OxiKit/oxygen-concentrator-how-to-diy-open-source/README.md

# oxygen-concentrator-how-to-diy-open-source
