OxiKit/oxygen-concentrator-how-to-diy-open-source/Air Compressor WorkFlow.pdf

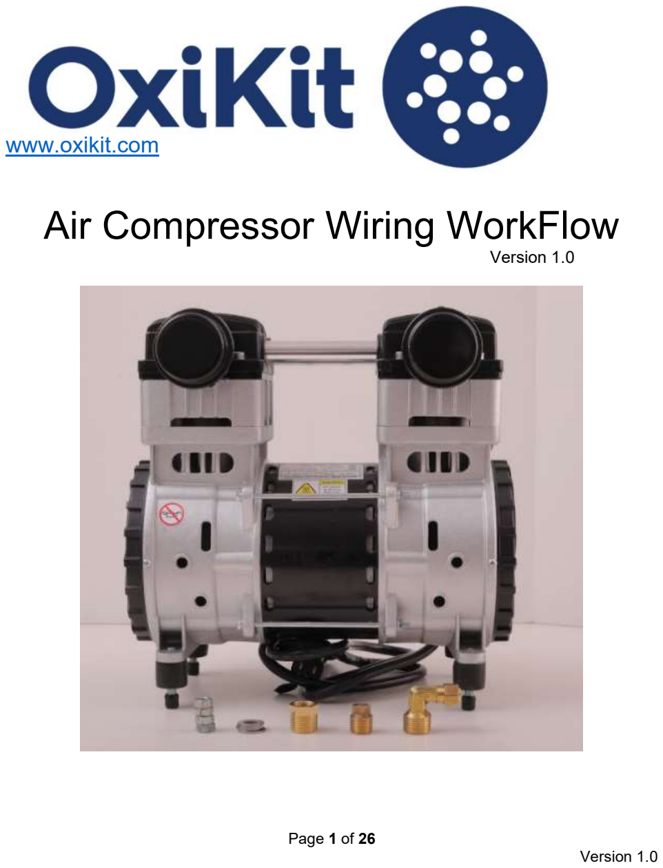
[picture p4: page 1]

### Page 1 of 26 Version 1.0

# www.oxikit.com

# Air Compressor Wiring WorkFlow

### Version 1.0

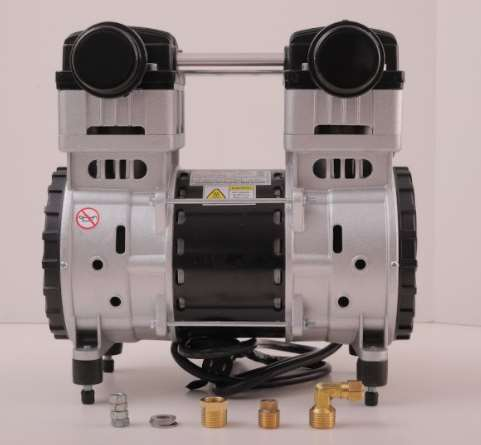
[picture p5: figure]

### Page 2 of 26

Document # | Date Effective

## OXIKIT-AC001

Supersedes Document Version #:

### OXIKIT WORKFLOW

Document Title

## Air Compressor Wiring

### Change History Log:

VERSION # | REVISION DATE | DESCRIPTION OF CHANGE
FROM | TO
1.0 | 11/27/2020 | Original Release

### I. Purpose:

This Workflow is intended to serve as a guide in the wirings of the Air Compressor. This is the main source of air of the Oxikit Assembly.

II. | Scope: This guideline applies to all individuals who wish to build the DIY Oxikit. It includes the Materials, tools and the Video Link needed in wiring the Air Compressor.
III. | Picture:

### Fig. 1.0 Air Compressor

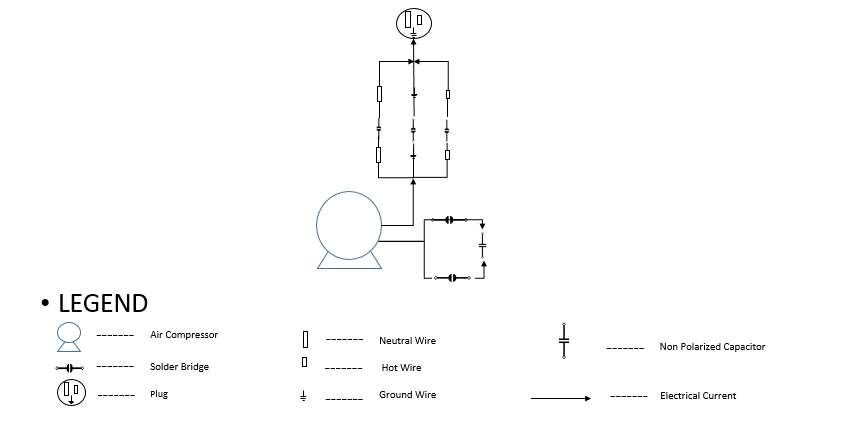
[picture p6: figure]

### Page 3 of 26

Document # | Date Effective

## OXIKIT-AC001

Supersedes Document Version #:

### OXIKIT WORKFLOW

Document Title

## Air Compressor Wiring

### Fig 2.0 Wiring Diagram of the Air Compressor

### IV. Safety Operating Conditions: - Always wear protective gloves and googles

### V. Workflows - Please see next page for the step by step guidelines in wiring the Air

| Compressor

Step | Process | Materiel | Tools Youtube Link

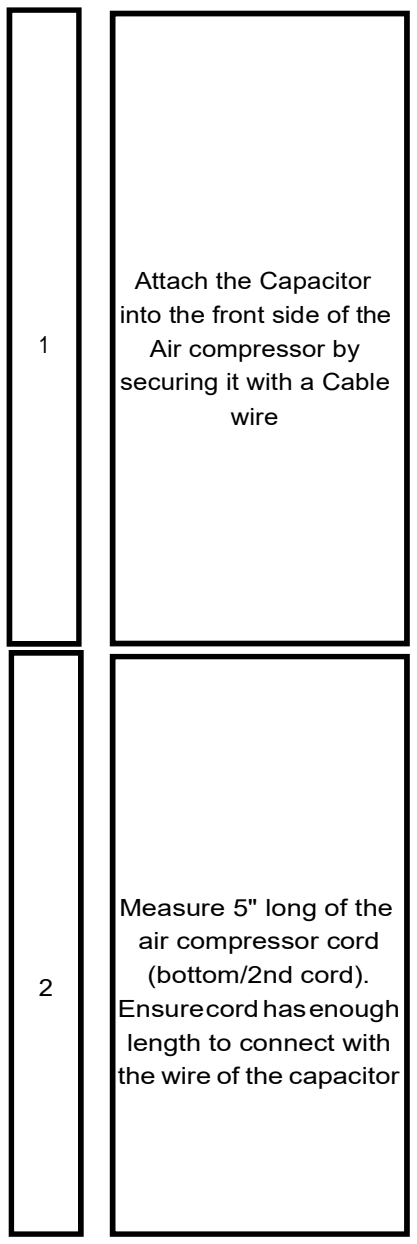
[picture p7: figure]
Attach the Capacitor into the front side of the Air compressor by securing it with a Cable wire; Measure 5" long of the air compressor cord (bottom/2nd cord). Ensure cord has enough length to connect with the wire of the capacitor
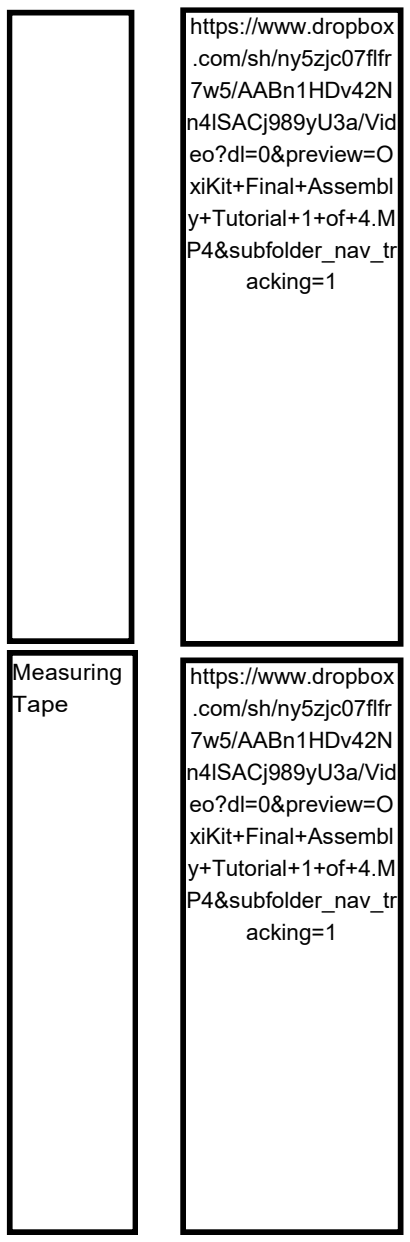
[picture p8: figure]
https://www.dropbox .com/sh/ny5zjc07flfr 7w5/AABn1HDv42N n4lSACj989yU3a/Vid eo?dl=0&preview=O xiKit+Final+Assembl y+Tutorial+1+of+4.M P4&subfolder_nav_tr acking=1; Measuring Tape

Name | Description | Metric
Conversion

Unit of
Measure
Capacitor | California Air Tool SP-9421 model Capacitor (set with California Air Tools Air Compressor) | California Air Tool SP-9421 model Capacitor (set with California Air Tools Air Compressor) | Unit
Air Compressor | California Air Tools SP-9421 2.0HP Ultra Quiet and Oil-Free Air Compressor Motor | California Air Tools SP-9421 2.0HP Ultra Quiet and Oil-Free Air Compressor Motor | Unit
18" Cable Wire | 18" Cable Ties (Sold in 50 Pack) | 450mm x 4mm Cable Ties (Sold in 50 Pack) | Piece
Name | Description | Metric Conversion
Unit of
Measure
Air Compressor | California Air Tools SP-9421 2.0HP Ultra Quiet and Oil-Free Air Compressor Motor | California Air Tools SP-9421 2.0HP Ultra Quiet and Oil-Free Air Compressor Motor

Unit

Steps | Process | Material | Tools | Youtube Link

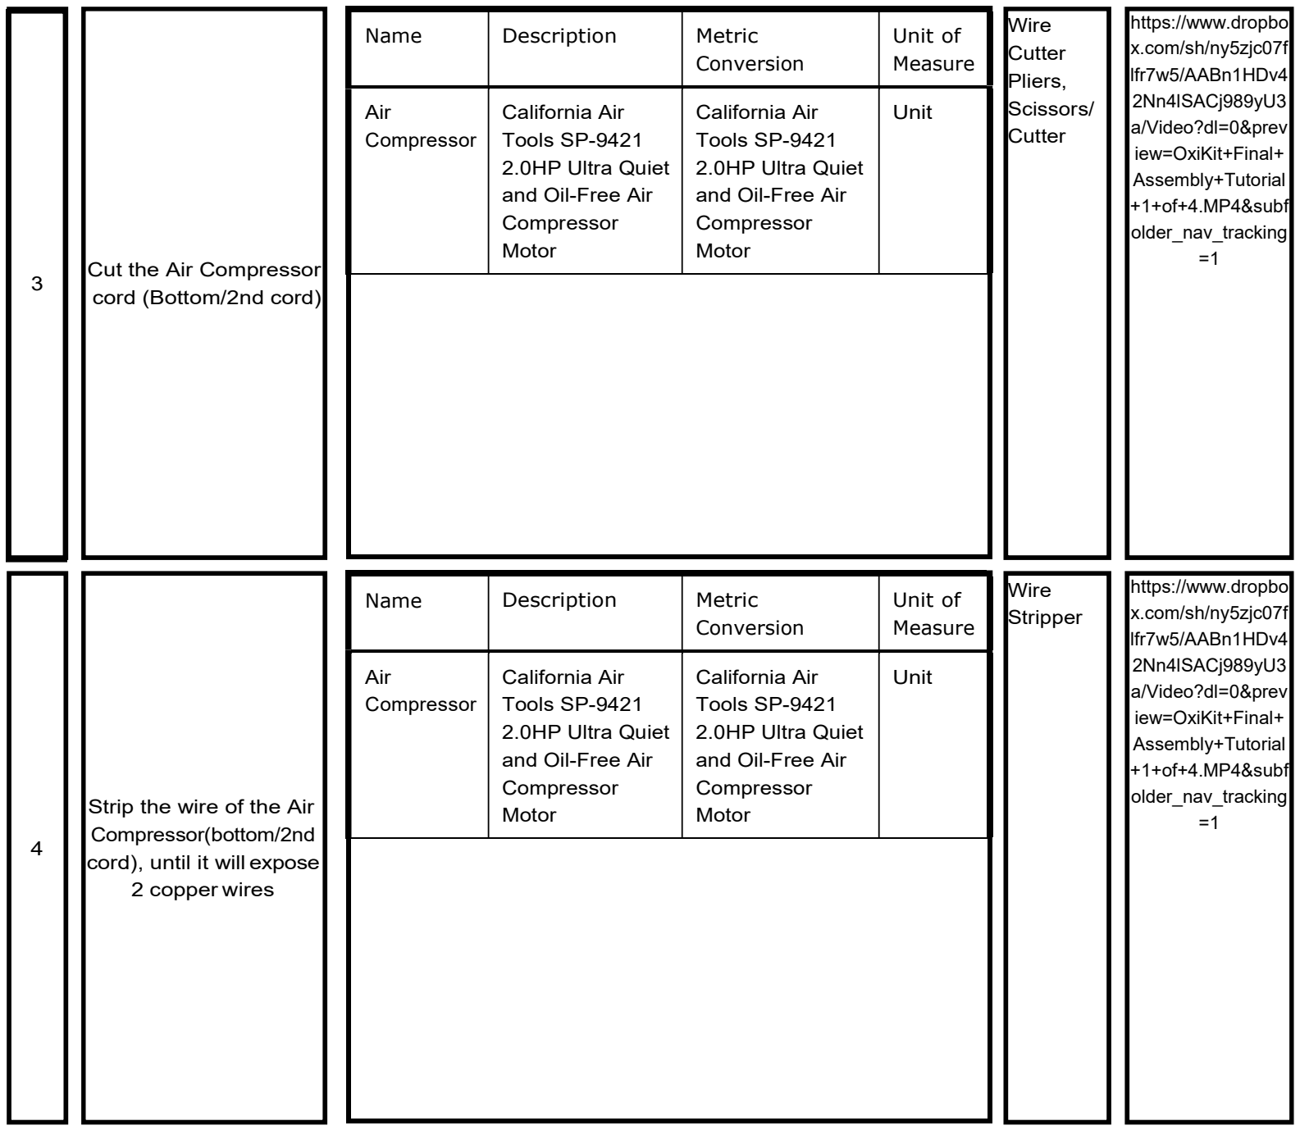
[picture p9: figure]
3 Cut the Air Compressor cord (Bottom/2nd cord); Name; Description; Metric; Conversion; Unit of Measure; Air Compressor; California Air Tools SP-9421 2.0HP Ultra Quiet and Oil-Free Air Compressor Motor; Unit; Wire Cutter Pliers, Scissors/ Cutter; https://www.dropbo x.com/sh/ny5zjc07f lfr7w5/AABn1HDv4 2Nn4lSACj989yU3 a/Video?dl=0&prev iew=OxiKit+Final+ Assembly+Tutorial +1+of+4.MP4&subf older_nav_tracking =1; Strip the wire of the Air Compressor(bottom/2nd cord), until it will expose 2 copper wires; Wire Stripper

### Page 5 of 26

### Page 6 of 26

### 5 Strip the wire from the

Capacitor.

Name | Description | Metric Conversion | Unit of Measure
Capacitor | California Air Tool SP-9421 model Capacitor (set with California Air Tools Air Compressor) | California Air Tool SP-9421 model Capacitor (set with California Air Tools Air Compressor) | Unit

Wire
Stripper

https://www.dropbo
x.com/sh/ny5zjc07f
lfr7w5/AABn1HDv4
2Nn4lSACj989yU3
a/Video?dl=0&prev
iew=OxiKit+Final+
Assembly+Tutorial
+1+of+4.MP4&subf
older_nav_tracking
=1

6

Insert 2 Heat Shrinks
into the Capacitor Wires
and 1 into the air
compressor
cord(bottom/2nd cord)
Name | Description | Metric Conversion
Unit of
Measure
Heat Shrinks Tube | Heat Shrink Tube Assortment Wrap Electrical Insulation Cable | Heat Shrink Tube Assortment Wrap Electrical Insulation Cable
Capacitor | California Air Tool SP-9421 model Capacitor (set with California Air Tools Air Compressor) | California Air Tool SP-9421 model Capacitor (set with California Air Tools Air Compressor)
Air Compressor | California Air Tools SP-9421 2.0HP Ultra Quiet and Oil-Free Air Compressor | California Air Tools SP-9421 2.0HP Ultra Quiet and Oil-Free Air Compressor

Set

Unit

Unit

https://www.dropbo
x.com/sh/ny5zjc07f
lfr7w5/AABn1HDv4
2Nn4lSACj989yU3
a/Video?dl=0&prev
iew=OxiKit+Final+
Assembly+Tutorial
+1+of+4.MP4&subf
older_nav_tracking
=1

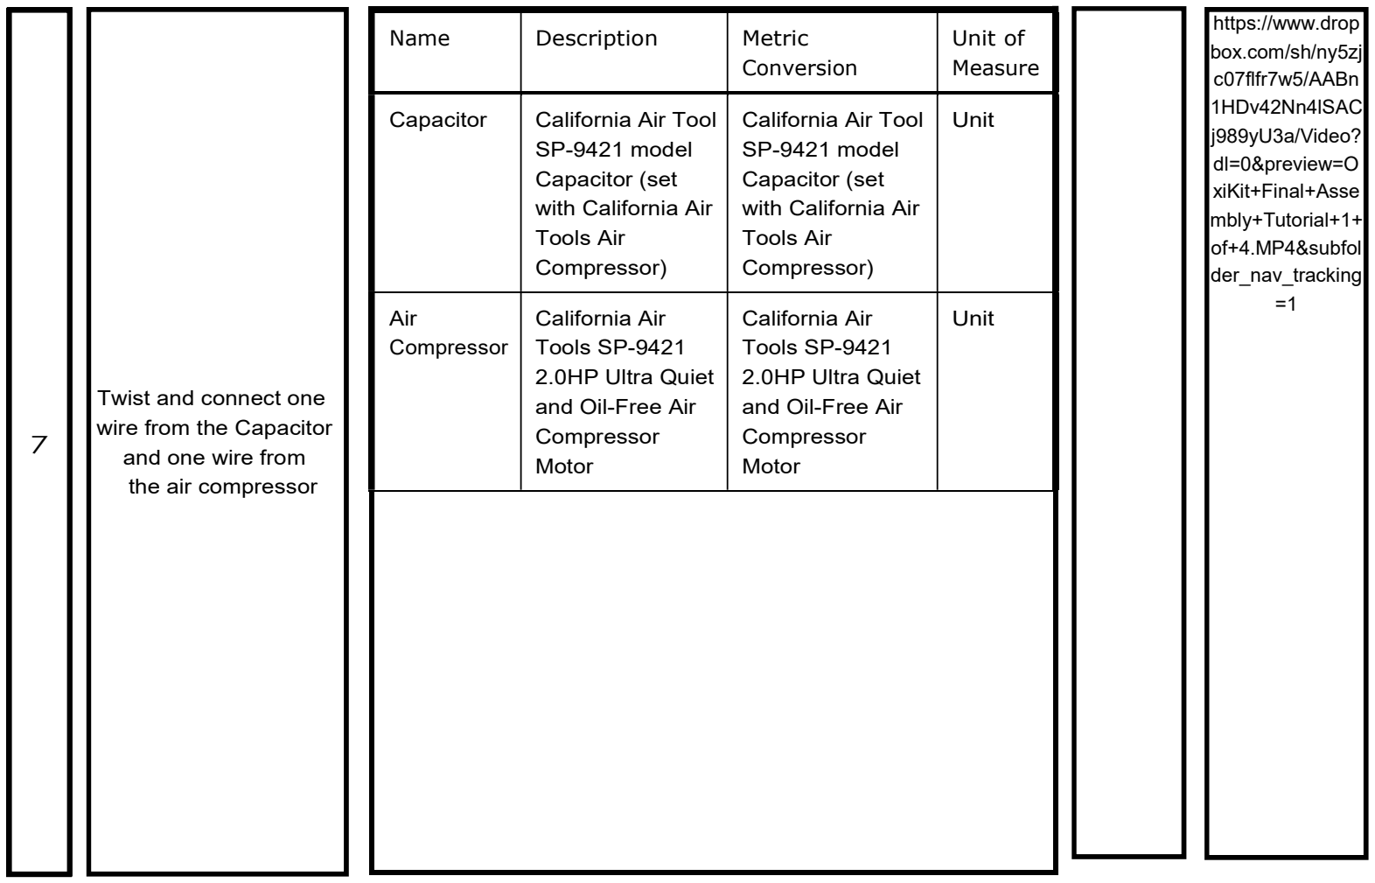
[picture p10: figure]
Twist and connect one wire from the Capacitor and one wire from the air compressor; Name; Description; Metric; Conversion; Unit of Measure; Unit; https://www.drop box.com/sh/ny5zj c07flfr7w5/AABn 1HDv42Nn4lSAC j989yU3a/Video? dl=0&preview=O xiKit+Final+Asse mbly+Tutorial+1+ of+4.MP4&subfol der_nav_tracking =1

### Page 7 of 26

Capacitor | California Air Tool SP-9421 model Capacitor (set with California Air Tools Air Compressor) | California Air Tool SP-9421 model Capacitor (set with California Air Tools Air Compressor)
Air Compressor | California Air Tools SP-9421 2.0HP Ultra Quiet and Oil-Free Air Compressor Motor | California Air Tools SP-9421 2.0HP Ultra Quiet and Oil-Free Air Compressor Motor

### Page 8 of 26

8

Solder the connected
wires or place Twist
Wire Connector
Name | Description | Metric Conversion
Unit of
Measure

Soldering Wire

Twist Wire Connector | Twist Wire Connector | Twist Wire Connector
Capacitor | California Air Tool SP-9421 model Capacitor (set with California Air Tools Air Compressor) | California Air Tool SP-9421 model Capacitor (set with California Air Tools Air Compressor)
Air Compressor | California Air Tools SP-9421 2.0HP Ultra Quiet and Oil-Free Air Compressor Motor | California Air Tools SP-9421 2.0HP Ultra Quiet and Oil-Free Air Compressor Motor
Electrical Tape | Heat Shrink or Electrical Tape | Heat Shrink or Electrical Tape
Soldering wire | Soldering wire | meter
| | Piece
| | Unit

Unit

roll

Soldering
Iron

https://www.drop
box.com/sh/ny5zj
c07flfr7w5/AABn
1HDv42Nn4lSAC
j989yU3a/Video?
dl=0&preview=O
xiKit+Final+Asse
mbly+Tutorial+1+
of+4.MP4&subfol
der_nav_tracking
=1

### Page 9 of 26

9

Twist and connect 2nd
wire from the
Capacitor and 2nd
wire from the air
compressor
Name | Description | Metric Conversion
Unit of
Measure

Soldering Wire

Twist Wire Connector | Twist Wire Connector | Twist Wire Connector
Capacitor | California Air Tool SP-9421 model Capacitor (set with California Air Tools Air Compressor) | California Air Tool SP-9421 model Capacitor (set with California Air Tools Air Compressor)
Air Compressor | California Air Tools SP-9421 2.0HP Ultra Quiet and Oil-Free Air Compressor Motor | California Air Tools SP-9421 2.0HP Ultra Quiet and Oil-Free Air Compressor Motor
Electrical Tape | Heat Shrink or Electrical Tape | Heat Shrink or Electrical Tape
Soldering wire | Soldering wire | meter
| | Piece
| | Unit

Unit

roll

Soldering
Iron

https://www.drop
box.com/sh/ny5zj
c07flfr7w5/AABn
1HDv42Nn4lSAC
j989yU3a/Video?
dl=0&preview=O
xiKit+Final+Asse
mbly+Tutorial+1+
of+4.MP4&subfol
der_nav_tracking
=1

### Page 10 of 26

10

Solder the connected
wires or place Twist
Wire Connector
Name | Description | Metric Conversion
Unit of
Measure
Twist Wire Connector | Twist Wire Connector | Twist Wire Connector
Capacitor | California Air Tool SP-9421 model Capacitor (set with California Air Tools Air Compressor) | California Air Tool SP-9421 model Capacitor (set with California Air Tools Air Compressor)
Air Compressor | California Air Tools SP-9421 2.0HP Ultra Quiet and Oil-Free Air Compressor Motor | California Air Tools SP-9421 2.0HP Ultra Quiet and Oil-Free Air Compressor Motor
Electrical Tape | Heat Shrink or Electrical Tape | Heat Shrink or Electrical Tape
Heat Shrinks Tube | Heat Shrink Tube Assortment Wrap Electrical Insulation Cable | Heat Shrink Tube Assortment Wrap Electrical Insulation Cable

Piece

Unit

Unit

roll

Set

Soldering
Iron

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

### Page 11 of 26

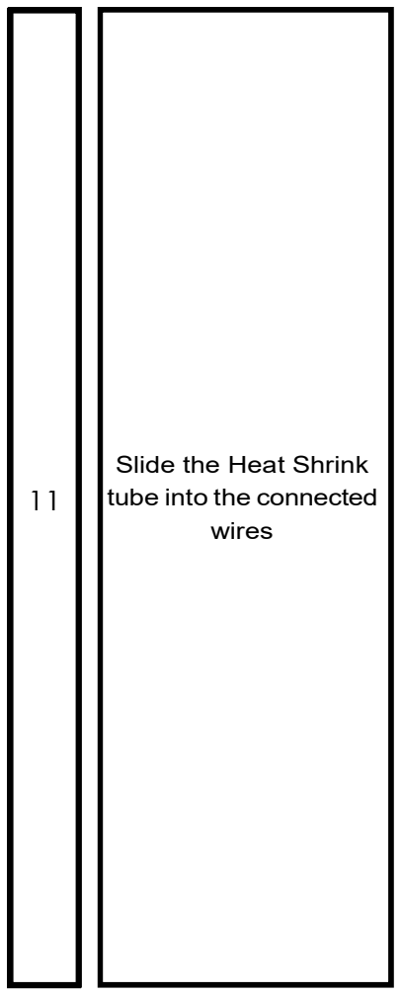
[picture p11: figure]
Slide the Heat Shrink tube into the connected wires

Name | Description | Metric
Conversion

Unit of
Measure

Soldering
Wire
Soldering wire | Soldering wire | meter

Twist Wire
Connector

Twist Wire
Connector

Twist Wire
Connector

Piece

Capacitor California Air Tool SP-9421 model
Capacitor (set
with California Air
Tools Air
Compressor)

California Air Tool
SP-9421 model
Capacitor (set
with California Air
Tools Air
Compressor)

Unit

Air
Compressor

California Air
Tools SP-9421
2.0HP Ultra Quiet
and Oil-Free Air
Compressor
Motor

California Air
Tools SP-9421
2.0HP Ultra Quiet
and Oil-Free Air
Compressor
Motor

Unit

Electrical
Tape

Heat Shrink or
Electrical Tape

Heat Shrink or
Electrical Tape

roll

Heat
Shrinks
Tube

Heat Shrink Tube
Assortment Wrap
Electrical
Insulation Cable

Heat Shrink Tube
Assortment Wrap
Electrical
Insulation Cable

Set

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

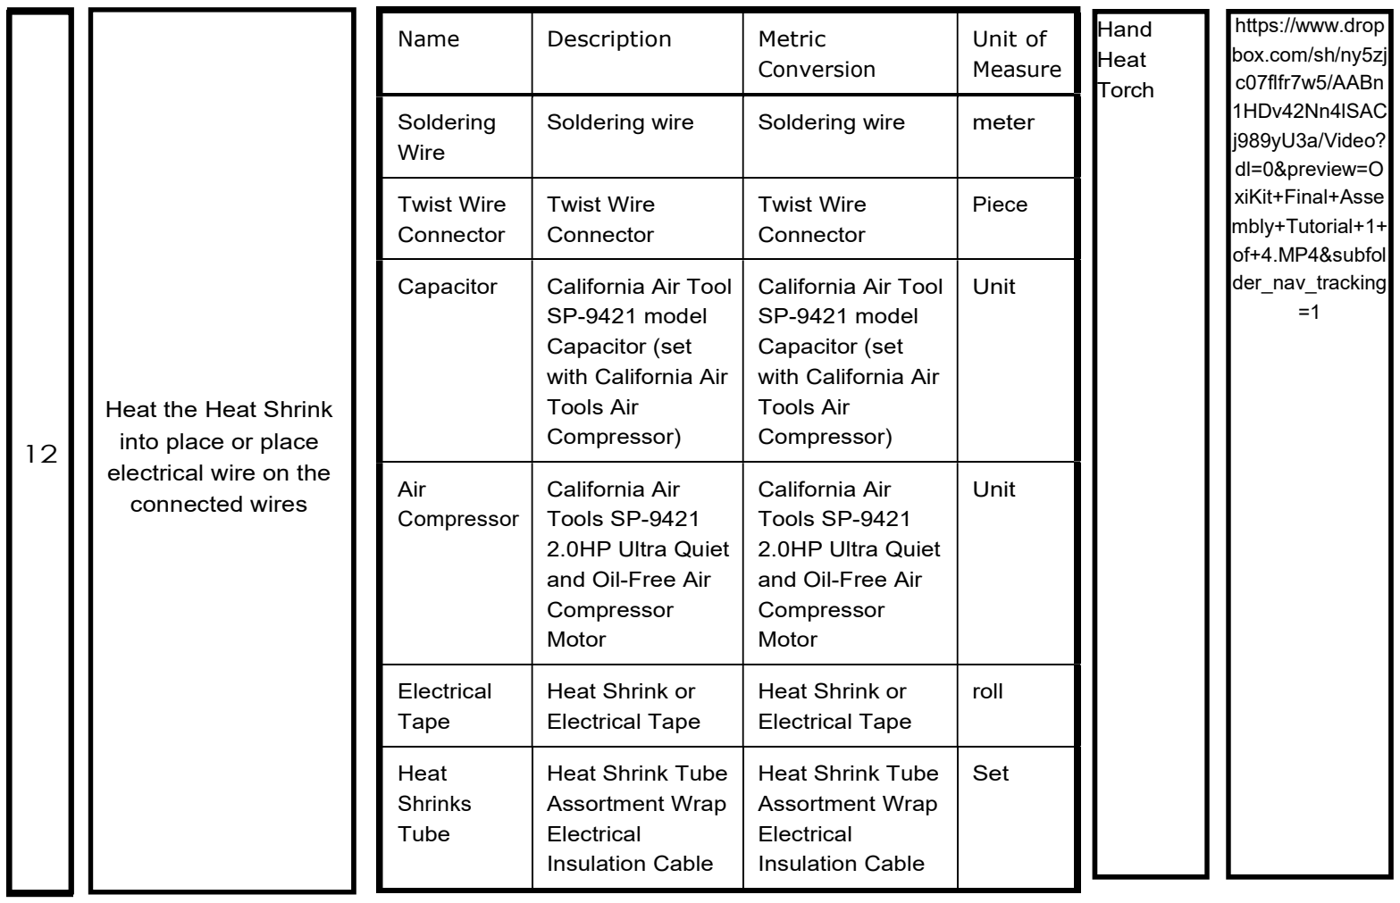
[picture p12: figure]
Heat the Heat Shrink into place or place electrical wire on the connected wires; Name; Description; Metric; Conversion; Unit of Measure; Soldering Wire; Soldering wire; meter; Twist Wire Connector; Piece; Capacitor; California Air Tool; SP-9421 model Capacitor (set with California Air Tools Air Compressor); California Air Tool SP-9421 model Capacitor (set with California Air Tools Air Compressor); Unit; Air Compressor; California Air Tools SP-9421 2.0HP Ultra Quiet and Oil-Free Air Compressor Motor; Electrical Tape; Heat Shrink or Electrical Tape; roll; Heat Shrinks Tube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

### Page 12 of 26

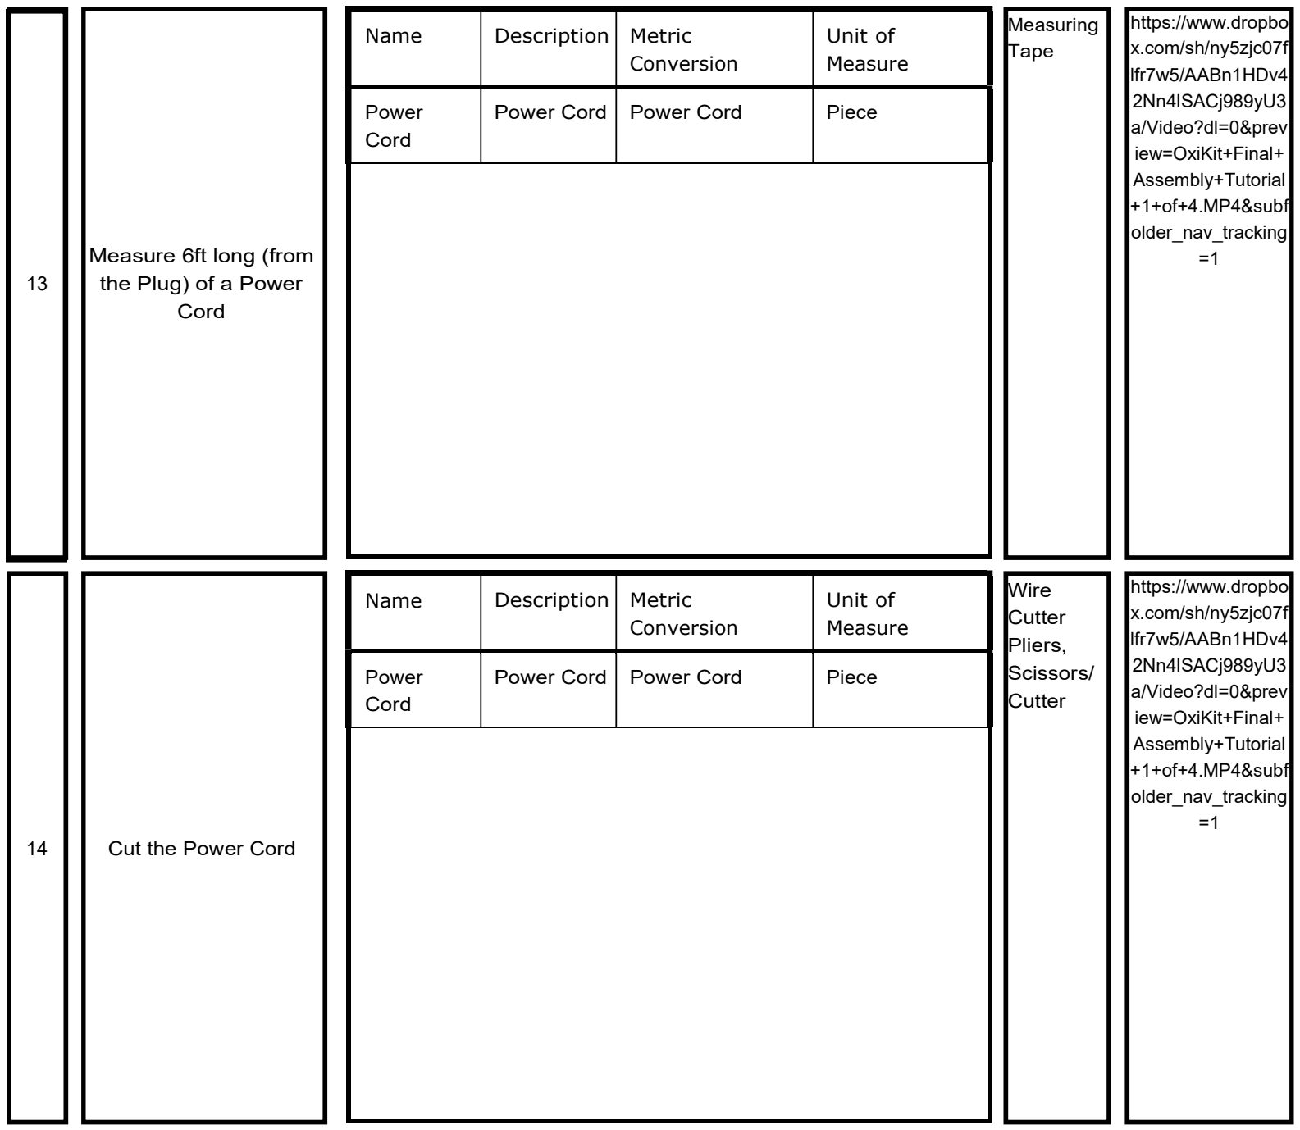
[picture p13: figure]
Measure 6ft long (from the Plug) of a Power Cord; Name; Description; Metric; Conversion; Unit of Measure; Power Cord; Piece; Measuring Tape; https://www.dropbo x.com/sh/ny5zjc07f lfr7w5/AABn1HDv4 2Nn4lSACj989yU3 a/Video?dl=0&prev iew=OxiKit+Final+ Assembly+Tutorial +1+of+4.MP4&subf older_nav_tracking =1; 14 Cut the Power Cord; Wire Cutter Pliers, Scissors/ Cutter

### Page 13 of 26

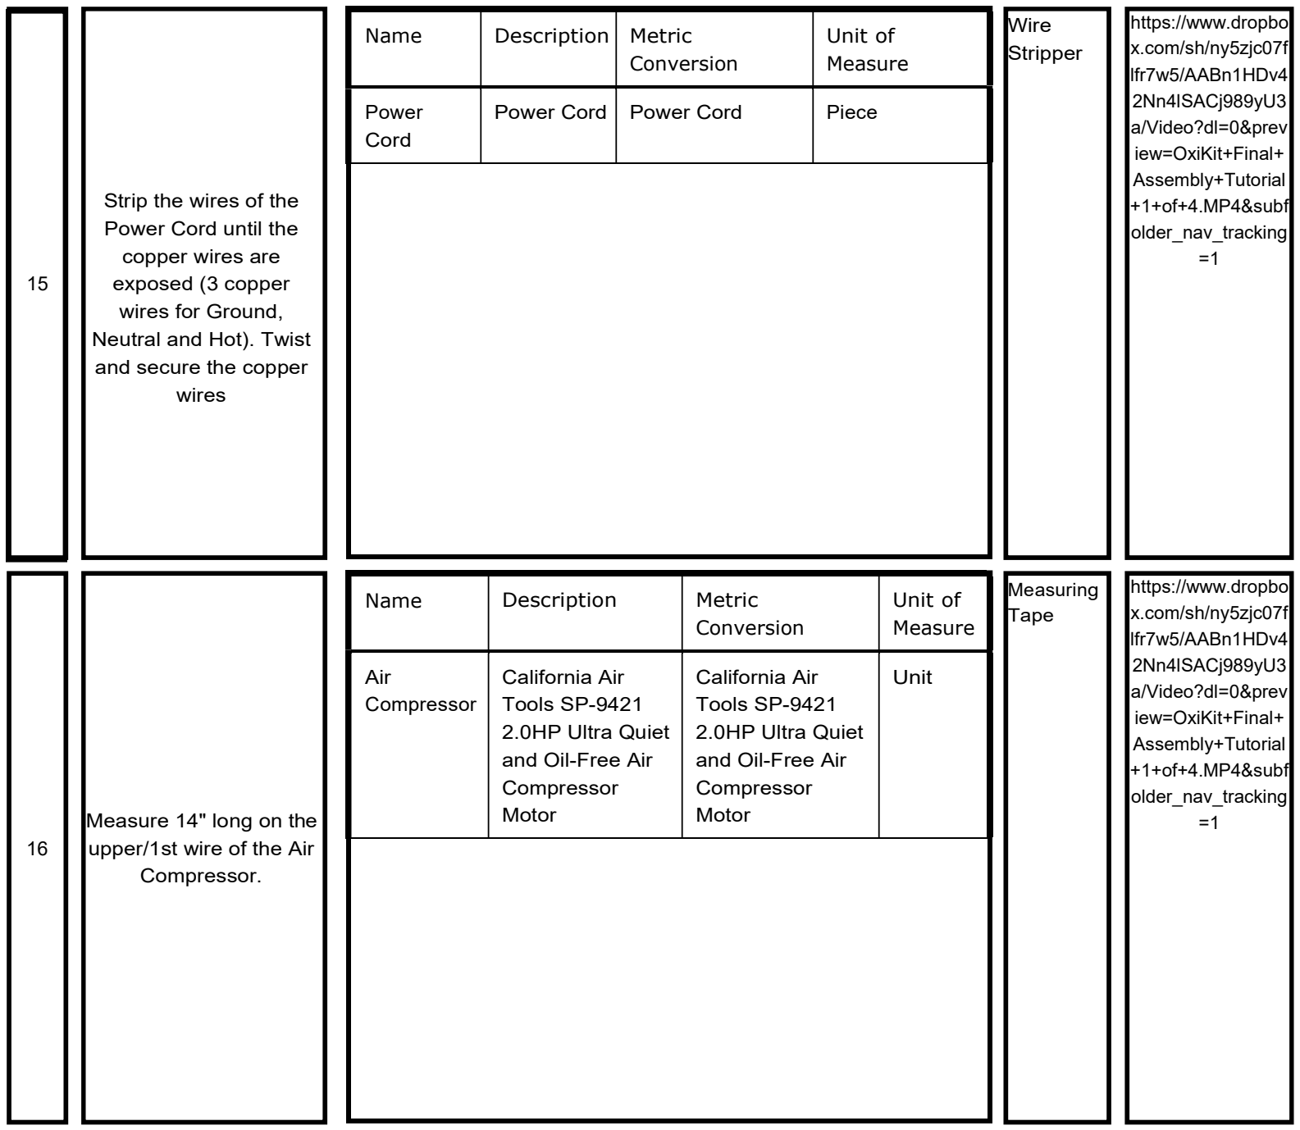
[picture p14: figure]
Strip the wires of the Power Cord until the copper wires are exposed (3 copper wires for Ground, Neutral and Hot). Twist and secure the copper wires; Name; Description; Metric; Conversion; Unit of Measure; Power Cord; Piece; Wire Stripper; https://www.dropbo x.com/sh/ny5zjc07f lfr7w5/AABn1HDv4 2Nn4lSACj989yU3 a/Video?dl=0&prev iew=OxiKit+Final+ Assembly+Tutorial +1+of+4.MP4&subf older_nav_tracking =1; Measure 14" long on the upper/1st wire of the Air Compressor.; Air Compressor; California Air Tools SP-9421 2.0HP Ultra Quiet and Oil-Free Air Compressor Motor; Unit; Measuring Tape

### Page 14 of 26

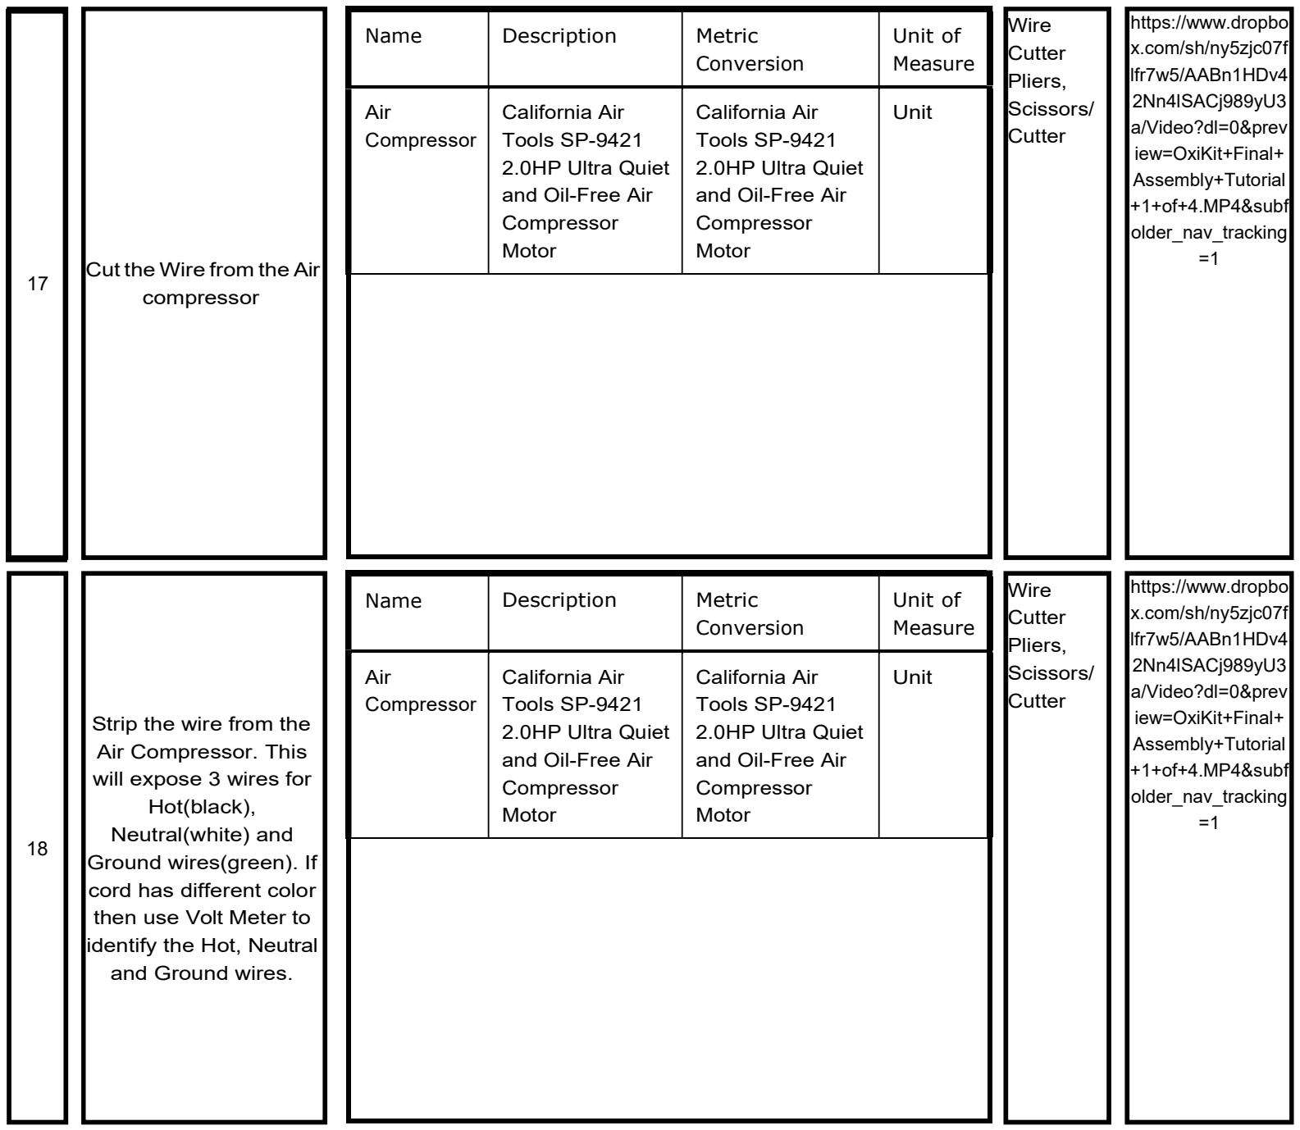
[picture p15: figure]
17 Cut the Wire from the Air compressor; Name; Description; Metric; Conversion; Unit of Measure; Air Compressor; California Air Tools SP-9421 2.0HP Ultra Quiet and Oil-Free Air Compressor Motor; Unit; Wire Cutter Pliers, Scissors/ Cutter; https://www.dropbo x.com/sh/ny5zjc07f lfr7w5/AABn1HDv4 2Nn4lSACj989yU3 a/Video?dl=0&prev iew=OxiKit+Final+ Assembly+Tutorial +1+of+4.MP4&subf older_nav_tracking =1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

### Page 15 of 26

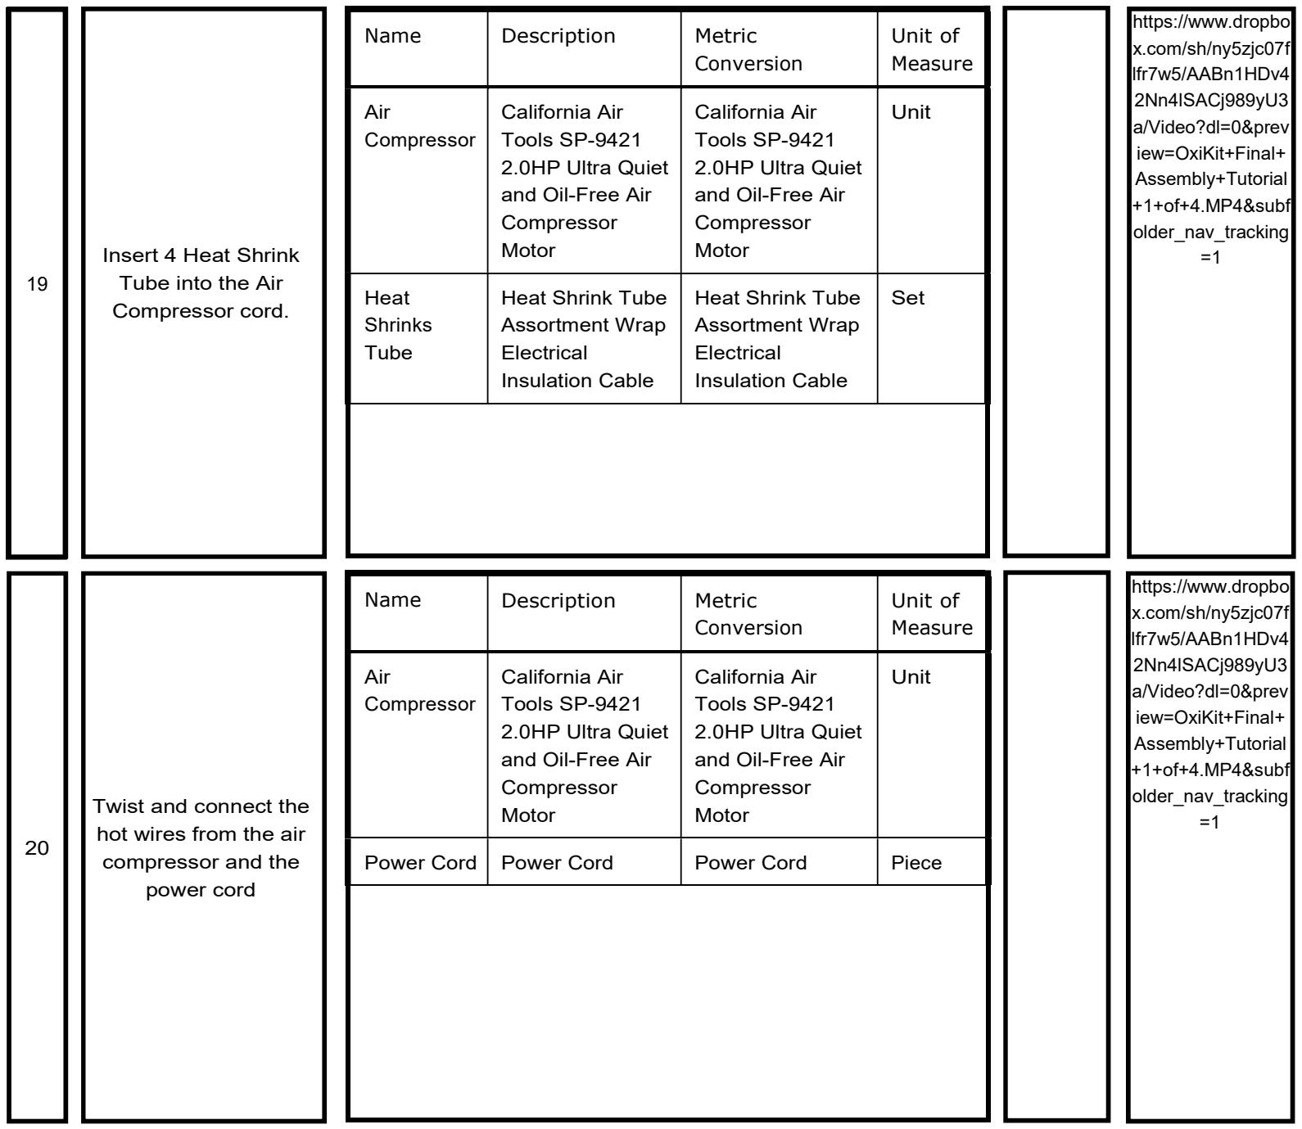
[picture p16: figure]
Insert 4 Heat Shrink Tube into the Air Compressor cord.; Name; Description; Metric; Conversion; Unit of Measure; Unit; Set; https://www.dropbo x.com/sh/ny5zjc07f lfr7w5/AABn1HDv4 2Nn4lSACj989yU3 a/Video?dl=0&prev iew=OxiKit+Final+ Assembly+Tutorial +1+of+4.MP4&subf older_nav_tracking =1; Twist and connect the hot wires from the air compressor and the power cord; Air Compressor; California Air Tools SP-9421 2.0HP Ultra Quiet and Oil-Free Air Compressor Motor; Power Cord; Piece

### Page 16 of 26

Air Compressor | California Air Tools SP-9421 2.0HP Ultra Quiet and Oil-Free Air Compressor Motor | California Air Tools SP-9421 2.0HP Ultra Quiet and Oil-Free Air Compressor Motor
Heat Shrinks Tube | Heat Shrink Tube Assortment Wrap Electrical Insulation Cable | Heat Shrink Tube Assortment Wrap Electrical Insulation Cable

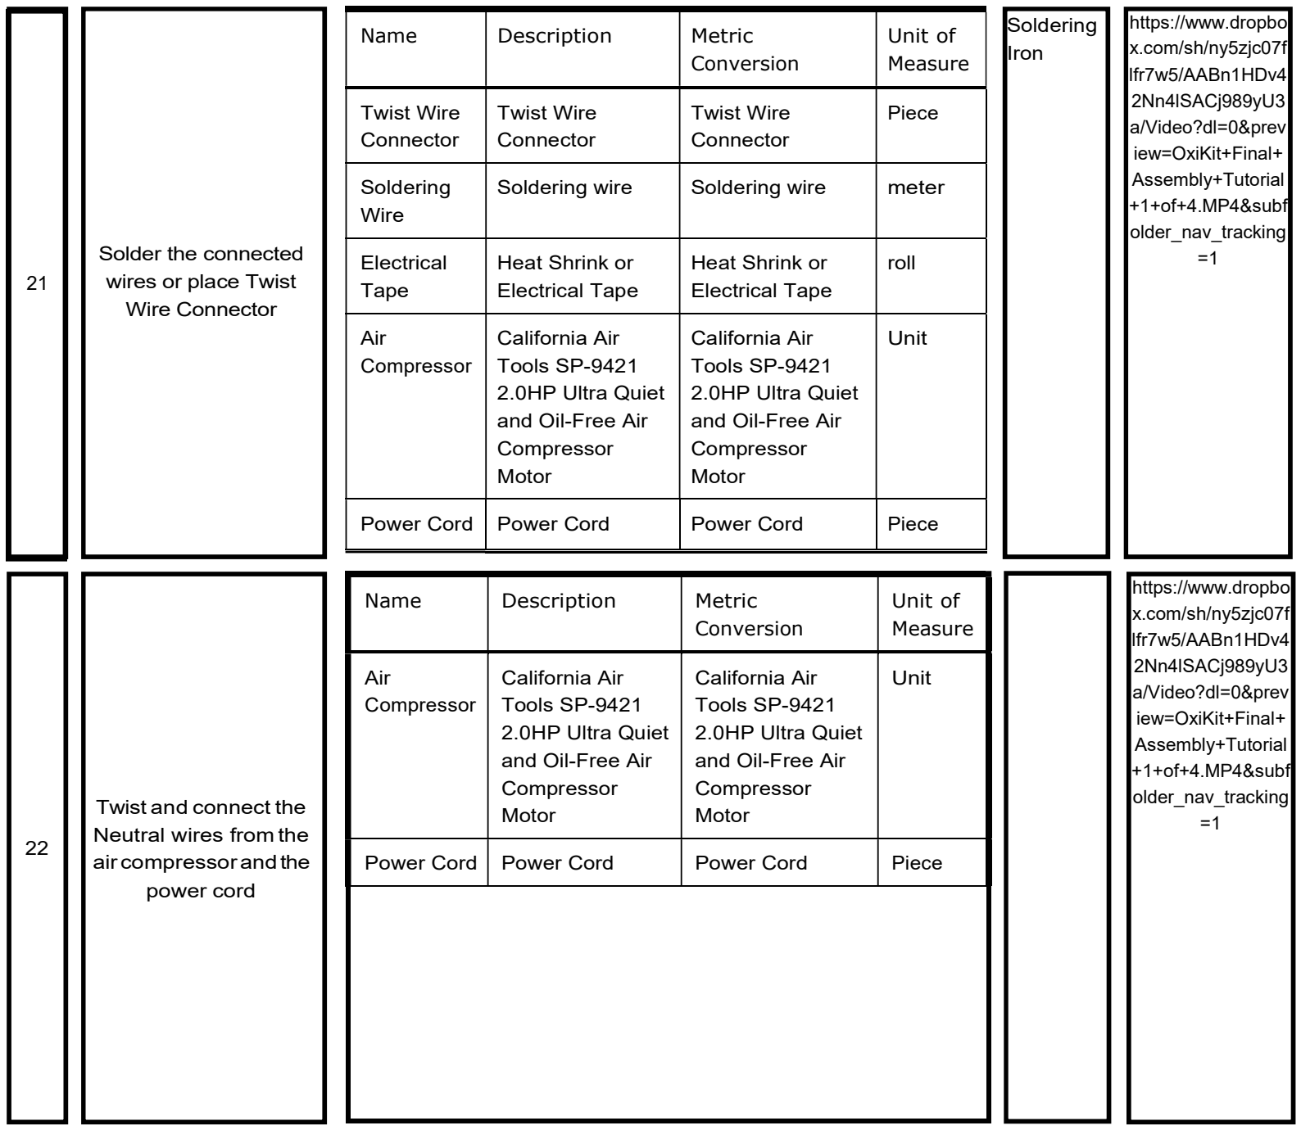
[picture p17: figure]
Solder the connected wires or place Twist Wire Connector; Name; Description; Metric; Conversion; Unit of Measure; Twist Wire Connector; Piece; Soldering Wire; Soldering wire; meter; Electrical Tape; Heat Shrink or Electrical Tape; roll; Power Cord; Soldering Iron; https://www.dropbo x.com/sh/ny5zjc07f lfr7w5/AABn1HDv4 2Nn4lSACj989yU3 a/Video?dl=0&prev iew=OxiKit+Final+ Assembly+Tutorial +1+of+4.MP4&subf older_nav_tracking =1; Twist and connect the Neutral wires from the air compressor and the power cord; Air Compressor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

### Page 17 of 26

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

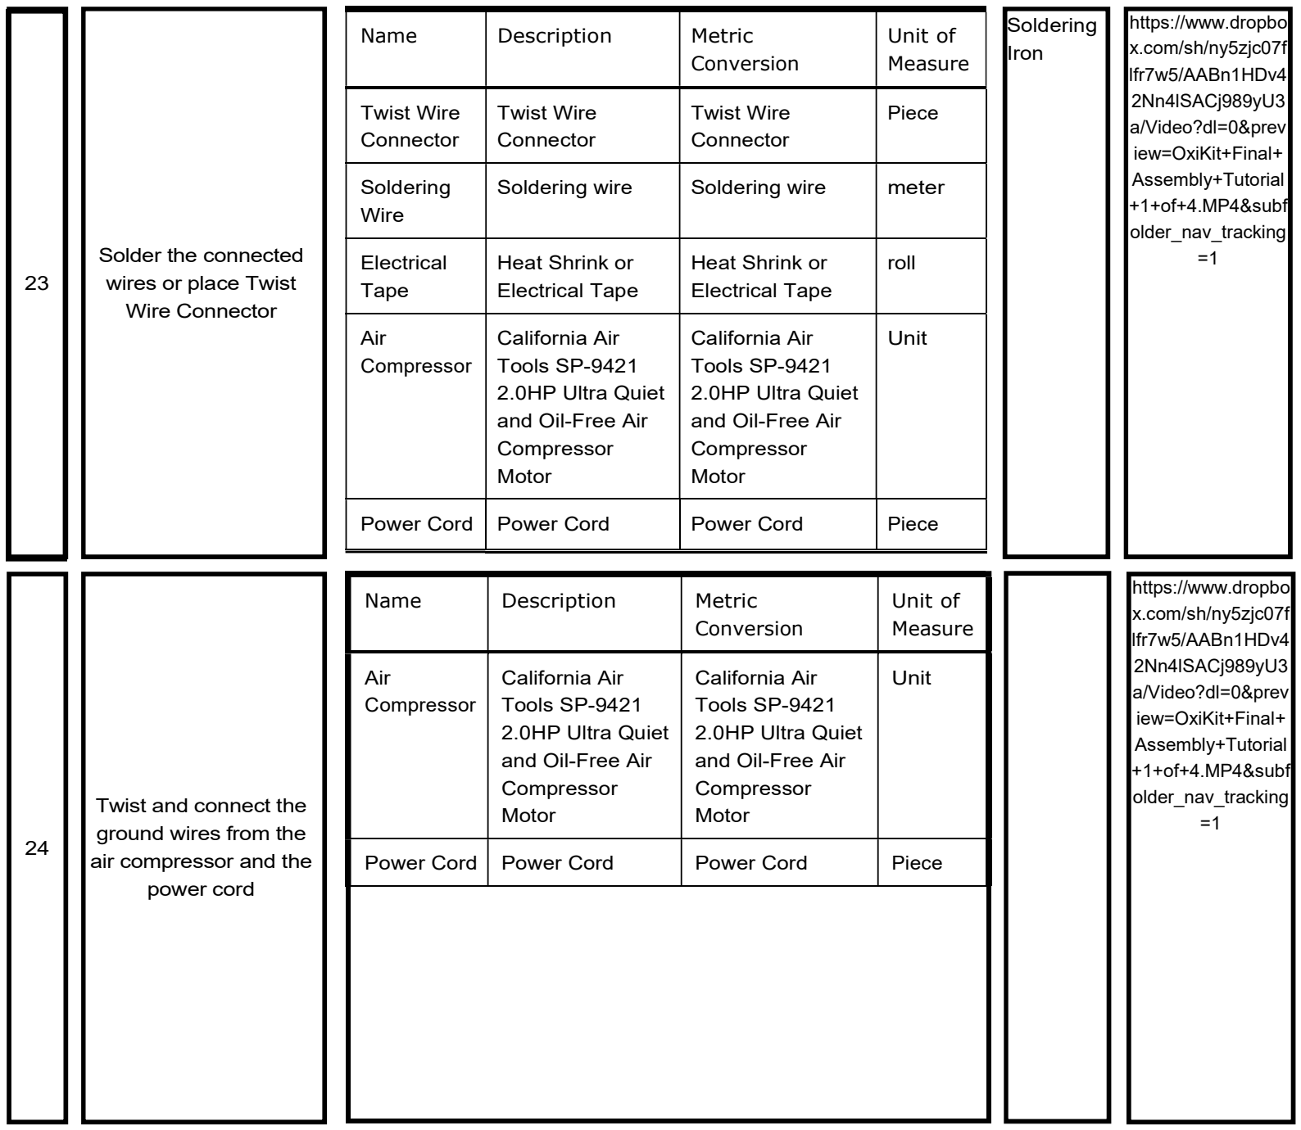
[picture p18: figure]
Solder the connected wires or place Twist Wire Connector; Name; Description; Metric; Conversion; Unit of Measure; Twist Wire Connector; Piece; Soldering Wire; Soldering wire; meter; Electrical Tape; Heat Shrink or Electrical Tape; roll; Power Cord; Soldering Iron; https://www.dropbo x.com/sh/ny5zjc07f lfr7w5/AABn1HDv4 2Nn4lSACj989yU3 a/Video?dl=0&prev iew=OxiKit+Final+ Assembly+Tutorial +1+of+4.MP4&subf older_nav_tracking =1; Twist and connect the ground wires from the air compressor and the power cord; Air Compressor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

### Page 18 of 26

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

### Page 19 of 26

25

Solder the connected
wires or place Twist
Wire Connector
Name | Description | Metric Conversion
Unit of
Measure
Twist Wire Connector | Twist Wire Connector | Twist Wire Connector | Piece
Soldering Wire | Soldering wire | Soldering wire | meter
Electrical Tape | Heat Shrink or Electrical Tape | Heat Shrink or Electrical Tape | roll
Air Compressor | California Air Tools SP-9421 2.0HP Ultra Quiet and Oil-Free Air Compressor Motor | California Air Tools SP-9421 2.0HP Ultra Quiet and Oil-Free Air Compressor Motor | Unit
Power Cord | Power Cord | Power Cord | Piece

Soldering
Iron

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

26

Slide the Heat Shrink
tube into the connected
wires
Name | Description | Metric Conversion
Unit of
Measure
Heat Shrinks Tube | Heat Shrink Tube Assortment Wrap Electrical Insulation Cable | Heat Shrink Tube Assortment Wrap Electrical Insulation Cable
Air Compressor | California Air Tools SP-9421 2.0HP Ultra Quiet and Oil-Free Air Compressor Motor | California Air Tools SP-9421 2.0HP Ultra Quiet and Oil-Free Air Compressor Motor

Set

Unit

Power Cord | Power Cord | Power Cord | Piece

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

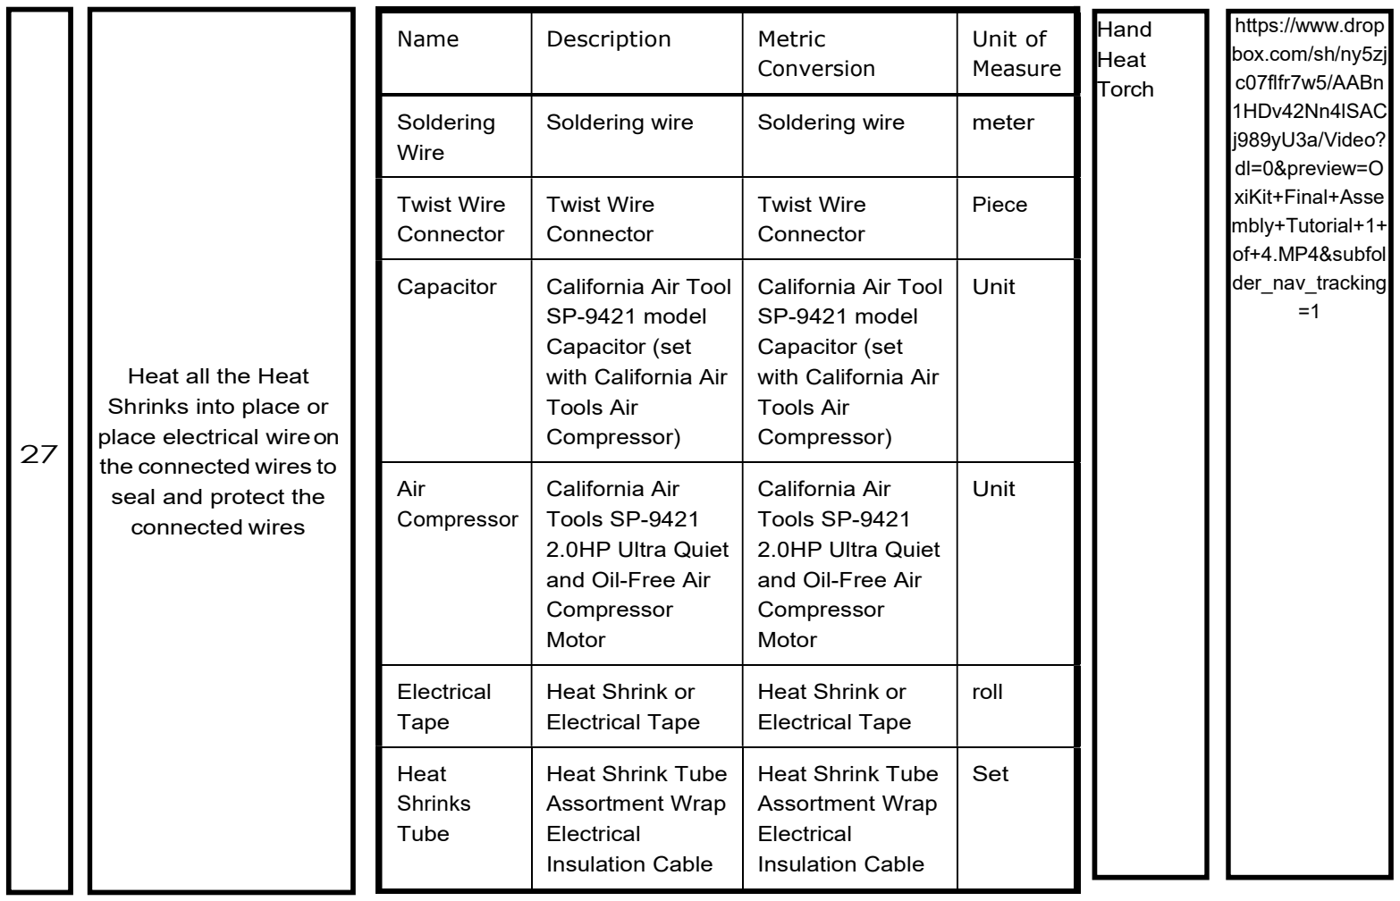
[picture p19: figure]
Heat all the Heat Shrinks into place or place electrical wire on the connected wires to seal and protect the connected wires; Name; Description; Metric; Conversion; Unit of Measure; Soldering Wire; Soldering wire; meter; Twist Wire Connector; Piece; Capacitor; California Air Tool; SP-9421 model Capacitor (set with California Air Tools Air Compressor); California Air Tool SP-9421 model Capacitor (set with California Air Tools Air Compressor); Unit; Air Compressor; California Air Tools SP-9421 2.0HP Ultra Quiet and Oil-Free Air Compressor Motor; Electrical Tape; Heat Shrink or Electrical Tape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

### Page 20 of 26

### Page 21 of 26

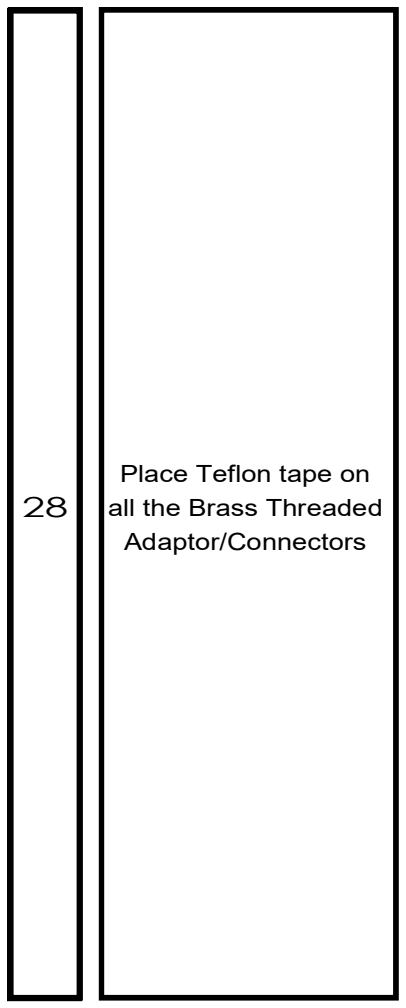
[picture p20: figure]
Place Teflon tape on all the Brass Threaded Adaptor/Connectors

Name | Description | Metric Conversion | Unit of Measure
Teflon Tape | Teflon Tape | Teflon Tape | Roll
Brass Male NPT Compression Connector | Brass 3/8-Inch OD x 1/4-Inch Male NPT Compression -Coupler (Sold in 5 Pack) | Brass 10mm OD x 6mm Male NPT Compression -Coupler (Sold in 5 Pack)
Brass Threaded Male to Female-Adapter Bushing | Brass 1/2-in NPT Male to 1/4" NPT Female - Adapter Bushing | Brass13mm NPT Male to 6mm NPT Female -Adapter Bushing
Brass Threaded Female -Elbow | Brass 1/4 Male NPT to 1/4" Female NPT - 90 Elbow | Brass 6mm Male NPT to 6mm Female NPT - 90 Elbow

Piece

Piece

Piece

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

### Page 22 of 26

29

Connect the Brass
Threaded Adaptor into
the Brass Threaded
Elbow Connector
Name | Description | Metric Conversion
Unit of
Measure
Brass Threaded Male to Female-Adapter Bushing | Brass 1/2-in NPT Male to 1/4" NPT Female - Adapter Bushing | Brass13mm NPT Male to 6mm NPT Female -Adapter Bushing
Brass Threaded Female -Elbow | Brass 1/4 Male NPT to 1/4" Female NPT - 90 Elbow | Brass 6mm Male NPT to 6mm Female NPT - 90 Elbow

Piece

Piece

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

30

Connect the Brass
Threaded Elbow
Fittings into the left
output side of the Air
compressor
Name | Description | Metric Conversion
Unit of
Measure
Brass Threaded Male to Female-Adapter Bushing | Brass 1/2-in NPT Male to 1/4" NPT Female - Adapter Bushing | Brass13mm NPT Male to 6mm NPT Female - Adapter Bushing
Brass Threaded Female -Elbow | Brass 1/4 Male NPT to 1/4" Female NPT - 90 Elbow | Brass 6mm Male NPT to 6mm Female NPT - 90 Elbow
Air Compressor | California Air Tools SP-9421 2.0HP Ultra Quiet and Oil-Free Air Compressor | California Air Tools SP-9421 2.0HP Ultra Quiet and Oil-Free Air Compressor

Piece

Piece

Unit

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

### Page 23 of 26

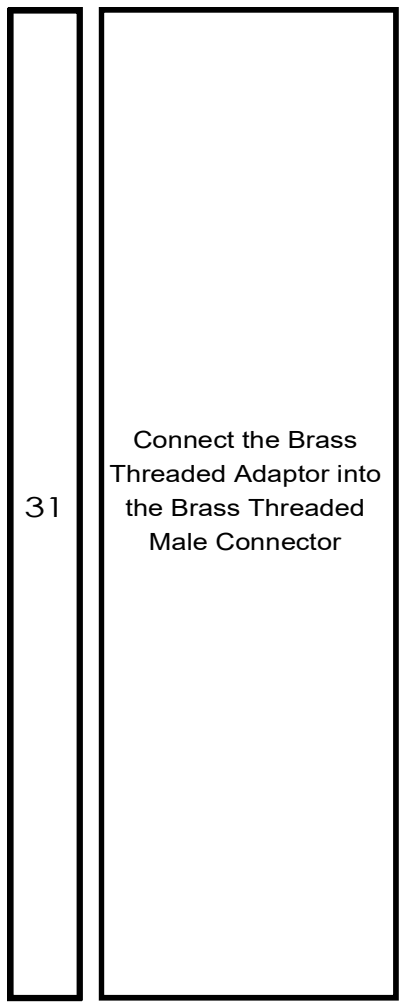
[picture p21: figure]
Connect the Brass Threaded Adaptor into the Brass Threaded Male Connector

Name | Description | Metric Conversion | Unit of Measure
Teflon Tape | Teflon Tape | Teflon Tape | Roll
Brass Threaded Male to Female-Adapter Bushing | Brass 1/2-in NPT Male to 1/4" NPT Female - Adapter Bushing | Brass13mm NPT Male to 6mm NPT Female -Adapter Bushing
Brass Male NPT Compression Connector | Brass 3/8-Inch OD x 1/4-Inch Male NPT Compression -Coupler (Sold in 5 Pack) | Brass 10mm OD x 6mm Male NPT Compression -Coupler (Sold in 5 Pack)

Piece

Piece

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

### Page 24 of 26

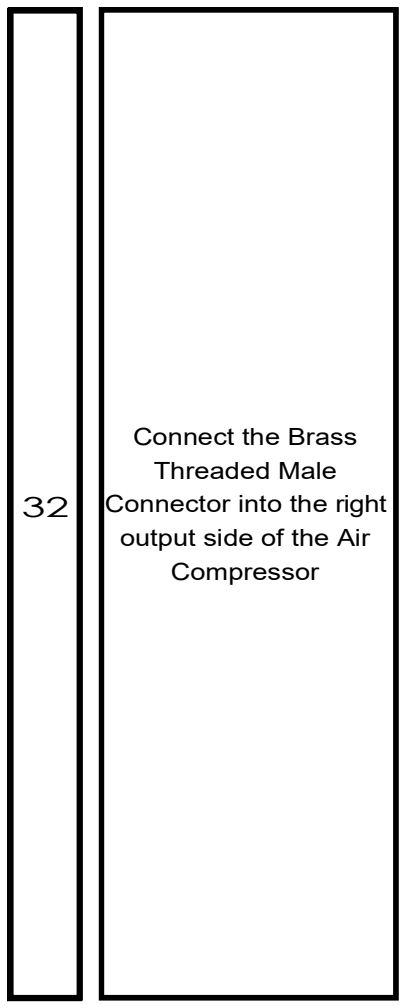
[picture p22: figure]
Connect the Brass Threaded Male Connector into the right output side of the Air Compressor

Name | Description | Metric Conversion | Unit of Measure
Teflon Tape | Teflon Tape | Teflon Tape | Roll
Brass Threaded Male to Female-Adapter Bushing | Brass 1/2-in NPT Male to 1/4" NPT Female - Adapter Bushing | Brass13mm NPT Male to 6mm NPT Female - Adapter Bushing
Brass Male NPT Compression Connector | Brass 3/8-Inch OD x 1/4-Inch Male NPT Compression -Coupler (Sold in 5 Pack) | Brass 10mm OD x 6mm Male NPT Compression -Coupler (Sold in 5 Pack)
Air Compressor | California Air Tools SP-9421 2.0HP Ultra Quiet and Oil-Free Air Compressor Motor | California Air Tools SP-9421 2.0HP Ultra Quiet and Oil-Free Air Compressor Motor

Piece

Piece

Unit

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

### Page 25 of 26

33

Tighten the Brass
Threaded
Adaptor/Connectors
into place.
Name | Description | Metric Conversion | Unit of Measure
Teflon Tape | Teflon Tape | Teflon Tape | Roll
Brass Male NPT Compression Connector | Brass 3/8-Inch OD x 1/4-Inch Male NPT Compression -Coupler (Sold in 5 Pack) | Brass 10mm OD x 6mm Male NPT Compression -Coupler (Sold in 5 Pack)
Brass Threaded Male to Female-Adapter Bushing | Brass 1/2-in NPT Male to 1/4" NPT Female - Adapter Bushing | Brass13mm NPT Male to 6mm NPT Female -Adapter Bushing
Brass Threaded Female -Elbow | Brass 1/4 Male NPT to 1/4" Female NPT - 90 Elbow | Brass 6mm Male NPT to 6mm Female NPT - 90 Elbow

Piece

Piece

Piece

Wrench https://www.drop box.com/sh/ny5zj c07flfr7w5/AABn 1HDv42Nn4lSAC j989yU3a/Video? dl=0&preview=O xiKit+Final+Asse mbly+Tutorial+1+ of+4.MP4&subfol der_nav_tracking =1

Step | Process | Material | Tools | Youtube Link

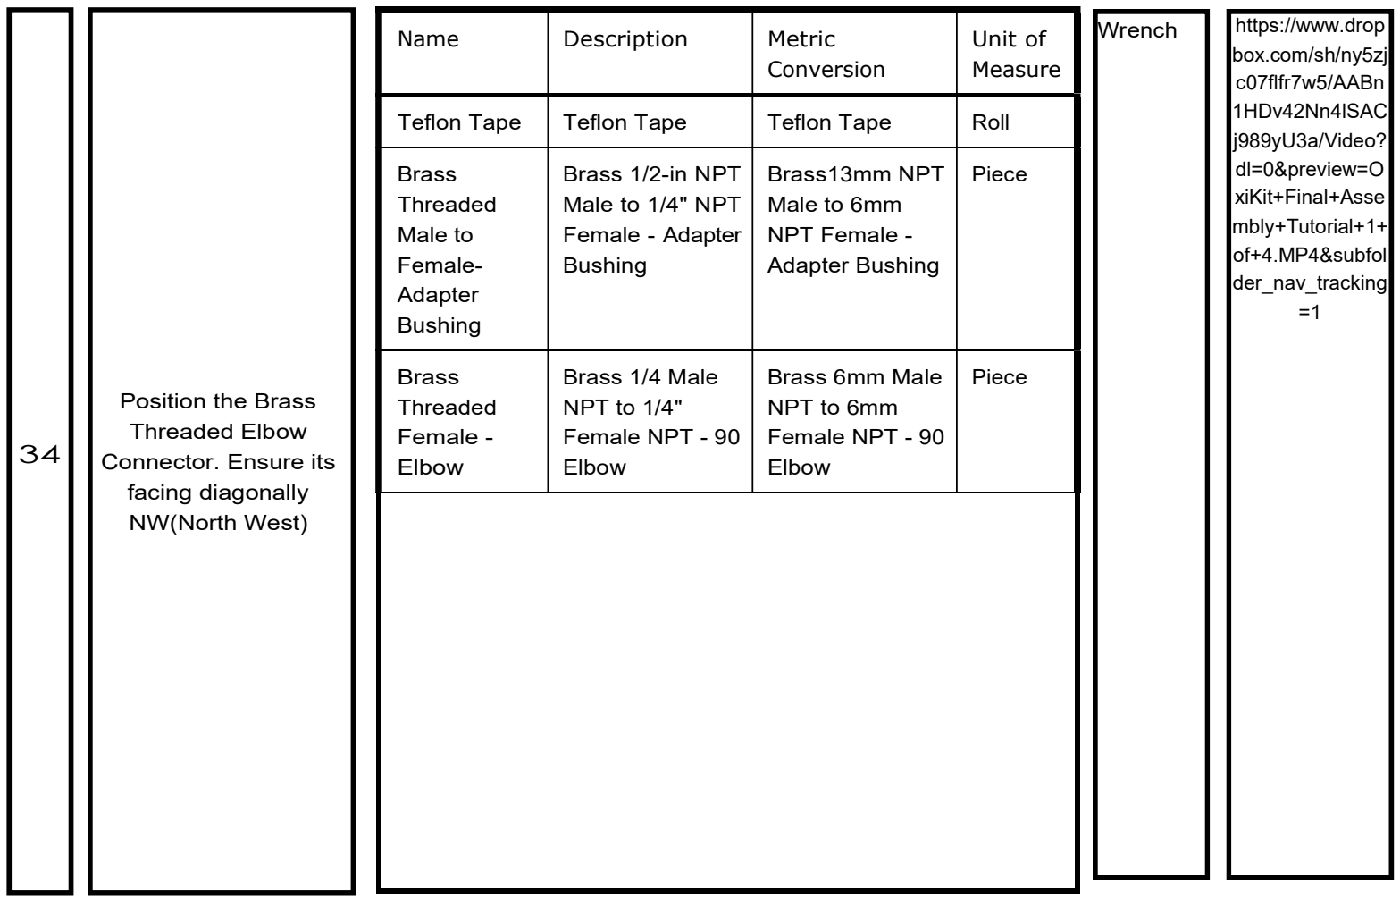
[picture p23: figure]
Position the Brass Threaded Elbow Connector. Ensure its facing diagonally NW(North West); Name; Description; Metric; Conversion; Unit of Measure; Teflon Tape; Roll; Piece; Wrench; https://www.drop; box.com/sh/ny5zj c07flfr7w5/AABn 1HDv42Nn4lSAC j989yU3a/Video? dl=0&preview=O xiKit+Final+Asse mbly+Tutorial+1+ of+4.MP4&subfol der_nav_tracking =1

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
