OxiKit/oxygen-concentrator-how-to-diy-open-source/Drain Cover Trim and Tube  WorkFlow.pdf

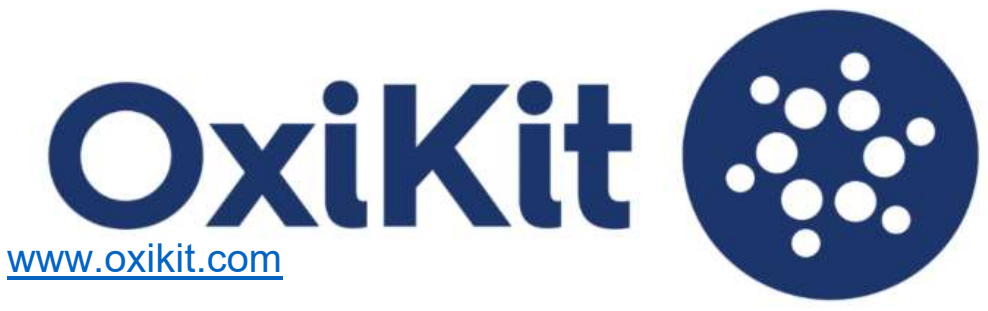
[picture p24: figure]
www.oxikit.com

### Page 1 of 16 Version 1.0

# Drain Cover Trim and Tube WorkFlow

### Version 1.0

### Page 2 of 16

Document # | Date Effective

## OXIKIT-DC001

Supersedes Document Version #:

### OXIKIT WORKFLOW

Document Title

## Workflow - Drain Cover Trim and Tube

### Change History Log:

VERSION # | REVISION DATE | DESCRIPTION OF CHANGE
FROM | TO
1.0 | 11/27/2020 | Original Release

### I. Purpose: This Workflow is intended to serve as a guide in making the Drain Cover Trim and

Drain Cover Tube that are used in the Sieve Canister Assembly..

II. | Scope: This guideline applies to all individuals who wish to build the DIY Oxikit. It includes the Materials, tools and the Video Link needed in assembling the making the Drain Cover Trim and Tube
III. | Picture:

### Fig 1.0 (Drain Cover Trim)

### Page 3 of 16

Document # | Date Effective

## OXIKIT-DC001

Supersedes Document Version #:

### OXIKIT WORKFLOW

Document Title

## Workflow - Drain Cover Trim and Tube

### IV. Safety Operating Conditions: - Always wear protective gloves

### V. Workflows - Please see next page for the step by step guidelines in making the Drain Cover Trim and Tube

Steps | Process | Material | Tools | YouTube Link

### Page 4 of 16

# Drain Cover Tube WorkFlow

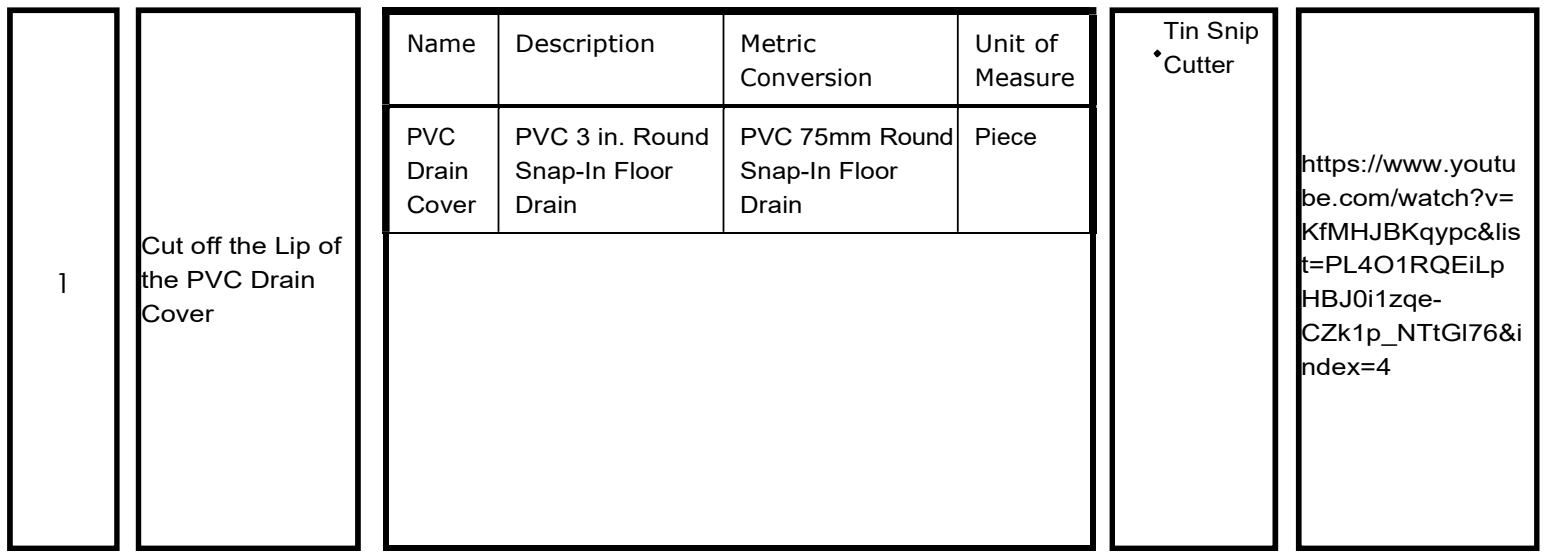
[picture p25: figure]
Cut off the Lip of the PVC Drain Cover; Name; Description; Metric; Conversion; Unit of Measure; PVC Drain Cover; PVC 3 in. Round Snap-In Floor Drain; PVC 75mm Round Snap-In Floor Drain; Piece; Tin Snip Cutter; https://www.youtu be.com/watch?v= KfMHJBKqypc&lis t=PL4O1RQEiLp HBJ0i1zqe- CZk1p_NTtGl76&i ndex=4
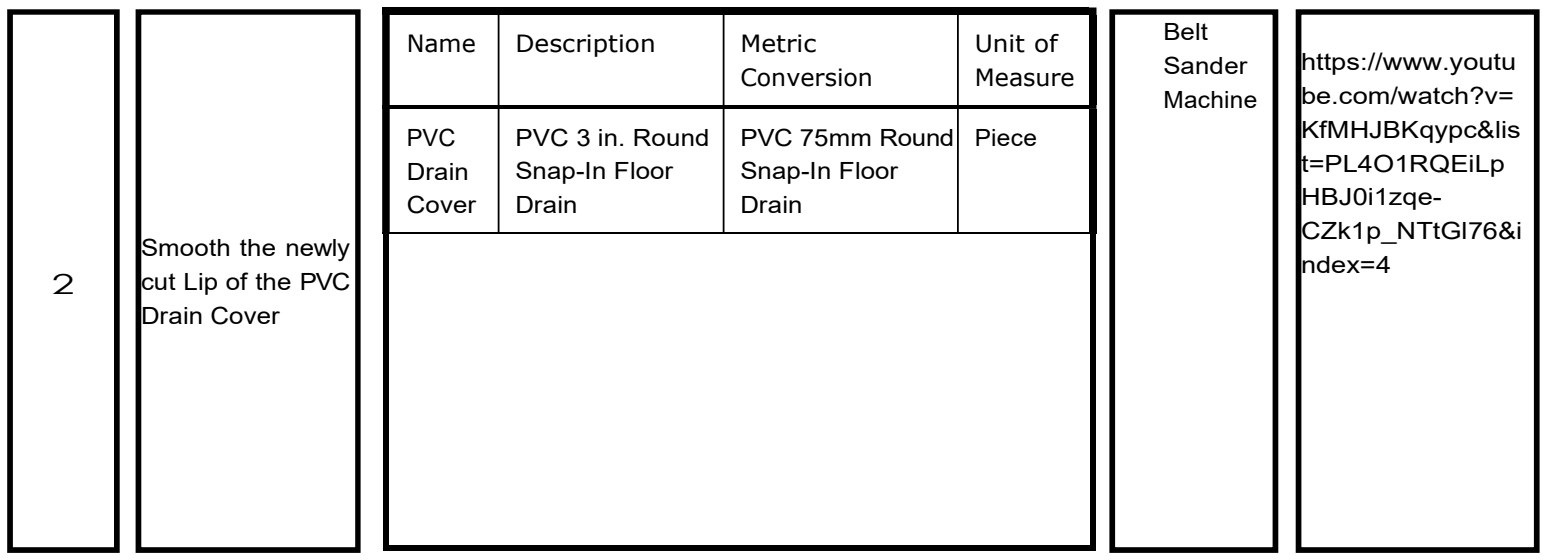
[picture p26: figure]
Smooth the newly cut Lip of the PVC Drain Cover; Name; Description; Metric; Conversion; Unit of Measure; PVC Drain Cover; PVC 3 in. Round Snap-In Floor Drain; PVC 75mm Round Snap-In Floor Drain; Piece; Belt Sander Machine; https://www.youtu be.com/watch?v= KfMHJBKqypc&lis t=PL4O1RQEiLp HBJ0i1zqe- CZk1p_NTtGl76&i ndex=4

### Page 5 of 16

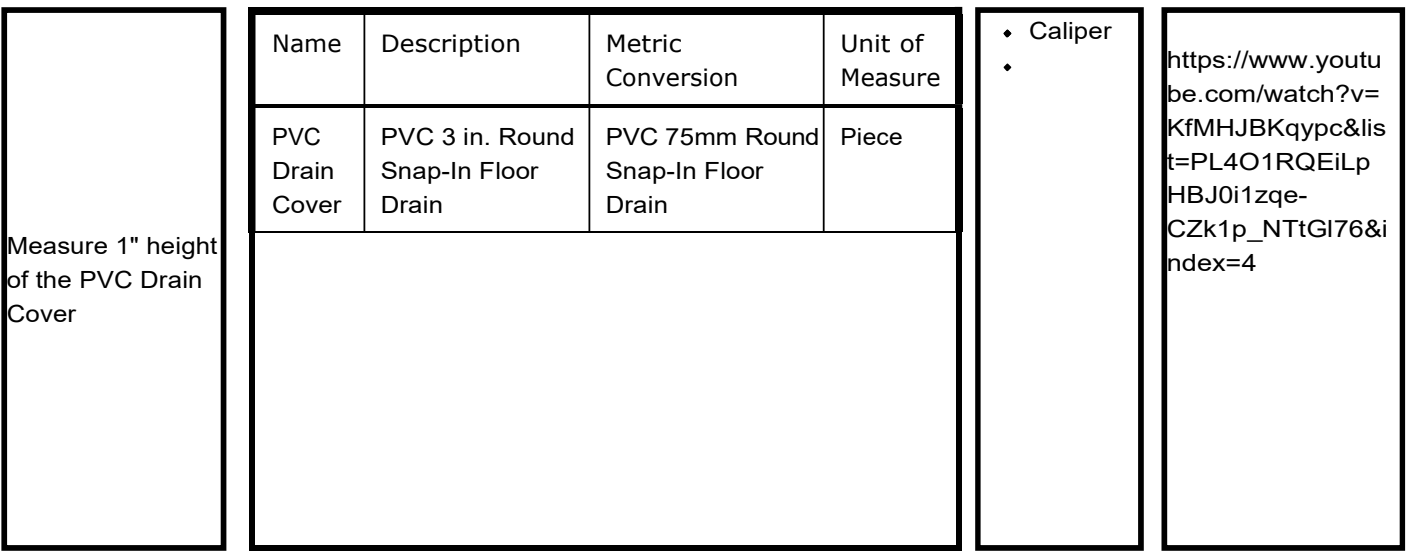
[picture p27: figure]
Measure 1" height of the PVC Drain Cover; Name; Description; Metric; Conversion; Unit of Measure; PVC Drain Cover; PVC 3 in. Round Snap-In Floor Drain; PVC 75mm Round Snap-In Floor Drain; Piece; Caliper; https://www.youtu be.com/watch?v= KfMHJBKqypc&lis t=PL4O1RQEiLp HBJ0i1zqe- CZk1p_NTtGl76&i ndex=4

### Page 6 of 16

3

4

Label 1" height of
the PVC Drain
Cover
Name | Description | Metric Conversion
Unit of
Measure
PVC Drain Cover | PVC 3 in. Round Snap-In Floor Drain | PVC 75mm Round Snap-In Floor Drain
Piece

Caliper
Sharpie/
Marker

https://www.youtu
be.com/watch?v=
KfMHJBKqypc&lis
t=PL4O1RQEiLp
HBJ0i1zqe-CZk1p_NTtGl76&i
ndex=4

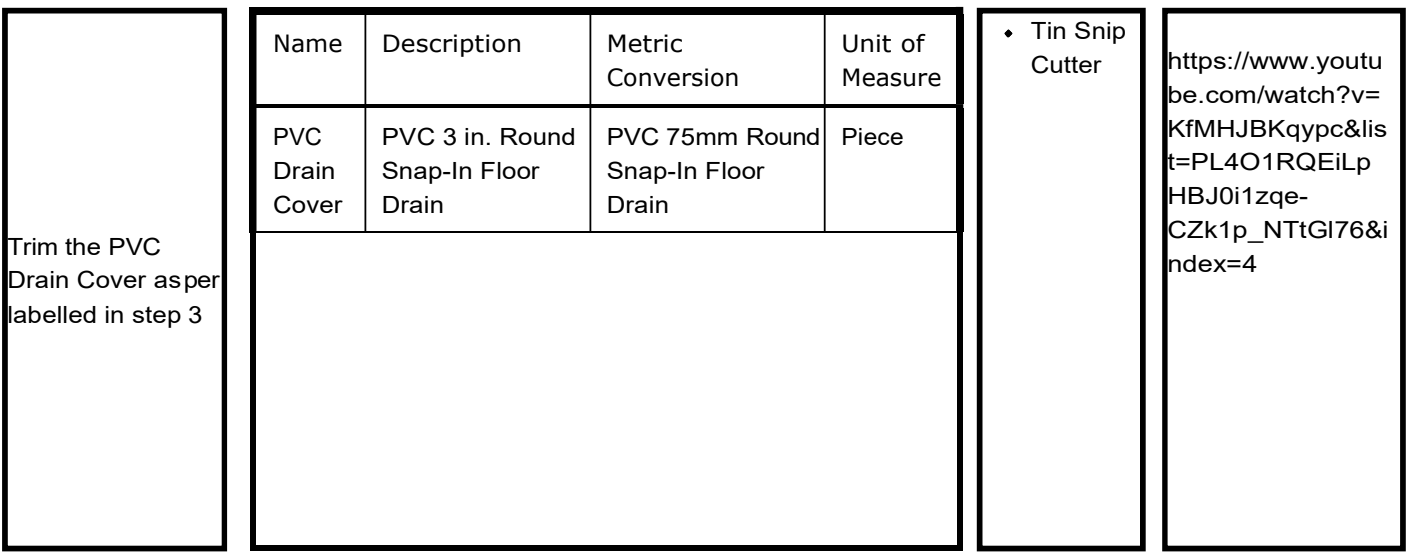
[picture p28: figure]
Trim the PVC Drain Cover as per labelled in step 3; Name; Description; Metric; Conversion; Unit of Measure; PVC Drain Cover; PVC 3 in. Round Snap-In Floor Drain; PVC 75mm Round Snap-In Floor Drain; Piece; Tin Snip; Cutter; https://www.youtu; be.com/watch?v= KfMHJBKqypc&lis t=PL4O1RQEiLp HBJ0i1zqe- CZk1p_NTtGl76&i ndex=4

### Page 7 of 16

5

6

Smooth the
bottom part of the
newly trimmed
PVC Drain Cover
Name | Description | Metric Conversion
Unit of
Measure
PVC Drain Cover | PVC 3 in. Round Snap-In Floor Drain | PVC 75mm Round Snap-In Floor Drain
Piece

Belt
Sander
Machine

https://www.youtu
be.com/watch?v=
KfMHJBKqypc&lis
t=PL4O1RQEiLp
HBJ0i1zqe-CZk1p_NTtGl76&i
ndex=4

### Page 8 of 16

7

Smooth the sides
and edges of the
PVC Drain Cover
Name | Description | Metric Conversion
Unit of
Measure
PVC Drain Cover | PVC 3 in. Round Snap-In Floor Drain | PVC 75mm Round Snap-In Floor Drain
Piece

Belt
Sander
Machine

https://www.youtu
be.com/watch?v=
KfMHJBKqypc&lis
t=PL4O1RQEiLp
HBJ0i1zqe-CZk1p_NTtGl76&i
ndex=4

8

Inspect if the PVC
Drain Cover -
Trimmed will fit
inside the PVC
Male Adaptor
Socket. If it won’t
fit, Sand and Trim
the PVC Drain
Cover again
Name | Description | Metric Conversion
Unit of
Measure
PVC Drain Cover | PVC 3 in. Round Snap-In Floor Drain | PVC 75mm Round Snap-In Floor Drain
PVC Male Adapter Socket | 3" Schedule 40 PVC Male Adapter - MIPT x Socket | 75mm Schedule 40 PVC Male Adapter - MIPT x Socket

Piece

Piece

https://www.youtu
be.com/watch?v=
KfMHJBKqypc&lis
t=PL4O1RQEiLp
HBJ0i1zqe-CZk1p_NTtGl76&i
ndex=4

### Page 9 of 16

9

Inspect if the
Non- Woven
Fiber Filter will fit
with the PVC
Drain Cover -
Trimmed into the
PVC Male
Adaptor Socket.
Ensure it has
enough space for
Drain Cover to
shift and move.
Name | Description | Metric Conversion
Unit of
Measure
PVC Drain Cover | PVC 3 in. Round Snap-In Floor Drain | PVC 75mm Round Snap-In Floor Drain
PVC Male Adapter Socket | 3" Schedule 40 PVC Male Adapter - MIPT x Socket | 75mm Schedule 40 PVC Male Adapter - MIPT x Socket
Non Woven Fiber Filter | 4" Diameter Non Woven Fiber Filter | 101 mm Diameter Non Woven Fiber Filter

Piece

Piece

Piece

https://www.youtu
be.com/watch?v=
KfMHJBKqypc&lis
t=PL4O1RQEiLp
HBJ0i1zqe-CZk1p_NTtGl76&i
ndex=4

10

If it won’t fit, Cut
and | trim | the
non-woven
Filter again
Name | Description | Metric Conversion
Unit of
Measure
Non Woven Fiber Filter | 4" Diameter Non Woven Fiber Filter | 101 mm Diameter Non Woven Fiber Filter

Piece

Scissors/
Cutter https://www.youtu
be.com/watch?v=
KfMHJBKqypc&lis
t=PL4O1RQEiLp
HBJ0i1zqe-CZk1p_NTtGl76&i
ndex=4

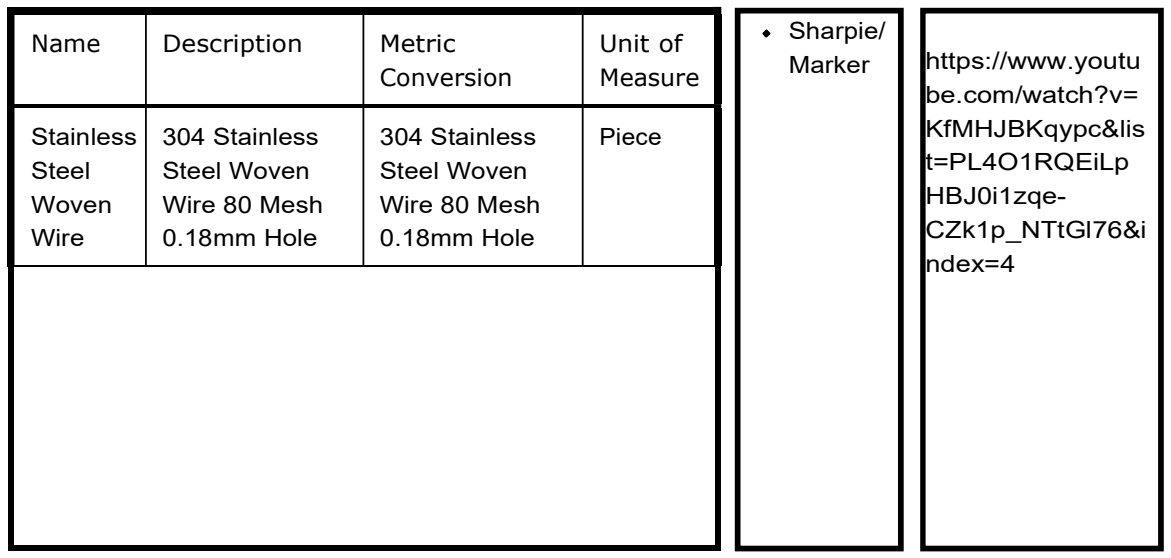
[picture p29: figure]
Name; Description; Metric; Conversion; Unit of Measure; Stainless Steel Woven Wire; 304 Stainless Steel Woven Wire 80 Mesh 0.18mm Hole; Piece; Sharpie/; Marker; https://www.youtu; be.com/watch?v= KfMHJBKqypc&lis t=PL4O1RQEiLp HBJ0i1zqe- CZk1p_NTtGl76&i ndex=4

### Page 10 of 16

11

Trace and Label
the PVC Drain
Cover into the
Stainless Steel
Woven Wire

12

Cut the Labelled
Circle in step 11
Name | Description | Metric Conversion
Unit of
Measure
Stainless Steel Woven Wire | 304 Stainless Steel Woven Wire 80 Mesh 0.18mm Hole | 304 Stainless Steel Woven Wire 80 Mesh 0.18mm Hole

Piece

Scissors/
Cutter https://www.youtu
be.com/watch?v=
KfMHJBKqypc&lis
t=PL4O1RQEiLp
HBJ0i1zqe-CZk1p_NTtGl76&i
ndex=4

### Page 11 of 16

13

Place the
Stainless Steel
Woven Wire on
top of the PVC
Drain Cover
Name | Description | Metric Conversion
Unit of
Measure
Stainless Steel Woven Wire | 304 Stainless Steel Woven Wire 80 Mesh 0.18mm Hole | 304 Stainless Steel Woven Wire 80 Mesh 0.18mm Hole
PVC Drain Cover | PVC 3 in. Round Snap-In Floor Drain | PVC 75mm Round Snap-In Floor Drain

Piece

Piece

https://www.youtu
be.com/watch?v=
KfMHJBKqypc&lis
t=PL4O1RQEiLp
HBJ0i1zqe-CZk1p_NTtGl76&i
ndex=4

14

Glue the Stainless
Steel Woven Wire
and the PVC Drain
Cover together.
Place a little dab
of super glue
(every half inch)
on the sides of the
Stainless Steel
Woven Wire
Name | Description | Metric Conversion
Unit of
Measure

Super Glue

Stainless Steel Woven Wire | 304 Stainless Steel Woven Wire 80 Mesh 0.18mm Hole | 304 Stainless Steel Woven Wire 80 Mesh 0.18mm Hole
Super Glue | Super Glue | piece
| | Piece

https://www.youtu
be.com/watch?v=
KfMHJBKqypc&lis
t=PL4O1RQEiLp
HBJ0i1zqe-CZk1p_NTtGl76&i
ndex=4

### Page 12 of 16

15

Push the Stainless
Steel Woven Wire
into the PVC
Round Snap-in
Floor
Name | Description | Metric Conversion
Unit of
Measure

Super Glue

Stainless Steel Woven Wire | 304 Stainless Steel Woven Wire 80 Mesh 0.18mm Hole | 304 Stainless Steel Woven Wire 80 Mesh 0.18mm Hole
Super Glue | Super Glue | piece
| | Piece

Screwdriver
https://www.youtu
be.com/watch?v=
KfMHJBKqypc&lis
t=PL4O1RQEiLp
HBJ0i1zqe-CZk1p_NTtGl76&i
ndex=4

### 16 Let it Dry

Name | Description | Metric Conversion
Unit of
Measure

Super Glue

Stainless Steel Woven Wire | 304 Stainless Steel Woven Wire 80 Mesh 0.18mm Hole | 304 Stainless Steel Woven Wire 80 Mesh 0.18mm Hole
Super Glue | Super Glue | piece
| | Piece

https://www.youtu
be.com/watch?v=
KfMHJBKqypc&lis
t=PL4O1RQEiLp
HBJ0i1zqe-CZk1p_NTtGl76&i
ndex=4

# Drain Cover Tube WorkFlow

### Page 14 of 16

17

Get another PVC
Drain Cover
Name | Description | Metric Conversion
Unit of
Measure
PVC Drain Cover | PVC 3 in. Round Snap-In Floor Drain | PVC 75mm Round Snap-In Floor Drain
Piece

18

Measure 14.5 mm
from the opposite
end of the PVC
Drain Cover
Name | Description | Metric Conversion
Unit of
Measure
PVC Drain Cover | PVC 3 in. Round Snap-In Floor Drain | PVC 75mm Round Snap-In Floor Drain
Piece

Caliper

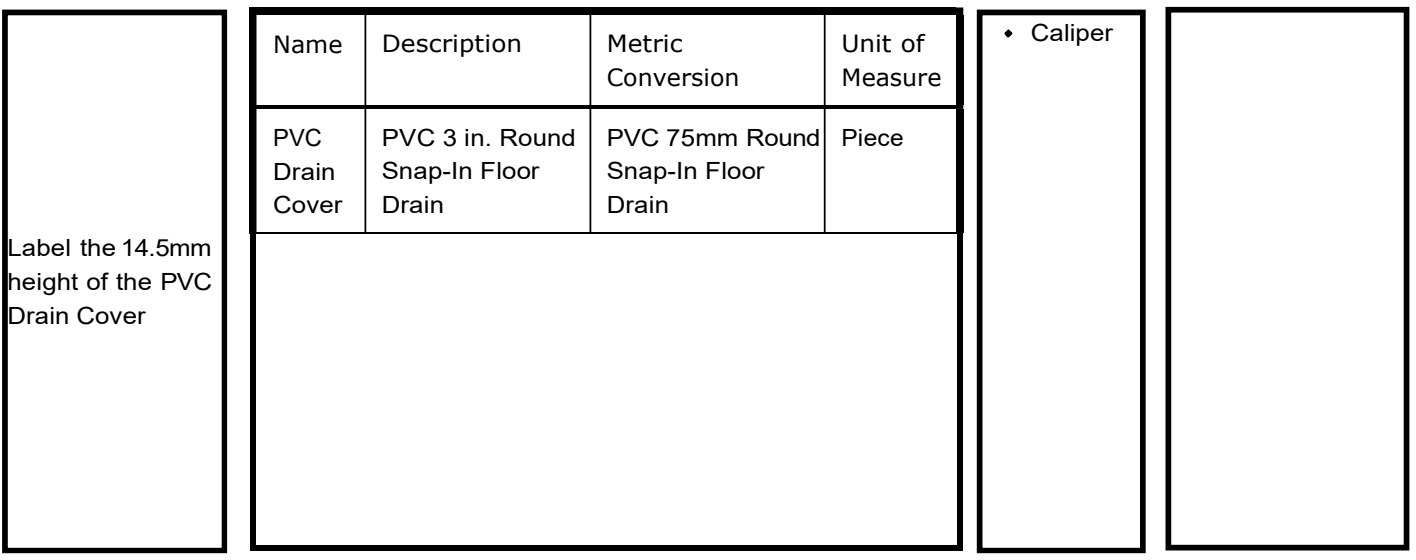
[picture p30: figure]
Label the 14.5mm height of the PVC Drain Cover; Name; Description; Metric; Conversion; Unit of Measure; PVC Drain Cover; PVC 3 in. Round Snap-In Floor Drain; PVC 75mm Round Snap-In Floor Drain; Piece; Caliper

### Page 15 of 16

19

20

Cut and trim the
labelled PVC to
form a tube
Name | Description | Metric Conversion
Unit of
Measure
PVC Drain Cover | PVC 3 in. Round Snap-In Floor Drain | PVC 75mm Round Snap-In Floor Drain
Piece

Tin Snip
Cutter

### Page 16 of 16

21

Sand and smooth
the newly cut
tube
Name | Description | Metric Conversion
Unit of
Measure
Drain Cover Tube | 0.6" long PVC Round Snap in Floor Drain | 14 1/2 mm long PVC Round Snap in Floor Drain

Piece

Belt
Sander
Machine
