OxiKit/oxygen-concentrator-how-to-diy-open-source/Frame WorkFlow.pdf

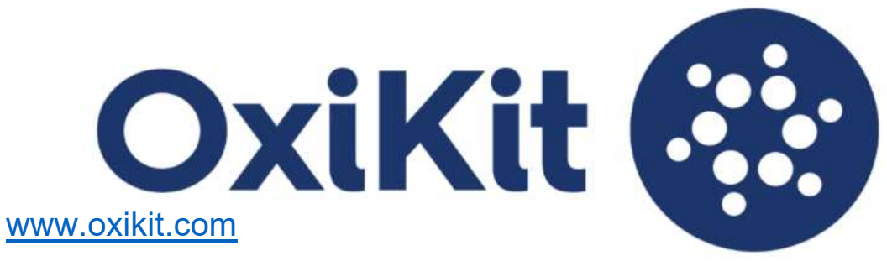
[picture p31: figure]
www.oxikit.com
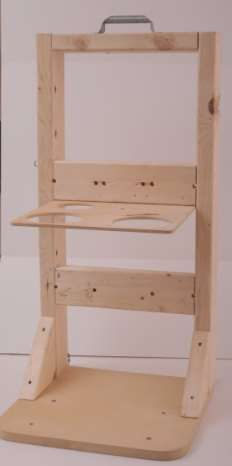
[picture p32: figure]

### Page 1 of 38 Version 1.0

# Frame Assembly WorkFlow

### Version 1.0

## OXIKIT-FR001

### OXIKIT WORKFLOW

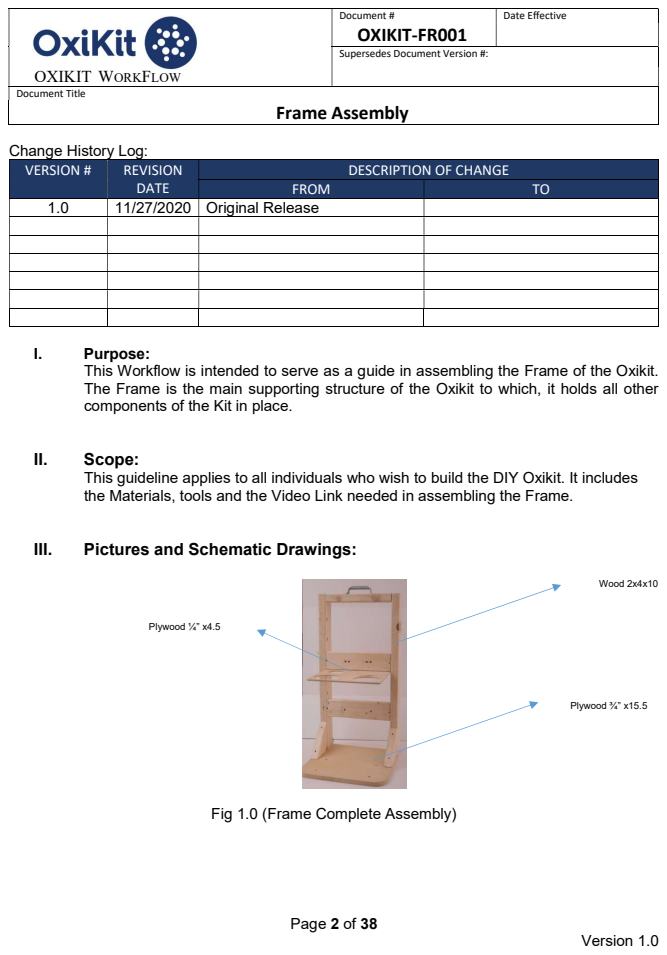
[picture p33: page 2]
Page 2 of 38; Document #; Date Effective; Document Title; Frame Assembly; Scope:; III.; Pictures and Schematic Drawings:; Wood 2x4x10; Plywood ¾” x15.5; Plywood ¼” x4.5

Supersedes Document Version #:

Change History Log:

VERSION # | REVISION DATE | DESCRIPTION OF CHANGE

FROM | TO

1.0 | 11/27/2020 | Original Release

I. Purpose:
This Workflow is intended to serve as a guide in assembling the Frame of the Oxikit.
The Frame is the main supporting structure of the Oxikit to which, it holds all other
components of the Kit in place.

This guideline applies to all individuals who wish to build the DIY Oxikit. It includes
the Materials, tools and the Video Link needed in assembling the Frame.

Fig 1.0 (Frame Complete Assembly)

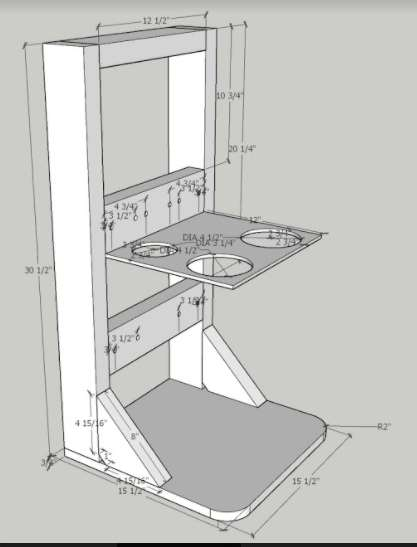
[picture p34: figure]

### Page 3 of 38

Document # | Date Effective

## OXIKIT-FR001

Supersedes Document Version #:

### OXIKIT WORKFLOW

Document Title

## Frame Assembly

Fig. 2.0(Measurements for the whole frame)

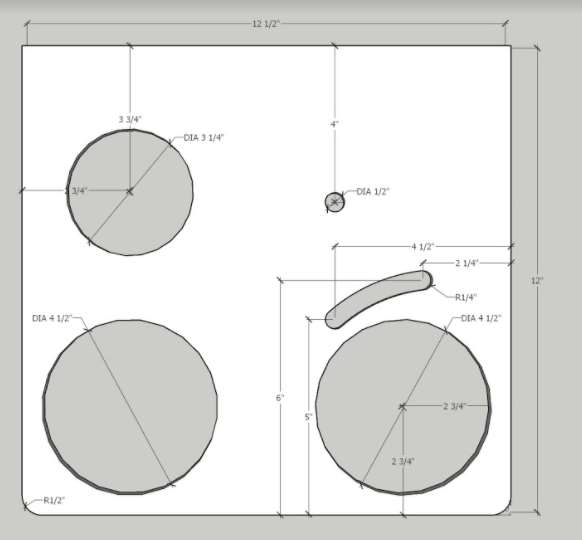
[picture p35: figure]

### Page 4 of 38

Document # | Date Effective

## OXIKIT-FR001

Supersedes Document Version #:

### OXIKIT WORKFLOW

Document Title

## Frame Assembly

Fig. 3.0(Measurement for the Fan Deck Board)

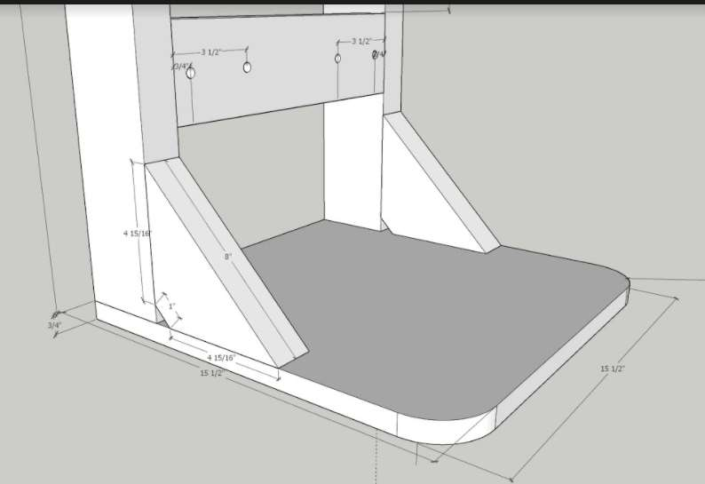
[picture p36: figure]

### Page 5 of 38

Document # | Date Effective

## OXIKIT-FR001

Supersedes Document Version #:

### OXIKIT WORKFLOW

Document Title

## Frame Assembly

Fig. 4.0 (Measurements for the Base Board and Angle Piece)

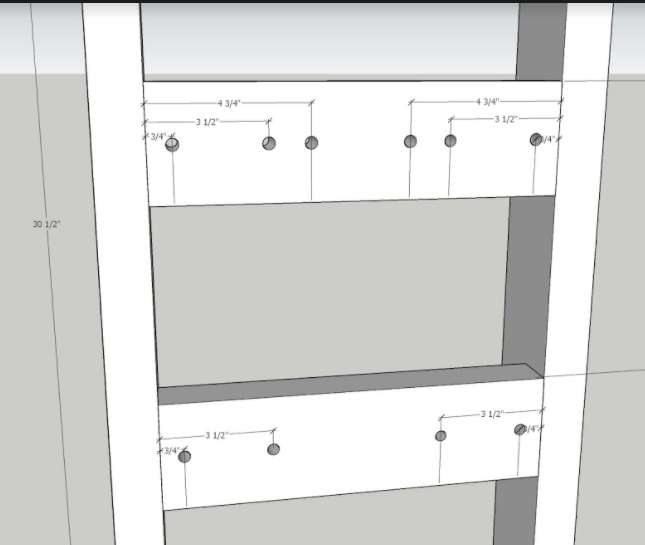
[picture p37: figure]

### Page 6 of 38

Fig. 5.0 (Measurements for Cross Pieces)

Document # | Date Effective

## OXIKIT-FR001

Supersedes Document Version #:

### OXIKIT WORKFLOW

Document Title

## Frame Assembly

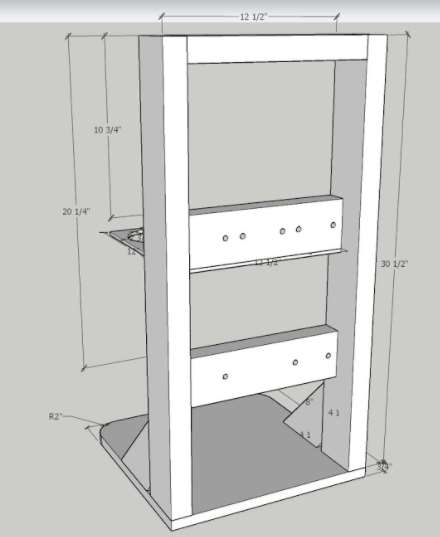
[picture p38: figure]

### Page 7 of 38

Fig. 6.0 (Measurements for Side frame)

Document # | Date Effective

## OXIKIT-FR001

Supersedes Document Version #:

### OXIKIT WORKFLOW

Document Title

## Frame Assembly

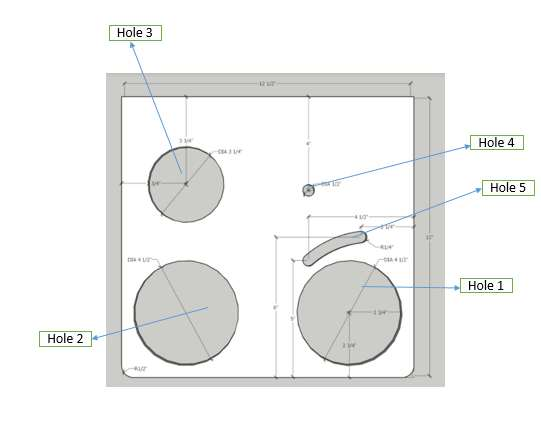
[picture p39: figure]
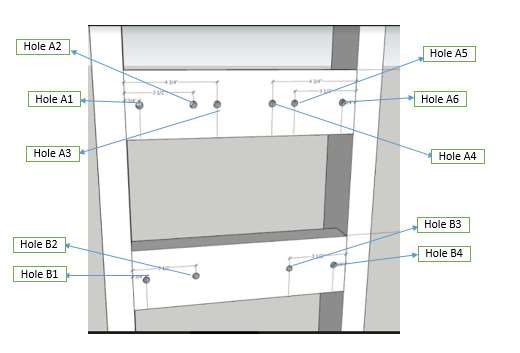
[picture p40: figure]

### Page 8 of 38

Fig.7.0 (Hole Assignment for Fan Deck Board) | Fig.8.0 (Hole Assignment for Cross Pieces)

### FIGURE SUMMARY

FIGURE # | DESCRIPTION | REMARKS
1 | Frame Complete Assembly | Describes the parts needed to assemble the Frame

### 2 Measurements for the whole frame 3 Measurement for Fan Deck Board

4 Measurements for Base Board and | Angle Pieces

### 5 Measurements for Cross Pieces 6 Measurements for Side Frame

7 | Hole Assignment for Fan Deck Board | Holes that are described in the workflows
8 | Hole Assignment for Cross Pieces | Holes that are described in the workflows
Document # | Date Effective

## OXIKIT-FR001

Supersedes Document Version #:

### OXIKIT WORKFLOW

Document Title

## Frame Assembly

### Page 9 of 38

### IV. Safety Operating Conditions: - Always wear protective gloves

### V. Workflows - Please see next page for the step by step guidelines in making the Frame

| Assembly
Document # | Date Effective

## OXIKIT-FR001

Supersedes Document Version #:

### OXIKIT WORKFLOW

Document Title

## Frame Assembly

Step | Process | Material | Tools | Youtube Link

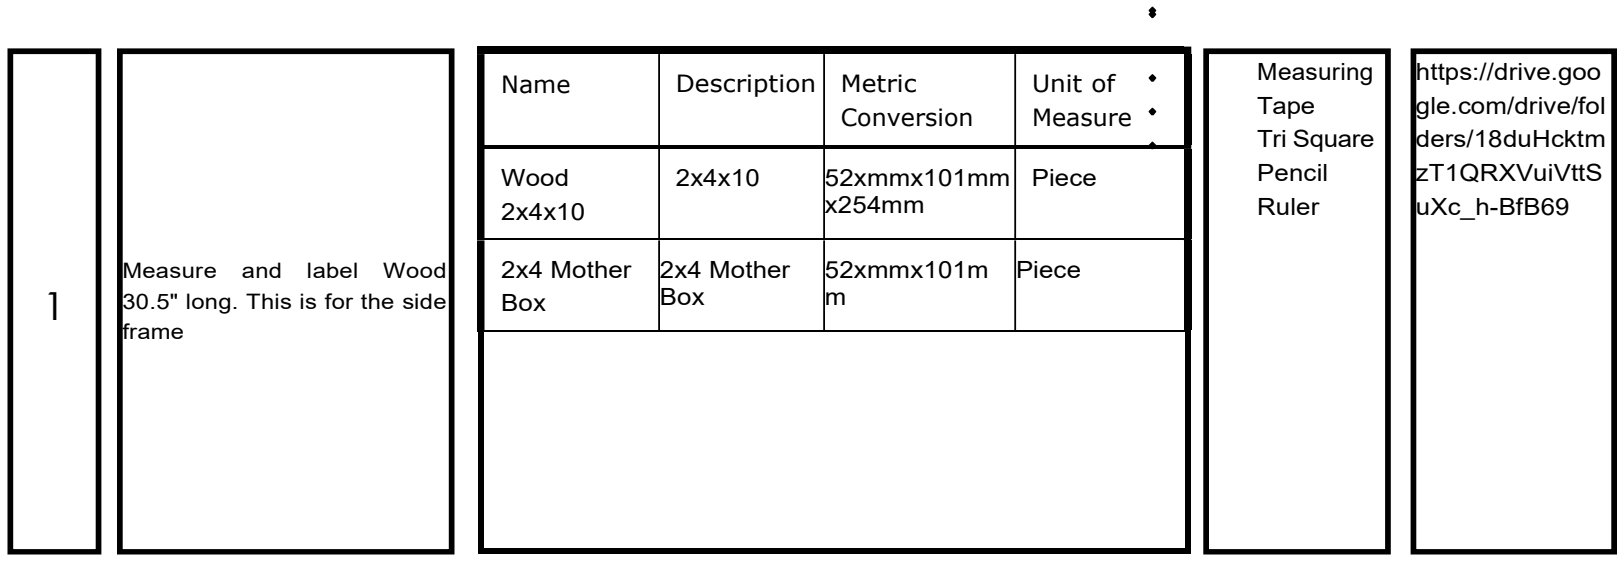
[picture p41: figure]
Measure and label Wood 30.5" long. This is for the side frame; Name; Description; Metric; Conversion; Unit of Measure; Wood 2x4x10; 52xmmx101mm x254mm; Piece; 2x4 Mother Box; 52xmmx101m m; Measuring Tape Tri Square Pencil Ruler; https://drive.goo gle.com/drive/fol ders/18duHcktm zT1QRXVuiVttS uXc_h-BfB69
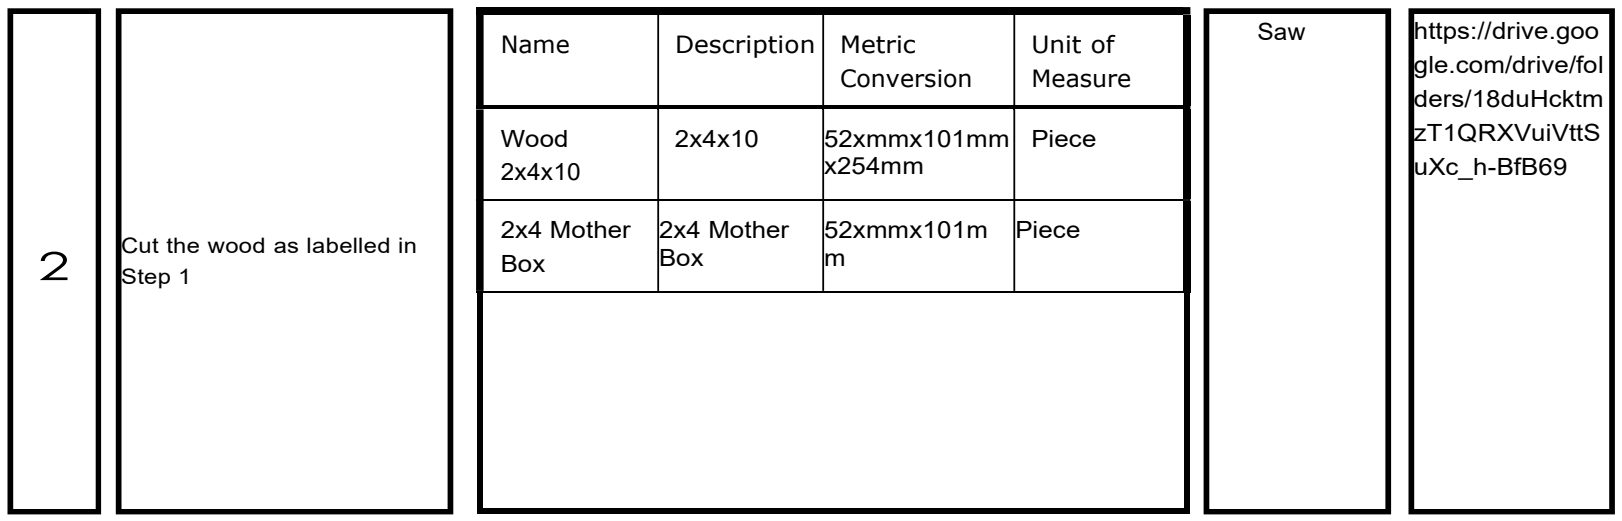
[picture p42: figure]
2 Cut the wood as labelled in Step 1; Name; Description; Metric; Conversion; Unit of Measure; Wood 2x4x10; 52xmmx101mm x254mm; Piece; 2x4 Mother Box; 52xmmx101m m; Saw; https://drive.goo; gle.com/drive/fol ders/18duHcktm zT1QRXVuiVttS uXc_h-BfB69

Page 4 of 13 | Version 1.0

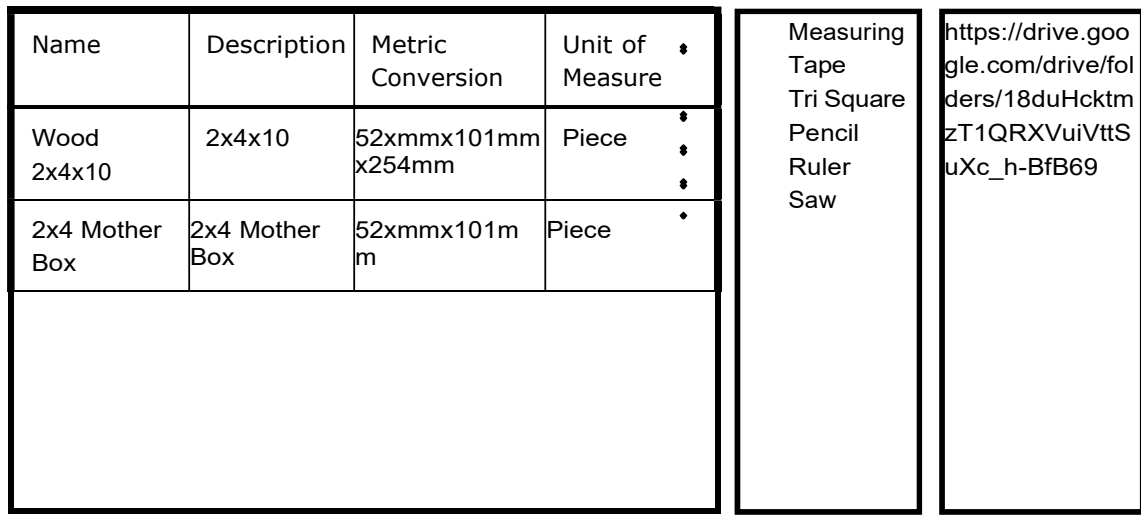
[picture p43: figure]
Name; Description; Metric; Conversion; Unit of Measure; Wood 2x4x10; 52xmmx101mm x254mm; Piece; 2x4 Mother Box; 52xmmx101m m; Measuring Tape Tri Square Pencil Ruler Saw; https://drive.goo gle.com/drive/fol ders/18duHcktm zT1QRXVuiVttS uXc_h-BfB69
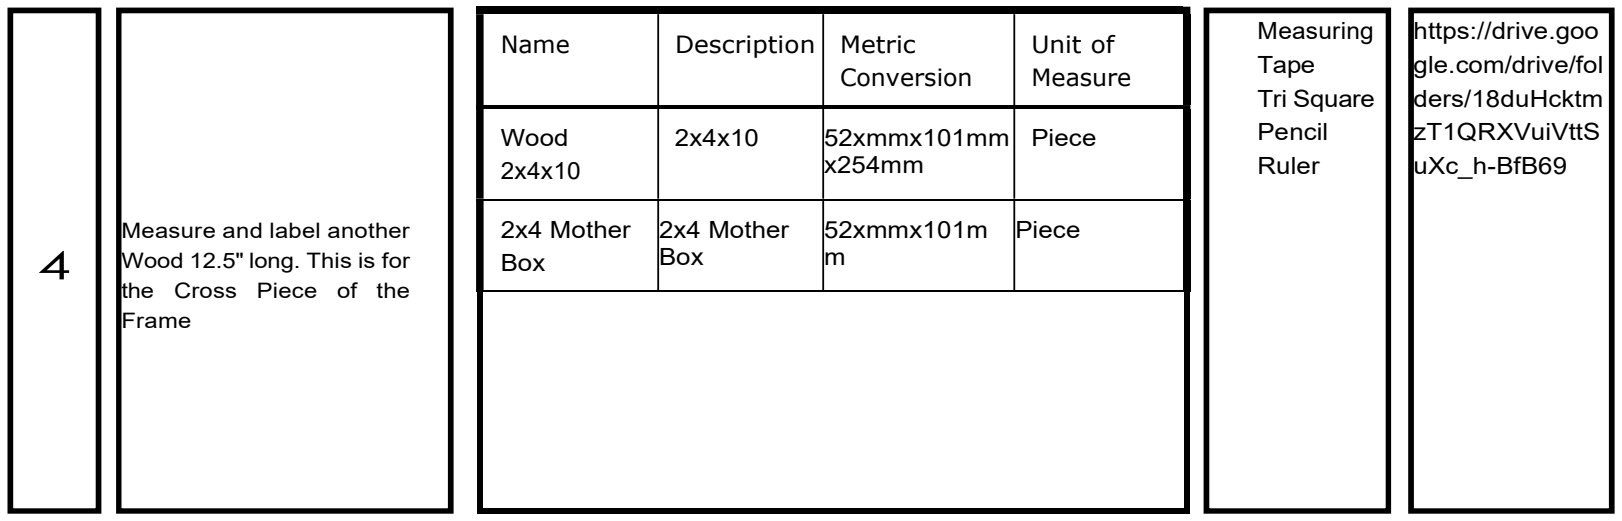
[picture p44: figure]
Measure and label another Wood 12.5" long. This is for the Cross Piece of the Frame; Name; Description; Metric; Conversion; Unit of Measure; Wood 2x4x10; 52xmmx101mm x254mm; Piece; 2x4 Mother Box; 52xmmx101m m; Measuring Tape Tri Square Pencil Ruler; https://drive.goo gle.com/drive/fol ders/18duHcktm zT1QRXVuiVttS uXc_h-BfB69

### Page 11 of 38

### 3 Make another Side Frame as

per step 1 and 2

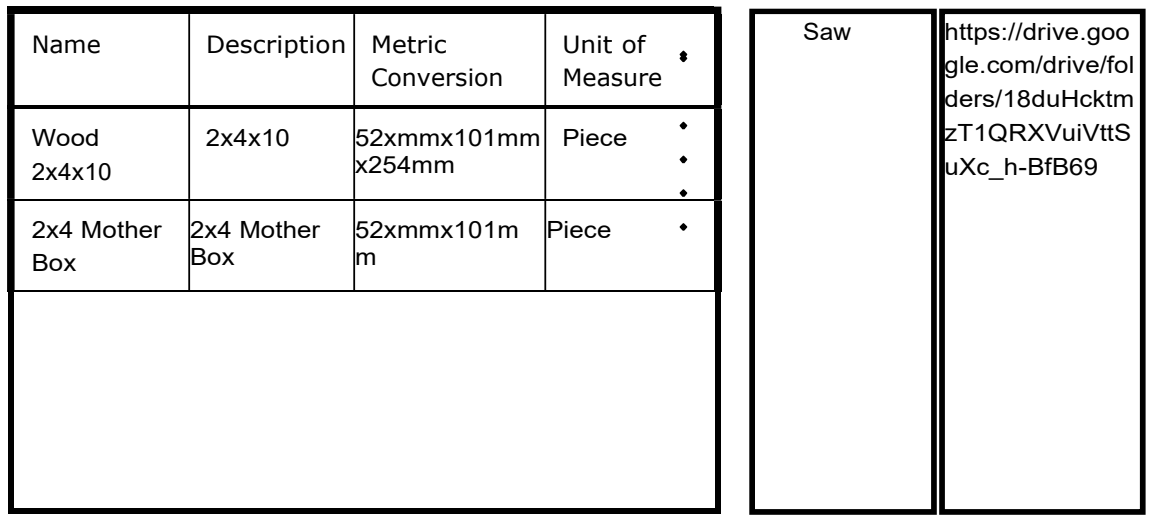
[picture p45: figure]
Name; Description; Metric; Conversion; Unit of Measure; Wood 2x4x10; 52xmmx101mm x254mm; Piece; 2x4 Mother Box; 52xmmx101m m; Saw; https://drive.goo; gle.com/drive/fol ders/18duHcktm zT1QRXVuiVttS uXc_h-BfB69
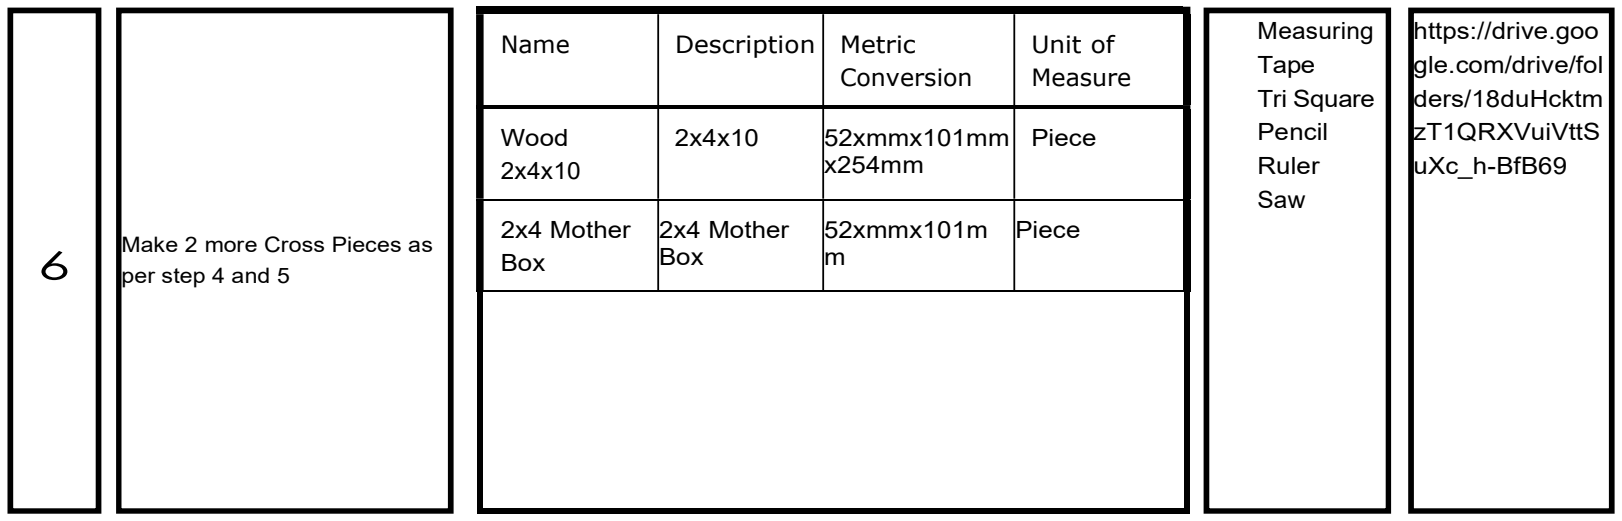
[picture p46: figure]
6 Make 2 more Cross Pieces as per step 4 and 5; Name; Description; Metric; Conversion; Unit of Measure; Wood 2x4x10; 52xmmx101mm x254mm; Piece; 2x4 Mother Box; 52xmmx101m m; Measuring Tape Tri Square Pencil Ruler Saw; https://drive.goo gle.com/drive/fol ders/18duHcktm zT1QRXVuiVttS uXc_h-BfB69

### Page 12 of 38

### 5 Cut the wood as labelled in

Step 4

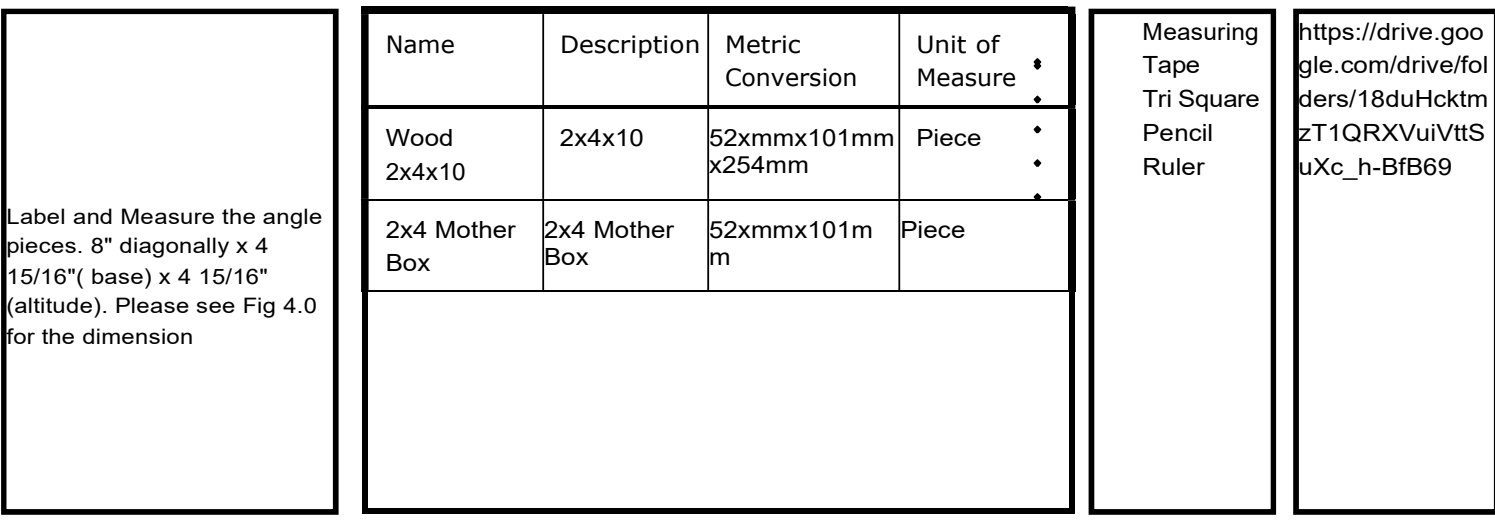
[picture p47: figure]
Label and Measure the angle pieces. 8" diagonally x 4 15/16"( base) x 4 15/16" (altitude). Please see Fig 4.0 for the dimension; Name; Description; Metric; Conversion; Unit of Measure; Wood 2x4x10; 52xmmx101mm x254mm; Piece; 2x4 Mother Box; 52xmmx101m m; Measuring Tape Tri Square Pencil Ruler; https://drive.goo gle.com/drive/fol ders/18duHcktm zT1QRXVuiVttS uXc_h-BfB69
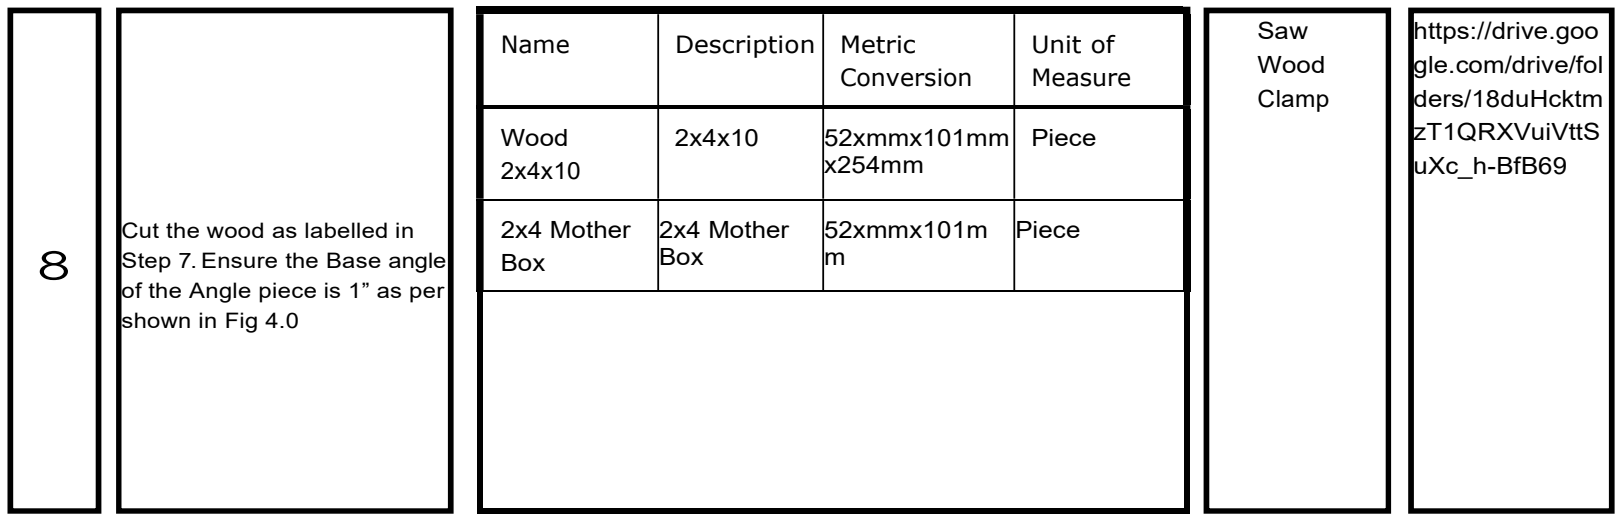
[picture p48: figure]
Cut the wood as labelled in Step 7. Ensure the Base angle of the Angle piece is 1” as per shown in Fig 4.0; Name; Description; Metric; Conversion; Unit of Measure; Wood 2x4x10; 52xmmx101mm x254mm; Piece; 2x4 Mother Box; 52xmmx101m m; Saw Wood Clamp; https://drive.goo gle.com/drive/fol ders/18duHcktm zT1QRXVuiVttS uXc_h-BfB69

### Page 13 of 38

7

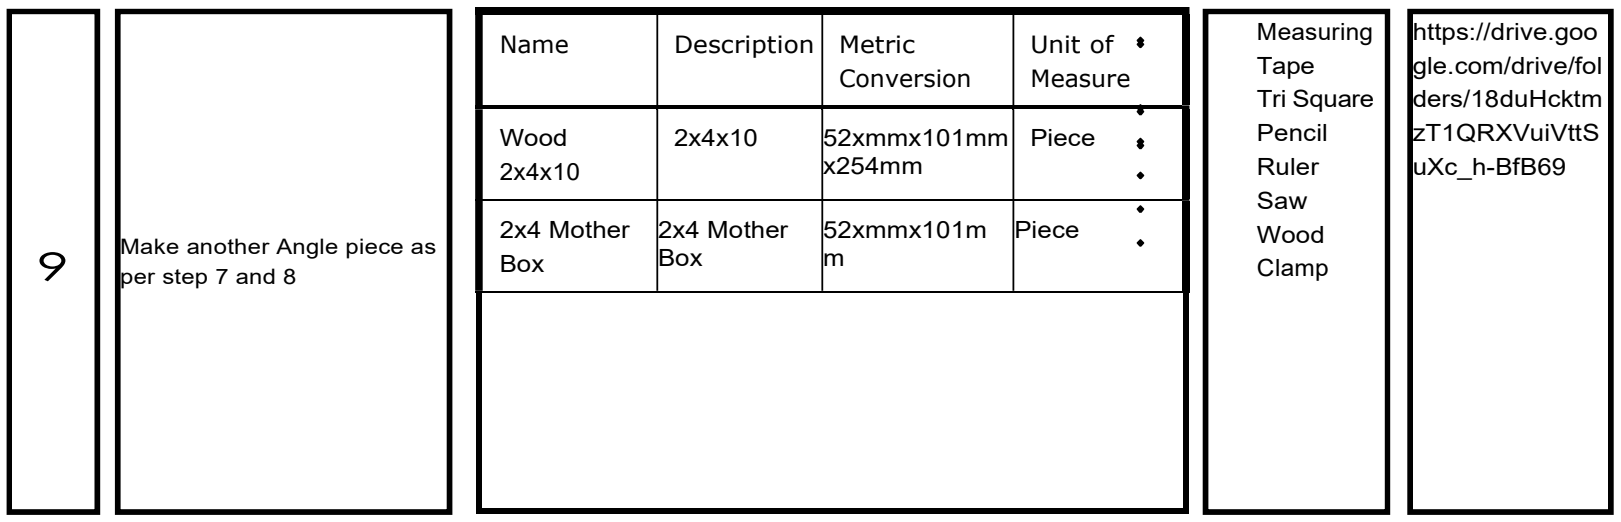
[picture p49: figure]
9 Make another Angle piece as per step 7 and 8; Name; Description; Metric; Conversion; Unit of Measure; Wood 2x4x10; 52xmmx101mm x254mm; Piece; 2x4 Mother Box; 52xmmx101m m; Measuring Tape Tri Square Pencil Ruler Saw Wood Clamp; https://drive.goo gle.com/drive/fol ders/18duHcktm zT1QRXVuiVttS uXc_h-BfB69
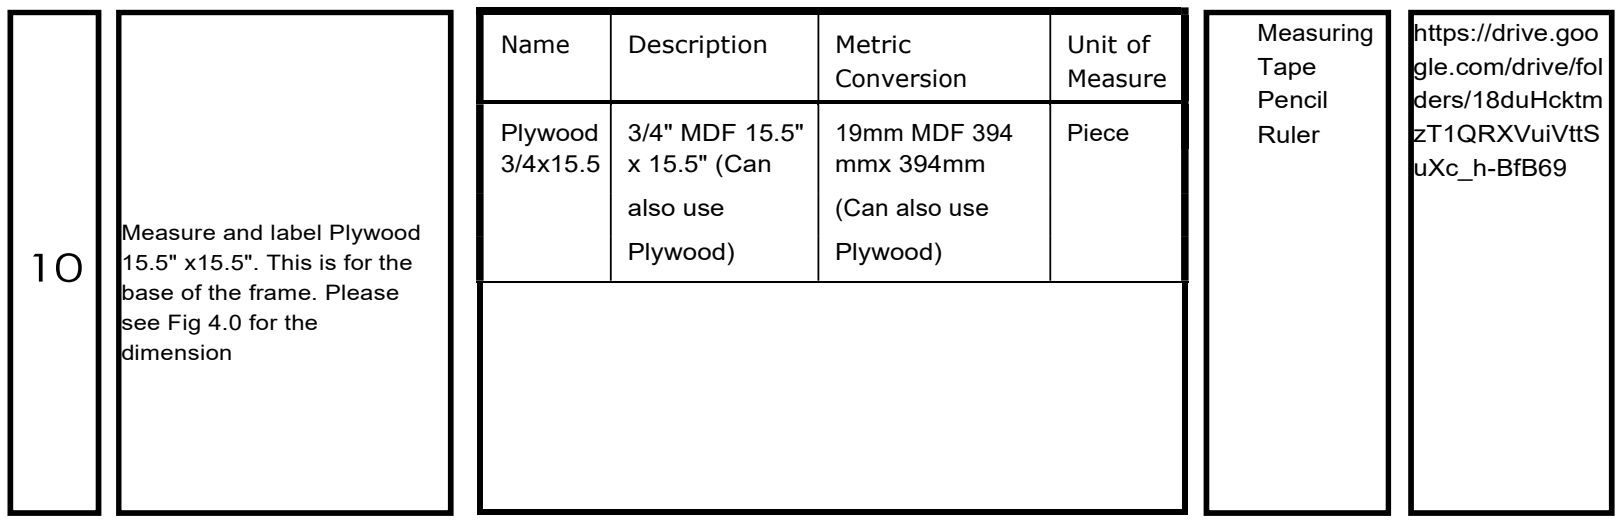
[picture p50: figure]
Measure and label Plywood 15.5" x15.5". This is for the base of the frame. Please see Fig 4.0 for the dimension; Name; Description; Metric; Conversion; Unit of Measure; Plywood; 3/4" MDF 15.5"; 19mm MDF 394; Piece; x 15.5" (Can; mmx 394mm; also use; (Can also use; Plywood); Measuring Tape Pencil Ruler; https://drive.goo gle.com/drive/fol ders/18duHcktm zT1QRXVuiVttS uXc_h-BfB69

### Page 14 of 38

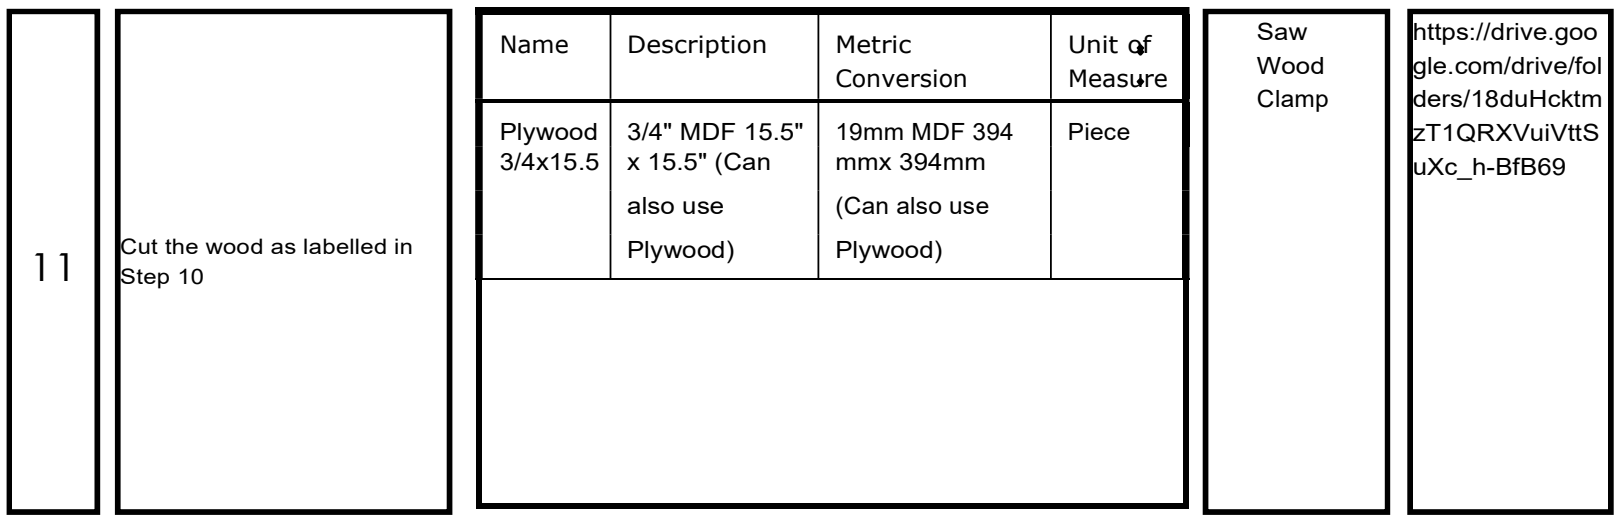
[picture p51: figure]
11 Cut the wood as labelled in Step 10; Name; Description; Metric; Conversion; Unit of Measure; Plywood; 3/4" MDF 15.5"; 19mm MDF 394; Piece; x 15.5" (Can; mmx 394mm; also use; (Can also use; Plywood); Saw Wood Clamp; https://drive.goo gle.com/drive/fol ders/18duHcktm zT1QRXVuiVttS uXc_h-BfB69
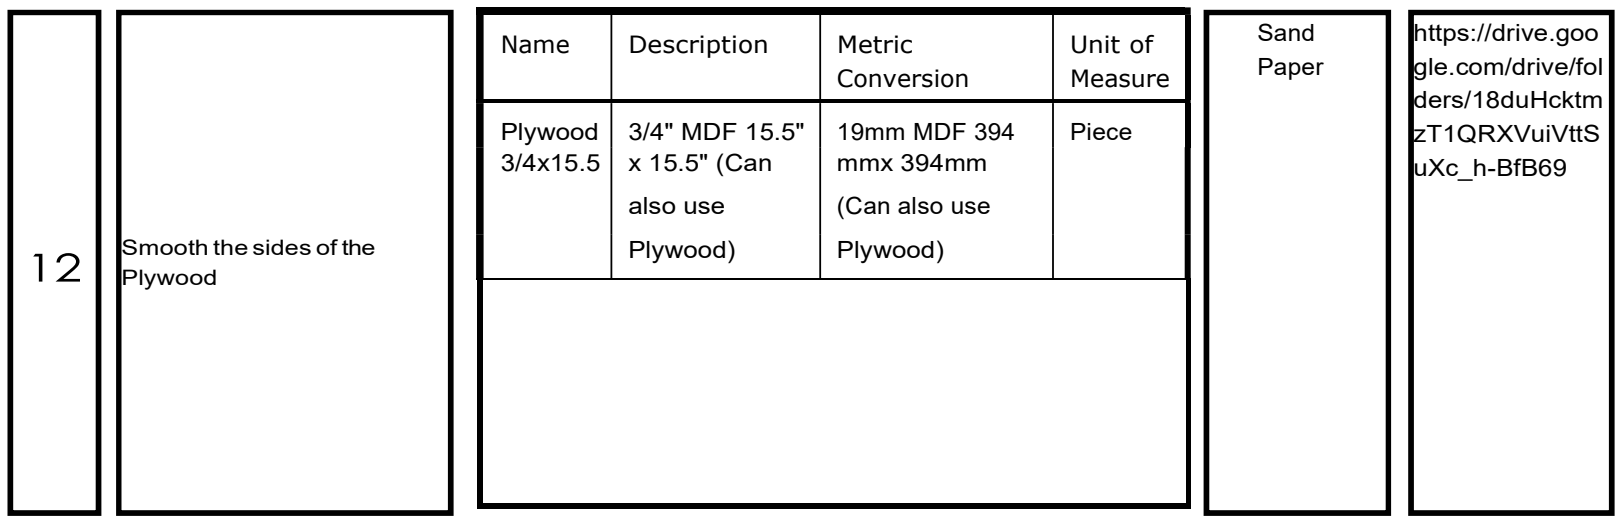
[picture p52: figure]
12 Smooth the sides of the Plywood; Name; Description; Metric; Conversion; Unit of Measure; Plywood; 3/4" MDF 15.5"; 19mm MDF 394; Piece; x 15.5" (Can; mmx 394mm; also use; (Can also use; Plywood); Sand Paper; https://drive.goo gle.com/drive/fol ders/18duHcktm zT1QRXVuiVttS uXc_h-BfB69

### Page 15 of 38

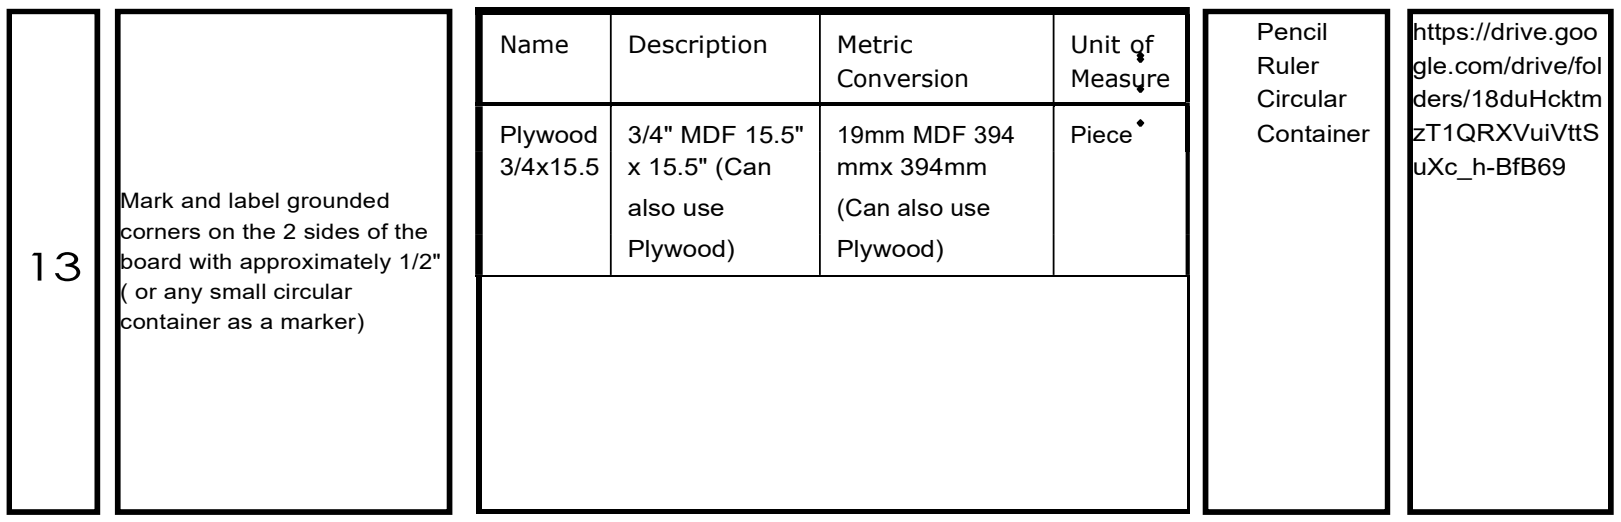
[picture p53: figure]
Mark and label grounded corners on the 2 sides of the board with approximately 1/2" ( or any small circular container as a marker); Name; Description; Metric; Conversion; Unit of Measure; Plywood; 3/4" MDF 15.5"; 19mm MDF 394; Piece; x 15.5" (Can; mmx 394mm; also use; (Can also use; Plywood); Pencil Ruler Circular Container; https://drive.goo gle.com/drive/fol ders/18duHcktm zT1QRXVuiVttS uXc_h-BfB69
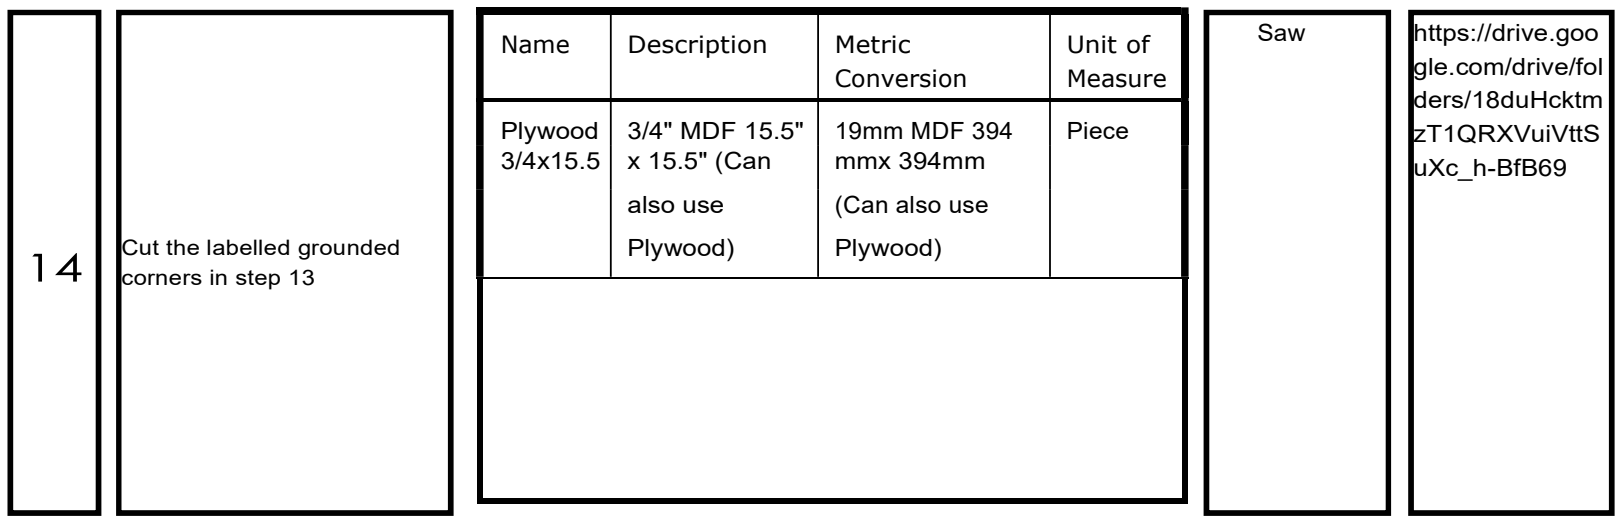
[picture p54: figure]
14 Cut the labelled grounded corners in step 13; Name; Description; Metric; Conversion; Unit of Measure; Plywood; 3/4" MDF 15.5"; 19mm MDF 394; Piece; x 15.5" (Can; mmx 394mm; also use; (Can also use; Plywood); Saw; https://drive.goo; gle.com/drive/fol ders/18duHcktm zT1QRXVuiVttS uXc_h-BfB69

### Page 16 of 38

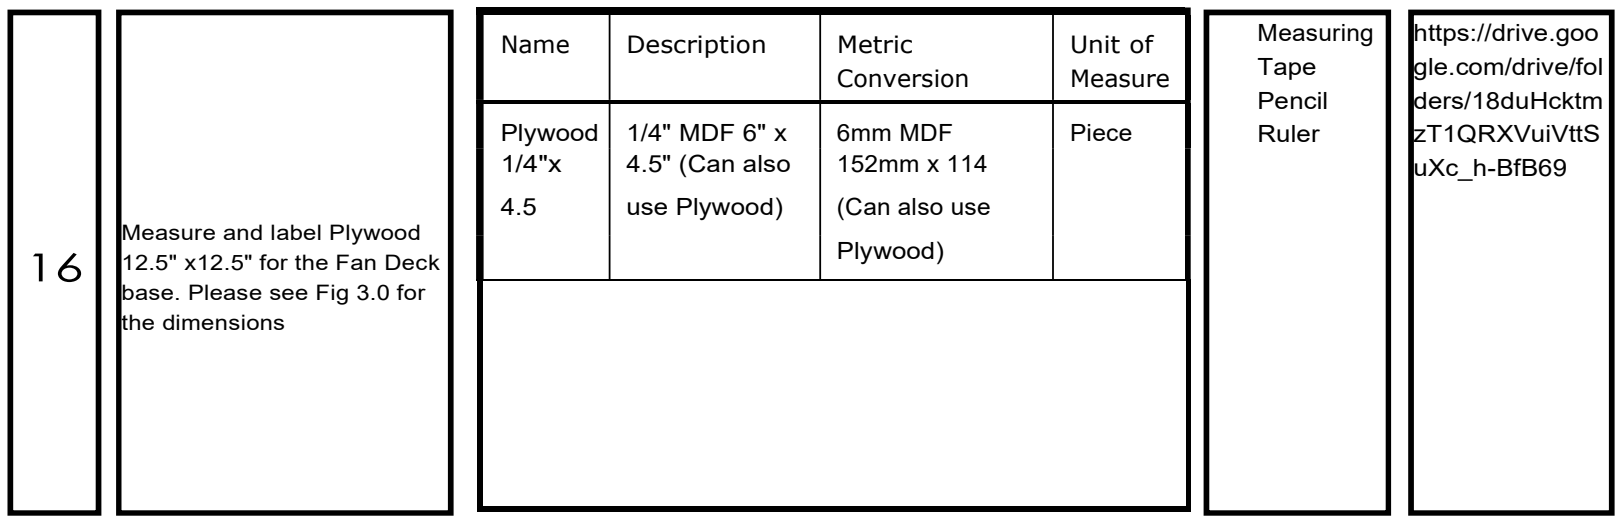
[picture p55: figure]
Measure and label Plywood 12.5" x12.5" for the Fan Deck base. Please see Fig 3.0 for the dimensions; Name; Description; Metric; Conversion; Unit of Measure; Plywood; 1/4" MDF 6" x; 6mm MDF; Piece; 4.5" (Can also; use Plywood); (Can also use; Plywood); Measuring Tape Pencil Ruler; https://drive.goo gle.com/drive/fol ders/18duHcktm zT1QRXVuiVttS uXc_h-BfB69

### Page 17 of 38

### 15 Smooth the newly Cut sides

Name | Description | Metric
| | Conversion | Unit of
| | | Measure
Plywood | 3/4" MDF 15.5" | 19mm MDF 394 | Piece
3/4x15.5 | x 15.5" (Can | mmx 394mm
| also use | (Can also use
| Plywood) | Plywood)

Sand
Paper

https://drive.goo
gle.com/drive/fol
ders/18duHcktm
zT1QRXVuiVttS
uXc_h-BfB69

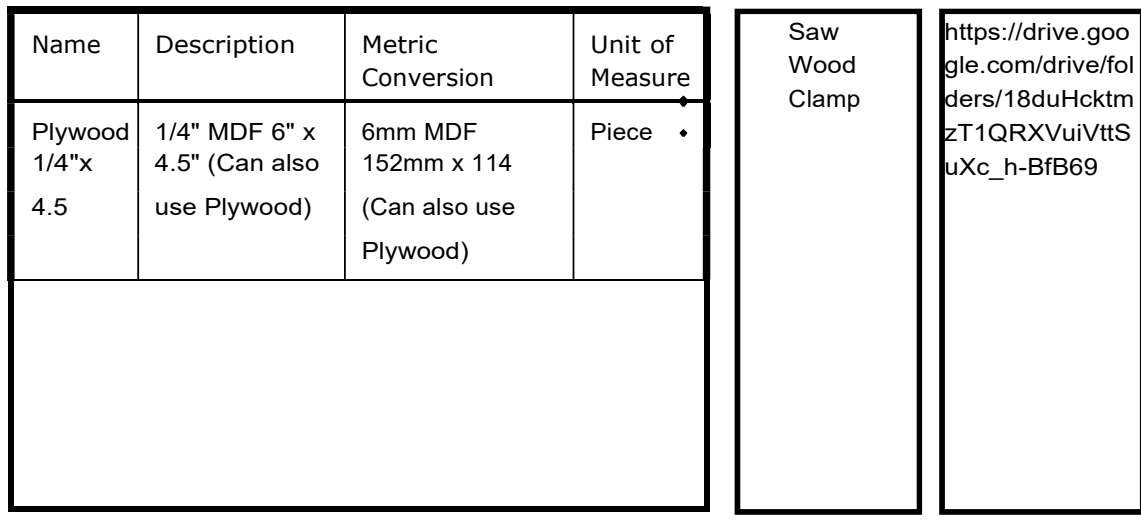
[picture p56: figure]
Name; Description; Metric; Conversion; Unit of Measure; Plywood; 1/4" MDF 6" x; 6mm MDF; Piece; 4.5" (Can also; use Plywood); (Can also use; Plywood); Saw Wood Clamp; https://drive.goo gle.com/drive/fol ders/18duHcktm zT1QRXVuiVttS uXc_h-BfB69

### Page 18 of 38

### 17 Cut as labelled in Step 16

### 18 Smooth the sides of the

Plywood

Name | Description | Metric
| | Conversion | Unit of
| | | Measure
Plywood | 1/4" MDF 6" x | 6mm MDF | Piece
1/4"x | 4.5" (Can also | 152mm x 114
4.5 | use Plywood) | (Can also use
| | Plywood)

Sand
Paper

https://drive.goo
gle.com/drive/fol
ders/18duHcktm
zT1QRXVuiVttS
uXc_h-BfB69

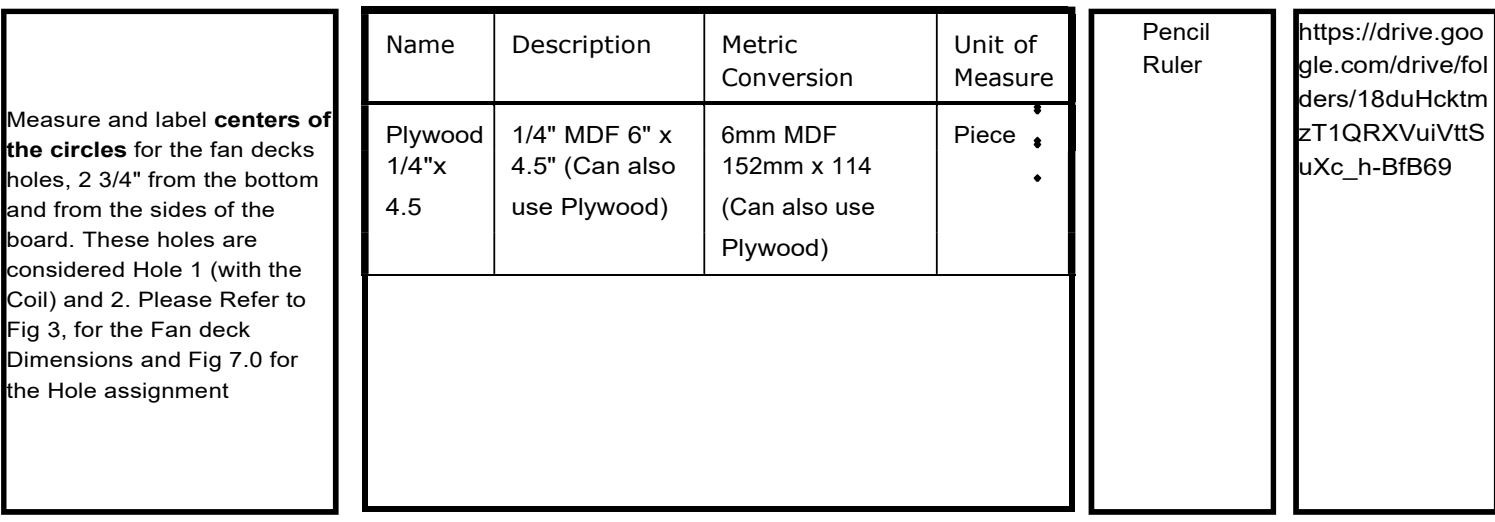
[picture p57: figure]
Measure and label centers of the circles for the fan decks holes, 2 3/4" from the bottom and from the sides of the board. These holes are considered Hole 1 (with the Coil) and 2. Please Refer to Fig 3, for the Fan deck Dimensions and Fig 7.0 for the Hole assignment; Name; Description; Metric; Conversion; Unit of Measure; Plywood; 1/4" MDF 6" x; 6mm MDF; Piece; 4.5" (Can also; use Plywood); (Can also use; Plywood); Pencil Ruler; https://drive.goo gle.com/drive/fol ders/18duHcktm zT1QRXVuiVttS uXc_h-BfB69
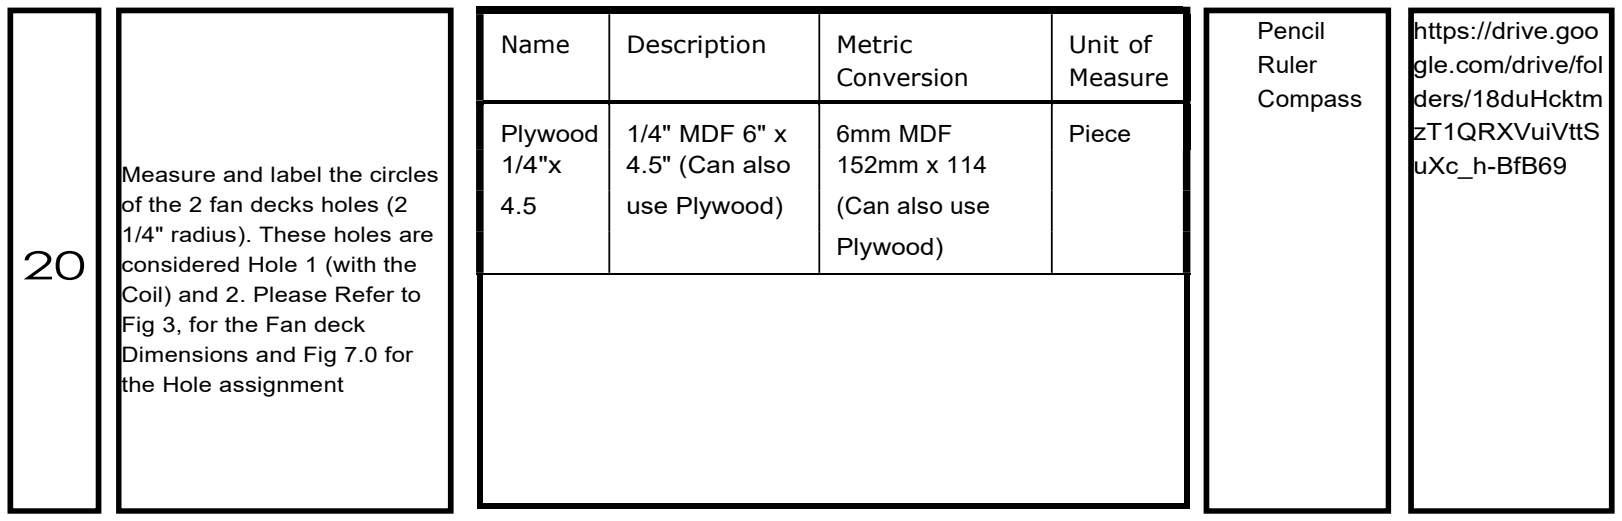
[picture p58: figure]
Measure and label the circles of the 2 fan decks holes (2 1/4" radius). These holes are considered Hole 1 (with the Coil) and 2. Please Refer to Fig 3, for the Fan deck Dimensions and Fig 7.0 for the Hole assignment; Name; Description; Metric; Conversion; Unit of Measure; Plywood; 1/4" MDF 6" x; 6mm MDF; Piece; 4.5" (Can also; use Plywood); (Can also use; Plywood); Pencil Ruler Compass; https://drive.goo gle.com/drive/fol ders/18duHcktm zT1QRXVuiVttS uXc_h-BfB69

### Page 19 of 38

19

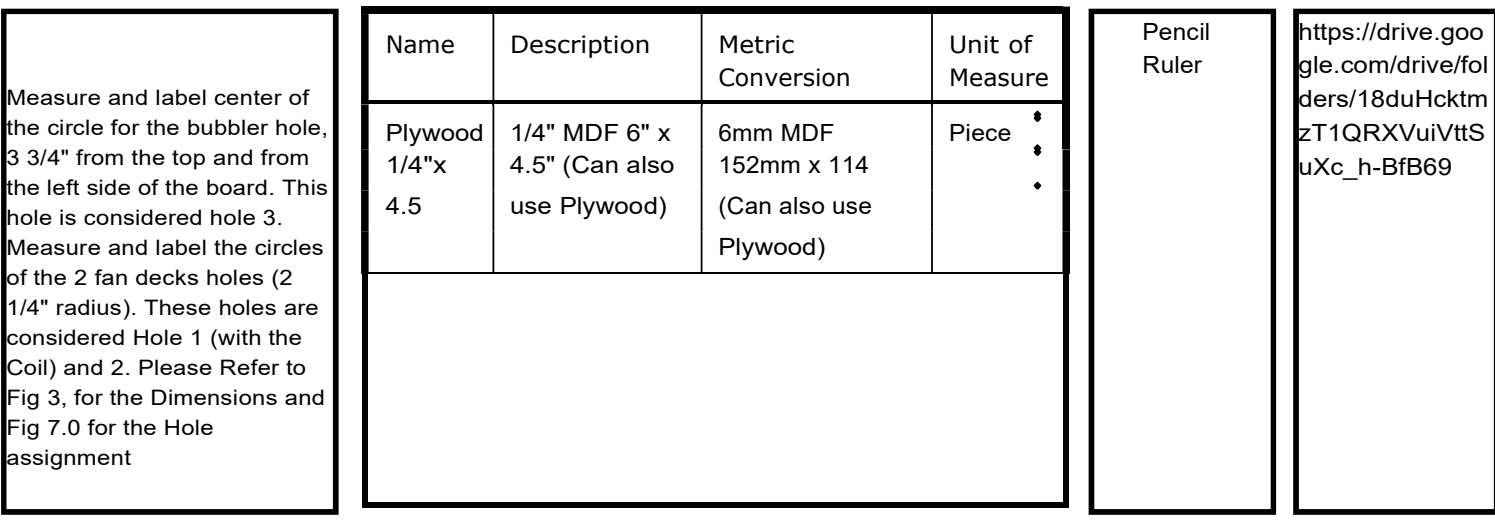
[picture p59: figure]
Measure and label center of the circle for the bubbler hole, 3 3/4" from the top and from the left side of the board. This hole is considered hole 3. Measure and label the circles of the 2 fan decks holes (2 1/4" radius). These holes are considered Hole 1 (with the Coil) and 2. Please Refer to Fig 3, for the Dimensions and Fig 7.0 for the Hole assignment; Name; Description; Metric; Conversion; Unit of Measure; Plywood; 1/4" MDF 6" x; 6mm MDF; Piece; 4.5" (Can also; use Plywood); (Can also use; Plywood); Pencil Ruler; https://drive.goo gle.com/drive/fol ders/18duHcktm zT1QRXVuiVttS uXc_h-BfB69
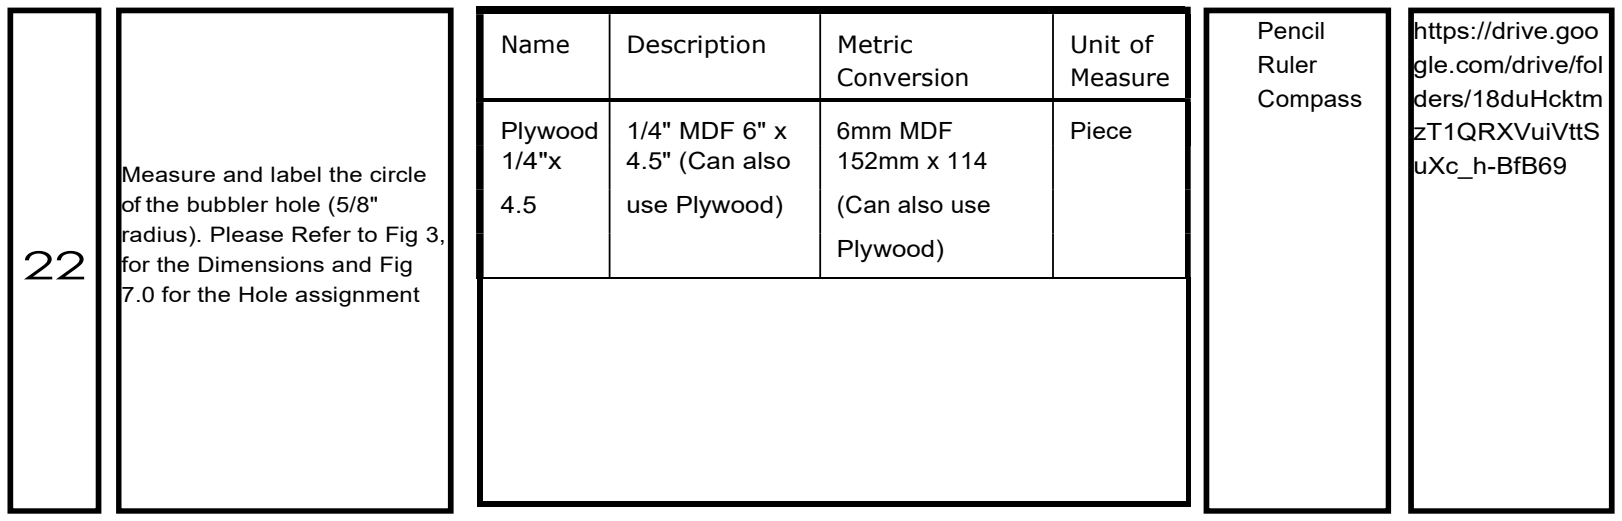
[picture p60: figure]
Measure and label the circle of the bubbler hole (5/8" radius). Please Refer to Fig 3, for the Dimensions and Fig 7.0 for the Hole assignment; Name; Description; Metric; Conversion; Unit of Measure; Plywood; 1/4" MDF 6" x; 6mm MDF; Piece; 4.5" (Can also; use Plywood); (Can also use; Plywood); Pencil Ruler Compass; https://drive.goo gle.com/drive/fol ders/18duHcktm zT1QRXVuiVttS uXc_h-BfB69

### Page 20 of 38

21

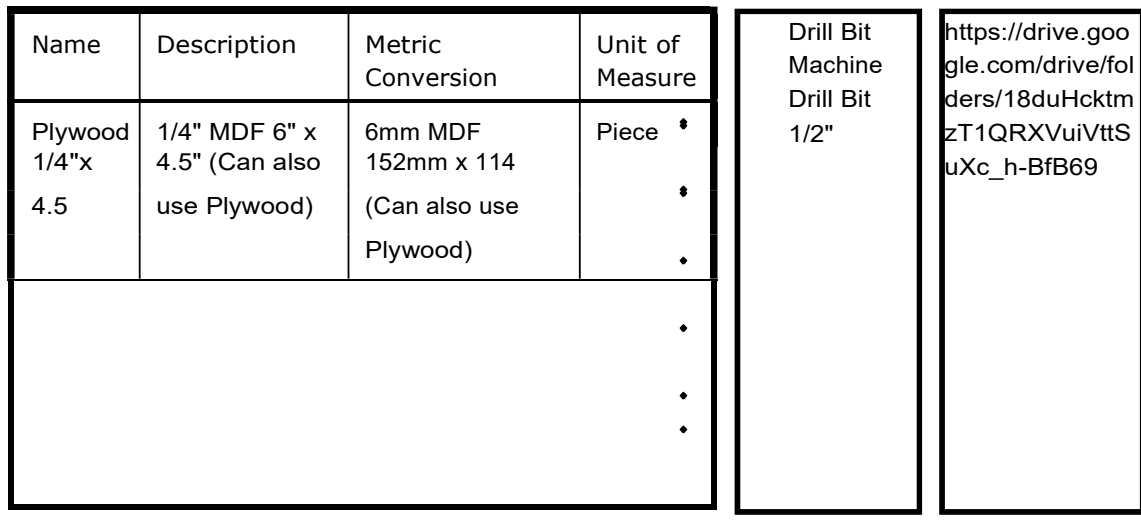
[picture p61: figure]
Name; Description; Metric; Conversion; Unit of Measure; Plywood; 1/4" MDF 6" x; 6mm MDF; Piece; 4.5" (Can also; use Plywood); (Can also use; Plywood); Drill Bit Machine Drill Bit 1/2"; https://drive.goo gle.com/drive/fol ders/18duHcktm zT1QRXVuiVttS uXc_h-BfB69
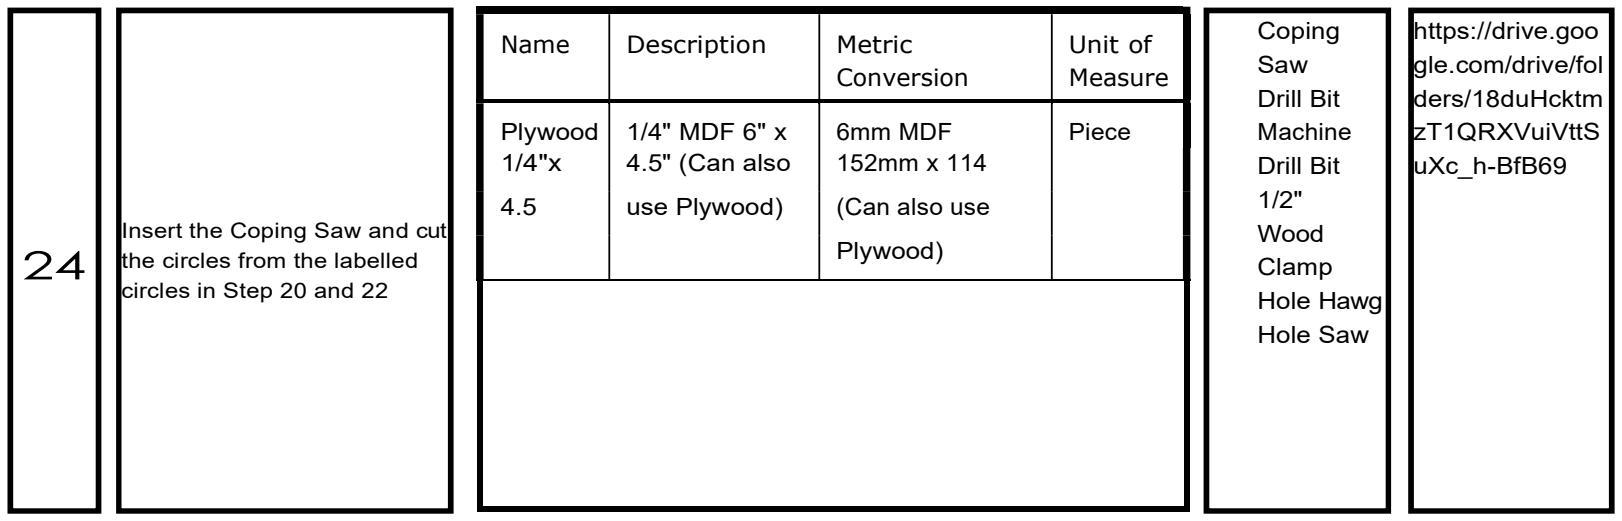
[picture p62: figure]
Insert the Coping Saw and cut the circles from the labelled circles in Step 20 and 22; Name; Description; Metric; Conversion; Unit of Measure; Plywood; 1/4" MDF 6" x; 6mm MDF; Piece; 4.5" (Can also; use Plywood); (Can also use; Plywood); Coping Saw Drill Bit Machine Drill Bit 1/2" Wood Clamp Hole Hawg Hole Saw; https://drive.goo gle.com/drive/fol ders/18duHcktm zT1QRXVuiVttS uXc_h-BfB69

### Page 21 of 38

### 23 Drill one hole inside the circles

of the fan deck and Bubbler

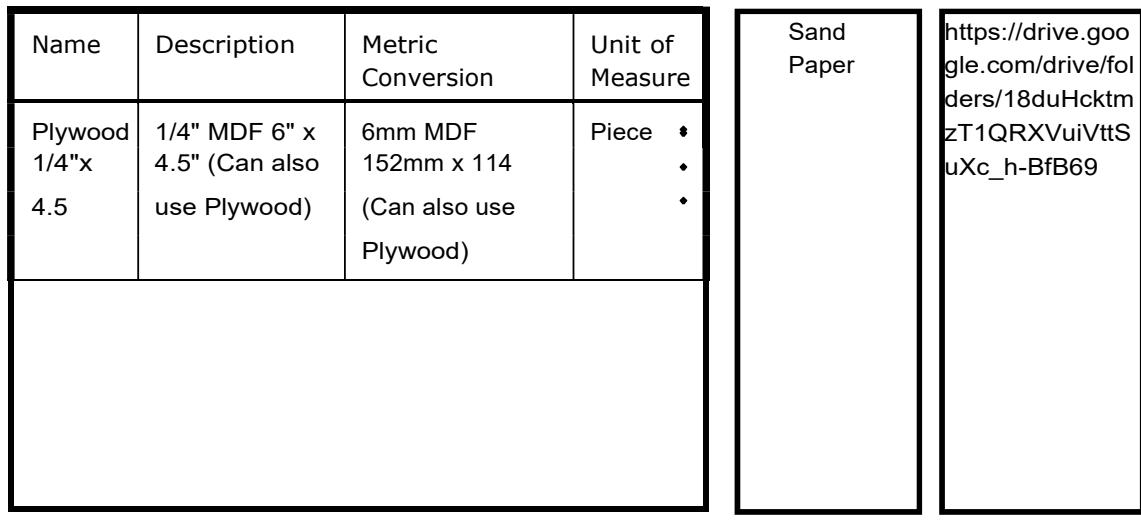
[picture p63: figure]
Name; Description; Metric; Conversion; Unit of Measure; Plywood; 1/4" MDF 6" x; 6mm MDF; Piece; 4.5" (Can also; use Plywood); (Can also use; Plywood); Sand Paper; https://drive.goo gle.com/drive/fol ders/18duHcktm zT1QRXVuiVttS uXc_h-BfB69
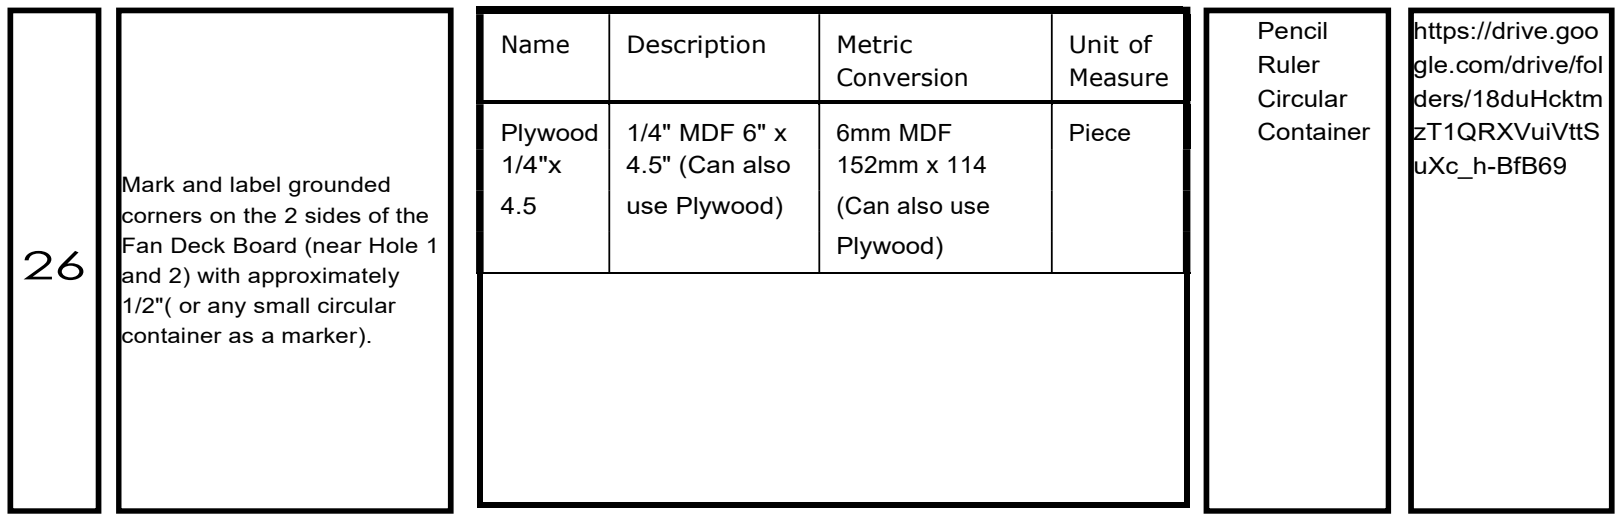
[picture p64: figure]
Mark and label grounded corners on the 2 sides of the Fan Deck Board (near Hole 1 and 2) with approximately 1/2"( or any small circular container as a marker).; Name; Description; Metric; Conversion; Unit of Measure; Plywood; 1/4" MDF 6" x; 6mm MDF; Piece; 4.5" (Can also; use Plywood); (Can also use; Plywood); Pencil Ruler Circular Container; https://drive.goo gle.com/drive/fol ders/18duHcktm zT1QRXVuiVttS uXc_h-BfB69

### Page 22 of 38

### 25 Smooth the newly Cut circles

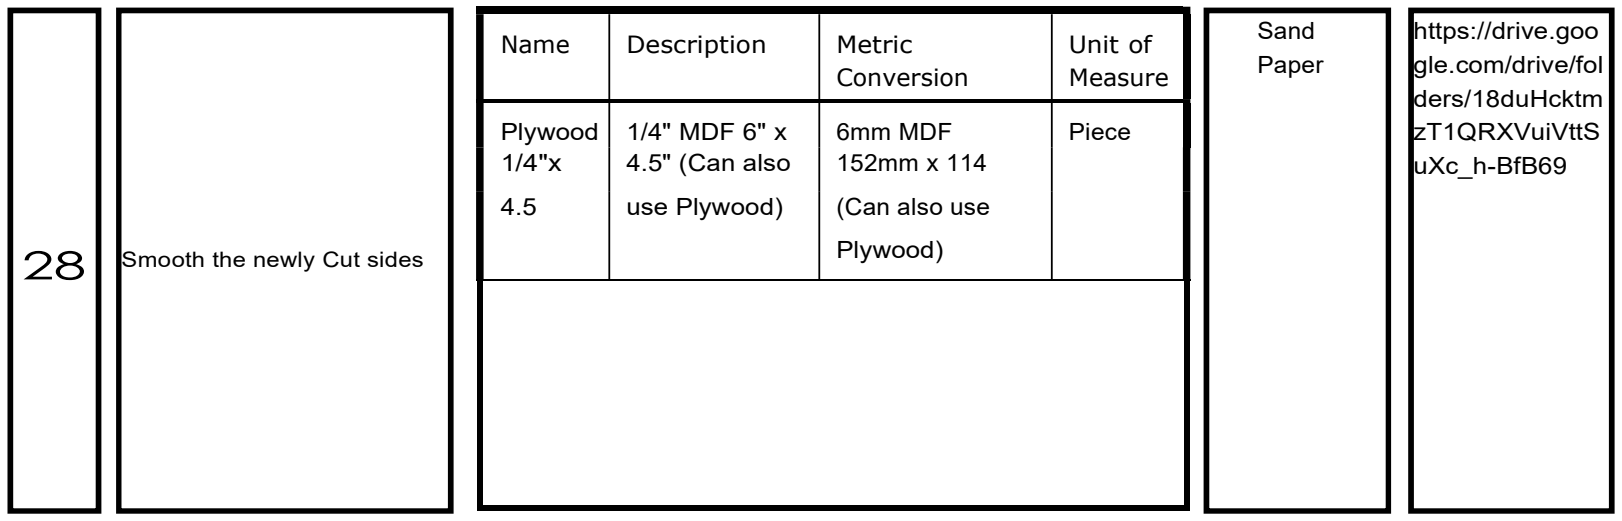
[picture p65: figure]
28 Smooth the newly Cut sides; Name; Description; Metric; Conversion; Unit of Measure; Plywood; 1/4" MDF 6" x; 6mm MDF; Piece; 4.5" (Can also; use Plywood); (Can also use; Plywood); Sand Paper; https://drive.goo gle.com/drive/fol ders/18duHcktm zT1QRXVuiVttS uXc_h-BfB69

### Page 23 of 38

### 27 Cut the labelled grounded

corners in step 26

Name | Description | Metric
| | Conversion | Unit of
| | | Measure
Plywood | 1/4" MDF 6" x | 6mm MDF | Piece
1/4"x | 4.5" (Can also | 152mm x 114
4.5 | use Plywood) | (Can also use
| | Plywood)
Saw | https://drive.goo gle.com/drive/fol ders/18duHcktm zT1QRXVuiVttS uXc_h-BfB69

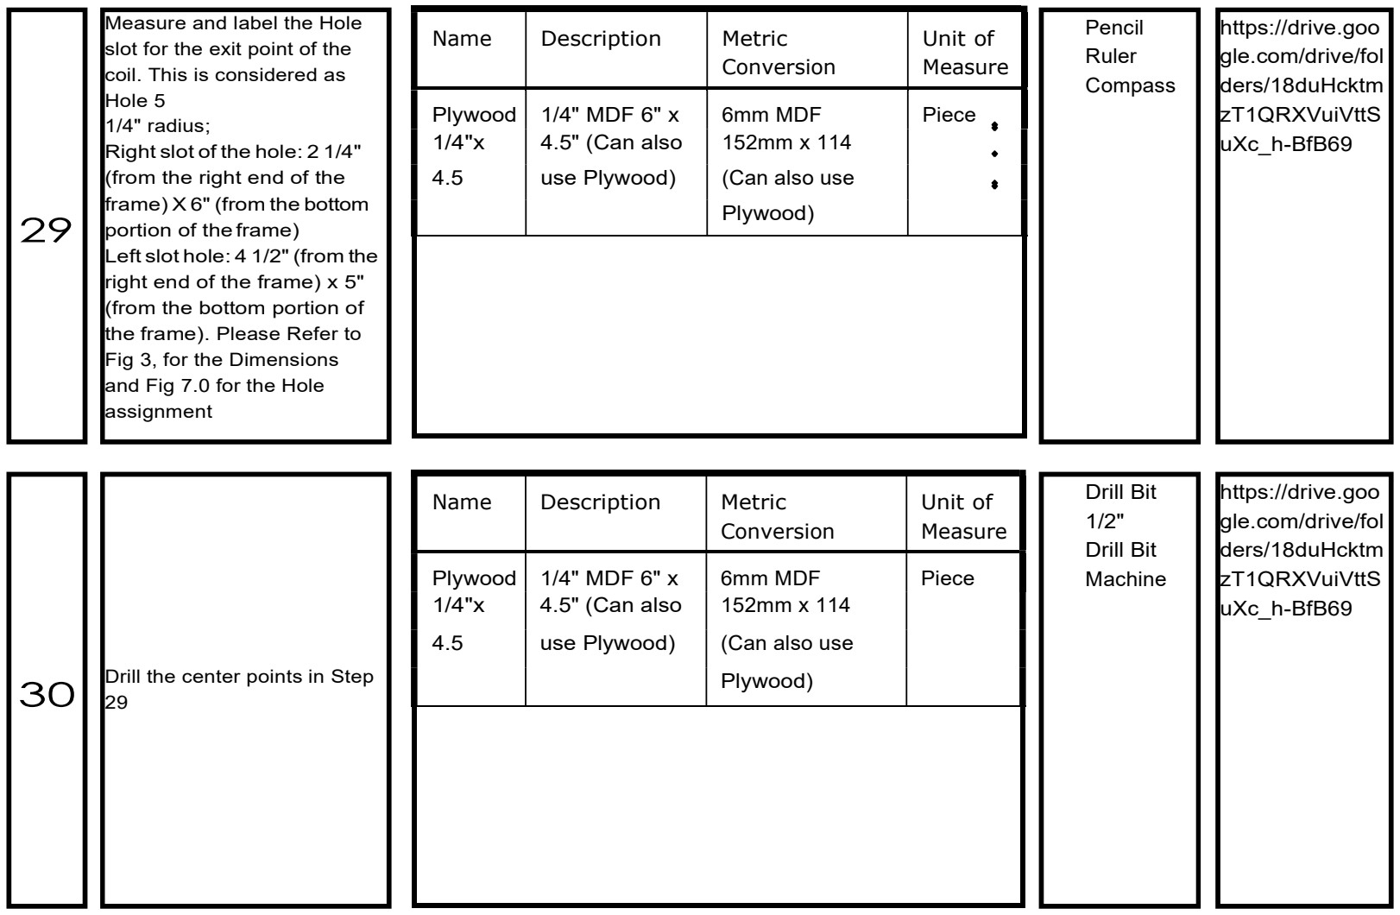
[picture p66: figure]
Measure and label the Hole slot for the exit point of the coil. This is considered as Hole 5 1/4" radius; Right slot of the hole: 2 1/4" (from the right end of the frame) X 6" (from the bottom portion of the frame) Left slot hole: 4 1/2" (from the right end of the frame) x 5" (from the bottom portion of the frame). Please Refer to Fig 3, for the Dimensions and Fig 7.0 for the Hole assignment; Name; Description; Metric; Conversion; Unit of Measure; Plywood; 1/4" MDF 6" x; 6mm MDF; Piece; 4.5" (Can also; use Plywood); (Can also use; Plywood); Pencil Ruler Compass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

### Page 24 of 38

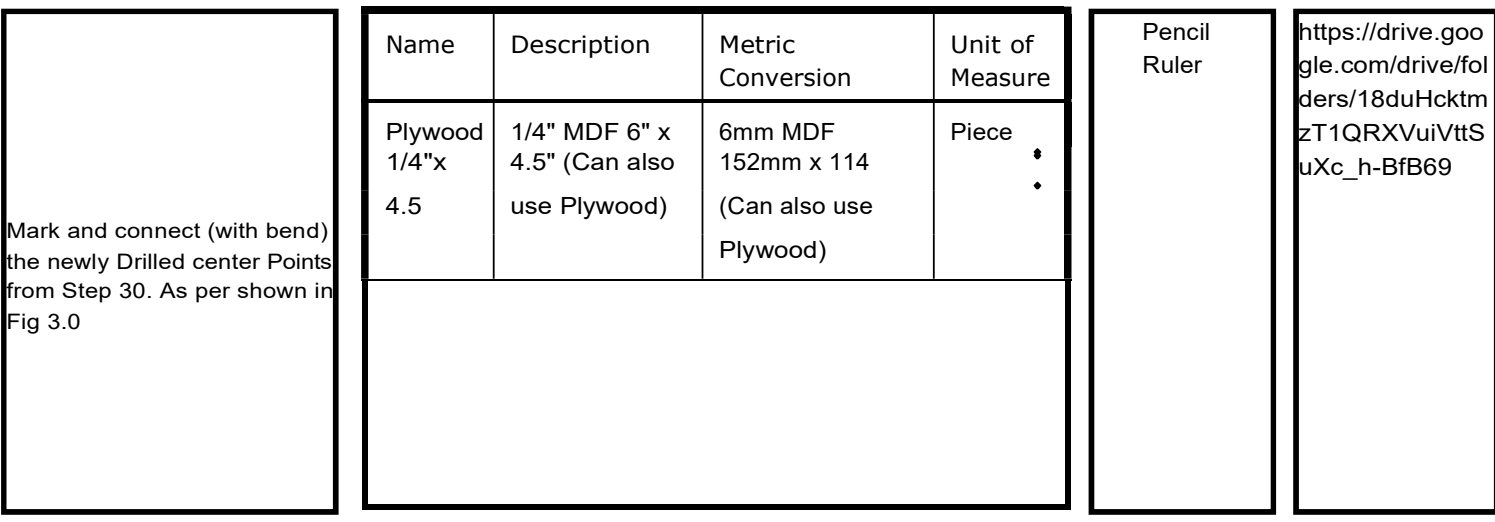
[picture p67: figure]
Mark and connect (with bend) the newly Drilled center Points from Step 30. As per shown in Fig 3.0; Name; Description; Metric; Conversion; Unit of Measure; Plywood; 1/4" MDF 6" x; 6mm MDF; Piece; 4.5" (Can also; use Plywood); (Can also use; Plywood); Pencil Ruler; https://drive.goo gle.com/drive/fol ders/18duHcktm zT1QRXVuiVttS uXc_h-BfB69

### Page 25 of 38

31

### 32 Cut as labelled in Step 31

Name | Description | Metric
| | Conversion | Unit of
| | | Measure
Plywood | 1/4" MDF 6" x | 6mm MDF | Piece
1/4"x | 4.5" (Can also | 152mm x 114
4.5 | use Plywood) | (Can also use
| | Plywood)

Coping
Saw

https://drive.goo
gle.com/drive/fol
ders/18duHcktm
zT1QRXVuiVttS
uXc_h-BfB69

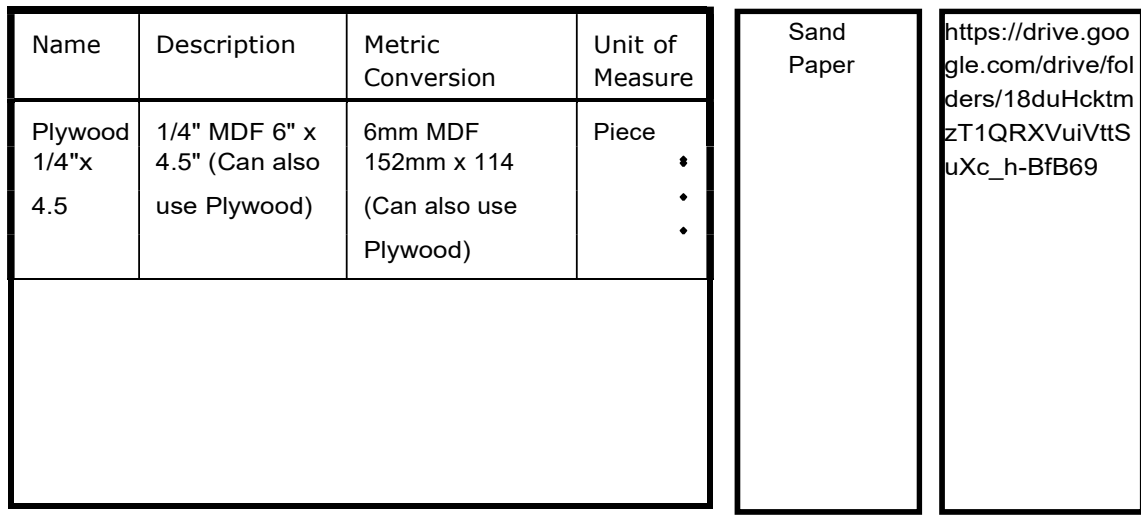
[picture p68: figure]
Name; Description; Metric; Conversion; Unit of Measure; Plywood; 1/4" MDF 6" x; 6mm MDF; Piece; 4.5" (Can also; use Plywood); (Can also use; Plywood); Sand Paper; https://drive.goo gle.com/drive/fol ders/18duHcktm zT1QRXVuiVttS uXc_h-BfB69
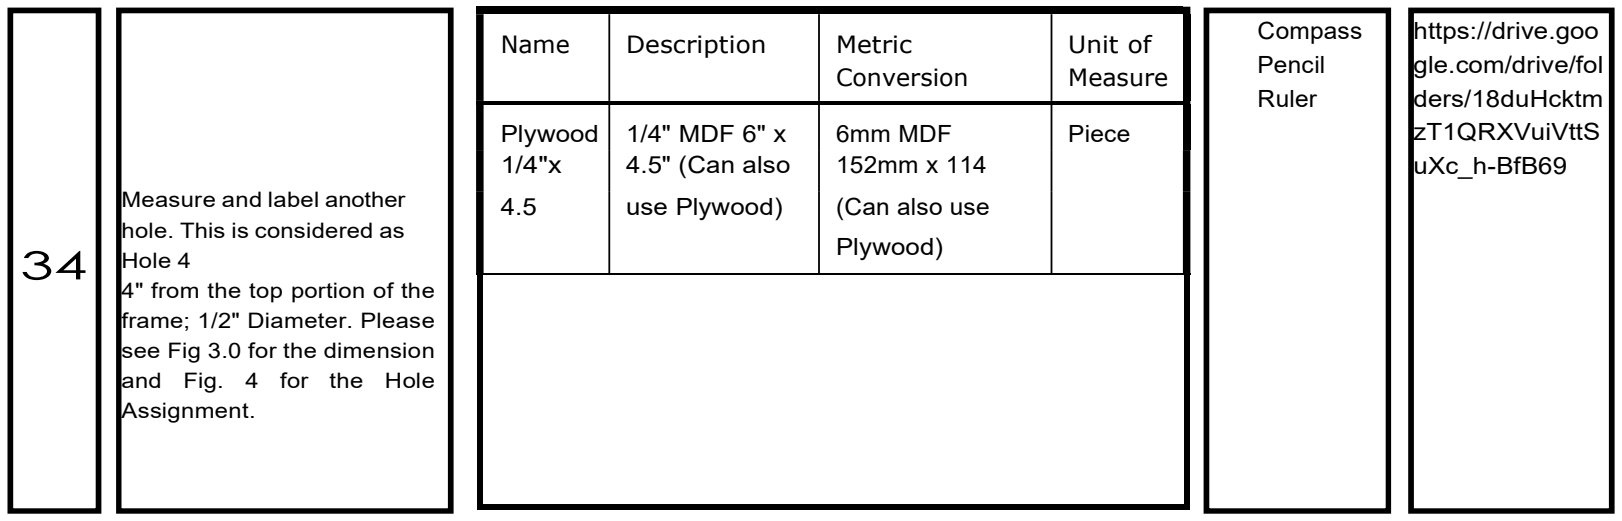
[picture p69: figure]
Measure and label another hole. This is considered as Hole 4 4" from the top portion of the frame; 1/2" Diameter. Please see Fig 3.0 for the dimension and Fig. 4 for the Hole Assignment.; Name; Description; Metric; Conversion; Unit of Measure; Plywood; 1/4" MDF 6" x; 6mm MDF; Piece; 4.5" (Can also; use Plywood); (Can also use; Plywood); Compass Pencil Ruler; https://drive.goo gle.com/drive/fol ders/18duHcktm zT1QRXVuiVttS uXc_h-BfB69

### Page 26 of 38

### 33 Smooth the newly Cut sides

### Page 27 of 38

### 35 Cut as labelled in Step 34

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

Coping
Saw

https://drive.goo
gle.com/drive/fol
ders/18duHcktm
zT1QRXVuiVttS
uXc_h-BfB69

### 36 Smooth the newly slots

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

Sand
Paper

https://drive.goo
gle.com/drive/fol
ders/18duHcktm
zT1QRXVuiVttS
uXc_h-BfB69

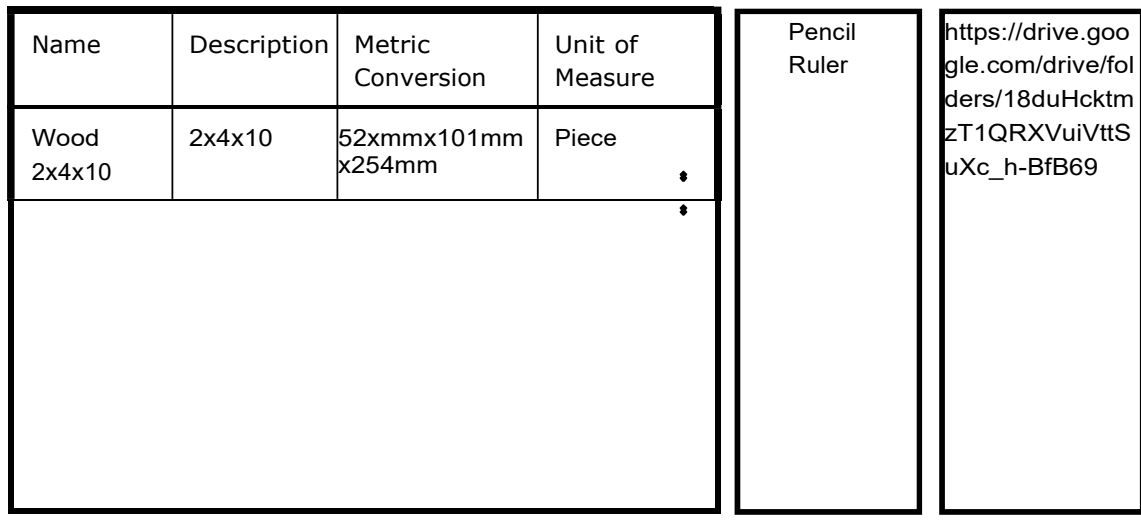
[picture p70: figure]
Name; Description; Metric; Conversion; Unit of Measure; Wood 2x4x10; 52xmmx101mm; Piece; Pencil Ruler; https://drive.goo gle.com/drive/fol ders/18duHcktm zT1QRXVuiVttS uXc_h-BfB69
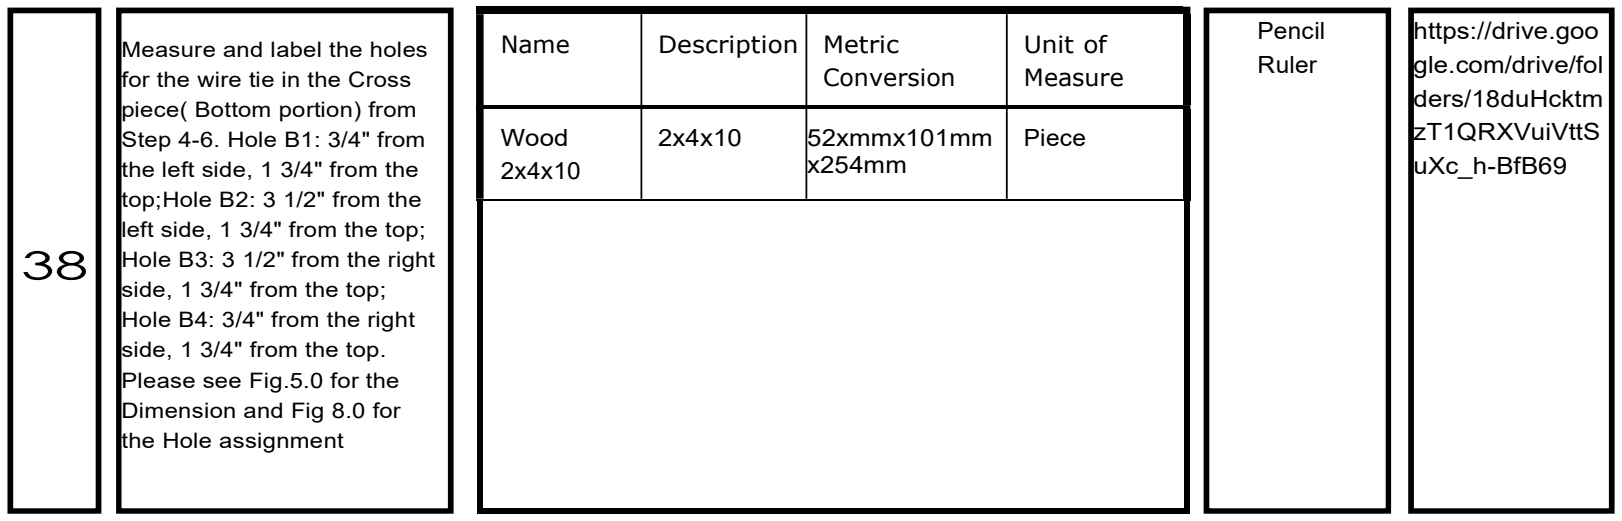
[picture p71: figure]
Measure and label the holes for the wire tie in the Cross piece( Bottom portion) from Step 4-6. Hole B1: 3/4" from the left side, 1 3/4" from the top;Hole B2: 3 1/2" from the left side, 1 3/4" from the top; Hole B3: 3 1/2" from the right side, 1 3/4" from the top; Hole B4: 3/4" from the right side, 1 3/4" from the top. Please see Fig.5.0 for the Dimension and Fig 8.0 for the Hole assignment; Name; Description; Metric; Conversion; Unit of Measure; Wood 2x4x10; 52xmmx101mm; Piece; Pencil Ruler; https://drive.goo gle.com/drive/fol ders/18duHcktm zT1QRXVuiVttS uXc_h-BfB69

### Page 28 of 38

37

Measure and Label the holes for the wire tie in the Cross piece (middle portion) from Step 4-6. Hole A1: 3/4" from the left side, 1 3/4" from the top; HoleA2: 3 1/2" from the left side, 1 3/4" from the top; Hole A3: 4 3/4" from the left side, 1 3/4" from the top; Hole A4: 4 3/4" from the right side, 1 3/4" from the top; Hole A5: 3 1/2" from the right side, 1 3/4" from the top; Hole A6: 3/4" from the right side, 1 3/4" from the top Please see Fig.5.0 for the Dimension and Fig 8.0 for the Hole assignment

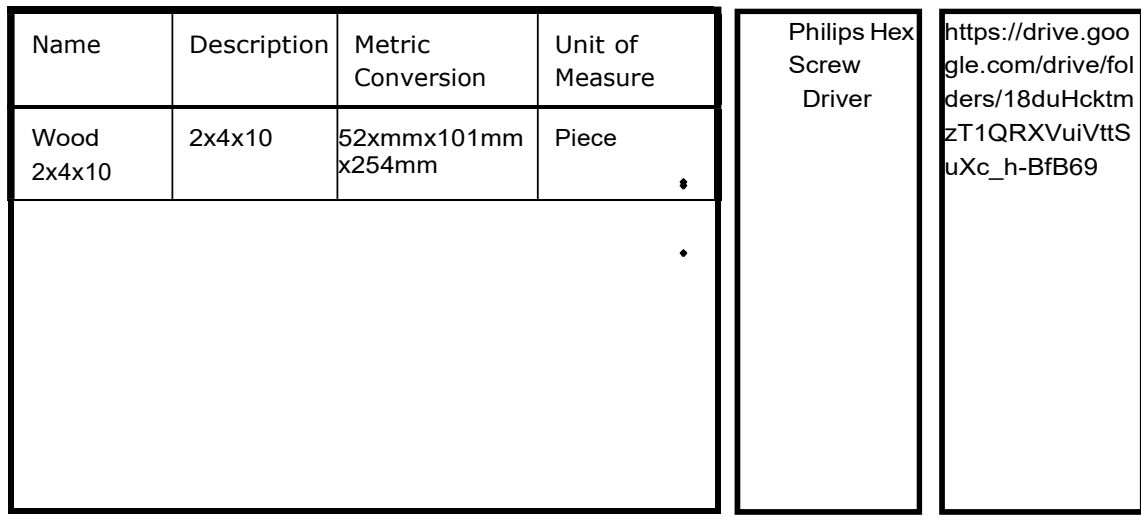
[picture p72: figure]
Name; Description; Metric; Conversion; Unit of Measure; Wood 2x4x10; 52xmmx101mm; Piece; Philips Hex Screw Driver; https://drive.goo gle.com/drive/fol ders/18duHcktm zT1QRXVuiVttS uXc_h-BfB69
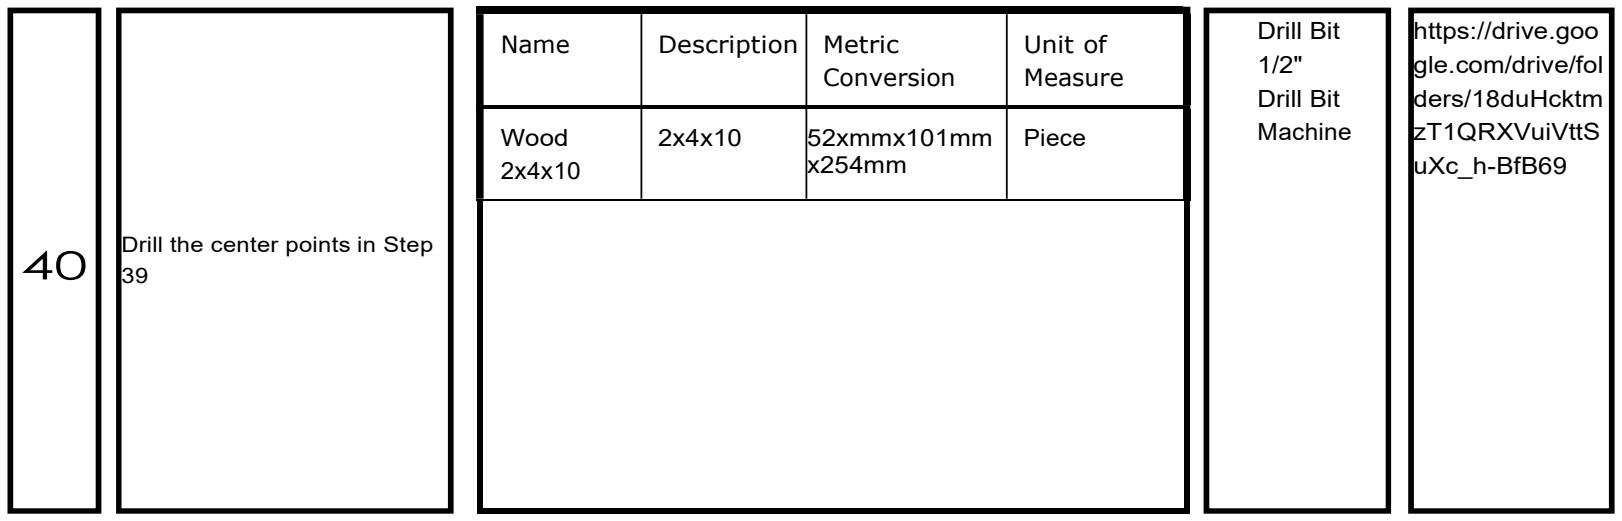
[picture p73: figure]
40 Drill the center points in Step 39; Name; Description; Metric; Conversion; Unit of Measure; Wood 2x4x10; 52xmmx101mm; Piece; Drill Bit 1/2" Drill Bit Machine; https://drive.goo gle.com/drive/fol ders/18duHcktm zT1QRXVuiVttS uXc_h-BfB69

### Page 29 of 38

### 39 Punch all Marked holes in step 36 and 37

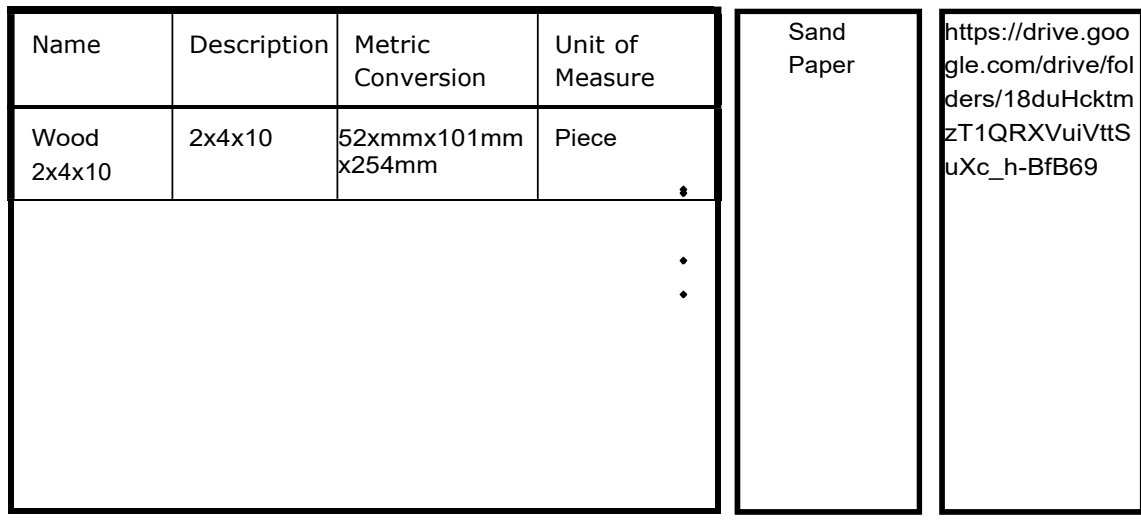
[picture p74: figure]
Name; Description; Metric; Conversion; Unit of Measure; Wood 2x4x10; 52xmmx101mm; Piece; Sand Paper; https://drive.goo gle.com/drive/fol ders/18duHcktm zT1QRXVuiVttS uXc_h-BfB69
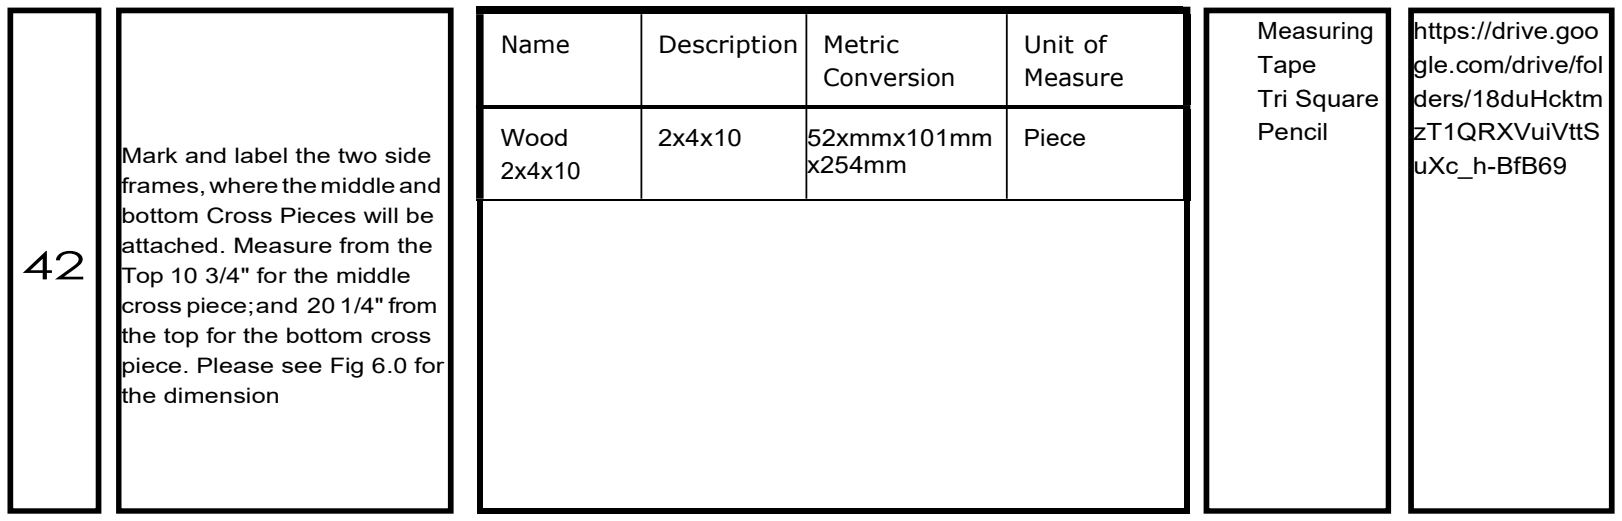
[picture p75: figure]
Mark and label the two side frames, where the middle and bottom Cross Pieces will be attached. Measure from the Top 10 3/4" for the middle cross piece; and 20 1/4" from the top for the bottom cross piece. Please see Fig 6.0 for the dimension; Name; Description; Metric; Conversion; Unit of Measure; Wood 2x4x10; 52xmmx101mm; Piece; Measuring Tape Tri Square Pencil; https://drive.goo gle.com/drive/fol ders/18duHcktm zT1QRXVuiVttS uXc_h-BfB69

### Page 30 of 38

### 41 Smooth the holes

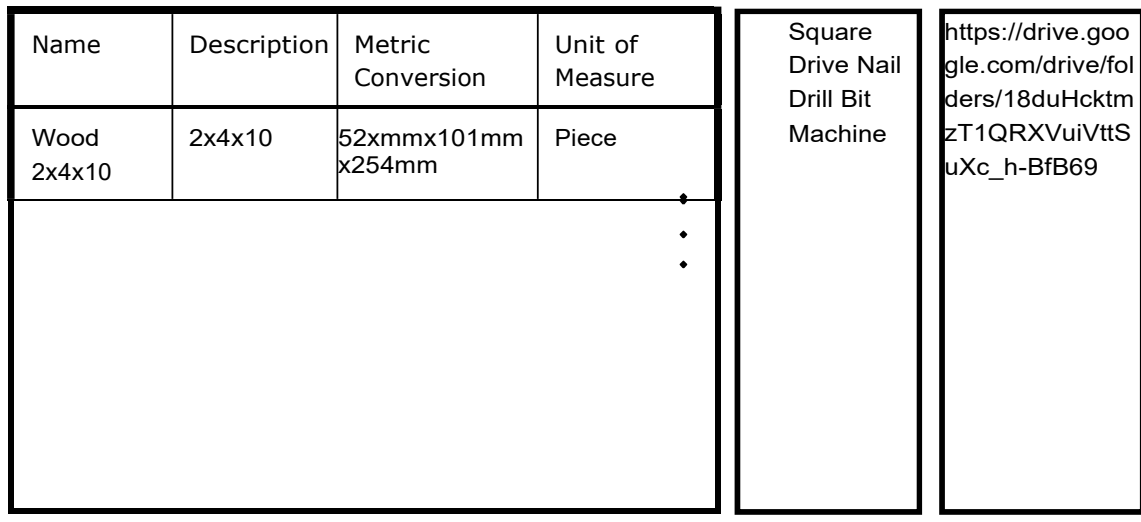
[picture p76: figure]
Name; Description; Metric; Conversion; Unit of Measure; Wood 2x4x10; 52xmmx101mm; Piece; Square Drive Nail Drill Bit Machine; https://drive.goo gle.com/drive/fol ders/18duHcktm zT1QRXVuiVttS uXc_h-BfB69
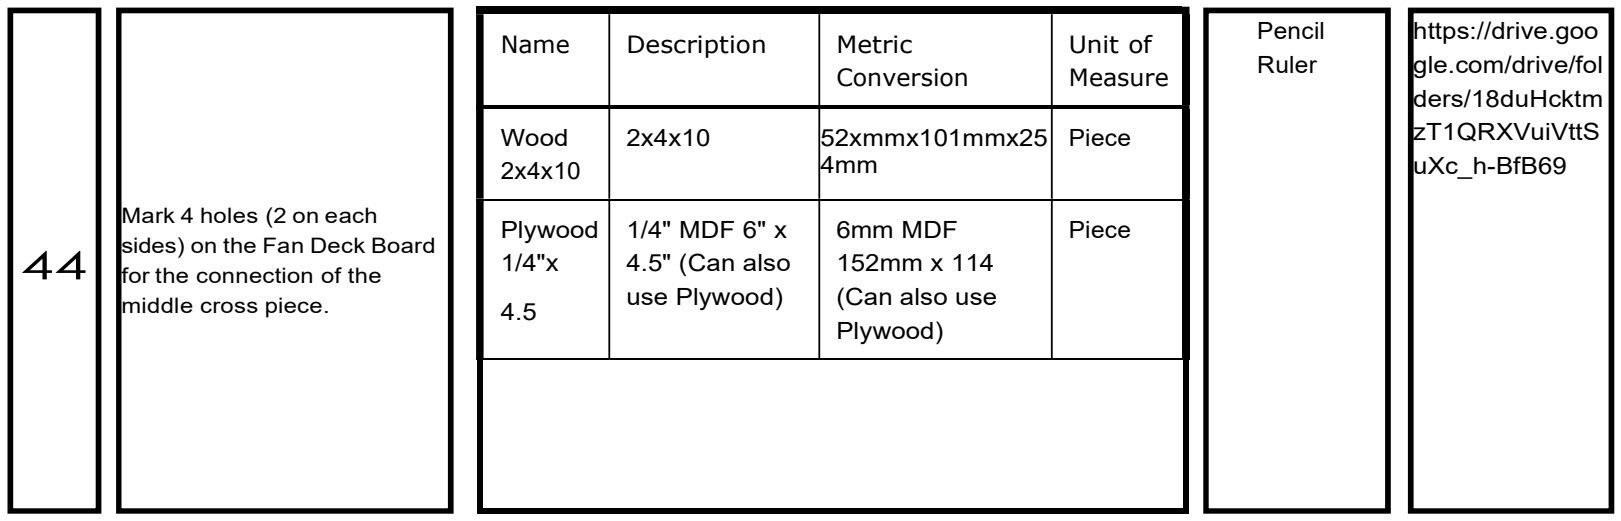
[picture p77: figure]
Mark 4 holes (2 on each sides) on the Fan Deck Board for the connection of the middle cross piece.; Name; Description; Metric; Conversion; Unit of Measure; Wood 2x4x10; 52xmmx101mmx25 4mm; Piece; Pencil Ruler; https://drive.goo gle.com/drive/fol ders/18duHcktm zT1QRXVuiVttS uXc_h-BfB69

### Page 31 of 38

43

Connect the top Cross Piece with the Side frame (one side only). Ensure the Cross piece is horizontally positioned. Place 2 nails to hold the cross piece in place

Plywood 1/4"x 4.5 | 1/4" MDF 6" x 4.5" (Can also use Plywood) | 6mm MDF 152mm x 114 (Can also use Plywood)

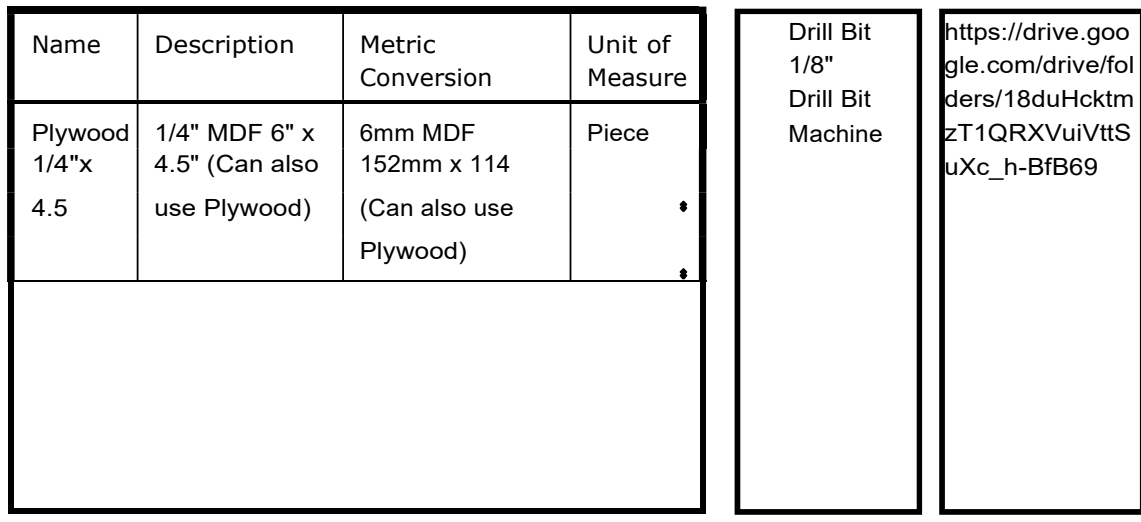
[picture p78: figure]
Name; Description; Metric; Conversion; Unit of Measure; Plywood; 1/4" MDF 6" x; 6mm MDF; Piece; 4.5" (Can also; use Plywood); (Can also use; Plywood); Drill Bit 1/8" Drill Bit Machine; https://drive.goo gle.com/drive/fol ders/18duHcktm zT1QRXVuiVttS uXc_h-BfB69
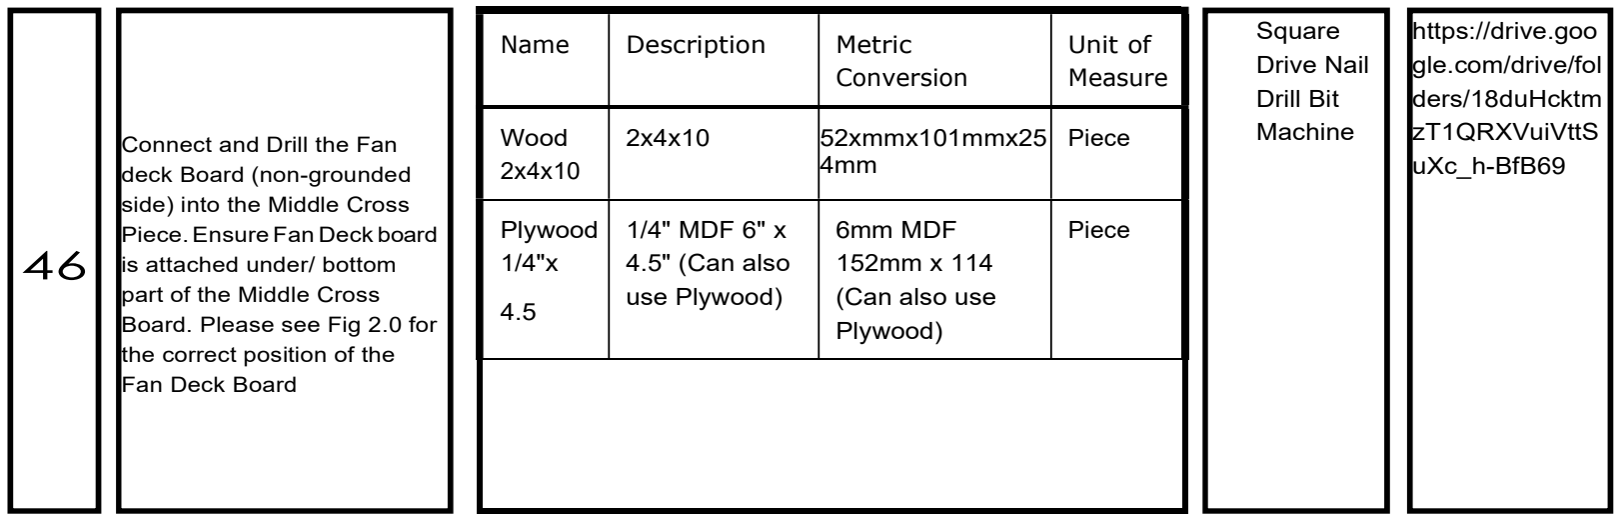
[picture p79: figure]
Connect and Drill the Fan deck Board (non-grounded side) into the Middle Cross Piece. Ensure Fan Deck board is attached under/ bottom part of the Middle Cross Board. Please see Fig 2.0 for the correct position of the Fan Deck Board; Name; Description; Metric; Conversion; Unit of Measure; Wood 2x4x10; 52xmmx101mmx25 4mm; Piece; Square Drive Nail Drill Bit Machine; https://drive.goo gle.com/drive/fol ders/18duHcktm zT1QRXVuiVttS uXc_h-BfB69

### Page 32 of 38

### 45 Pre Drill the Marked holes

from Step 44

Plywood 1/4"x 4.5 | 1/4" MDF 6" x 4.5" (Can also use Plywood) | 6mm MDF 152mm x 114 (Can also use Plywood)

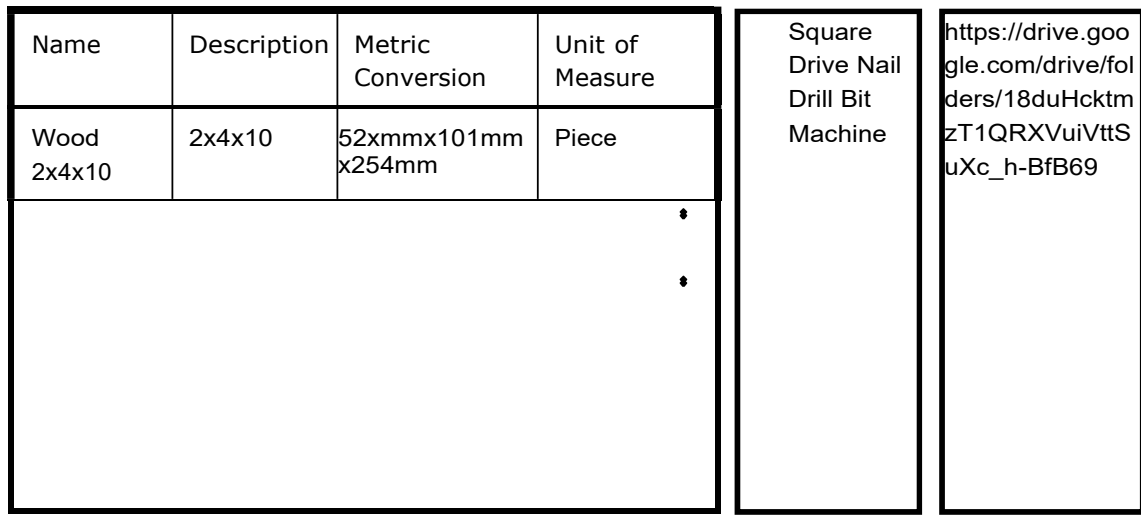
[picture p80: figure]
Name; Description; Metric; Conversion; Unit of Measure; Wood 2x4x10; 52xmmx101mm; Piece; Square Drive Nail Drill Bit Machine; https://drive.goo gle.com/drive/fol ders/18duHcktm zT1QRXVuiVttS uXc_h-BfB69
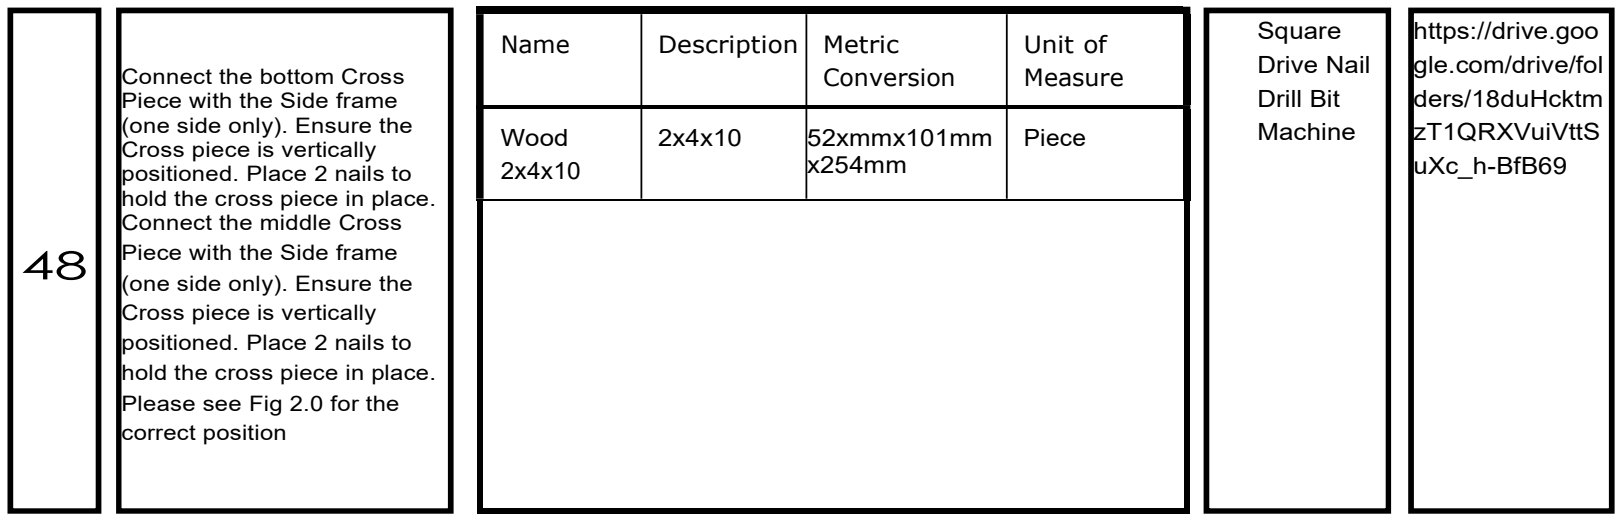
[picture p81: figure]
Connect the bottom Cross Piece with the Side frame (one side only). Ensure the Cross piece is vertically positioned. Place 2 nails to hold the cross piece in place. Connect the middle Cross Piece with the Side frame (one side only). Ensure the Cross piece is vertically positioned. Place 2 nails to hold the cross piece in place. Please see Fig 2.0 for the correct position; Name; Description; Metric; Conversion; Unit of Measure; Wood 2x4x10; 52xmmx101mm; Piece; Square Drive Nail Drill Bit Machine; https://drive.goo gle.com/drive/fol ders/18duHcktm zT1QRXVuiVttS uXc_h-BfB69

### Page 33 of 38

47

Connect the middle Cross
Piece with the Side frame
(one side only). Ensure the Cross piece is vertically
positioned. Place 2 nails to hold the cross piece in place. Please see Fig 2.0 for the correct position

### Page 34 of 38

49

Connect the Side Frame( 2nd side frame) with the Cross Pieces attached to the 1st Side Frame

Name | Description | Metric Conversion
Unit of
Measure
Wood 2x4x10 | 2x4x10 | 52xmmx101mm x254mm

Piece

Square
Drive Nail
Drill Bit
Machine

https://drive.goo
gle.com/drive/fol
ders/18duHcktm
zT1QRXVuiVttS
uXc_h-BfB69

50

Place the Side frame on top of
the | Base | Board | (non-
grounded side)
Name | Description | Metric Conversion
Unit of
Measure
Wood 2x4x10 | 2x4x10 | 52xmmx101mmx25 4mm
Plywood 3/4x15.5 | 3/4" MDF 15.5" x 15.5" (Can also use Plywood) | 19mm MDF 394 mmx 394mm (Can also use Plywood)

Piece

Piece

https://drive.goo
gle.com/drive/fol
ders/18duHcktm
zT1QRXVuiVttS
uXc_h-BfB69

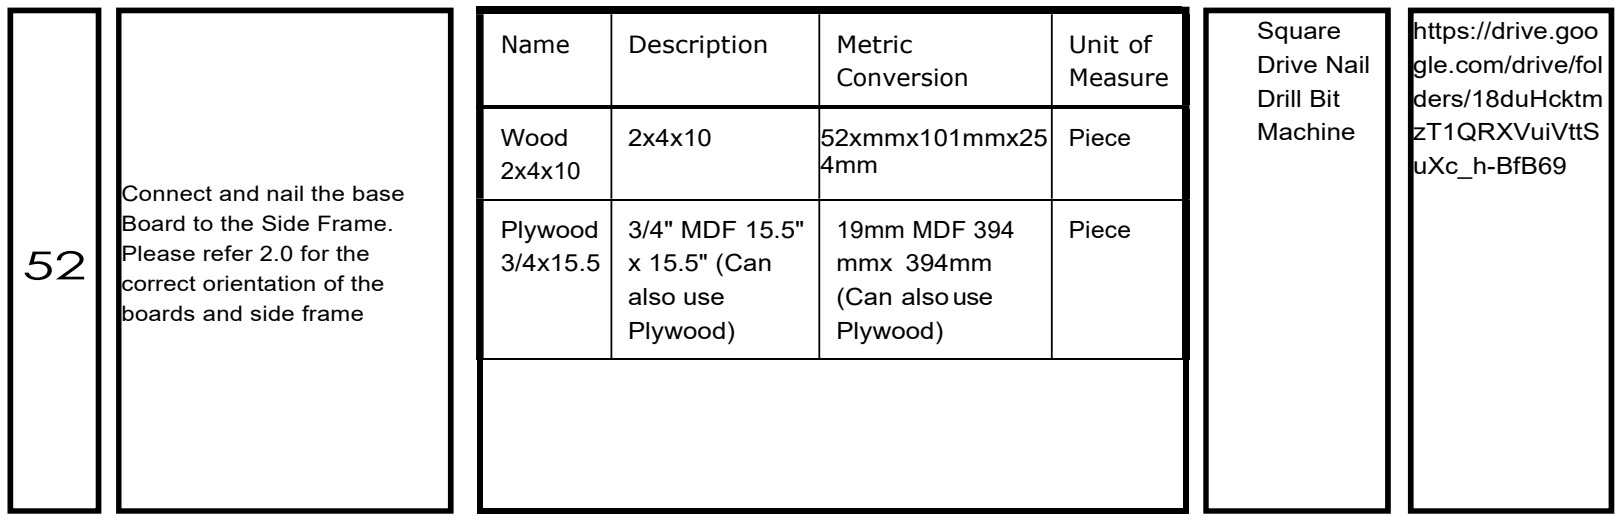
[picture p82: figure]
Connect and nail the base Board to the Side Frame. Please refer 2.0 for the correct orientation of the boards and side frame; Name; Description; Metric; Conversion; Unit of Measure; Wood 2x4x10; 52xmmx101mmx25 4mm; Piece; Square Drive Nail Drill Bit Machine; https://drive.goo gle.com/drive/fol ders/18duHcktm zT1QRXVuiVttS uXc_h-BfB69

### Page 35 of 38

51

Pre drill 2 holes on the area where the side frame and the Base board are connected

Name | Description | Metric
| | Conversion | Unit of
| | | Measure
Plywood | 3/4" MDF 15.5" | 19mm MDF 394 | Piece
3/4x15.5 | x 15.5" (Can | mmx 394mm
| also use | (Can also use
| Plywood) | Plywood)

Drill Bit
Machine

https://drive.goo
gle.com/drive/fol
ders/18duHcktm
zT1QRXVuiVttS
uXc_h-BfB69
Plywood 3/4x15.5 | 3/4" MDF 15.5" x 15.5" (Can also use Plywood) | 19mm MDF 394 mmx 394mm (Can also use Plywood)

### Page 36 of 38

53

Place the angle piece from the
step 9-12 into the Side frame and on top of the Base Board. Please refer fig2.0 and Fig 4.0
Name | Description | Metric Conversion
Unit of
Measure
Wood 2x4x10 | 2x4x10 | 52xmmx101mmx25 4mm
Plywood 3/4x15.5 | 3/4" MDF 15.5" x 15.5" (Can also use Plywood) | 19mm MDF 394 mmx 394mm (Can also use Plywood)

Piece

Piece

Square
Drive Nail
Drill Bit
Machine

https://drive.goo
gle.com/drive/fol
ders/18duHcktm
zT1QRXVuiVttS
uXc_h-BfB69

### 54 Pre drill the base frame in

Step 53
Name | Description | Metric
| | Conversion | Unit of
| | | Measure
Plywood | 3/4" MDF 15.5" | 19mm MDF 394 | Piece
3/4x15.5 | x 15.5" (Can | mmx 394mm
| also use | (Can also use
| Plywood) | Plywood)

Drill Bit
Machine

https://drive.goo
gle.com/drive/fol
ders/18duHcktm
zT1QRXVuiVttS
uXc_h-BfB69

### Page 37 of 38

55

Connect the Angle Piece with the Side Frame and the Base Board. One nail connecting to the Side Frame and one nail into the base frame. Please refer Fig 2.0 and Fig 4.0.

Name | Description | Metric Conversion
Unit of
Measure
Wood 2x4x10 | 2x4x10 | 52xmmx101mmx25 4mm
Plywood 3/4x15.5 | 3/4" MDF 15.5" x 15.5" (Can also use Plywood) | 19mm MDF 394 mmx 394mm (Can also use Plywood)

Piece

Piece

Square
Drive Nail
Drill Bit
Machine

https://drive.goo
gle.com/drive/fol
ders/18duHcktm
zT1QRXVuiVttS
uXc_h-BfB69

Page 4 of 13 | Version 1.0
