OxiKit/oxygen-concentrator-how-to-diy-open-source/Orifices WorkFlow.pdf

www.oxikit.com
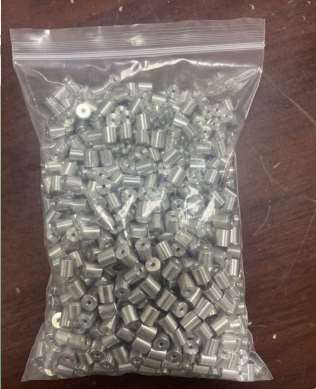
[picture p83: figure]

### Page 1 of 15 Version 1.0

# Orifices WorkFlow

### Version 1.0

### Page 2 of 15

Document # | Date Effective

## OXIKIT-OR001

Supersedes Document Version #:

### OXIKIT WORKFLOW

Document Title

## Workflow - Orifices

### Change History Log:

VERSION # | REVISION DATE | DESCRIPTION OF CHANGE
FROM | TO
1.0 | 11/27/2020 | Original Release

### I. Purpose:

This Workflow is intended to serve as a guide in making the Orifices of the Oxikit.

II. | Scope: This guideline applies to all individuals who wish to build the DIY Oxikit. It includes the Materials, tools and the Video Link needed in making the Orifices.
III. | Picture:

### Fig 1.0 (Orifices)

### Page 3 of 15

Document # | Date Effective

## OXIKIT-OR001

Supersedes Document Version #:

### OXIKIT WORKFLOW

Document Title

## Workflow - Orifices

### IV. Safety Operating Conditions: - Always wear protective gloves

### V. Workflows - Please see next page for the step by step guidelines in making the Orifices

Steps | Process | Material | Tools | YouTube Link

### Page 4 of 15

Caliper

Sharpie/Marker

1

2

https://www.youtu
be.com/watch?v=
qwXvRReWQ54&
list=PL4O1RQEiL
pHBJ0i1zqe-CZk1p_NTtGl76&i
ndex=7

Measure 7mm into
the aluminum rod.
Name | Description | Metric Conversion
Unit of
Measure
Aluminum Rod | 1/4" Aluminum Rod | 6.4mm Aluminum Rod

Piece

https://www.youtu
be.com/watch?v=
qwXvRReWQ54&
list=PL4O1RQEiL
pHBJ0i1zqe-CZk1p_NTtGl76&i
ndex=7

Label 7mm into the
aluminum rod.
Name | Description | Metric Conversion
Unit of
Measure
Aluminum Rod | 1/4" Aluminum Rod | 6.4mm Aluminum Rod

Piece

### Page 5 of 15

Tube Cutter

Heavy Nut
Locking
Pliers

3

4

https://www.youtu
be.com/watch?v=
qwXvRReWQ54&
list=PL4O1RQEiL
pHBJ0i1zqe-CZk1p_NTtGl76&i
ndex=7

Cut the aluminum
rod. Make 6 pieces
Name | Description | Metric Conversion
Unit of
Measure
Aluminum Rod | 1/4" Aluminum Rod | 6.4mm Aluminum Rod

Piece

https://www.youtu
be.com/watch?v=
qwXvRReWQ54&
list=PL4O1RQEiL
pHBJ0i1zqe-CZk1p_NTtGl76&i
ndex=7

Hold the Orifice in
place
Name | Description | Metric Conversion
Unit of
Measure
Orifices | 1/16” hole Orifices | 1.6 mm hole Orifices

Piece

### Page 6 of 15

Heavy Nut
Locking
Pliers
Hammer
Punch Steel

Drill Bit
Machine

5

6

https://www.youtu
be.com/watch?v=
qwXvRReWQ54&
list=PL4O1RQEiL
pHBJ0i1zqe-CZk1p_NTtGl76&i
ndex=7

Mark and Punch a
small hole on the
center of the Orifice
Name | Description | Metric Conversion
Unit of
Measure
Orifices | 1/16” hole Orifices | 1.6 mm hole Orifices
Piece

https://www.youtu
be.com/watch?v=
qwXvRReWQ54&
list=PL4O1RQEiL
pHBJ0i1zqe-CZk1p_NTtGl76&i
ndex=7

Place the Orifice
inside the Drill Bit
Machine Chuck
Name | Description | Metric Conversion
Unit of
Measure
Orifices | 1/16” hole Orifices | 1.6 mm hole Orifices

Piece

### Page 7 of 15

Drill Bit
Machine
Drill Bit 1mm

Drill Bit
Machine
Drill Bit 1.5
mm

7

8

https://www.youtu
be.com/watch?v=
qwXvRReWQ54&
list=PL4O1RQEiL
pHBJ0i1zqe-CZk1p_NTtGl76&i
ndex=7 Drill the marked

Orifice using a 1mm
Drill bit with a
portable drill chuck
until it reaches the
other end of the
orifice
Name | Description | Metric Conversion
Unit of
Measure
Orifices | 1/16” hole Orifices | 1.6 mm hole Orifices

Piece

https://www.youtu
be.com/watch?v=
qwXvRReWQ54&
list=PL4O1RQEiL
pHBJ0i1zqe-CZk1p_NTtGl76&i
ndex=7 Drill the marked

Orifice using a
1.5mm Drill bit with
a portable drill
chuck until it
reaches the other
end of the orifice
Name | Description | Metric Conversion
Unit of
Measure
Orifices | 1/16” hole Orifices | 1.6 mm hole Orifices

Piece

### Page 8 of 15

Drill Bit
Machine
Drill Bit 1.6
mm

Drill Bit
Machine
Drill Bit 1/8"

9

10

https://www.youtu
be.com/watch?v=
qwXvRReWQ54&
list=PL4O1RQEiL
pHBJ0i1zqe-CZk1p_NTtGl76&i
ndex=7 Drill the marked

Orifice using a
1.6mm Drill bit with
a portable drill
chuck until it
reaches the other
end of the orifice
Name | Description | Metric Conversion
Unit of
Measure
Orifices | 1/16” hole Orifices | 1.6 mm hole Orifices

Piece

https://www.youtu
be.com/watch?v=
qwXvRReWQ54&
list=PL4O1RQEiL
pHBJ0i1zqe-CZk1p_NTtGl76&i
ndex=7 Drill the other end

of the Orifice using
a 1/8" Drill bit
(holding it by
hand) until it
reaches the
middle portion of
the orifice
Name | Description | Metric Conversion
Unit of
Measure
Orifices | 1/16” hole Orifices | 1.6 mm hole Orifices

Piece

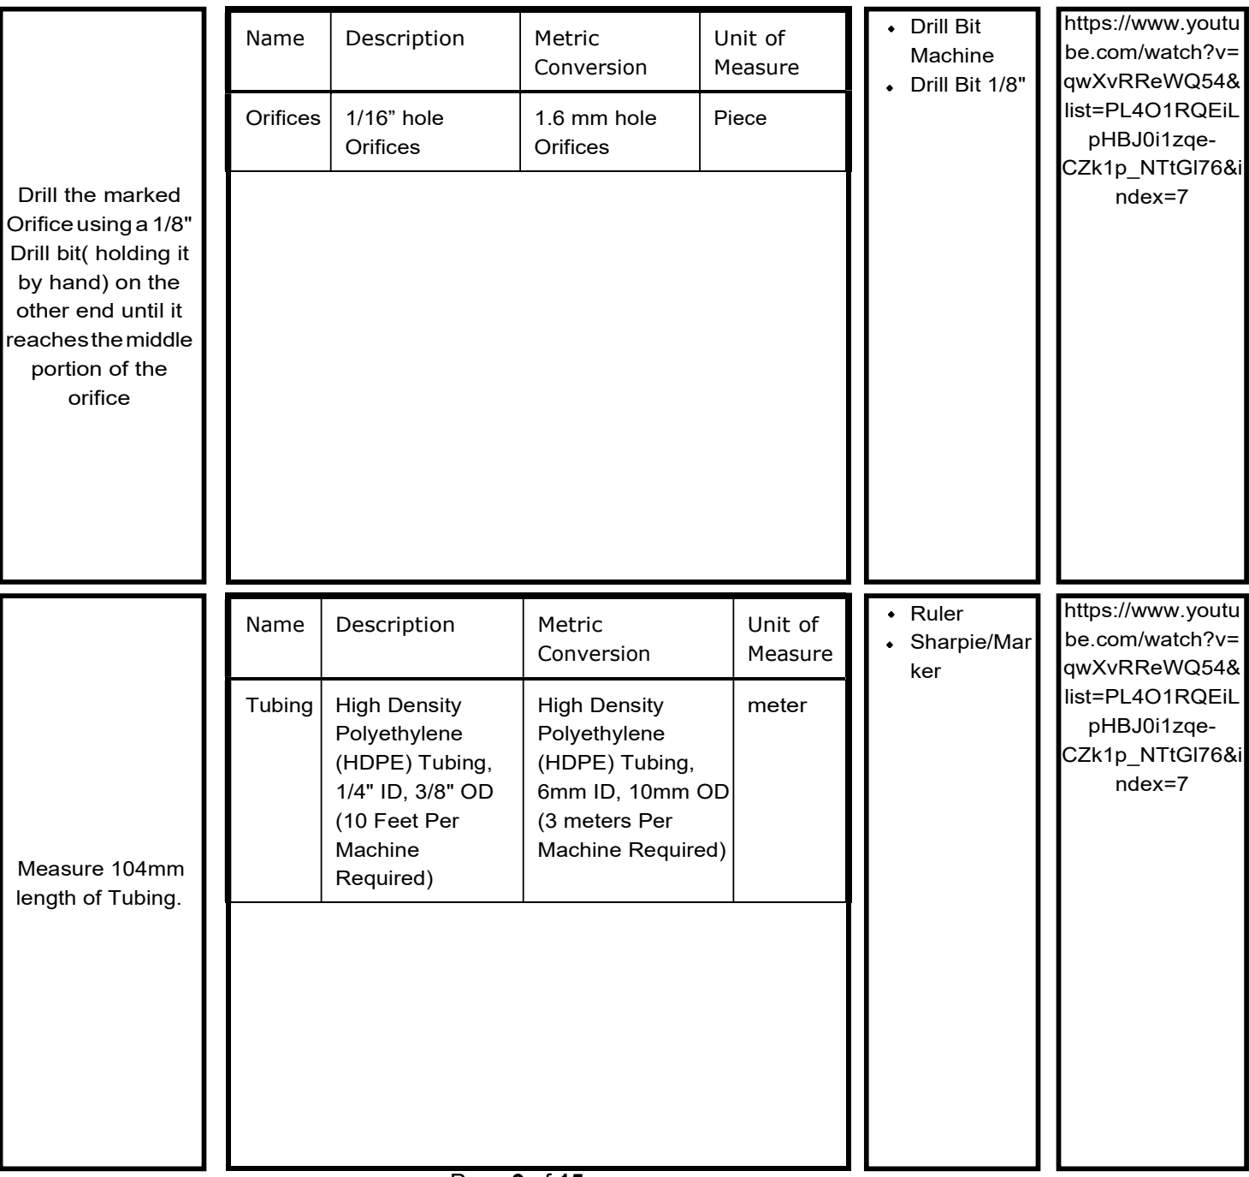
[picture p84: figure]
Drill the marked; ndex=7; Orifice using a 1/8" Drill bit( holding it by hand) on the other end until it reaches the middle portion of the orifice; Name; Description; Metric; Conversion; Unit of Measure; Orifices; 1/16” hole; 1.6 mm hole Orifices; Piece; https://www.youtu be.com/watch?v= qwXvRReWQ54& list=PL4O1RQEiL pHBJ0i1zqe- CZk1p_NTtGl76&i ndex=7; Measure 104mm length of Tubing.; Tubing; High Density; Polyethylene (HDPE) Tubing, 1/4" ID, 3/8" OD (10 Feet Per Machine Required); High Density Polyethylene (HDPE) Tubing, 6mm ID, 10mm OD (3 meters Per Machine Required); meter

### Page 9 of 15

Drill Bit
Machine
Drill Bit 1/8"

Ruler
Sharpie/Mar
ker

11

12

https://www.youtu
be.com/watch?v=
qwXvRReWQ54&
list=PL4O1RQEiL
pHBJ0i1zqe-CZk1p_NTtGl76&i

### Page 10 of 15

Scissors/Cut
ter

Punch Steel

13

14

https://www.youtu
be.com/watch?v=
qwXvRReWQ54&
list=PL4O1RQEiL
pHBJ0i1zqe-CZk1p_NTtGl76&i
ndex=7
Cut the marked
tubing as per step

### 12. Ensure tube is

cut evenly, no
skews on the end.
Make 6 pieces
Name | Description | Metric Conversion
Unit of
Measure
Tubing | High Density Polyethylene (HDPE) Tubing, 1/4" ID, 3/8" OD (10 Feet Per Machine Required) | High Density Polyethylene (HDPE) Tubing, 6mm ID, 10mm OD (3 meters Per Machine Required)
meter

https://www.youtu
be.com/watch?v=
qwXvRReWQ54&
list=PL4O1RQEiL
pHBJ0i1zqe-CZk1p_NTtGl76&i
ndex=7
Place and Push
the orifices inside
the clear vinyl
tubing until it
reaches the middle
Portion of the tube
Name | Description | Metric Conversion
Unit of
Measure
Tubing | High Density Polyethylene (HDPE) Tubing, 1/4" ID, 3/8" OD (10 Feet Per Machine Required) | High Density Polyethylene (HDPE) Tubing, 6mm ID, 10mm OD (3 meters Per Machine Required)
Orifices | 1/16” hole Orifices | 1.6 mm hole Orifices

meter

Piece

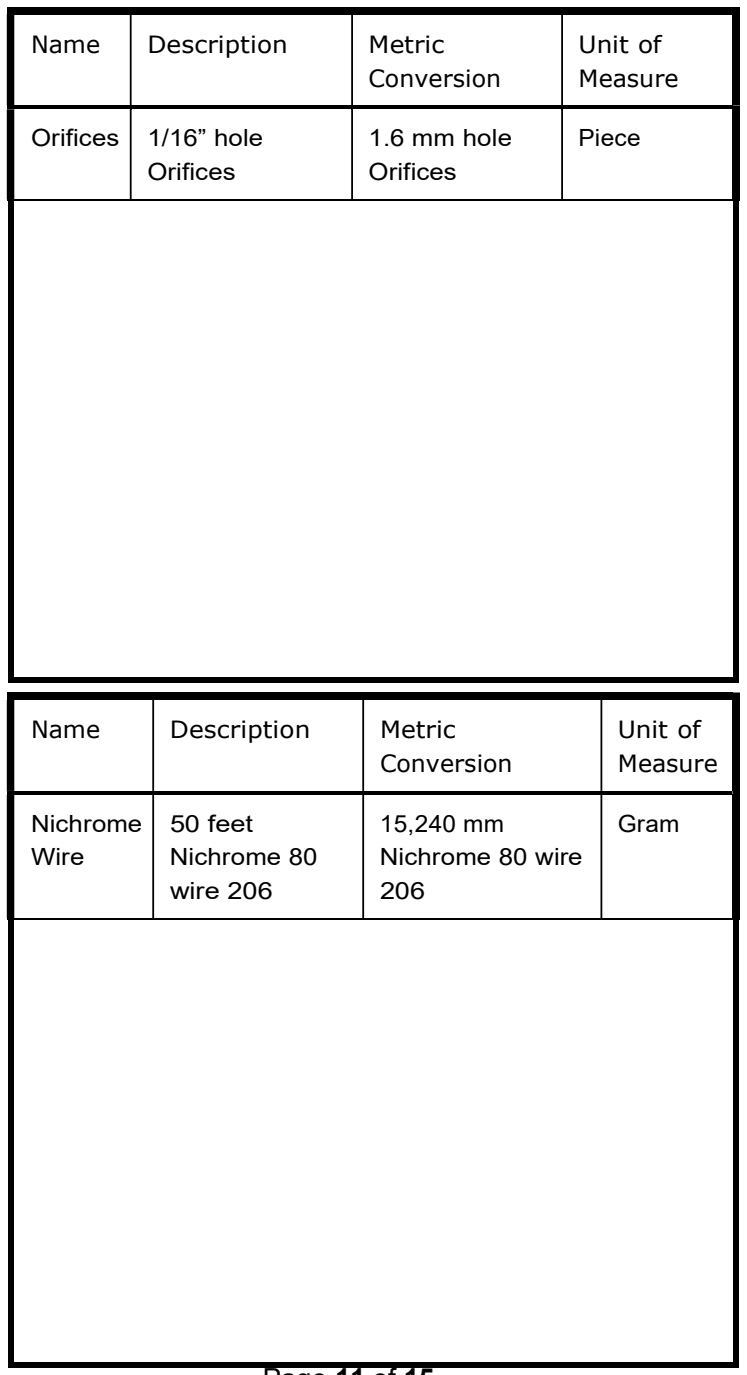
[picture p85: figure]
Name; Description; Metric; Conversion; Unit of Measure; Orifices; 1/16” hole; 1.6 mm hole Orifices; Piece; Nichrome Wire; 50 feet Nichrome 80 wire 206; 15,240 mm Nichrome 80 wire 206; Gram

### Page 11 of 15

Ruler
Sharpie/Mar
ker

15

16

https://www.youtu
be.com/watch?v=
qwXvRReWQ54&
list=PL4O1RQEiL
pHBJ0i1zqe-CZk1p_NTtGl76&i
ndex=7
Inspect the Orifices
if they fit well inside
the tubes. If loose,
proceed to the next
step. If fits well,
product is okay

https://www.youtu
be.com/watch?v=
qwXvRReWQ54&
list=PL4O1RQEiL
pHBJ0i1zqe-CZk1p_NTtGl76&i
ndex=7

Measure 5-7" of
Nichrome Wire.

### Page 12 of 15

Wire Cutter
Pliers

17

18

https://www.youtu
be.com/watch?v=
qwXvRReWQ54&
list=PL4O1RQEiL
pHBJ0i1zqe-CZk1p_NTtGl76&i
ndex=7

Cut the Nichrome
wire.
Name | Description | Metric Conversion
Unit of
Measure
Nichrome Wire | 50 feet Nichrome 80 wire 206 | 15,240 mm Nichrome 80 wire
| | 206

Gram

https://www.youtu
be.com/watch?v=
qwXvRReWQ54&
list=PL4O1RQEiL
pHBJ0i1zqe-CZk1p_NTtGl76&i
ndex=7

Secure the Orifice
by wrapping and
twisting the
wire around the
tube near the
Orifice. Ensure not
to wrap the wire
tightly, just enough
to put the orifice in
place in the tube
Name | Description | Metric Conversion
Unit of
Measure
Tubing | High Density Polyethylene (HDPE) Tubing, 1/4" ID, 3/8" OD (10 Feet Per Machine Required) | High Density Polyethylene (HDPE) Tubing, 6mm ID, 10mm OD (3 meters Per Machine Required)
Nichrome Wire | 50 feet Nichrome 80 wire 206 | 15,240 mm Nichrome 80 wire 206
Orifices | 1/16” hole Orifices | 1.6 mm hole Orifices

meter

Gram

Piece

### Page 13 of 15

Wire Cutter
Pliers

Ruler
Sharpie/Mar
ker

19

20

https://www.youtu
be.com/watch?v=
qwXvRReWQ54&
list=PL4O1RQEiL
pHBJ0i1zqe-CZk1p_NTtGl76&i
ndex=7

Cut the excess
Nichrome wire
Name | Description | Metric Conversion
Unit of
Measure
Tubing | High Density Polyethylene (HDPE) Tubing, 1/4" ID, 3/8" OD (10 Feet Per Machine Required) | High Density Polyethylene (HDPE) Tubing, 6mm ID, 10mm OD (3 meters Per Machine Required)
Tee Push to connect fittings | 3/8"Push to Connect to 3/8"Push to Connect to 3/8"Push to Connect - Tee | 10mm Push to Connect to 10mm Push to Connect - Tee
Nichrome Wire | 50 feet Nichrome 80 | 15,240 mm Nichrome 80

meter

Piece

Gram

https://www.youtu
be.com/watch?v=
qwXvRReWQ54&
list=PL4O1RQEiL
pHBJ0i1zqe-CZk1p_NTtGl76&i
ndex=7

Measure 5-7" of
Nichrome Wire.
Name | Description | Metric Conversion
Unit of
Measure
Nichrome Wire | 50 feet Nichrome 80 wire 206 | 15,240 mm Nichrome 80 wire
| | 206

Gram

### Page 14 of 15

Wire Cutter
Pliers

21

22

https://www.youtu
be.com/watch?v=
qwXvRReWQ54&
list=PL4O1RQEiL
pHBJ0i1zqe-CZk1p_NTtGl76&i
ndex=7

Cut the Nichrome
wire.
Name | Description | Metric Conversion
Unit of
Measure
Nichrome Wire | 50 feet Nichrome 80 wire 206 | 15,240 mm Nichrome 80 wire
| | 206

Gram

https://www.youtu
be.com/watch?v=
qwXvRReWQ54&
list=PL4O1RQEiL
pHBJ0i1zqe-CZk1p_NTtGl76&i
ndex=7

Secure the Orifice
by wrapping and
twisting the
wire around the
other end of the
tube near the
Orifice. Ensure not
to wrap the wire
tightly, just enough
to put the orifice in
place inside the
tube
Name | Description | Metric Conversion
Unit of
Measure
Tubing | High Density Polyethylene (HDPE) Tubing, 1/4" ID, 3/8" OD (10 Feet Per Machine Required) | High Density Polyethylene (HDPE) Tubing, 6mm ID, 10mm OD (3 meters Per Machine Required)
Nichrome Wire | 50 feet Nichrome 80 wire 206 | 15,240 mm Nichrome 80 wire 206
Orifices | 1/16” hole Orifices | 1.6 mm hole Orifices

meter

Gram

Piece

### Page 15 of 15

Wire Cutter
Pliers

23

https://www.youtu
be.com/watch?v=
qwXvRReWQ54&
list=PL4O1RQEiL
pHBJ0i1zqe-CZk1p_NTtGl76&i
ndex=7

Cut the excess
Nichrome wire
Name | Description | Metric Conversion
Unit of
Measure
Tubing | High Density Polyethylene (HDPE) Tubing, 1/4" ID, 3/8" OD (10 Feet Per Machine Required) | High Density Polyethylene (HDPE) Tubing, 6mm ID, 10mm OD (3 meters Per Machine Required)
meter

Tee Push
to
connect
fittings

3/8"Push to
Connect to
3/8"Push to
Connect to
3/8"Push to
Connect - Tee

10mm Push to
Connect to
10mm Push to
Connect - Tee

Piece

Nichrome
Wire

### 50 feet

Nichrome 80

15,240 mm
Nichrome 80

Gram
