OxiKit/oxygen-concentrator-how-to-diy-open-source/Oxikit WorkFlow.pdf

www.oxikit.com
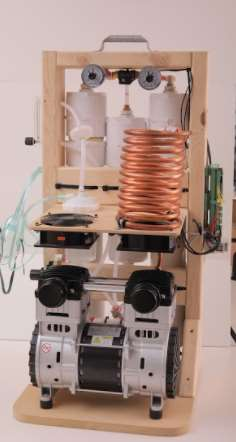
[picture p86: figure]

### Page 1 of 245 Version 1.0

# Oxikit Complete Assembly WorkFlow

### Version 1.0

## OXIKIT-OK001

### OXIKIT WORKFLOW

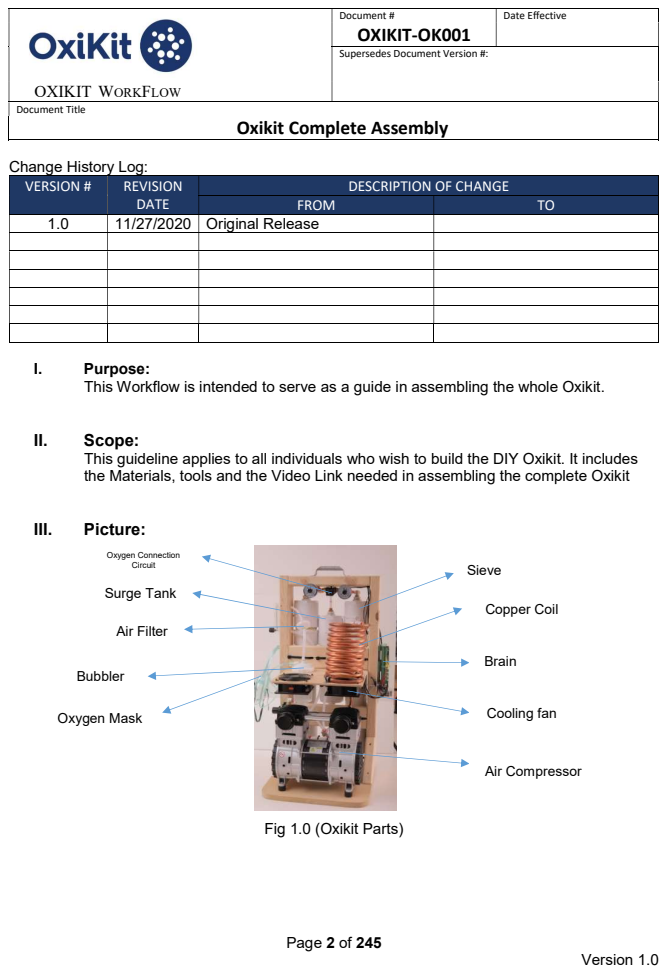
[picture p87: page 2]
Page 2 of 245; Version 1.0; Document #; Date Effective; Document Title; Scope:; III.; Picture:; Oxygen Connection; Circuit; Sieve; Copper Coil; Brain; Cooling fan; Air Compressor; Surge Tank; Air Filter; Bubbler; Oxygen Mask

Supersedes Document Version #:

Oxikit Complete Assembly

Change History Log:

VERSION # | REVISION DATE | DESCRIPTION OF CHANGE

FROM | TO

1.0 | 11/27/2020 | Original Release

I. Purpose:
This Workflow is intended to serve as a guide in assembling the whole Oxikit.

This guideline applies to all individuals who wish to build the DIY Oxikit. It includes
the Materials, tools and the Video Link needed in assembling the complete Oxikit

Fig 1.0 (Oxikit Parts)

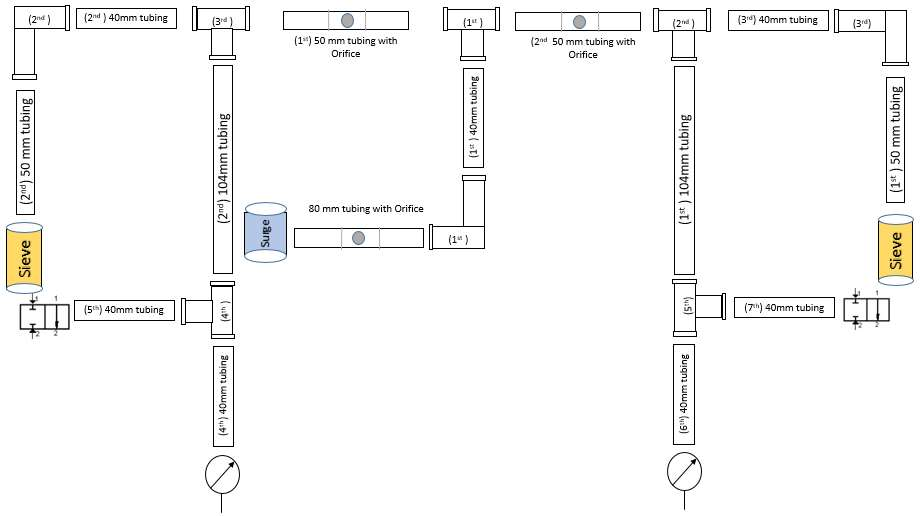
[picture p88: figure]

### Page 3 of 245 Version 1.0

Document # | Date Effective

## OXIKIT-OK001

Supersedes Document Version #:

### OXIKIT WORKFLOW

Document Title

## Oxikit Complete Assembly

### Fig. 2.0 Oxygen Connection Circuit

## OXIKIT-OK001

### OXIKIT WORKFLOW

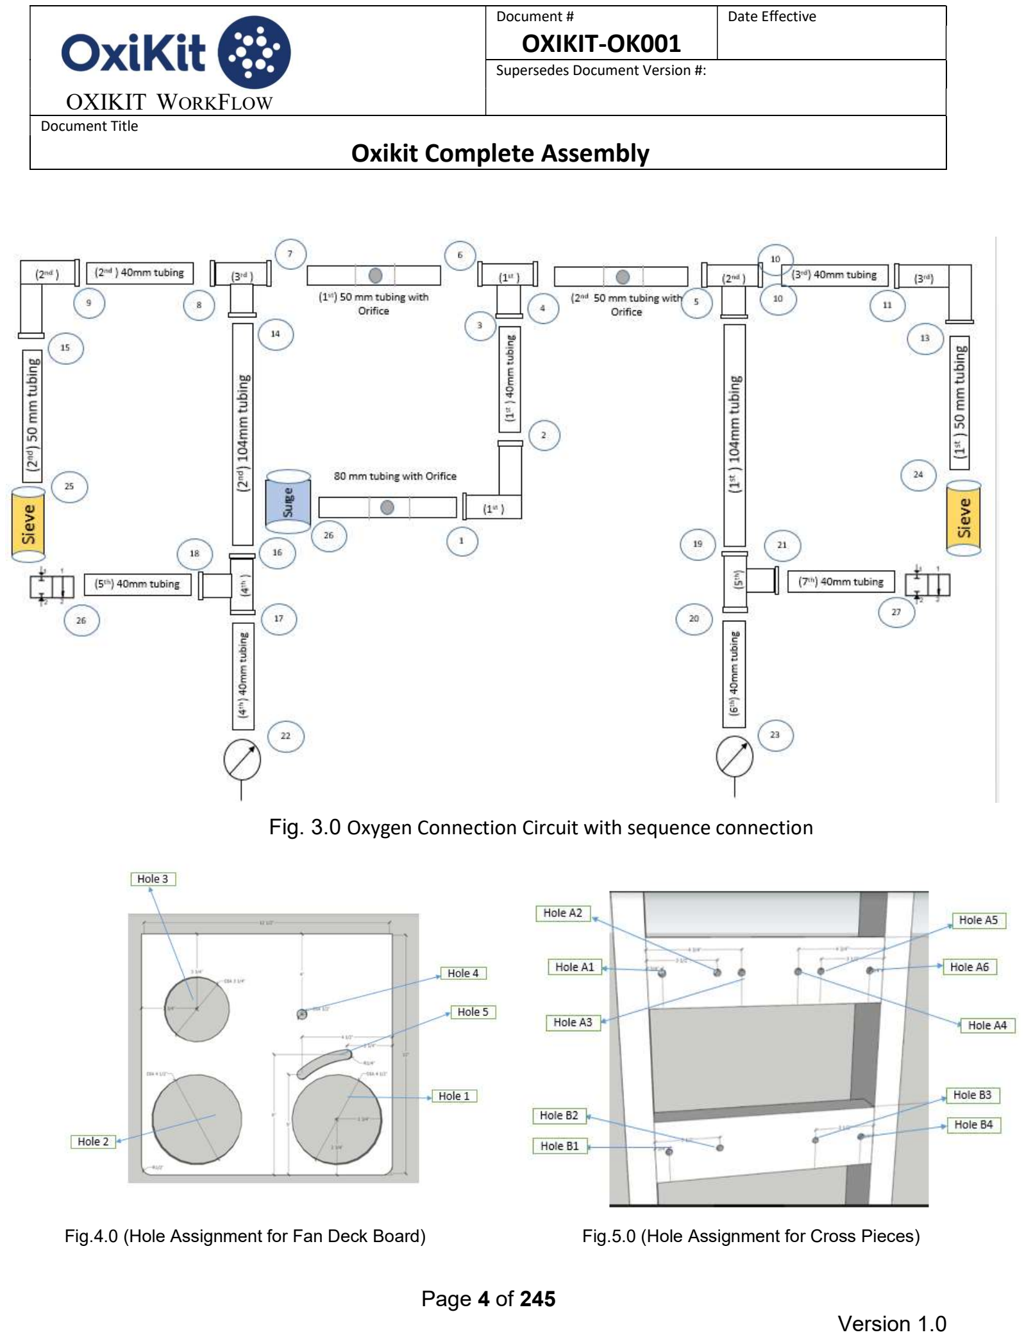
[picture p89: page 4]

### Page 4 of 245 Version 1.0

Document # | Date Effective

Supersedes Document Version #:

Document Title

## Oxikit Complete Assembly

### Fig. 3.0 Oxygen Connection Circuit with sequence connection

Fig.4.0 (Hole Assignment for Fan Deck Board) | Fig.5.0 (Hole Assignment for Cross Pieces)

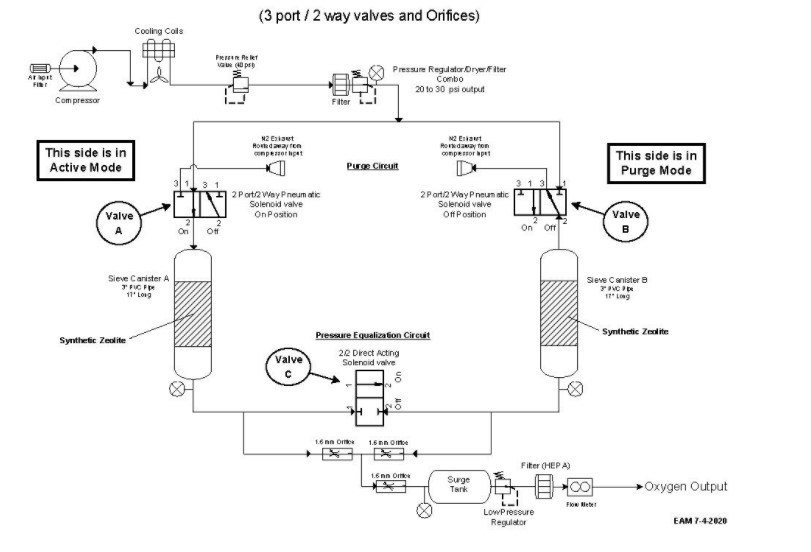
[picture p90: figure]

### Page 5 of 245 Version 1.0

Document # | Date Effective

## OXIKIT-OK001

Supersedes Document Version #:

### OXIKIT WORKFLOW

Document Title

## Oxikit Complete Assembly

Fig.6.0 (Oxygen Concentrator Circuit Diagram)

### FIGURE SUMMARY

FIGURE # | DESCRIPTION | REMARKS
1 | Oxikit Complete Assembly | Describes the parts needed to assemble the whole Oxikit
2 | Oxygen Connection Circuit | Wirings of the Oxygen Circuit
3 Oxygen Connection Circuit with | sequence connection | Describes the flow and arrangement of connection of the Circuit

### 4 Hole Assignment for Fan Deck Board 5 Hole Assignment for Cross Pieces 6 Oxygen Concentrator Circuit Diagram

### Page 6 of 245 Version 1.0

### IV. Safety Operating Conditions: - Always wear protective gloves

### V. Workflows - Please see next page for the step by step guidelines in making the whole

| assembly of the Oxikit.

### Page 7 of 245 Version 1.0

# Air Compressor Mounting

Steps Process | Material | Tools | Youtube Link
Page 8 of 245 | Version 1.0

https://drive.
google.com/
drive/folders/
18duHcktmz
T1QRXVuiVtt
SuXc_h-BfB69
Name | Description | Metric Conversion
Unit of
Measure
Air Compressor | California Air Tools SP-9421 2.0HP Ultra Quiet and Oil-Free Air Compressor Motor | California Air Tools SP-9421 2.0HP Ultra Quiet and Oil-Free Air Compressor Motor

Unit

Unscrew the
legs of
the Air
compressor

1

Page 9 of 245 | Version 1.0

https://drive.
google.com/
drive/folders/
18duHcktmz
T1QRXVuiVtt
SuXc_h-BfB69
Name | Description | Metric Conversion
Unit of
Measure
Air Compressor | California Air Tools SP-9421 2.0HP Ultra Quiet and Oil-Free Air Compressor Motor | California Air Tools SP-9421 2.0HP Ultra Quiet and Oil-Free Air Compressor Motor

Unit

Turn the Air
compressor
Upside Down
to expose its
bottom legs

2

Page 10 of 245 | Version 1.0

https://drive.
google.com/
drive/folders/
18duHcktmz
T1QRXVuiVtt
SuXc_h-BfB69
Pencil Name | Description | Metric
Conversion

Unit of
Measure
Air Compressor | California Air Tools SP-9421 2.0HP Ultra Quiet and Oil-Free Air Compressor Motor | California Air Tools SP-9421 2.0HP Ultra Quiet and Oil-Free Air Compressor Motor
Bond Paper | Short Size Bond Paper | Short Size Bond Paper

Unit

Piece

Make a
template of
the Air
compressor's
legs.

3

Page 11 of 245 | Version 1.0

https://drive.
google.com/
drive/folders/
18duHcktmz
T1QRXVuiVtt
SuXc_h-BfB69
Name | Description | Metric Conversion
Unit of
Measure
Air Compressor | California Air Tools SP-9421 2.0HP Ultra Quiet and Oil-Free Air Compressor Motor | California Air Tools SP-9421 2.0HP Ultra Quiet and Oil-Free Air Compressor Motor

Unit

Tilt back the
Air
Compressor
into its
original
position

4

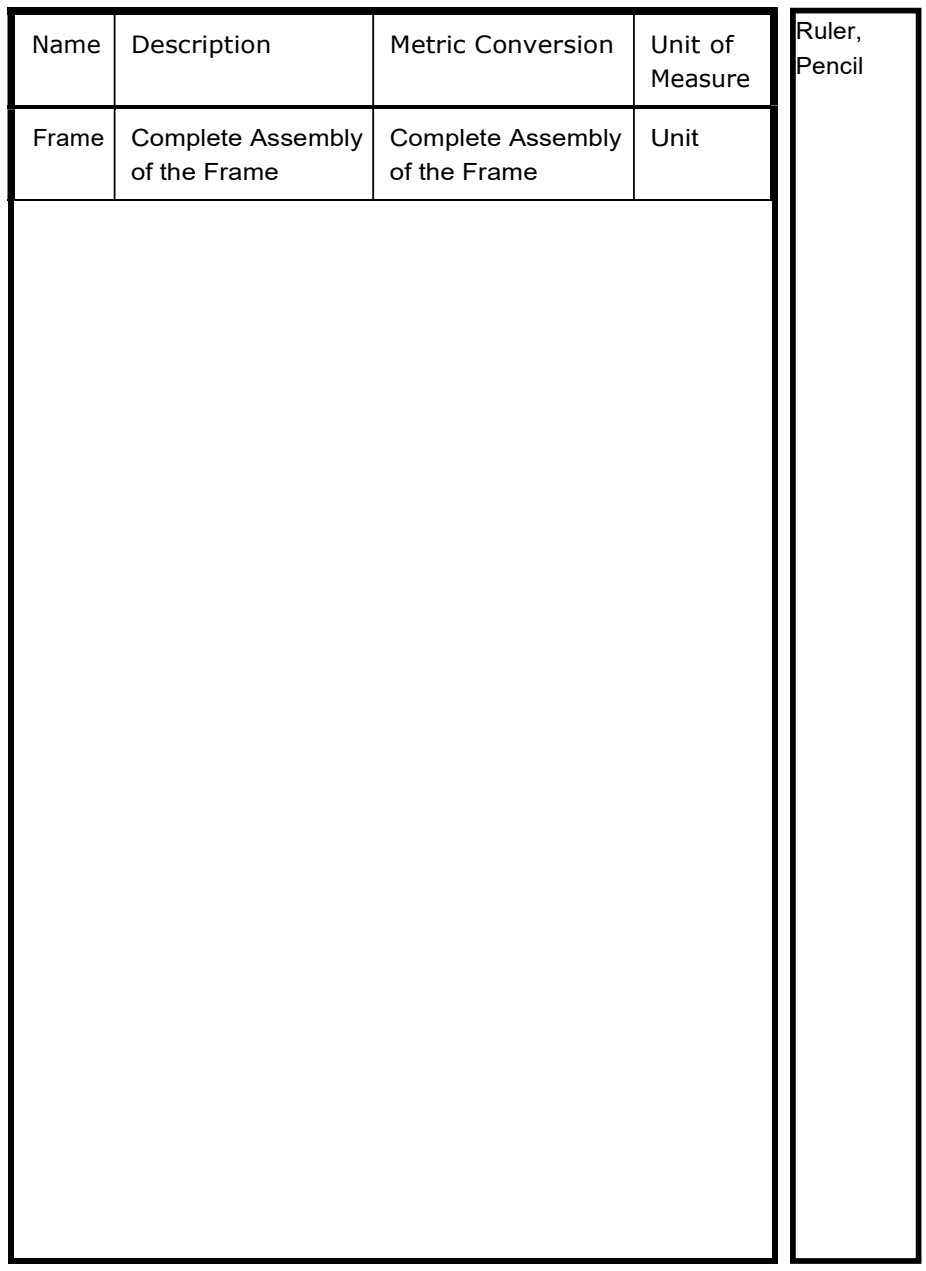
[picture p91: figure]
Ruler, Pencil; Measure; Frame; Complete Assembly; of the Frame; Complete Assembly of the Frame; Unit

Page 12 of 245 | Version 1.0

https://drive.
google.com/
drive/folders/
18duHcktmz
T1QRXVuiVtt
SuXc_h-BfB69
Name | Description | Metric Conversion | Unit of

Measure and
Label 2" from
the bottom
side (on each
sides) of the
Base board

5

Ruler, Pencil; Measure; Frame; Complete Assembly; of the Frame; Complete Assembly of the Frame; Unit

Page 13 of 245 | Version 1.0

https://drive.
google.com/
drive/folders/
18duHcktmz
T1QRXVuiVtt
SuXc_h-BfB69
Name | Description | Metric Conversion | Unit of

Connect the
labeled 2" on
each sides
to create a
line

6

Ruler, Pencil; Measure; Frame; Complete Assembly; of the Frame; Complete Assembly of the Frame; Unit

Page 14 of 245 | Version 1.0

https://drive.
google.com/
drive/folders/
18duHcktmz
T1QRXVuiVtt
SuXc_h-BfB69
Name | Description | Metric Conversion | Unit of

Measureand
Label 3" from
the end sides
of the board
to create an
intersection
point

7

Page 15 of 245 | Version 1.0

https://drive.
google.com/
drive/folders/
18duHcktmz
T1QRXVuiVtt
SuXc_h-BfB69
Name | Description | Metric Conversion | Unit of Measure
Frame | Complete Assembly of the Frame | Complete Assembly of the Frame
Bond Paper | Short Size Bond Paper | Short Size Bond Paper

Unit

Piece

Position the
template
(with marked
legs of the
air
compressor)
on top of the
intersection
line on the
Base Board

8

Page 16 of 245 | Version 1.0

https://drive.
google.com/
drive/folders/
18duHcktmz
T1QRXVuiVtt
SuXc_h-BfB69

Screwdriv
er
Name | Description | Metric Conversion | Unit of Measure
Frame | Complete Assembly of the Frame | Complete Assembly of the Frame
Bond Paper | Short Size Bond Paper | Short Size Bond Paper

Unit

Piece

Mark and
Punch all 4
legs on the
Template
Paper into
the Base
board

9

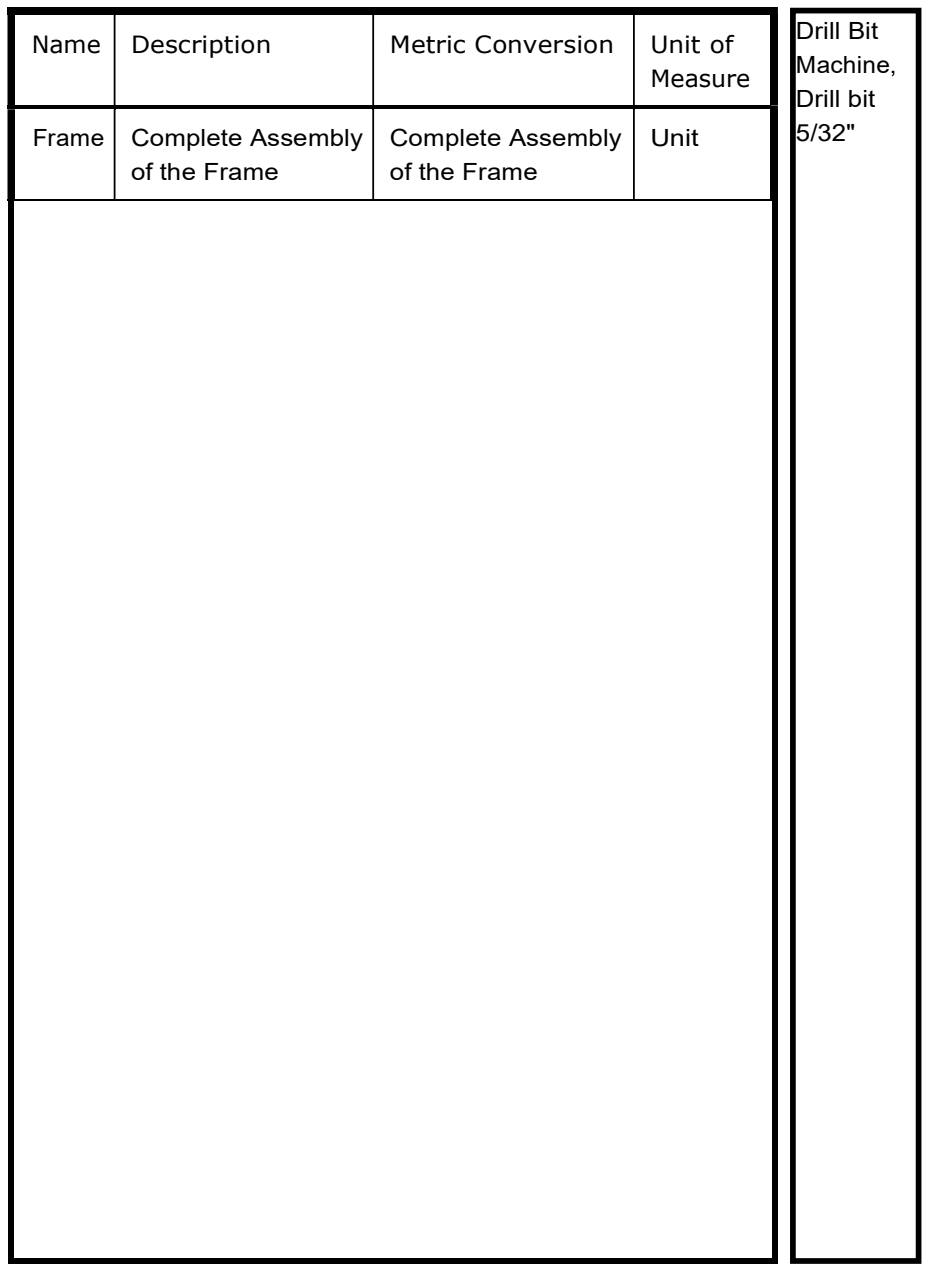
[picture p92: figure]
Drill Bit Machine, Drill bit 5/32"; Measure; Frame; Complete Assembly; of the Frame; Complete Assembly of the Frame; Unit

Page 17 of 245 | Version 1.0

https://drive.
google.com/
drive/folders/
18duHcktmz
T1QRXVuiVtt
SuXc_h-BfB69
Name | Description | Metric Conversion | Unit of

Pre Drill the
Marked Legs
on the Base
board

10

Page 18 of 245 | Version 1.0

https://drive.
google.com/
drive/folders/
18duHcktmz
T1QRXVuiVtt
SuXc_h-BfB69
Name | Description | Metric Conversion | Unit of Measure
Frame | Complete Assembly of the Frame | Complete Assembly of the Frame | Unit

Tilt the
Frame 11

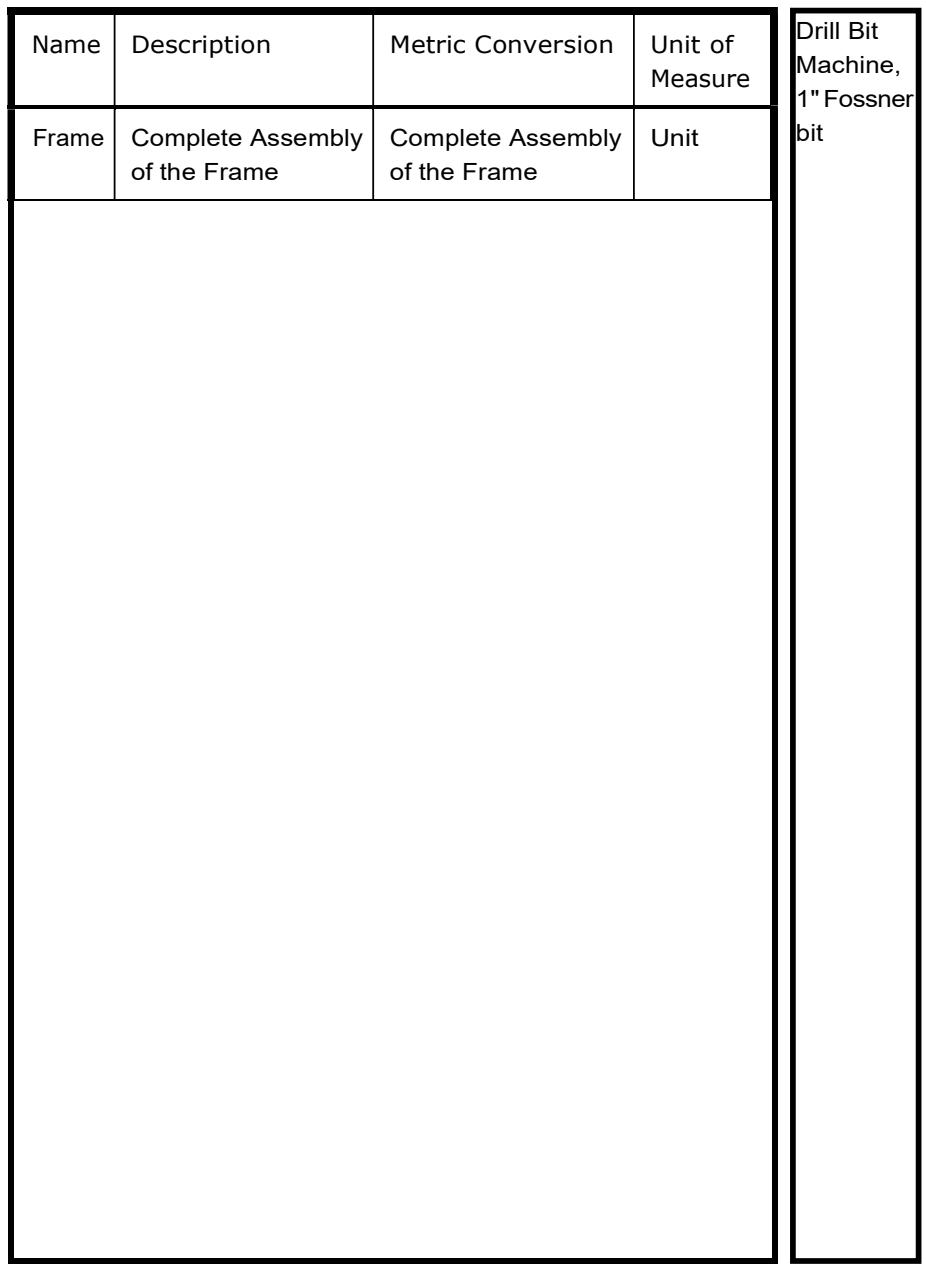
[picture p93: figure]
Drill Bit Machine, 1" Fossner bit; Measure; Frame; Complete Assembly; of the Frame; Complete Assembly of the Frame; Unit

Page 19 of 245 | Version 1.0

https://drive.
google.com/
drive/folders/
18duHcktmz
T1QRXVuiVtt
SuXc_h-BfB69
Name | Description | Metric Conversion | Unit of

Drill halfway
all 4 legs that
were
previously
marked/ pre
drilled on the
Base board.
Create a
pocket on
the
underside of
the lower
deck/Base
board.

12

Page 20 of 245 | Version 1.0

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

Tilt back the
board into its
original
position

13

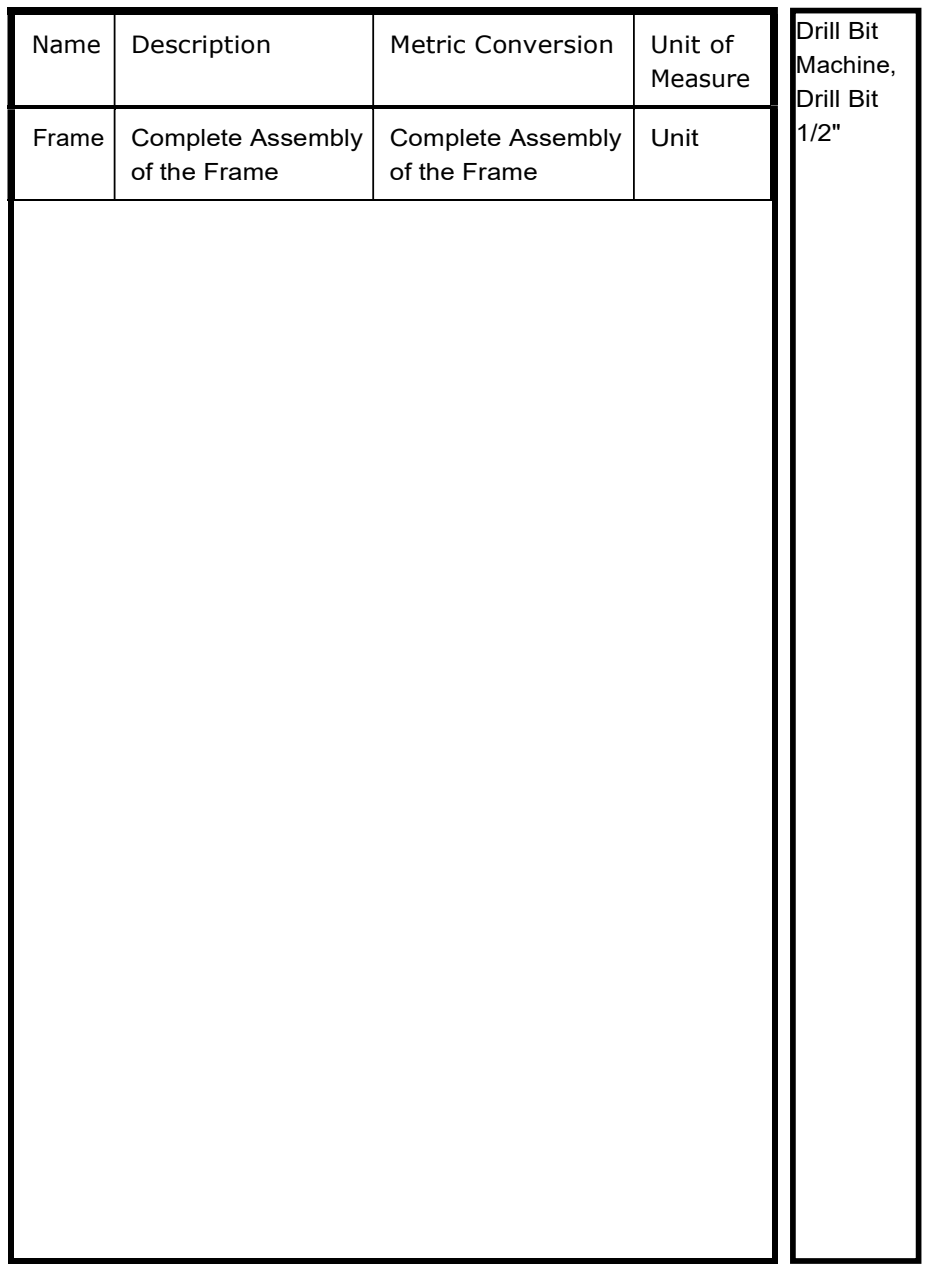
[picture p94: figure]
Drill Bit Machine, Drill Bit 1/2"; Measure; Frame; Complete Assembly; of the Frame; Complete Assembly of the Frame; Unit

Page 21 of 245 | Version 1.0

https://drive.
google.com/
drive/folders/
18duHcktmz
T1QRXVuiVtt
SuXc_h-BfB69
Name | Description | Metric Conversion | Unit of

Drill all 4 legs
that were
previously
marked/ pre
drilled on the
Base board.

14

Page 22 of 245 | Version 1.0

https://drive.
google.com/
drive/folders/
18duHcktmz
T1QRXVuiVtt
SuXc_h-BfB69
Name | Description | Metric Conversion
Unit of
Measure
Frame | Complete Assembly of the Frame | Complete Assembly of the Frame
Air Compressor | California Air Tools SP-9421 2.0HP Ultra Quiet and Oil-Free Air Compressor Motor | California Air Tools SP-9421 2.0HP Ultra Quiet and Oil-Free Air Compressor Motor

Unit

Unit

Position the
legs of the
Air
compressor
into the hole

15

Page 23 of 245 | Version 1.0

https://drive.
google.com/
drive/folders/
18duHcktmz
T1QRXVuiVtt
SuXc_h-BfB69
Name | Description | Metric Conversion
Unit of
Measure
Frame | Complete Assembly of the Frame | Complete Assembly of the Frame
Air Compressor | California Air Tools SP-9421 2.0HP Ultra Quiet and Oil-Free Air Compressor Motor | California Air Tools SP-9421 2.0HP Ultra Quiet and Oil-Free Air Compressor Motor

Unit

Unit

Nuts | Washer and Nuts | Washer and Nuts | Set
Washer Secure the
legs of the
air
compressor
into the Base
board by
putting Nuts
and Washer

16

Page 24 of 245 | Version 1.0

https://drive.
google.com/
drive/folders/
18duHcktmz
T1QRXVuiVtt
SuXc_h-BfB69

Socket
Wrench
Name | Description | Metric Conversion
Unit of
Measure
Frame | Complete Assembly of the Frame | Complete Assembly of the Frame
Air Compressor | California Air Tools SP-9421 2.0HP Ultra Quiet and Oil-Free Air Compressor Motor | California Air Tools SP-9421 2.0HP Ultra Quiet and Oil-Free Air Compressor Motor

Unit

Unit

Nuts | Washer and Nuts | Washer and Nuts | Set

Washer Tighten the

Washer and
nuts

17

Page 25 of 245 | Version 1.0

# Sieve and Surge Tank Mounting

Page 26 of 245 | Version 1.0

https://drive.
google.com/
drive/folders/
18duHcktmz
T1QRXVuiVt
tSuXc_h-BfB69
Name | Description | Metric Conversion | Unit of Measure
Frame | Complete Assembly of the Frame | Complete Assembly of the Frame
18" Cable Wire | 18" Cable Ties (Sold in 50 Pack) | 450mm x 4mm Cable Ties (Sold in 50 Pack)

Unit

Piece

Insert tie
wraps on the
A1, A4, A6,
B1, B4 holes
of the Frame
as per Fig.
5.0.

18

Page 27 of 245 | Version 1.0

https://drive.
google.com/
drive/folders/
18duHcktmz
T1QRXVuiVt
tSuXc_h-BfB69
Name | Description | Metric Conversion
Unit of
Measure
Frame | Complete Assembly of the Frame | Complete Assembly of the Frame
Sieve Canister Assembly | Complete and Finished Sieve Assembly | Complete and Finished Sieve Assembly

Unit

Lot

Place the 1st
Sieve into the
back portion
of the Frame.
Make sure
Sieve is on
an upright
Position and
is hanging
(PVC Male
Adaptor
Socket) on
the middle
cross piece
of the frame

19

Page 28 of 245 | Version 1.0

https://drive.
google.com/
drive/folders/
18duHcktmz
T1QRXVuiVt
tSuXc_h-BfB69
Name | Description | Metric Conversion | Unit of Measure
Frame | Complete Assembly of the Frame | Complete Assembly of the Frame
Sieve Canister Assembly | Complete and Finished Sieve Assembly | Complete and Finished Sieve Assembly
18" Cable Wire | 18" Cable Ties (Sold in 50 Pack) | 450mm x 4mm Cable Ties (Sold in 50 Pack)

Unit

Lot

Piece

Tie the upper
portion of the
Sieve by
Inserting the
Tie wrap
from A1 into
the A2 Hole.
Please refer
Fig 5.0 for
the hole
assignement

20

Page 29 of 245 | Version 1.0

https://drive.
google.com/
drive/folders/
18duHcktmz
T1QRXVuiVt
tSuXc_h-BfB69
Name | Description | Metric Conversion | Unit of Measure
Frame | Complete Assembly of the Frame | Complete Assembly of the Frame
Sieve Canister Assembly | Complete and Finished Sieve Assembly | Complete and Finished Sieve Assembly
18" Cable Wire | 18" Cable Ties (Sold in 50 Pack) | 450mm x 4mm Cable Ties (Sold in 50 Pack)

Unit

Lot

Piece

Tighten the
Tie Wrap 21

Page 30 of 245 | Version 1.0

https://drive.
google.com/
drive/folders/
18duHcktmz
T1QRXVuiVt
tSuXc_h-BfB69
Name | Description | Metric Conversion | Unit of Measure
Frame | Complete Assembly of the Frame | Complete Assembly of the Frame
Sieve Canister Assembly | Complete and Finished Sieve Assembly | Complete and Finished Sieve Assembly
18" Cable Wire | 18" Cable Ties (Sold in 50 Pack) | 450mm x 4mm Cable Ties (Sold in 50 Pack)

Unit

Lot

Piece

Tie the
bottom
portion of the
Sieve by
Inserting the
Tie wrap
from B1 hole
into the B2
Hole. Please
refer Fig 5.0
for the hole
assignment

22

Page 31 of 245 | Version 1.0

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

Unit

Lot

Piece

Tighten the
Tie Wrap 23

Page 32 of 245 | Version 1.0

https://drive.
google.com/
drive/folders/
18duHcktmz
T1QRXVuiVt
tSuXc_h-BfB69

Wire
Cutter
Pliers
Name | Description | Metric Conversion | Unit of Measure
Frame | Complete Assembly of the Frame | Complete Assembly of the Frame
Sieve Canister Assembly | Complete and Finished Sieve Assembly | Complete and Finished Sieve Assembly
18" Cable Wire | 18" Cable Ties (Sold in 50 Pack) | 450mm x 4mm Cable Ties (Sold in 50 Pack)

Unit

Lot

Piece

Snip and Cut
the excess
tie wraps

24

Page 33 of 245 | Version 1.0

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

Unit

Lot

Place the
2nd Sieve
into the back
portion of the
Frame. Make
sure Sieve is
on an upright
Position and
is hanging
(PVC Male
Adaptor
Socket) on
the middle
cross piece
of the frame

25

Page 34 of 245 | Version 1.0

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

Unit

Lot

Piece

Tie the upper
portion of the
Sieve by
Inserting the
Tie wrap
from A6 into
the A5 Hole.
Please refer
Fig 5.0 for
the hole
assignement

26

Page 35 of 245 | Version 1.0

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

Unit

Lot

Piece

Tighten the
Tie Wrap 27

Page 36 of 245 | Version 1.0

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

Unit

Lot

Piece

Tie the
bottom
portion of the
Sieve by
Inserting the
Tie wrap
from B4 hole
into the B3
Hole. Please
refer Fig 5.0
for the hole
assignement

28

Page 37 of 245 | Version 1.0

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

Unit

Lot

Piece

Tighten the
Tie Wrap 29

Page 38 of 245 | Version 1.0

https://drive.
google.com/
drive/folders/
18duHcktmz
T1QRXVuiVt
tSuXc_h-BfB69

Wire
Cutter
Pliers
Name | Description | Metric Conversion | Unit of Measure
Frame | Complete Assembly of the Frame | Complete Assembly of the Frame
Sieve Canister Assembly | Complete and Finished Sieve Assembly | Complete and Finished Sieve Assembly
18" Cable Wire | 18" Cable Ties (Sold in 50 Pack) | 450mm x 4mm Cable Ties (Sold in 50 Pack)

Unit

Lot

Piece

Snip and Cut
the excess
tie wraps

30

Page 39 of 245 | Version 1.0

https://drive.
google.com/
drive/folders/
18duHcktmz
T1QRXVuiVt
tSuXc_h-BfB69
Name | Description | Metric Conversion
Unit of
Measure
Frame | Complete Assembly of the Frame | Complete Assembly of the Frame
Surge Tank Assembly | Complete and Finished Surge Tank Assembly | Complete and Finished Surge Tank Assembly

Unit

Lot

Place the
Surge Tank
into the
Frame. Make
sure Surge
tank hanging
on the middle
cross piece
of the frame

31

Page 40 of 245 | Version 1.0

https://drive.
google.com/
drive/folders/
18duHcktmz
T1QRXVuiVt
tSuXc_h-BfB69
Name | Description | Metric Conversion
Unit of
Measure
Frame | Complete Assembly of the Frame | Complete Assembly of the Frame
Surge Tank Assembly | Complete and Finished Surge Tank Assembly | Complete and Finished Surge Tank Assembly
18" Cable Wire | 18" Cable Ties (Sold in 50 Pack) | 450mm x 4mm Cable Ties (Sold in 50 Pack)

Unit

Lot

Piece

Tie the upper
portion of the
Sieve by
Inserting the
Tie wrap
from A4 into
the A3 Hole.
Please refer
Fig 5.0 for
the hole
assignement

32

Page 41 of 245 | Version 1.0

https://drive.
google.com/
drive/folders/
18duHcktmz
T1QRXVuiVt
tSuXc_h-BfB69
Name | Description | Metric Conversion
Unit of
Measure
Frame | Complete Assembly of the Frame | Complete Assembly of the Frame
Surge Tank Assembly | Complete and Finished Surge Tank Assembly | Complete and Finished Surge Tank Assembly
18" Cable Wire | 18" Cable Ties (Sold in 50 Pack) | 450mm x 4mm Cable Ties (Sold in 50 Pack)

Unit

Lot

Piece

Tighten the
Tie Wrap 33

Page 42 of 245 | Version 1.0

https://drive.
google.com/
drive/folders/
18duHcktmz
T1QRXVuiVt
tSuXc_h-BfB69

Wire
Cutter
Pliers
Name | Description | Metric Conversion
Unit of
Measure
Frame | Complete Assembly of the Frame | Complete Assembly of the Frame
Surge Tank Assembly | Complete and Finished Surge Tank Assembly | Complete and Finished Surge Tank Assembly
18" Cable Wire | 18" Cable Ties (Sold in 50 Pack) | 450mm x 4mm Cable Ties (Sold in 50 Pack)

Unit

Lot

Piece

Snip and Cut
the excess
tie wraps

34

Page 43 of 245 | Version 1.0

# Cooper Cooling Coil

Page 44 of 245 | Version 1.0

https://drive.
google.com/
drive/folders/
18duHcktmz
T1QRXVuiVt
tSuXc_h-BfB69

Drill Bit
Machine,
Drill Bit
13/32"
Name | Description | Metric Conversion | Unit of Measure
Sieve PVC Pipe | 3" Schedule 40 PVC Pipe 18" height | 7 mm Schedule 40 (Series 1000) PVC Pipe 431 mm height | Piece

Secure the
PVC Pipe into
the working
table by
placing 2
holes on the
PVC Pipe. 1st
hole around
7" from the
bottom of
the pipe of
the pipe, the
second hole
approximatel
y around 3"
from the
bottom end
of the PVC
Pipe.(same
side with the
1st hole)

35

Page 45 of 245 | Version 1.0

https://drive.
google.com/
drive/folders/
18duHcktmz
T1QRXVuiVt
tSuXc_h-BfB69

Drill Bit
Machine,
Drill bit
5/32"
Name | Description | Metric Conversion | Unit of Measure
Sieve PVC Pipe | 3" Schedule 40 PVC Pipe 18" height | 7 mm Schedule 40 (Series 1000) PVC Pipe 431 mm height | Piece

Put 2 smaller
holes
opposite of
the holes
from step 35

36

Page 46 of 245 | Version 1.0

https://drive.
google.com/
drive/folders/
18duHcktmz
T1QRXVuiVt
tSuXc_h-BfB69
Name | Description | Metric Conversion | Unit of Measure
Sieve PVC Pipe | 3" Schedule 40 PVC Pipe 18" height | 7 mm Schedule 40 (Series 1000) PVC Pipe 431 mm height
Screws | Screws | Screws

Piece

Place
screws on
the 2 smaller
holes

37

Page 47 of 245 | Version 1.0

https://drive.
google.com/
drive/folders/
18duHcktmz
T1QRXVuiVt
tSuXc_h-BfB69

Drill Bit
Machine,
Drill bit
9/32"
Name | Description | Metric Conversion | Unit of Measure
Sieve PVC Pipe | 3" Schedule 40 PVC Pipe 18" height | 7 mm Schedule 40 (Series 1000) PVC Pipe 431 mm height | Piece

Secure the
PVC Pipe by
screwing it
on top of a
table

38

Page 48 of 245 | Version 1.0

https://drive.
google.com/
drive/folders/
18duHcktmz
T1QRXVuiVt
tSuXc_h-BfB69

Drill Bit
Machine,
Drill Bit
1/2"
Name | Description | Metric Conversion | Unit of Measure
Sieve PVC Pipe | 3" Schedule 40 PVC Pipe 18" height | 7 mm Schedule 40 (Series 1000) PVC Pipe 431 mm height | Piece

Drill a hole on
the middle of
the PVC Pipe

39

Page 49 of 245 | Version 1.0

https://drive.
google.com/
drive/folders/
18duHcktmz
T1QRXVuiVt
tSuXc_h-BfB69
Name | Description | Metric Conversion | Unit of Measure
Sieve PVC Pipe | 3" Schedule 40 PVC Pipe 18" height | 7 mm Schedule 40 (Series 1000) PVC Pipe 431 mm height
Copper Tubing | 3/8" OD Copper Tubing (Need around 20') | 10mm OD Copper Tubing (Need around 6m)

Piece

Inch

Insert the
end of the
coil into the
middle hole
of the PVC
Pipe

40

Page 50 of 245 | Version 1.0

https://drive.
google.com/
drive/folders/
18duHcktmz
T1QRXVuiVt
tSuXc_h-BfB69
Name | Description | Metric Conversion | Unit of Measure
Sieve PVC Pipe | 3" Schedule 40 PVC Pipe 18" height | 7 mm Schedule 40 (Series 1000) PVC Pipe 431 mm height
Copper Tubing | 3/8" OD Copper Tubing (Need around 20') | 10mm OD Copper Tubing (Need around 6m)

Piece

Inch

Twist the coil
into the PVC
Pipe until it
will shape
into a spiral.
Ensure no
gaps in
between the
coil

41

Page 51 of 245 | Version 1.0

https://drive.
google.com/
drive/folders/
18duHcktmz
T1QRXVuiVt
tSuXc_h-BfB69
Name | Description | Metric Conversion | Unit of Measure
Sieve PVC Pipe | 3" Schedule 40 PVC Pipe 18" height | 7 mm Schedule 40 (Series 1000) PVC Pipe 431 mm height
Copper Tubing | 3/8" OD Copper Tubing (Need around 20') | 10mm OD Copper Tubing (Need around 6m)

Piece

Inch

Ensure to
have 6-7" of
excess coil
untwisted

42

Page 52 of 245 | Version 1.0

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

Piece

Inch

Remove the
Spiral Coil
from the PVC
Pipe

43

Page 53 of 245 | Version 1.0

https://drive.
google.com/
drive/folders/
18duHcktmz
T1QRXVuiVt
tSuXc_h-BfB69
Name | Description | Metric Conversion | Unit of Measure
Copper Tubing | 3/8" OD Copper Tubing (Need around 20') | 10mm OD Copper Tubing (Need around 6m)
Frame | Complete Assembly of the Frame | Complete Assembly of the Frame

Inch

Unit

Place the
Spiral Coil
(upward
position)on
top of the
PVC Pipe and
twist the
excess/untwi
sted coil
down into
the PVC Pipe.
It will create
one
perpendicula
r hook

44

Page 54 of 245 | Version 1.0

https://drive.
google.com/
drive/folders/
18duHcktmz
T1QRXVuiVt
tSuXc_h-BfB69
Name | Description | Metric Conversion
Unit of
Measure
Copper Tubing | 3/8" OD Copper Tubing (Need around 20') | 10mm OD Copper Tubing (Need around 6m)
Frame | Complete Assembly of the Frame | Complete Assembly of the Frame
Brass Threaded Female -Elbow | Brass 1/4 Male NPT to 1/4" Female NPT - 90 Elbow | Brass 6mm Male NPT to 6mm Female NPT - 90 Elbow

Inch

Unit

Piece

Insert the
Spiral Coil
end
(perpendicul
ar hook) into
Hole 5.
Ensure Spiral
Coil is on an
upward
position and
is positioned
into Hole 1.
Ensure the
end of the
coil(perpendi
cular end)
will reach the
Brass
Threaded
Elbow
Fittings
attached into
the left
output side
of the air
compressor.
Please refer
Fig 4.0 for
the hole
assignement

45

Page 55 of 245 | Version 1.0

https://drive.
google.com/
drive/folders/
18duHcktmz
T1QRXVuiVt
tSuXc_h-BfB69
Name | Description | Metric Conversion
Unit of
Measure
Copper Tubing | 3/8" OD Copper Tubing (Need around 20') | 10mm OD Copper Tubing (Need around 6m)
Frame | Complete Assembly of the Frame | Complete Assembly of the Frame
Brass Threaded Female -Elbow | Brass 1/4 Male NPT to 1/4" Female NPT - 90 Elbow | Brass 6mm Male NPT to 6mm Female NPT - 90 Elbow

Inch

Unit

Piece

Label the
excess end
of the Spiral
Coil
(Perpendicul
ar end).
Enough to
reach the
Brass
Threaded
Elbow Fitting

46

Page 56 of 245 | Version 1.0

https://drive.
google.com/
drive/folders/
18duHcktmz
T1QRXVuiVt
tSuXc_h-BfB69
Name | Description | Metric Conversion | Unit of Measure
Copper Tubing | 3/8" OD Copper Tubing (Need around 20') | 10mm OD Copper Tubing (Need around 6m) | Inch

Remove the
Spiral Coil
from the
frame

47

Page 57 of 245 | Version 1.0

https://drive.
google.com/
drive/folders/
18duHcktmz
T1QRXVuiVt
tSuXc_h-BfB69

Tube
Cutter
Name | Description | Metric Conversion | Unit of Measure
Copper Tubing | 3/8" OD Copper Tubing (Need around 20') | 10mm OD Copper Tubing (Need around 6m) | Inch

Cut the
marked
excess Coil

48

Page 58 of 245 | Version 1.0

https://drive.
google.com/
drive/folders/
18duHcktmz
T1QRXVuiVt
tSuXc_h-BfB69

Tube
Cutter
Name | Description | Metric Conversion | Unit of Measure
Copper Tubing | 3/8" OD Copper Tubing (Need around 20') | 10mm OD Copper Tubing (Need around 6m) | Inch

Clean up and
cut a portion
of the top
end of the
coil. Remove
or cut the
hook portion
of the coil

49

Page 59 of 245 | Version 1.0

https://drive.
google.com/
drive/folders/
18duHcktmz
T1QRXVuiVt
tSuXc_h-BfB69

Screwdriv
er
Name | Description | Metric Conversion | Unit of Measure
Copper Tubing | 3/8" OD Copper Tubing (Need around 20') | 10mm OD Copper Tubing (Need around 6m) | Inch

Clean up the
end of the
coils by
Inserting a
screwdriver
into the
openings. of
the coil

50

Page 60 of 245 | Version 1.0

https://drive.
google.com/
drive/folders/
18duHcktmz
T1QRXVuiVt
tSuXc_h-BfB69
Name | Description | Metric Conversion
Unit of
Measure
Copper Tubing | 3/8" OD Copper Tubing (Need around 20') | 10mm OD Copper Tubing (Need around 6m)
Frame | Complete Assembly of the Frame | Complete Assembly of the Frame
Brass Threaded Female -Elbow | Brass 1/4 Male NPT to 1/4" Female NPT - 90 Elbow | Brass 6mm Male NPT to 6mm Female NPT - 90 Elbow

Inch

Unit

Piece

Insert back
the Spiral
Coil end
(perpendicul
ar hook) into
the Hole 5.
Ensure Spiral
Coil is on an
upward
position and
is placed on
top of Hole 1.
Ensure the
end of the
coil(perpendi
cular end)
will reach the
Brass elbow
fitting on the
air
compressor.
Please refer
Fig 4.0 for
the hole
assignment

51

Page 61 of 245 | Version 1.0

https://drive.
google.com/
drive/folders/
18duHcktmz
T1QRXVuiVt
tSuXc_h-BfB69
Name | Description | Metric Conversion
Unit of
Measure
Copper Tubing | 3/8" OD Copper Tubing (Need around 20') | 10mm OD Copper Tubing (Need around 6m)
Frame | Complete Assembly of the Frame | Complete Assembly of the Frame
Brass Threaded Female to Female -Coupling | Brass 1/4 NPT Female to 1/4" NPT Female -Coupling | Brass 6mm NPT Female to 6mm NPT Female -Coupling

Inch

Unit

Piece

Insert the
Brass
threaded
Female to
Female
Coupling into
the
perpendicula
r end of the
Spiral Coil

52

Page 62 of 245 | Version 1.0

https://drive.
google.com/
drive/folders/
18duHcktmz
T1QRXVuiVt
tSuXc_h-BfB69
Name | Description | Metric Conversion
Unit of
Measure
Copper Tubing | 3/8" OD Copper Tubing (Need around 20') | 10mm OD Copper Tubing (Need around 6m)
Frame | Complete Assembly of the Frame | Complete Assembly of the Frame
Brass Threaded Female to Female -Coupling | Brass 1/4 NPT Female to 1/4" NPT Female -Coupling | Brass 6mm NPT Female to 6mm NPT Female -Coupling
Brass Threaded Female -Elbow | Brass 1/4 Male NPT to 1/4" Female NPT - 90 Elbow | Brass 6mm Male NPT to 6mm Female NPT - 90 Elbow
Air Compressor | California Air Tools SP-9421 2.0HP Ultra Quiet and Oil-Free Air Compressor Motor | California Air Tools SP-9421 2.0HP Ultra Quiet and Oil-Free Air Compressor Motor

Inch

Unit

Piece

Piece

Unit

Connect the
Brass
threaded
Female to
Female
Coupling
from the
Spiral Coil
into the
Brass
Threaded
Elbow
Fittings in the
Air
compressor

53

Page 63 of 245 | Version 1.0

https://drive.
google.com/
drive/folders/
18duHcktmz
T1QRXVuiVt
tSuXc_h-BfB69
Wrench Name | Description | Metric
Conversion

Unit of
Measure
Copper Tubing | 3/8" OD Copper Tubing (Need around 20') | 10mm OD Copper Tubing (Need around 6m)
Frame | Complete Assembly of the Frame | Complete Assembly of the Frame
Brass Threaded Female to Female -Coupling | Brass 1/4 NPT Female to 1/4" NPT Female -Coupling | Brass 6mm NPT Female to 6mm NPT Female -Coupling
Brass Threaded Female -Elbow | Brass 1/4 Male NPT to 1/4" Female NPT - 90 Elbow | Brass 6mm Male NPT to 6mm Female NPT - 90 Elbow
Air Compressor | California Air Tools SP-9421 2.0HP Ultra Quiet and Oil-Free Air Compressor Motor | California Air Tools SP-9421 2.0HP Ultra Quiet and Oil-Free Air Compressor Motor

Inch

Unit

Piece

Piece

Unit

Tighten the
connection 54

Page 64 of 245 | Version 1.0

https://drive.
google.com/
drive/folders/
18duHcktmz
T1QRXVuiVt
tSuXc_h-BfB69
Name | Description | Metric Conversion | Unit of Measure
Copper Tubing | 3/8" OD Copper Tubing (Need around 20') | 10mm OD Copper Tubing (Need around 6m)
Straight Push to connect fittings | | 10mm Push to Connect to 10mm Push to Connect -Straight

Inch

Piece

Place
Straight Push
to connect
fittings on
the top
portion end
of the spiral
coil

55

Page 65 of 245 | Version 1.0

# Fan Installation

Page 66 of 245 | Version 1.0

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

Inch

Unit

Remove the
Spiral Coil
from the
Hole 1.
Please refer
Fig 4.0 for
the hole
assignment

56

Page 67 of 245 | Version 1.0

https://drive.
google.com/
drive/folders/
18duHcktmz
T1QRXVuiVt
tSuXc_h-BfB69
Name | Description | Metric Conversion | Unit of Measure
Frame | Complete Assembly of the Frame | Complete Assembly of the Frame
Cooling Fan | 120V AC 120mm High Speed Cooling Fan | 220/120V AC 120mm High Speed Cooling Fan

Unit

Pieces

Place Fan
Deck on top
of the Hole

### 1. Please

refer Fig

### 4.0 for the

hole
assignment

57

Page 68 of 245 | Version 1.0

https://drive.
google.com/
drive/folders/
18duHcktmz
T1QRXVuiVt
tSuXc_h-BfB69
Name | Description | Metric Conversion | Unit of Measure
Frame | Complete Assembly of the Frame | Complete Assembly of the Frame
Cooling Fan | 120V AC 120mm High Speed Cooling Fan | 220/120V AC 120mm High Speed Cooling Fan

Unit

Pieces

Align the Fan
Deck into
Hole 1.
Please refer
Fig 4.0 for
the hole
assignment

58

Page 69 of 245 | Version 1.0

https://drive.
google.com/
drive/folders/
18duHcktmz
T1QRXVuiVt
tSuXc_h-BfB69
Ruler Name | Description | Metric Conversion | Unit of
Measure
Frame | Complete Assembly of the Frame | Complete Assembly of the Frame
Cooling Fan | 120V AC 120mm High Speed Cooling Fan | 220/120V AC 120mm High Speed Cooling Fan

Unit

Pieces

Measure the

### 2 side gaps

between the
Fan Deck
and the edge
of the Board.
Ensure gap
measurement
is the same.

59

Page 70 of 245 | Version 1.0

https://drive.
google.com/
drive/folders/
18duHcktmz
T1QRXVuiVt
tSuXc_h-BfB69

Wood
Clamp
Name | Description | Metric Conversion | Unit of Measure
Frame | Complete Assembly of the Frame | Complete Assembly of the Frame
Cooling Fan | 120V AC 120mm High Speed Cooling Fan | 220/120V AC 120mm High Speed Cooling Fan

Unit

Pieces

Clamp the
Fan
Deck(without
the
grill/screen)
into the
board.

60

Page 71 of 245 | Version 1.0

https://drive.
google.com/
drive/folders/
18duHcktmz
T1QRXVuiVt
tSuXc_h-BfB69

Drill Bit
Machine,
Drill bit
9/32"
Name | Description | Metric Conversion | Unit of Measure
Frame | Complete Assembly of the Frame | Complete Assembly of the Frame
Cooling Fan | 120V AC 120mm High Speed Cooling Fan | 220/120V AC 120mm High Speed Cooling Fan

Unit

Pieces

Drill the 4
sides of the
Fan Deck
into the
board

61

Page 72 of 245 | Version 1.0

https://dri
ve.google
.com/driv
e/folders/
18duHckt
mzT1QR
XVuiVttS
uXc_h-BfB69

Drill Bit
Machine,
Drill bit
9/32",
Wood
Clamp,
Ruler
Name | Description | Metric Conversion | Unit of Measure
Frame | Complete Assembly of the Frame | Complete Assembly of the Frame
Cooling Fan | 120V AC 120mm High Speed Cooling Fan | 220/120V AC 120mm High Speed Cooling Fan

Unit

Pieces

Do the same
steps on the
2nd Cooling
Fan in Hole 2

62

Page 73 of 245 | Version 1.0

https://drive.
google.com/
drive/folders/
18duHcktmz
T1QRXVuiVt
tSuXc_h-BfB69
Name | Description | Metric Conversion
Unit of
Measure
Frame | Complete Assembly of the Frame | Complete Assembly of the Frame
Cooling Fan | 120V AC 120mm High Speed Cooling Fan | 220/120V AC 120mm High Speed Cooling Fan
Air Compressor | California Air Tools SP-9421 2.0HP Ultra Quiet and Oil-Free Air Compressor Motor | California Air Tools SP-9421 2.0HP Ultra Quiet and Oil-Free Air Compressor Motor

Unit

Pieces

Unit

Position the
Fan deck
below the
frame. On
top of the air
compressor.
Ensure the
position of
fan is
towards
(arrow going
down) the air
compressor.
The fan is for
the air
compressor

63

Page 74 of 245 | Version 1.0

https://drive.
google.com/
drive/folders/
18duHcktmz
T1QRXVuiVt
tSuXc_h-BfB69
Name | Description | Metric Conversion | Unit of Measure
Frame | Complete Assembly of the Frame | Complete Assembly of the Frame
Cooling Fan | 120V AC 120mm High Speed Cooling Fan | 220/120V AC 120mm High Speed Cooling Fan
6/32" Allen screws | 6/32" Allen screws | 5 mm Allen screws

Unit

Pieces

Washer Nuts | Washer and Nuts | Washer and Nuts | Set
Place 2
screws with
washer and
nuts on the
holes.
Diagonal
opposite
sides

64

Page 75 of 245 | Version 1.0

https://drive.
google.com/
drive/folders/
18duHcktmz
T1QRXVuiVt
tSuXc_h-BfB69

Wood
Clamp
Name | Description | Metric Conversion | Unit of Measure
Frame | Complete Assembly of the Frame | Complete Assembly of the Frame
Cooling Fan | 120V AC 120mm High Speed Cooling Fan | 220/120V AC 120mm High Speed Cooling Fan

Unit

Pieces

Clamp the
Fan Deck
into the
board

65

Page 76 of 245 | Version 1.0

https://drive.
google.com/
drive/folders/
18duHcktmz
T1QRXVuiVt
tSuXc_h-BfB69

Allen
head,
5/16"
wrench
Name | Description | Metric Conversion | Unit of Measure
Frame | Complete Assembly of the Frame | Complete Assembly of the Frame
Cooling Fan | 120V AC 120mm High Speed Cooling Fan | 220/120V AC 120mm High Speed Cooling Fan
6/32" Allen screws | 6/32" Allen screws | 5 mm Allen screws
Washer Nuts | Washer and Nuts | Washer and Nuts | Set Tighten the

Unit

Pieces

screws and
nuts on the
Fan deck

66

Page 77 of 245 | Version 1.0

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

Inch

Unit

Postion back
the spiral Coil 67

Page 78 of 245 | Version 1.0

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

Rubber clamp

Cooling Fan | 120V AC 120mm High Speed Cooling Fan | 220/120V AC 120mm High Speed Cooling Fan
Copper Tubing | 3/8" OD Copper Tubing (Need around 20') | 10mm OD Copper Tubing (Need around 6m)
Rubber clamp | Rubber clamp | Piece
| | Pieces

Inch

Place Rubber
Clamp on the
Spiral Coil
with the Fan
deck. Hook
the rubber
clamp (sides
of the Fan
deck without
screws) into
the 1st layer
of the coil
and into the
board.

68

Page 79 of 245 | Version 1.0

https://drive.
google.com/
drive/folders/
18duHcktmz
T1QRXVuiVt
tSuXc_h-BfB69
Name | Description | Metric Conversion | Unit of Measure
Frame | Complete Assembly of the Frame | Complete Assembly of the Frame
Cooling Fan | 120V AC 120mm High Speed Cooling Fan | 220/120V AC 120mm High Speed Cooling Fan
6/32" Allen screws | 6/32" Allen screws | 5 mm Allen screws

Unit

Pieces

Washer Nuts | Washer and Nuts | Washer and Nuts | Set

Copper
Tubing

3/8" OD Copper
Tubing (Need
around 20')

10mm OD Copper
Tubing (Need
around 6m)

Inch

Secure the
Rubber
Clamps by
placing
Screws,
washer and
nuts

69

Page 80 of 245 | Version 1.0

https://drive.
google.com/
drive/folders/
18duHcktmz
T1QRXVuiVt
tSuXc_h-BfB69

Allen
head,
5/16"
wrench
Name | Description | Metric Conversion | Unit of Measure
Frame | Complete Assembly of the Frame | Complete Assembly of the Frame
Cooling Fan | 120V AC 120mm High Speed Cooling Fan | 220/120V AC 120mm High Speed Cooling Fan
6/32" Allen screws | 6/32" Allen screws | 5 mm Allen screws

Unit

Pieces

Washer Nuts | Washer and Nuts | Washer and Nuts | Set

Copper
Tubing

3/8" OD Copper
Tubing (Need
around 20')

10mm OD Copper
Tubing (Need
around 6m)

Inch

Tighten the
screws and
nuts on the
Fan deck

70

Page 81 of 245 | Version 1.0

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

Expand the
Spiral Coils.
Ensure to
have even
spaces in
between the
coils

71

Page 82 of 245 | Version 1.0

https://drive.
google.com/
drive/folders/
18duHcktmz
T1QRXVuiVt
tSuXc_h-BfB69
Name | Description | Metric Conversion | Unit of Measure
Cooling Fan | 120V AC 120mm High Speed Cooling Fan | 220/120V AC 120mm High Speed Cooling Fan
Frame | Complete Assembly of the Frame | Complete Assembly of the Frame

Pieces

Unit

Place the
2nd Fan deck
below Hole

### 2. Ensure

wirings are
positioned
unto the
back portion
and the flow
of the air is
towards the
air
compressor.
Please refer
Fig 4.0 for
the hole
assignment

72

Page 83 of 245 | Version 1.0

https://drive.
google.com/
drive/folders/
18duHcktmz
T1QRXVuiVt
tSuXc_h-BfB69
Name | Description | Metric Conversion | Unit of Measure
Cooling Fan | 120V AC 120mm High Speed Cooling Fan | 220/120V AC 120mm High Speed Cooling Fan
Frame | Complete Assembly of the Frame | Complete Assembly of the Frame

Pieces

Unit

Place the
screen/grill
of the fan on
top of the
Hole.
Please refer
Fig 4.0 for
the hole
assignment

73

Page 84 of 245 | Version 1.0

https://drive.
google.com/
drive/folders/
18duHcktmz
T1QRXVuiVt
tSuXc_h-BfB69
Name | Description | Metric Conversion | Unit of Measure
Cooling Fan | 120V AC 120mm High Speed Cooling Fan | 220/120V AC 120mm High Speed Cooling Fan
Frame | Complete Assembly of the Frame | Complete Assembly of the Frame
6/32" Allen screws | 6/32" Allen screws | 5 mm Allen screws

Pieces

Unit

Washer Place | Nuts | Washer and Nuts | Washer and Nuts | Set

screws,
washers and
nuts on each
sides

74

Page 85 of 245 | Version 1.0

https://drive.
google.com/
drive/folders/
18duHcktmz
T1QRXVuiVt
tSuXc_h-BfB69

Wood
Clamp
Name | Description | Metric Conversion | Unit of Measure
Cooling Fan | 120V AC 120mm High Speed Cooling Fan | 220/120V AC 120mm High Speed Cooling Fan
Frame | Complete Assembly of the Frame | Complete Assembly of the Frame
6/32" Allen screws | 6/32" Allen screws | 5 mm Allen screws
Washer Nuts | Washer and Nuts | Washer and Nuts | Set Clamp the

Pieces

Unit

Fan Deck
into the
board

75

Page 86 of 245 | Version 1.0

https://drive.
google.com/
drive/folders/
18duHcktmz
T1QRXVuiVt
tSuXc_h-BfB69

Allen
head,
5/16"
wrench
Name | Description | Metric Conversion | Unit of Measure
Cooling Fan | 120V AC 120mm High Speed Cooling Fan | 220/120V AC 120mm High Speed Cooling Fan
Frame | Complete Assembly of the Frame | Complete Assembly of the Frame
6/32" Allen screws | 6/32" Allen screws | 5 mm Allen screws
Washer Nuts | Washer and Nuts | Washer and Nuts | Set Tighten the

Pieces

Unit

screws and
nuts on the
Fan deck

76

Page 87 of 245 | Version 1.0

# Brain Installation

Page 88 of 245 | Version 1.0

https://drive.
google.com/
drive/folders/
18duHcktmz
T1QRXVuiVt
tSuXc_h-BfB69
Name | Description | Metric Conversion
Unit of
Measure
Terminal Block Breakout Shield Nano/Micro | DIN Rail Mount Screw Terminal Block Breakout Module Board for Arduino Nano/Micro. (Option 2 for Arduino Terminal Adaptor must match Arduino Processor) | DIN Rail Mount Screw Terminal Block Breakout Module Board for Arduino Nano/Micro. (Option 2 for Arduino Terminal Adaptor must match Arduino Processor)

DIN Rail Mount

Arduino 33 IoT | Arduino 33 IoT (Option 1 for Arduino Processor) | Arduino 33 IoT (Option 1 for Arduino Processor)

Unit

DIN Rail Mount | DIN Rail Mount | Unit
| | Unit

Remove the
Terminal
Block
Breakout
Shield and
the Power
Supply from
the Din Rail
Mount

77

Page 89 of 245 | Version 1.0

https://drive.
google.com/
drive/folders/
18duHcktmz
T1QRXVuiVt
tSuXc_h-BfB69

Drill Bit
Machine
Name | Description | Metric Conversion
Unit of
Measure
Terminal Block Breakout Shield Nano/Micro | DIN Rail Mount Screw Terminal Block Breakout Module Board for Arduino Nano/Micro. (Option 2 for Arduino Terminal Adaptor must match Arduino Processor) | DIN Rail Mount Screw Terminal Block Breakout Module Board for Arduino Nano/Micro. (Option 2 for Arduino Terminal Adaptor must match Arduino Processor)

DIN Rail Mount

Screws | Screws | Screws
Arduino 33 IoT | Arduino 33 IoT (Option 1 for Arduino Processor) | Arduino 33 IoT (Option 1 for Arduino Processor)

Unit

DIN Rail Mount | DIN Rail Mount | Unit

Unit

Drill a screw
into the 1st
hole of the
DIN Rail
Mount into
the sides of
the Frame.
(Beside the
Sieve
Canister and
Spiral Coil)

78

Page 90 of 245 | Version 1.0

https://drive.
google.com/
drive/folders/
18duHcktmz
T1QRXVuiVt
tSuXc_h-BfB69
Name | Description | Metric Conversion
Unit of
Measure
Terminal Block Breakout Shield Nano/Micro | DIN Rail Mount Screw Terminal Block Breakout Module Board for Arduino Nano/Micro. (Option 2 for Arduino Terminal Adaptor must match Arduino Processor) | DIN Rail Mount Screw Terminal Block Breakout Module Board for Arduino Nano/Micro. (Option 2 for Arduino Terminal Adaptor must match Arduino Processor)

DIN Rail Mount

Screws | Screws | Screws
Arduino 33 IoT | Arduino 33 IoT (Option 1 for Arduino Processor) | Arduino 33 IoT (Option 1 for Arduino Processor)

Unit

DIN Rail Mount | DIN Rail Mount | Unit

Unit

Place the
Terminal
Block Break
Out Shield
back into the
DIN Rail
Mount

79

Page 91 of 245 | Version 1.0

https://drive.
google.com/
drive/folders/
18duHcktmz
T1QRXVuiVt
tSuXc_h-BfB69

Drill Bit
Machine
Name | Description | Metric Conversion
Unit of
Measure
Terminal Block Breakout Shield Nano/Micro | DIN Rail Mount Screw Terminal Block Breakout Module Board for Arduino Nano/Micro. (Option 2 for Arduino Terminal Adaptor must match Arduino Processor) | DIN Rail Mount Screw Terminal Block Breakout Module Board for Arduino Nano/Micro. (Option 2 for Arduino Terminal Adaptor must match Arduino Processor)
Arduino Nano | Arduino Nano (Option 2 for Arduino Processor) | Arduino Nano (Option 2 for Arduino Processor)

DIN Rail Mount

Screws | Screws | Screws
Bracket Holder Carrier Clips/Barrier Strip | PCB DIN Rail Mounting Adapter Circuit Board Mounting Bracket Holder, Carrier Clips, for 35mm, 15mm DIN Rail (Green) | PCB DIN Rail Mounting Adapter Circuit Board Mounting Bracket Holder, Carrier Clips, for 35mm, 15mm DIN Rail (Green)

Unit

Unit

DIN Rail Mount | DIN Rail Mount | Unit

Unit

Drill a screw
into the hole
of the DIN
Rail Mount
below the
Barrier Strip

80

Page 92 of 245 | Version 1.0

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

DIN Rail Mount

Screws | Screws | Screws
Bracket Holder Carrier Clips/Barrier Strip | PCB DIN Rail Mounting Adapter Circuit Board Mounting Bracket Holder, Carrier Clips, for 35mm, 15mm DIN Rail (Green) | PCB DIN Rail Mounting Adapter Circuit Board Mounting Bracket Holder, Carrier Clips, for 35mm, 15mm DIN Rail (Green)
Arduino 33 IoT | Arduino 33 IoT (Option 1 for Arduino Processor) | Arduino 33 IoT (Option 1 for Arduino Processor)

Unit

DIN Rail Mount | DIN Rail Mount | Unit

Unit

Unit

Place the
Power
Supply back
onto the DIN
Rail Mount

81

Page 93 of 245 | Version 1.0

https://drive.
google.com/
drive/folders/
18duHcktmz
T1QRXVuiVt
tSuXc_h-BfB69
Name | Description | Metric Conversion | Unit of Measure
Brain Assembly | End Product of the Brain Assembly | End Product of the Brain Assembly
Cooling Fan | 120V AC 120mm High Speed Cooling Fan | 220/120V AC 120mm High Speed Cooling Fan

Lot

Pieces

Connect the
Fan wirings
from the
Brain into the
Fan Decks

82

Page 94 of 245 | Version 1.0

https://drive.
google.com/
drive/folders/
18duHcktmz
T1QRXVuiVt
tSuXc_h-BfB69
Name | Description | Metric Conversion | Unit of Measure
2- way Solenoid Valve | 2/2 Direct Acting Solenoid Valve 1/4" ports 110V AC | Direct Acting Solenoid Valve 10mm ports 110/220VAC 50/60Hz
3- way Solenoid Valve | 3/8" NPT 3-Way Solenoid Valve, 110 V AC | 10mm FNPT 3 Port 2 Way Solenoid Valve, 110/220 VAC 50/60Hz

Unit

Unit

Position the
valves into
the Frame. 2
units of 3-
way Solenoid
Valve placed
under the
Sieve
Canister
Assembly,
and 1 unit 2-
way Solenoid
Valve on top
of the top
cross piece.

83

Page 95 of 245 | Version 1.0

# Pressure Regulator Mounting

Page 96 of 245 | Version 1.0

https://drive.
google.com/
drive/folders/
18duHcktmz
T1QRXVuiVt
tSuXc_h-BfB69
Name | Description | Metric Conversion | Unit of Measure
Pressure Regulator | Low Pressure Regulator 3 to 30PSI | Low Pressure Regulator 3 Mpa to 30 Mpa 6.35mm FNPT Ports | Unit

Remove the
Gauge from
the Pressure
Regulator

84

Page 97 of 245 | Version 1.0

https://drive.
google.com/
drive/folders/
18duHcktmz
T1QRXVuiVt
tSuXc_h-BfB69
Name | Description | Metric Conversion | Unit of Measure
Pressure Regulator | Low Pressure Regulator 3 to 30PSI | Low Pressure Regulator 3 Mpa to 30 Mpa 6.35mm FNPT Ports | Unit

Place a teflon
tape on the
gauge

85

Page 98 of 245 | Version 1.0

https://drive.
google.com/
drive/folders/
18duHcktmz
T1QRXVuiVt
tSuXc_h-BfB69
Name | Description | Metric Conversion | Unit of Measure
Pressure Regulator | Low Pressure Regulator 3 to 30PSI | Low Pressure Regulator 3 Mpa to 30 Mpa 6.35mm FNPT Ports | Unit

Reattach the
gauge into
the Pressure
regulator

86

Page 99 of 245 | Version 1.0

https://drive.
google.com/
drive/folders/
18duHcktmz
T1QRXVuiVt
tSuXc_h-BfB69
Wrench Name | Description | Metric Conversion | Unit of
Measure

Pressure
Regulator

Low Pressure
Regulator 3
to 30PSI

Low Pressure Regulator

### 3 Mpa to 30 Mpa

6.35mm FNPT Ports

Unit

Tighten the
Gauge 87

Page 100 of 245 | Version 1.0

https://www.
dropbox.com
/sh/ny5zjc07
flfr7w5/AABn
1HDv42Nn4l
SACj989yU3
a/Video?dl=
0&preview=
OxiKit+Final
+Assembly+
Tutorial+3+o
f+4.MP4&su
bfolder_nav_
tracking=1
Name | Description | Metric Conversion | Unit of Measure
Pressure Regulator | Low Pressure Regulator 3 to 30PSI | Low Pressure Regulator 3 Mpa to 30 Mpa 6.35mm FNPT Ports
1/4" Male Elbow Push-in Connect Fittings | 1/4" Male NPT to 3/8"Push to Connect - 90 Elbow | 6mm Male NPT to 6mm Push to Connect - 90 Elbow

Unit

Piece

Connect
Elbow fittings
into 2 sides
the Pressure
Regulator

88

Page 101 of 245 | Version 1.0

https://www.
dropbox.com
/sh/ny5zjc07
flfr7w5/AABn
1HDv42Nn4l
SACj989yU3
a/Video?dl=
0&preview=
OxiKit+Final
+Assembly+
Tutorial+3+o
f+4.MP4&su
bfolder_nav_
tracking=1
Wrench Name | Description | Metric Conversion | Unit of
Measure
Pressure Regulator | Low Pressure Regulator 3 to 30PSI | Low Pressure Regulator 3 Mpa to 30 Mpa 6.35mm FNPT Ports
1/4" Male Elbow Push-in Connect Fittings | 1/4" Male NPT to 3/8"Push to Connect - 90 Elbow | 6mm Male NPT to 6mm Push to Connect - 90 Elbow

Unit

Piece

Tighten the
Fittings 89

Page 102 of 245 | Version 1.0

https://www.
dropbox.com
/sh/ny5zjc07
flfr7w5/AABn
1HDv42Nn4l
SACj989yU3
a/Video?dl=
0&preview=
OxiKit+Final
+Assembly+
Tutorial+3+o
f+4.MP4&su
bfolder_nav_
tracking=1
Name | Description | Metric Conversion | Unit of Measure
Pressure Regulator | Low Pressure Regulator 3 to 30PSI | Low Pressure Regulator 3 Mpa to 30 Mpa 6.35mm FNPT Ports
1/4" Male Elbow Push-in Connect Fittings | 1/4" Male NPT to 3/8"Push to Connect - 90 Elbow | 6mm Male NPT to 6mm Push to Connect - 90 Elbow

Unit

Piece

Loosen the
Bracket
Retain ring

90

Page 103 of 245 | Version 1.0

https://www.
dropbox.com
/sh/ny5zjc07
flfr7w5/AABn
1HDv42Nn4l
SACj989yU3
a/Video?dl=
0&preview=
OxiKit+Final
+Assembly+
Tutorial+3+o
f+4.MP4&su
bfolder_nav_
tracking=1
Name | Description | Metric Conversion | Unit of Measure
Elbow Push-in Connect Fittings | 3/8"Push to Connect to 3/8"Push to Connect - 90 Elbow | 10mm Push to Connect to 10mm Push to Connect -90 Elbow
Pressure Regulator | Low Pressure Regulator 3 to 30PSI | Low Pressure Regulator 3 Mpa to 30 Mpa 6.35mm FNPT Ports
Pressure Regulator Bracket | Pressure Regulator Bracket | Pressure Regulator Bracket
Frame | Complete Assembly of the Frame | Complete Assembly of the Frame

Piece

Unit

Piece

Unit

Mount the
Regulator
into the
Frame (left
Side) Below
the Fan Deck

91

Page 104 of 245 | Version 1.0

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

Drill Bit
Machine
Name | Description | Metric Conversion
Unit of
Measure
Pressure Regulator Bracket | Pressure Regulator Bracket | Pressure Regulator Bracket
Screws | Screws | Screws
Frame | Complete Assembly of the Frame | Complete Assembly of the Frame

Piece

Unit

Secure the
Bracket by
placing
screws into
the Bracket.

92

Page 105 of 245 | Version 1.0

https://www.
dropbox.com
/sh/ny5zjc07
flfr7w5/AABn
1HDv42Nn4l
SACj989yU3
a/Video?dl=
0&preview=
OxiKit+Final
+Assembly+
Tutorial+3+o
f+4.MP4&su
bfolder_nav_
tracking=1
Name | Description | Metric Conversion
Unit of
Measure
Pressure Regulator Bracket | Pressure Regulator Bracket | Pressure Regulator Bracket
Screws | Screws | Screws
Frame | Complete Assembly of the Frame | Complete Assembly of the Frame

Piece

Unit

Attach the
Regulator
into the
mounted
Bracket.

93

Page 106 of 245 | Version 1.0

https://www.
dropbox.com
/sh/ny5zjc07
flfr7w5/AABn
1HDv42Nn4l
SACj989yU3
a/Video?dl=
0&preview=
OxiKit+Final
+Assembly+
Tutorial+3+o
f+4.MP4&su
bfolder_nav_
tracking=1
Name | Description | Metric Conversion
Unit of
Measure
Pressure Regulator Bracket | Pressure Regulator Bracket | Pressure Regulator Bracket
Screws | Screws | Screws
Frame | Complete Assembly of the Frame | Complete Assembly of the Frame

Piece

Unit

Reattach the
Bracket
Retain Ring
to secure the
Pressure
regulator into
the Bracket.

94

Page 107 of 245 | Version 1.0

# Gas Flow Meter Mounting

Page 108 of 245 | Version 1.0

https://www.
dropbox.com
/sh/ny5zjc07
flfr7w5/AABn
1HDv42Nn4l
SACj989yU3
a/Video?dl=
0&preview=
OxiKit+Final
+Assembly+
Tutorial+3+o
f+4.MP4&su
bfolder_nav_
tracking=1
Pencil Name | Description | Metric
Conversion

Unit of
Measure
Gas | 3-30LPM LZQ-7 | 3-30LPM LZQ-7 | Unit
Flowmeter | Oxygen Air Gas | Oxygen Air Gas
| Flowmeter (Only | Flowmeter (Only
| Need 15 LPM | Need 15 LPM
| Max, Avoid SHLLJ | Max, Avoid SHLLJ
| Brand - Marked | Brand - Marked
| Wrong) | Wrong)

Mark the
position of
the Gas
Flowmeter
into the
Frame(left
side, beside
the top
portion of the
Sieve)

95

Page 109 of 245 | Version 1.0

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

Drill Bit
Machine,
Drill Bit
1/2"
Name | Description | Metric
| | Conversion | Unit of
| | | Measure
Gas | 3-30LPM LZQ-7 | 3-30LPM LZQ-7 | Unit
Flowmeter | Oxygen Air Gas | Oxygen Air Gas
| Flowmeter (Only | Flowmeter (Only
| Need 15 LPM | Need 15 LPM
| Max, Avoid SHLLJ | Max, Avoid SHLLJ
| Brand - Marked | Brand - Marked
| Wrong) | Wrong)

Drill holes
into the
labelled
position of
the Gas
Flowmeter

96

Page 110 of 245 | Version 1.0

# Oxygen Connection Circuit

### Please refer to Fig 2 and 3.0 for this section of the workflow

Page 111 of 245 | Version 1.0

https://www.
dropbox.com
/sh/ny5zjc07
flfr7w5/AABn
1HDv42Nn4l
SACj989yU3
a/Video?dl=
0&preview=
OxiKit+Final
+Assembly+
Tutorial+3+o
f+4.MP4&su
bfolder_nav_
tracking=1
Ruler Name | Description | Metric Conversion | Unit of
Measure

Tubing High Density
Polyethylene
(HDPE) Tubing, 1/4"
ID, 3/8" OD (10 Feet
Per Machine
Required)

High Density
Polyethylene (HDPE)
Tubing, 6mm ID,
10mm OD (3 meters
Per Machine
Required)

meter

Measure 1.5"
or
40mmTube

97

Page 112 of 245 | Version 1.0

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

Scissors/
Cutter
Name | Description | Metric Conversion | Unit of Measure
Tubing | High Density Polyethylene (HDPE) Tubing, 1/4" ID, 3/8" OD (10 Feet Per Machine Required) | High Density Polyethylene (HDPE) Tubing, 6mm ID, 10mm OD (3 meters Per Machine Required) | meter

Cut 7
Tubings with
1.5" or 40mm
length

98

Page 113 of 245 | Version 1.0

https://www.
dropbox.com
/sh/ny5zjc07
flfr7w5/AABn
1HDv42Nn4l
SACj989yU3
a/Video?dl=
0&preview=
OxiKit+Final
+Assembly+
Tutorial+3+o
f+4.MP4&su
bfolder_nav_
tracking=1
Ruler Name | Description | Metric Conversion | Unit of
Measure

Tubing High Density
Polyethylene
(HDPE) Tubing, 1/4"
ID, 3/8" OD (10 Feet
Per Machine
Required)

High Density
Polyethylene (HDPE)
Tubing, 6mm ID,
10mm OD (3 meters
Per Machine
Required)

meter

Measure 2"
or 50mm
Tube

99

Page 114 of 245 | Version 1.0

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

Scissors/
Cutter
Name | Description | Metric Conversion | Unit of Measure
Tubing | High Density Polyethylene (HDPE) Tubing, 1/4" ID, 3/8" OD (10 Feet Per Machine Required) | High Density Polyethylene (HDPE) Tubing, 6mm ID, 10mm OD (3 meters Per Machine Required) | meter

Cut 2
Tubings with
2" or 50mm
length

100

Page 115 of 245 | Version 1.0

https://www.
dropbox.com
/sh/ny5zjc07
flfr7w5/AABn
1HDv42Nn4l
SACj989yU3
a/Video?dl=
0&preview=
OxiKit+Final
+Assembly+
Tutorial+3+o
f+4.MP4&su
bfolder_nav_
tracking=1
Ruler Name | Description | Metric Conversion | Unit of
Measure

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

High Density
Polyethylene (HDPE)
Tubing, 6mm ID,
10mm OD (3 meters
Per Machine
Required)

meter

Measure 4"
or 104mm
Tube

101

Page 116 of 245 | Version 1.0

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

Scissors/
Cutter
Name | Description | Metric Conversion | Unit of Measure
Tubing | High Density Polyethylene (HDPE) Tubing, 1/4" ID, 3/8" OD (10 Feet Per Machine Required) | High Density Polyethylene (HDPE) Tubing, 6mm ID, 10mm OD (3 meters Per Machine Required) | meter

Cut 2
Tubings with
4" or 104mm
length

102

Page 117 of 245 | Version 1.0

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

High Density
Polyethylene (HDPE)
Tubing, 6mm ID,
10mm OD (3 meters
Per Machine
Required)

meter

Measure 2"
or 50mm
Tube with
Orifice

103

Page 118 of 245 | Version 1.0

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

Cut 2
Tubings with
2" or 50mm
tube with
Orifices

104

Page 119 of 245 | Version 1.0

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

High Density
Polyethylene (HDPE)
Tubing, 6mm ID,
10mm OD (3 meters
Per Machine
Required)

meter

Measure 3"
or 80mm
Tube with
Orifice

105

Page 120 of 245 | Version 1.0

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

Cut Tubing
with 3" or
80mm Tube
with Orifices

106

Page 121 of 245 | Version 1.0

https://www.
dropbox.com
/sh/ny5zjc07
flfr7w5/AABn
1HDv42Nn4l
SACj989yU3
a/Video?dl=
0&preview=
OxiKit+Final
+Assembly+
Tutorial+3+o
f+4.MP4&su
bfolder_nav_
tracking=1
Name | Description | Metric Conversion | Unit of Measure
Elbow Push-in Connect Fittings | 3/8"Push to Connect to 3/8"Push to Connect - 90 Elbow | 10mm Push to Connect to 10mm Push to Connect -90 Elbow
Tubing | High Density Polyethylene (HDPE) Tubing, 1/4" ID, 3/8" OD (10 Feet Per Machine Required) | High Density Polyethylene (HDPE) Tubing, 6mm ID, 10mm OD (3 meters Per Machine Required)

Piece

meter

Connect the
3' or 80mm
Tubing with
Orifice to the
1st Elbow
Fitting

107

Page 122 of 245 | Version 1.0

https://www.
dropbox.com
/sh/ny5zjc07
flfr7w5/AABn
1HDv42Nn4l
SACj989yU3
a/Video?dl=
0&preview=
OxiKit+Final
+Assembly+
Tutorial+3+o
f+4.MP4&su
bfolder_nav_
tracking=1
Name | Description | Metric Conversion | Unit of Measure
Elbow Push-in Connect Fittings | 3/8"Push to Connect to 3/8"Push to Connect - 90 Elbow | 10mm Push to Connect to 10mm Push to Connect -90 Elbow
Tubing | High Density Polyethylene (HDPE) Tubing, 1/4" ID, 3/8" OD (10 Feet Per Machine Required) | High Density Polyethylene (HDPE) Tubing, 6mm ID, 10mm OD (3 meters Per Machine Required)

Piece

meter

Connect the
other end of
the 1st
Elbow Fitting
with the 1st
1.5" or 40mm
tube

108

Page 123 of 245 | Version 1.0

https://www.
dropbox.com
/sh/ny5zjc07
flfr7w5/AABn
1HDv42Nn4l
SACj989yU3
a/Video?dl=
0&preview=
OxiKit+Final
+Assembly+
Tutorial+3+o
f+4.MP4&su
bfolder_nav_
tracking=1
Name | Description | Metric Conversion | Unit of Measure
Tee Push to connect fittings | 3/8"Push to Connect to 3/8"Push to Connect to 3/8"Push to Connect - Tee | 10mm Push to Connect to 10mm Push to Connect -Tee
Tubing | High Density Polyethylene (HDPE) Tubing, 1/4" ID, 3/8" OD (10 Feet Per Machine Required) | High Density Polyethylene (HDPE) Tubing, 6mm ID, 10mm OD (3 meters Per Machine Required)

Piece

meter

Connect the
other end of
the 1st 1.5" or
40mm to the
1st
Tee(middle
portion)
fitting

109

Page 124 of 245 | Version 1.0

https://www.
dropbox.com
/sh/ny5zjc07
flfr7w5/AABn
1HDv42Nn4l
SACj989yU3
a/Video?dl=
0&preview=
OxiKit+Final
+Assembly+
Tutorial+3+o
f+4.MP4&su
bfolder_nav_
tracking=1
Name | Description | Metric Conversion | Unit of Measure
Tee Push to connect fittings | 3/8"Push to Connect to 3/8"Push to Connect to 3/8"Push to Connect - Tee | 10mm Push to Connect to 10mm Push to Connect -Tee
Tubing | High Density Polyethylene (HDPE) Tubing, 1/4" ID, 3/8" OD (10 Feet Per Machine Required) | High Density Polyethylene (HDPE) Tubing, 6mm ID, 10mm OD (3 meters Per Machine Required)

Piece

meter

Connect the
other end of
the 1st Tee
Fitting(Right
portion) to
the 1st 2" or
50mm tubing
with Orifice

110

Page 125 of 245 | Version 1.0

https://www.
dropbox.com
/sh/ny5zjc07
flfr7w5/AABn
1HDv42Nn4l
SACj989yU3
a/Video?dl=
0&preview=
OxiKit+Final
+Assembly+
Tutorial+3+o
f+4.MP4&su
bfolder_nav_
tracking=1
Name | Description | Metric Conversion | Unit of Measure
Tee Push to connect fittings | 3/8"Push to Connect to 3/8"Push to Connect to 3/8"Push to Connect - Tee | 10mm Push to Connect to 10mm Push to Connect -Tee
Tubing | High Density Polyethylene (HDPE) Tubing, 1/4" ID, 3/8" OD (10 Feet Per Machine Required) | High Density Polyethylene (HDPE) Tubing, 6mm ID, 10mm OD (3 meters Per Machine Required)

Piece

meter

Connect the
other end of
the 1st 2" or

### 50 mm

tubing with
orifice into
the 2nd Tee
fitting (left
portion)

111

Page 126 of 245 | Version 1.0

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

Piece

meter

Connect the
1st Tee
Fitting(left
portion) into
the 2nd 2" or
50mm Tubing
with Orifice

112

Page 127 of 245 | Version 1.0

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

Piece

meter

Connect the
other end of
the 2nd 2" or
50mm Tubing
to the 3rd
Tee
Fitting(Right
portion)

113

Page 128 of 245 | Version 1.0

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

Piece

meter

Connect the
3rd Tee
Fitting(left
portion) into
the 2nd 1.5"
or 40mm
tubing

114

Page 129 of 245 | Version 1.0

https://www.
dropbox.com
/sh/ny5zjc07
flfr7w5/AABn
1HDv42Nn4l
SACj989yU3
a/Video?dl=
0&preview=
OxiKit+Final
+Assembly+
Tutorial+3+o
f+4.MP4&su
bfolder_nav_
tracking=1
Name | Description | Metric Conversion | Unit of Measure
Elbow Push-in Connect Fittings | 3/8"Push to Connect to 3/8"Push to Connect - 90 Elbow | 10mm Push to Connect to 10mm Push to Connect -90 Elbow
Tubing | High Density Polyethylene (HDPE) Tubing, 1/4" ID, 3/8" OD (10 Feet Per Machine Required) | High Density Polyethylene (HDPE) Tubing, 6mm ID, 10mm OD (3 meters Per Machine Required)

Piece

meter

Connect the
other end of
the 2nd 1.5"
or 40mm
tubing into
the 2nd
Elbow Fitting

115

Page 130 of 245 | Version 1.0

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

Piece

meter

Connect the
2nd Tee
Fitting(right
portion) into
the 3rd 1.5"
or 40mm
tubing

116

Page 131 of 245 | Version 1.0

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

Piece

meter

Connect the
other end of
the 3rd 1.5"
or 40mm
tubing into
the 3rd
Elbow Fitting

117

Page 132 of 245 | Version 1.0

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

Piece

meter

Connect the
2nd Tee
Fitting(middl
e portion)
into the 1st
4" or 104mm
Tubing

118

Page 133 of 245 | Version 1.0

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

Piece

meter

Connect the
other end of
the 3rd
Elbow fitting
into the 1st
2" or 50mm
Tubing

119

Page 134 of 245 | Version 1.0

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

Piece

meter

Connect the
3rd Tee
Fitting(middl
e portion)
into the 2nd
4" or 104mm
tubing

120

Page 135 of 245 | Version 1.0

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

Piece

meter

Connect the
other end of
the 2nd
Elbow fitting
into the 2nd
2" or 50mm
Tubing

121

Page 136 of 245 | Version 1.0

https://www.
dropbox.com
/sh/ny5zjc07
flfr7w5/AABn
1HDv42Nn4l
SACj989yU3
a/Video?dl=
0&preview=
OxiKit+Final
+Assembly+
Tutorial+3+o
f+4.MP4&su
bfolder_nav_
tracking=1
Name | Description | Metric Conversion | Unit of Measure
Pressure Gauge | Pressure Gauge 1/4" NPT Back, 0-60psi (Back Mount) | Pressure Gauge 6mm Male NPT Back, 0-41 psi (Back Mount)

Teflon Tape

Unit

Teflon Tape | Teflon Tape | Roll

Place Teflon
tape on the
gauges.
Clockwise

122

Page 137 of 245 | Version 1.0

https://www.
dropbox.com
/sh/ny5zjc07
flfr7w5/AABn
1HDv42Nn4l
SACj989yU3
a/Video?dl=
0&preview=
OxiKit+Final
+Assembly+
Tutorial+3+o
f+4.MP4&su
bfolder_nav_
tracking=1
Name | Description | Metric Conversion | Unit of Measure
Teflon Tape | Teflon Tape | Teflon Tape | Roll
Brass Threaded Male to Female-Adapter Bushing | Brass 1/2-in NPT Male to 1/4" NPT Female - Adapter Bushing | Brass13mm NPT Male to 6mm NPT Female -Adapter Bushing
1/4" Male Straight Push-in Connect Fittings | 1/4" Male NPT to 3/8"Push to Connect - Strait | 6mm Male NPT to 10mm Push to Connect - Strait

Piece

Piece

Place Teflon
to the Brass
Threaded
Coupling and
the Push to
connect
fittings

123

Page 138 of 245 | Version 1.0

https://www.
dropbox.com
/sh/ny5zjc07
flfr7w5/AABn
1HDv42Nn4l
SACj989yU3
a/Video?dl=
0&preview=
OxiKit+Final
+Assembly+
Tutorial+3+o
f+4.MP4&su
bfolder_nav_
tracking=1
Name | Description | Metric Conversion | Unit of Measure
Teflon Tape | Teflon Tape | Teflon Tape | Roll
Pressure Gauge | Pressure Gauge 1/4" NPT Back, 0-60psi (Back Mount) | Pressure Gauge 6mm Male NPT Back, 0-41 psi (Back Mount)
Brass Threaded Male to Female-Adapter Bushing | Brass 1/2-in NPT Male to 1/4" NPT Female - Adapter Bushing | Brass13mm NPT Male to 6mm NPT Female -Adapter Bushing
1/4" Male Elbow Push-in Connect Fittings | 1/4" Male NPT to 3/8"Push to Connect - 90 Elbow | 6mm Male NPT to 6mm Push to Connect - 90 Elbow

Unit

Piece

Piece

Connect the
Brass
Threaded
Coupling and
the Push to
connect
fittings into
the Gauges

124

Page 139 of 245 | Version 1.0

https://www.
dropbox.com
/sh/ny5zjc07
flfr7w5/AABn
1HDv42Nn4l
SACj989yU3
a/Video?dl=
0&preview=
OxiKit+Final
+Assembly+
Tutorial+3+o
f+4.MP4&su
bfolder_nav_
tracking=1
Wrench Name | Description | Metric
Conversion

Unit of
Measure
Teflon Tape | Teflon Tape | Teflon Tape | Roll
Pressure Gauge | Pressure Gauge 1/4" NPT Back, 0-60psi (Back Mount) | Pressure Gauge 6mm Male NPT Back, 0-41 psi (Back Mount)
Brass Threaded Male to Female-Adapter Bushing | Brass 1/2-in NPT Male to 1/4" NPT Female - Adapter Bushing | Brass13mm NPT Male to 6mm NPT Female -Adapter Bushing
1/4" Male Elbow Push-in Connect Fittings | 1/4" Male NPT to 3/8"Push to Connect - 90 Elbow | 6mm Male NPT to 6mm Push to Connect - 90 Elbow

Unit

Piece

Piece
Tighten the
connections
with wrench

125

Page 140 of 245 | Version 1.0

https://ww
w.dropbo
x.com/sh/
ny5zjc07f
lfr7w5/AA
Bn1HDv4
2Nn4lSA
Cj989yU3
a/Video?
dl=0&pre
view=Oxi
Kit+Final
+Assemb
ly+Tutoria
l+3+of+4.
MP4&sub
folder_na
v_trackin
g=1
Name | Description | Metric Conversion | Unit of Measure
Teflon Tape | Teflon Tape | Teflon Tape | Roll
Pressure Gauge | Pressure Gauge 1/4" NPT Back, 0-60psi (Back Mount) | Pressure Gauge 6mm Male NPT Back, 0-41 psi (Back Mount)
Brass Threaded Male to Female-Adapter Bushing | Brass 1/2-in NPT Male to 1/4" NPT Female - Adapter Bushing | Brass13mm NPT Male to 6mm NPT Female -Adapter Bushing
1/4" Male Elbow Push-in Connect Fittings | 1/4" Male NPT to 3/8"Push to Connect - 90 Elbow | 6mm Male NPT to 6mm Push to Connect - 90 Elbow

Unit

Piece

Piece
Do the same
for the 2nd
gauge

126

Page 141 of 245 | Version 1.0

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

Piece

meter

Connect the
other end of
the 2nd 4" or
104mm
tubing into
the 4th Tee
Fitting(upper
portion)

127

Page 142 of 245 | Version 1.0

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

Piece

meter

Connect the
4th Tee
Fitting(lower
portion) into
the 4th 1.5"
or 40mm
Tubing

128

Page 143 of 245 | Version 1.0

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

Piece

meter

Connect the
4th Tee
Fitting(middl
e Portion)
into the 5th
1.5" or 40mm
Tubing

129

Page 144 of 245 | Version 1.0

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

Piece

meter

Connect the
other end of
the 1st 4" or
104mm
Tubing into
the 5th Tee
Fitting(upper
portion)

130

Page 145 of 245 | Version 1.0

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

Piece

meter

Connect the
5th Tee
Fitting(lower
portion) into
the 6th 1.5"
or 40mm
Tubing

131

Page 146 of 245 | Version 1.0

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

Piece

meter

Connect the
5th Tee
Fitting
(middle
portion) into
the 7th 1.5"
or 40mm
Tubing

132

Page 147 of 245 | Version 1.0

https://www.
dropbox.com
/sh/ny5zjc07
flfr7w5/AABn
1HDv42Nn4l
SACj989yU3
a/Video?dl=
0&preview=
OxiKit+Final
+Assembly+
Tutorial+3+o
f+4.MP4&su
bfolder_nav_
tracking=1
Name | Description | Metric Conversion | Unit of Measure
Tubing | High Density Polyethylene (HDPE) Tubing, 1/4" ID, 3/8" OD (10 Feet Per Machine Required) | High Density Polyethylene (HDPE) Tubing, 6mm ID, 10mm OD (3 meters Per Machine Required)
Pressure Gauge | Pressure Gauge 1/4" NPT Back, 0-60psi (Back Mount) | Pressure Gauge 6mm Male NPT Back, 0-41 psi (Back Mount)

meter

Unit

Connect the
other end of
the 4th 1.5"
or 40mm
Tubing to the
1st Gauge

133

Page 148 of 245 | Version 1.0

https://www.
dropbox.com
/sh/ny5zjc07
flfr7w5/AABn
1HDv42Nn4l
SACj989yU3
a/Video?dl=
0&preview=
OxiKit+Final
+Assembly+
Tutorial+3+o
f+4.MP4&su
bfolder_nav_
tracking=1
Name | Description | Metric Conversion | Unit of Measure
Tubing | High Density Polyethylene (HDPE) Tubing, 1/4" ID, 3/8" OD (10 Feet Per Machine Required) | High Density Polyethylene (HDPE) Tubing, 6mm ID, 10mm OD (3 meters Per Machine Required)
Pressure Gauge | Pressure Gauge 1/4" NPT Back, 0-60psi (Back Mount) | Pressure Gauge 6mm Male NPT Back, 0-41 psi (Back Mount)

meter

Unit

Connect the
other end of
the 6th 1.5"
or 40mm
Tubing into
the 2nd
Gauge

134

Page 149 of 245 | Version 1.0

https://www.
dropbox.com
/sh/ny5zjc07
flfr7w5/AABn
1HDv42Nn4l
SACj989yU3
a/Video?dl=
0&preview=
OxiKit+Final
+Assembly+
Tutorial+3+o
f+4.MP4&su
bfolder_nav_
tracking=1
Name | Description | Metric Conversion | Unit of Measure
Tubing | High Density Polyethylene (HDPE) Tubing, 1/4" ID, 3/8" OD (10 Feet Per Machine Required) | High Density Polyethylene (HDPE) Tubing, 6mm ID, 10mm OD (3 meters Per Machine Required)
Pressure Gauge | Pressure Gauge 1/4" NPT Back, 0-60psi (Back Mount) | Pressure Gauge 6mm Male NPT Back, 0-41 psi (Back Mount)
Elbow Push-in Connect Fittings | 3/8"Push to Connect to 3/8"Push to Connect - 90 Elbow | 10mm Push to Connect to 10mm Push to Connect -90 Elbow
Tee Push to connect fittings | 3/8"Push to Connect to 3/8"Push to Connect to 3/8"Push to Connect - Tee | 10mm Push to Connect to 10mm Push to Connect -Tee

meter

Unit

Piece

Piece

Place the
oxygen
connection
circuit on top
of the Sieve
and the
Surge tank

135

Page 150 of 245 | Version 1.0

https://www.
dropbox.com
/sh/ny5zjc07
flfr7w5/AABn
1HDv42Nn4l
SACj989yU3
a/Video?dl=
0&preview=
OxiKit+Final
+Assembly+
Tutorial+3+o
f+4.MP4&su
bfolder_nav_
tracking=1
Name | Description | Metric Conversion | Unit of Measure
Tubing | High Density Polyethylene (HDPE) Tubing, 1/4" ID, 3/8" OD (10 Feet Per Machine Required) | High Density Polyethylene (HDPE) Tubing, 6mm ID, 10mm OD (3 meters Per Machine Required)
Pressure Gauge | Pressure Gauge 1/4" NPT Back, 0-60psi (Back Mount) | Pressure Gauge 6mm Male NPT Back, 0-41 psi (Back Mount)
Elbow Push-in Connect Fittings | 3/8"Push to Connect to 3/8"Push to Connect - 90 Elbow | 10mm Push to Connect to 10mm Push to Connect -90 Elbow
Tee Push to connect fittings | 3/8"Push to Connect to 3/8"Push to Connect to 3/8"Push to Connect - Tee | 10mm Push to Connect to 10mm Push to Connect -Tee
Sieve Canister Assembly | Complete and Finished Sieve Assembly | Complete and Finished Sieve Assembly

meter

Unit

Piece

Piece

Lot

Connect the
open end of
the 1st and
2nd 50mm
Tubing to the

### 2 Sieve

Cannister
Tank

136

Page 151 of 245 | Version 1.0

https://www.
dropbox.com
/sh/ny5zjc07
flfr7w5/AABn
1HDv42Nn4l
SACj989yU3
a/Video?dl=
0&preview=
OxiKit+Final
+Assembly+
Tutorial+3+o
f+4.MP4&su
bfolder_nav_
tracking=1
Name | Description | Metric Conversion | Unit of Measure
Tubing | High Density Polyethylene (HDPE) Tubing, 1/4" ID, 3/8" OD (10 Feet Per Machine Required) | High Density Polyethylene (HDPE) Tubing, 6mm ID, 10mm OD (3 meters Per Machine Required)
Pressure Gauge | Pressure Gauge 1/4" NPT Back, 0-60psi (Back Mount) | Pressure Gauge 6mm Male NPT Back, 0-41 psi (Back Mount)
Elbow Push-in Connect Fittings | 3/8"Push to Connect to 3/8"Push to Connect - 90 Elbow | 10mm Push to Connect to 10mm Push to Connect -90 Elbow
Tee Push to connect fittings | 3/8"Push to Connect to 3/8"Push to Connect to 3/8"Push to Connect - Tee | 10mm Push to Connect to 10mm Push to Connect -Tee
Surge Tank Assembly | Complete and Finished Surge Tank Assembly | Complete and Finished Surge Tank Assembly

meter

Unit

Piece

Piece

Lot

Connect the
80mm with
Orifice
Tubing into
the Surge
Tank

137

Page 152 of 245 | Version 1.0

https://www.
dropbox.com
/sh/ny5zjc07
flfr7w5/AABn
1HDv42Nn4l
SACj989yU3
a/Video?dl=
0&preview=
OxiKit+Final
+Assembly+
Tutorial+3+o
f+4.MP4&su
bfolder_nav_
tracking=1
Name | Description | Metric Conversion
Unit of
Measure
2- way Solenoid Valve | 2/2 Direct Acting Solenoid Valve 1/4" ports 110V AC | Direct Acting Solenoid Valve 10mm ports 110/220VAC 50/60Hz
1/4" Male Straight Push-in Connect Fittings | 1/4" Male NPT to 3/8"Push to Connect -Strait | 6mm Male NPT to 10mm Push to Connect - Strait

Unit

Piece

Connect
Push Fittings
on the
Equalizer
Valve

138

Page 153 of 245 | Version 1.0

https://www.
dropbox.com
/sh/ny5zjc07
flfr7w5/AABn
1HDv42Nn4l
SACj989yU3
a/Video?dl=
0&preview=
OxiKit+Final
+Assembly+
Tutorial+3+o
f+4.MP4&su
bfolder_nav_
tracking=1
Name | Description | Metric Conversion | Unit of Measure
Tubing | High Density Polyethylene (HDPE) Tubing, 1/4" ID, 3/8" OD (10 Feet Per Machine Required) | High Density Polyethylene (HDPE) Tubing, 6mm ID, 10mm OD (3 meters Per Machine Required)
Pressure Gauge | Pressure Gauge 1/4" NPT Back, 0-60psi (Back Mount) | Pressure Gauge 6mm Male NPT Back, 0-41 psi (Back Mount)
Elbow Push-in Connect Fittings | 3/8"Push to Connect to 3/8"Push to Connect - 90 Elbow | 10mm Push to Connect to 10mm Push to Connect -90 Elbow
Tee Push to connect fittings | 3/8"Push to Connect to 3/8"Push to Connect to 3/8"Push to Connect - Tee | 10mm Push to Connect to 10mm Push to Connect -Tee
2- way Solenoid Valve | 2/2 Direct Acting Solenoid Valve 1/4" ports 110V AC | Direct Acting Solenoid Valve 10mm ports 110/220VAC 50/60Hz

meter

Unit

Piece

Piece

Unit

Connect the
5th and 7th
40mm
Tubing into
the Equalizer
Valve

139

Page 154 of 245 | Version 1.0

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

Drill Bit
Machine
Name | Description | Metric Conversion | Unit of Measure
Tubing | High Density Polyethylene (HDPE) Tubing, 1/4" ID, 3/8" OD (10 Feet Per Machine Required) | High Density Polyethylene (HDPE) Tubing, 6mm ID, 10mm OD (3 meters Per Machine Required)
Pressure Gauge | Pressure Gauge 1/4" NPT Back, 0-60psi (Back Mount) | Pressure Gauge 6mm Male NPT Back, 0-41 psi (Back Mount)
Elbow Push-in Connect Fittings | 3/8"Push to Connect to 3/8"Push to Connect - 90 Elbow | 10mm Push to Connect to 10mm Push to Connect -90 Elbow
Tee Push to connect fittings | 3/8"Push to Connect to 3/8"Push to Connect to 3/8"Push to Connect - Tee | 10mm Push to Connect to 10mm Push to Connect -Tee
2- way Solenoid Valve | 2/2 Direct Acting Solenoid Valve 1/4" ports 110V AC | Direct Acting Solenoid Valve 10mm ports 110/220VAC 50/60Hz
Screws | Screws | Screws

meter

Unit

Piece

Piece

Unit

Secure the
Oxygen
Connection
Circuit into
the Frame.
Place Screws
into the Tee
Fittings with
Gauges

140

Page 155 of 245 | Version 1.0

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

Pressure
Gauge

Pressure Gauge
1/4" NPT Back, 0-
60psi (Back
Mount)

Pressure Gauge
6mm Male NPT
Back, 0-41 psi
(Back Mount)

Unit

Elbow
Push-in
Connect
Fittings

3/8"Push to
Connect to
3/8"Push to
Connect - 90
Elbow

10mm Push to
Connect to 10mm
Push to Connect -

### 90 Elbow

Piece

Tee
Push to
connect
fittings

3/8"Push to
Connect to
3/8"Push to
Connect to
3/8"Push to
Connect - Tee

10mm Push to
Connect to 10mm
Push to Connect -
Tee

Piece

2- way
Solenoid
Valve

2/2 Direct Acting
Solenoid Valve
1/4" ports 110V AC

Direct Acting
Solenoid Valve
10mm ports
110/220VAC
50/60Hz

Unit

Screws | Screws | Screws

Washer

Place 4 sets
of washers
into each
screw

141

Page 156 of 245 | Version 1.0

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

Pressure
Gauge

Pressure Gauge
1/4" NPT Back, 0-
60psi (Back
Mount)

Pressure Gauge
6mm Male NPT
Back, 0-41 psi
(Back Mount)

Unit

Elbow
Push-in
Connect
Fittings

3/8"Push to
Connect to
3/8"Push to
Connect - 90
Elbow

10mm Push to
Connect to 10mm
Push to Connect -

### 90 Elbow

Piece

Tee
Push to
connect
fittings

3/8"Push to
Connect to
3/8"Push to
Connect to
3/8"Push to
Connect - Tee

10mm Push to
Connect to 10mm
Push to Connect -
Tee

Piece

2- way
Solenoid
Valve

2/2 Direct Acting
Solenoid Valve
1/4" ports 110V AC

Direct Acting
Solenoid Valve
10mm ports
110/220VAC
50/60Hz

Unit

Screws | Screws | Screws

Washer

Tighten the
Screws into
the frame

142

Page 157 of 245 | Version 1.0

# Surge Tank Pressure Gauge Connection

Page 158 of 245 | Version 1.0

https://www.
dropbox.com
/sh/ny5zjc07
flfr7w5/AABn
1HDv42Nn4l
SACj989yU3
a/Video?dl=
0&preview=
OxiKit+Final
+Assembly+
Tutorial+3+o
f+4.MP4&su
bfolder_nav_
tracking=1
Name | Description | Metric Conversion | Unit of Measure
Pressure Gauge | Pressure Gauge 1/4" NPT Back, 0-60psi (Back Mount) | Pressure Gauge 6mm Male NPT Back, 0-41 psi (Back Mount)

Teflon Tape

Unit

Teflon Tape | Teflon Tape | Roll

Place Teflon
tape on the
gauges.
Clockwise

143

Page 159 of 245 | Version 1.0

https://www.
dropbox.com
/sh/ny5zjc07
flfr7w5/AABn
1HDv42Nn4l
SACj989yU3
a/Video?dl=
0&preview=
OxiKit+Final
+Assembly+
Tutorial+3+o
f+4.MP4&su
bfolder_nav_
tracking=1
Name | Description | Metric Conversion | Unit of Measure
Teflon Tape | Teflon Tape | Teflon Tape | Roll
Brass Threaded Male to Female-Adapter Bushing | Brass 1/2-in NPT Male to 1/4" NPT Female - Adapter Bushing | Brass13mm NPT Male to 6mm NPT Female -Adapter Bushing
1/4" Male Straight Push-in Connect Fittings | 1/4" Male NPT to 3/8"Push to Connect - Strait | 6mm Male NPT to 10mm Push to Connect - Strait

Piece

Piece

Place Teflon
to the Brass
Threaded
Coupling and
the Push to
connect
fittings

144

Page 160 of 245 | Version 1.0

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

Unit

Piece

Piece

Connect the
Brass
Threaded
Coupling and
the Push to
connect
fittings into
the Gauges

145

Page 161 of 245 | Version 1.0

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

Cut 1.5" or
40mm Tube 146

Page 162 of 245 | Version 1.0

https://www.
dropbox.com
/sh/ny5zjc07
flfr7w5/AABn
1HDv42Nn4l
SACj989yU3
a/Video?dl=
0&preview=
OxiKit+Final
+Assembly+
Tutorial+3+o
f+4.MP4&su
bfolder_nav_
tracking=1
Name | Description | Metric Conversion | Unit of Measure
Tubing | High Density Polyethylene (HDPE) Tubing, 1/4" ID, 3/8" OD (10 Feet Per Machine Required) | High Density Polyethylene (HDPE) Tubing, 6mm ID, 10mm OD (3 meters Per Machine Required)
Tee Push to connect fittings | 3/8"Push to Connect to 3/8"Push to Connect to 3/8"Push to Connect - Tee | 10mm Push to Connect to 10mm Push to Connect -Tee

meter

Piece

Connect 1.5"
or 40mm
Tubing into
the side of
the Tee
fitting(right
side)

147

Page 163 of 245 | Version 1.0

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

Cut 1" or
30mm tube 148

Page 164 of 245 | Version 1.0

https://www.
dropbox.com
/sh/ny5zjc07
flfr7w5/AABn
1HDv42Nn4l
SACj989yU3
a/Video?dl=
0&preview=
OxiKit+Final
+Assembly+
Tutorial+3+o
f+4.MP4&su
bfolder_nav_
tracking=1
Name | Description | Metric Conversion | Unit of Measure
Tubing | High Density Polyethylene (HDPE) Tubing, 1/4" ID, 3/8" OD (10 Feet Per Machine Required) | High Density Polyethylene (HDPE) Tubing, 6mm ID, 10mm OD (3 meters Per Machine Required)
Tee Push to connect fittings | 3/8"Push to Connect to 3/8"Push to Connect to 3/8"Push to Connect - Tee | 10mm Push to Connect to 10mm Push to Connect -Tee

meter

Piece

Connect to1"
or 30mm
Tubing into
the Tee
Fitting(middl
e portion)

149

Page 165 of 245 | Version 1.0

https://www.
dropbox.com
/sh/ny5zjc07
flfr7w5/AABn
1HDv42Nn4l
SACj989yU3
a/Video?dl=
0&preview=
OxiKit+Final
+Assembly+
Tutorial+3+o
f+4.MP4&su
bfolder_nav_
tracking=1
Name | Description | Metric Conversion | Unit of Measure
Tubing | High Density Polyethylene (HDPE) Tubing, 1/4" ID, 3/8" OD (10 Feet Per Machine Required) | High Density Polyethylene (HDPE) Tubing, 6mm ID, 10mm OD (3 meters Per Machine Required)
Tee Push to connect fittings | 3/8"Push to Connect to 3/8"Push to Connect to 3/8"Push to Connect - Tee | 10mm Push to Connect to 10mm Push to Connect -Tee
Pressure Gauge | Pressure Gauge 1/4" NPT Back, 0-60psi (Back Mount) | Pressure Gauge 6mm Male NPT Back, 0-41 psi (Back Mount)

meter

Piece

Unit

Connect the
other end of
the1" or
30mm tube
into the
Gauge

150

Page 166 of 245 | Version 1.0

https://www.
dropbox.com
/sh/ny5zjc07
flfr7w5/AABn
1HDv42Nn4l
SACj989yU3
a/Video?dl=
0&preview=
OxiKit+Final
+Assembly+
Tutorial+3+o
f+4.MP4&su
bfolder_nav_
tracking=1
Name | Description | Metric Conversion | Unit of Measure
Tubing | High Density Polyethylene (HDPE) Tubing, 1/4" ID, 3/8" OD (10 Feet Per Machine Required) | High Density Polyethylene (HDPE) Tubing, 6mm ID, 10mm OD (3 meters Per Machine Required)
Tee Push to connect fittings | 3/8"Push to Connect to 3/8"Push to Connect to 3/8"Push to Connect - Tee | 10mm Push to Connect to 10mm Push to Connect -Tee
Pressure Gauge | Pressure Gauge 1/4" NPT Back, 0-60psi (Back Mount) | Pressure Gauge 6mm Male NPT Back, 0-41 psi (Back Mount)
Surge Tank Assembly | Complete and Finished Surge Tank Assembly | Complete and Finished Surge Tank Assembly

meter

Piece

Unit

Lot

Connect the
other end of
the 1.5" or
40mm
Tubing into
the bottom
part of the
Surge Tank

151

Page 167 of 245 | Version 1.0

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

Cut 12" or
300mm of
tube

152

Page 168 of 245 | Version 1.0

https://www.
dropbox.com
/sh/ny5zjc07
flfr7w5/AABn
1HDv42Nn4l
SACj989yU3
a/Video?dl=
0&preview=
OxiKit+Final
+Assembly+
Tutorial+3+o
f+4.MP4&su
bfolder_nav_
tracking=1
Name | Description | Metric Conversion | Unit of Measure
Tubing | High Density Polyethylene (HDPE) Tubing, 1/4" ID, 3/8" OD (10 Feet Per Machine Required) | High Density Polyethylene (HDPE) Tubing, 6mm ID, 10mm OD (3 meters Per Machine Required)
Tee Push to connect fittings | 3/8"Push to Connect to 3/8"Push to Connect to 3/8"Push to Connect - Tee | 10mm Push to Connect to 10mm Push to Connect -Tee
Surge Tank Assembly | Complete and Finished Surge Tank Assembly | Complete and Finished Surge Tank Assembly
Elbow Push-in Connect Fittings | 3/8"Push to Connect to 3/8"Push to Connect - 90 Elbow | 10mm Push to Connect to 10mm Push to Connect -90 Elbow
Pressure Regulator | Low Pressure Regulator 3 to 30PSI | Low Pressure Regulator 3 Mpa to 30 Mpa 6.35mm FNPT Ports

meter

Piece

Lot

Piece

Unit

Connect a
12" or
300mm
tubing into
the the Tee
Fitting (left
portion) from
the surge
tank

153

Page 169 of 245 | Version 1.0

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

Connect the
other end of
the 12" or
300mm
Tubing into
the
top(inflow)
portion of the
Pressure
Regulator

154

Page 170 of 245 | Version 1.0

# Flow Meter Connection

Page 171 of 245 | Version 1.0

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

Cut a 2nd
12" or
300mm
Tubing

155

Page 172 of 245 | Version 1.0

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

Hand
Heat
Torch
Name | Description | Metric Conversion | Unit of Measure
Tubing | High Density Polyethylene (HDPE) Tubing, 1/4" ID, 3/8" OD (10 Feet Per Machine Required) | High Density Polyethylene (HDPE) Tubing, 6mm ID, 10mm OD (3 meters Per Machine Required) | meter

Heat the all
ends of the
2nd 12" or
300mm
Tubing to
shrink the
opening

155

Page 173 of 245 | Version 1.0

https://www.
dropbox.com
/sh/ny5zjc07
flfr7w5/AABn
1HDv42Nn4l
SACj989yU3
a/Video?dl=
0&preview=
OxiKit+Final
+Assembly+
Tutorial+3+o
f+4.MP4&su
bfolder_nav_
tracking=1
Name | Description | Metric Conversion
Unit of
Measure
Tubing | High Density Polyethylene (HDPE) Tubing, 1/4" ID, 3/8" OD (10 Feet Per Machine Required) | High Density Polyethylene (HDPE) Tubing, 6mm ID, 10mm OD (3 meters Per Machine Required)
Flowmeter | Oxygen Air Gas Flowmeter (Only Need 15 LPM Max, Avoid SHLLJ Brand - Marked Wrong) | Oxygen Air Gas Flowmeter (Only Need 15 LPM Max, Avoid SHLLJ Brand - Marked Wrong)

meter

Gas | 3-30LPM LZQ-7 | 3-30LPM LZQ-7 | Unit

Connect the
heated 2nd
12" or
300mm
tubing into
the lower
(outflow)
portion of the
flow meter

157

Page 174 of 245 | Version 1.0

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

Cut a 3rd 12"
or 300mm
Tubing

158

Page 175 of 245 | Version 1.0

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

Hand
Heat
Torch
Name | Description | Metric Conversion | Unit of Measure
Tubing | High Density Polyethylene (HDPE) Tubing, 1/4" ID, 3/8" OD (10 Feet Per Machine Required) | High Density Polyethylene (HDPE) Tubing, 6mm ID, 10mm OD (3 meters Per Machine Required) | meter

Heat the all
ends of the
3rd 300mm
Tubing to
shrink the
opening

159

Page 176 of 245 | Version 1.0

https://www.
dropbox.com
/sh/ny5zjc07
flfr7w5/AABn
1HDv42Nn4l
SACj989yU3
a/Video?dl=
0&preview=
OxiKit+Final
+Assembly+
Tutorial+3+o
f+4.MP4&su
bfolder_nav_
tracking=1
Name | Description | Metric Conversion
Unit of
Measure
Tubing | High Density Polyethylene (HDPE) Tubing, 1/4" ID, 3/8" OD (10 Feet Per Machine Required) | High Density Polyethylene (HDPE) Tubing, 6mm ID, 10mm OD (3 meters Per Machine Required)
Flowmeter | Oxygen Air Gas Flowmeter (Only Need 15 LPM Max, Avoid SHLLJ Brand - Marked Wrong) | Oxygen Air Gas Flowmeter (Only Need 15 LPM Max, Avoid SHLLJ Brand - Marked Wrong)

meter

Gas | 3-30LPM LZQ-7 | 3-30LPM LZQ-7 | Unit

Connect the
heated 3rd
12" or
300mm
tubing into
the
upper(inflow)
portion of the
flow meter

160

Page 177 of 245 | Version 1.0

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

Wire
Cutter
Pliers
Name | Description | Metric Conversion | Unit of Measure
Nichrome Wire | 50 feet Nichrome 80 wire 206 | 15,240 mm Nichrome 80 wire
| | 206 | Gram

Cut 5" of
Nichrome
Wire

161

Page 178 of 245 | Version 1.0

https://www.
dropbox.com
/sh/ny5zjc07
flfr7w5/AABn
1HDv42Nn4l
SACj989yU3
a/Video?dl=
0&preview=
OxiKit+Final
+Assembly+
Tutorial+3+o
f+4.MP4&su
bfolder_nav_
tracking=1
Name | Description | Metric Conversion
Unit of
Measure
Nichrome Wire | 50 feet Nichrome 80 wire 206 | 15,240 mm Nichrome 80 wire 206
Flowmeter | Oxygen Air Gas Flowmeter (Only Need 15 LPM Max, Avoid SHLLJ Brand - Marked Wrong) | Oxygen Air Gas Flowmeter (Only Need 15 LPM Max, Avoid SHLLJ Brand - Marked Wrong)
| Polyethylene (HDPE) Tubing, 1/4" ID, 3/8" OD (10 Feet Per Machine Required) | Polyethylene (HDPE) Tubing, 6mm ID, 10mm OD (3 meters Per Machine Required)

Gram

Gas | 3-30LPM LZQ-7 | 3-30LPM LZQ-7 | Unit
Tubing | High Density | High Density | meter

Secure the
connection
of the
outflow of
the Flow
meter by
Wrapping
and twisting
the Nichrome
wire into the
connected
tube and the
flow
meter(lower
portion)

162

Page 179 of 245 | Version 1.0

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

Wire
Cutter
Pliers
Name | Description | Metric Conversion | Unit of Measure
Nichrome Wire | 50 feet Nichrome 80 wire 206 | 15,240 mm Nichrome 80 wire
| | 206 | Gram

Cut the
excess wire 163

Page 180 of 245 | Version 1.0

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

Wire
Cutter
Pliers
Name | Description | Metric Conversion | Unit of Measure
Nichrome Wire | 50 feet Nichrome 80 wire 206 | 15,240 mm Nichrome 80 wire
| | 206 | Gram

Cut 5" of
Nichrome
Wire

164

Page 181 of 245 | Version 1.0

https://www.
dropbox.com
/sh/ny5zjc07
flfr7w5/AABn
1HDv42Nn4l
SACj989yU3
a/Video?dl=
0&preview=
OxiKit+Final
+Assembly+
Tutorial+3+o
f+4.MP4&su
bfolder_nav_
tracking=1
Name | Description | Metric Conversion
Unit of
Measure
Nichrome Wire | 50 feet Nichrome 80 wire 206 | 15,240 mm Nichrome 80 wire 206
Flowmeter | Oxygen Air Gas Flowmeter (Only Need 15 LPM Max, Avoid SHLLJ Brand - Marked Wrong) | Oxygen Air Gas Flowmeter (Only Need 15 LPM Max, Avoid SHLLJ Brand - Marked Wrong)
| Polyethylene (HDPE) Tubing, 1/4" ID, 3/8" OD (10 Feet Per Machine Required) | Polyethylene (HDPE) Tubing, 6mm ID, 10mm OD (3 meters Per Machine Required)

Gram

Gas | 3-30LPM LZQ-7 | 3-30LPM LZQ-7 | Unit
Tubing | High Density | High Density | meter

Secure the
connection
of the inflow
of the Flow
meter by
Wrapping
and twisting
the Nichrome
wire into the
connected
tube and the
flow
meter(upper
portion)

165

Page 182 of 245 | Version 1.0

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

Cut the
excess wire 166

Page 183 of 245 | Version 1.0

https://www.
dropbox.com
/sh/ny5zjc07
flfr7w5/AABn
1HDv42Nn4l
SACj989yU3
a/Video?dl=
0&preview=
OxiKit+Final
+Assembly+
Tutorial+3+o
f+4.MP4&su
bfolder_nav_
tracking=1
Name | Description | Metric Conversion
Unit of
Measure
Gas Flowmeter | 3-30LPM LZQ-7 Oxygen Air Gas Flowmeter (Only Need 15 LPM Max, Avoid SHLLJ Brand - Marked Wrong) | 3-30LPM LZQ-7 Oxygen Air Gas Flowmeter (Only Need 15 LPM Max, Avoid SHLLJ Brand - Marked Wrong)
Tubing | High Density Polyethylene (HDPE) Tubing, 1/4" ID, 3/8" OD (10 Feet Per Machine Required) | High Density Polyethylene (HDPE) Tubing, 6mm ID, 10mm OD (3 meters Per Machine Required)
Frame | Complete Assembly of the Frame | Complete Assembly of the Frame

Unit

meter

Unit

Insert the
upper and
lower tubing
into the hole
drilled in the
Frame for the
Flow Meter

167

Page 184 of 245 | Version 1.0

https://www.
dropbox.com
/sh/ny5zjc07
flfr7w5/AABn
1HDv42Nn4l
SACj989yU3
a/Video?dl=
0&preview=
OxiKit+Final
+Assembly+
Tutorial+3+o
f+4.MP4&su
bfolder_nav_
tracking=1
Name | Description | Metric Conversion
Unit of
Measure
Gas Flowmeter | 3-30LPM LZQ-7 Oxygen Air Gas Flowmeter (Only Need 15 LPM Max, Avoid SHLLJ Brand - Marked Wrong) | 3-30LPM LZQ-7 Oxygen Air Gas Flowmeter (Only Need 15 LPM Max, Avoid SHLLJ Brand - Marked Wrong)
Tubing | High Density Polyethylene (HDPE) Tubing, 1/4" ID, 3/8" OD (10 Feet Per Machine Required) | High Density Polyethylene (HDPE) Tubing, 6mm ID, 10mm OD (3 meters Per Machine Required)
Frame | Complete Assembly of the Frame | Complete Assembly of the Frame

Unit

meter

Unit

Secure the
Flow meter
into the
frame

168

Page 185 of 245 | Version 1.0

https://www.
dropbox.com
/sh/ny5zjc07
flfr7w5/AABn
1HDv42Nn4l
SACj989yU3
a/Video?dl=
0&preview=
OxiKit+Final
+Assembly+
Tutorial+3+o
f+4.MP4&su
bfolder_nav_
tracking=1
Name | Description | Metric Conversion
Unit of
Measure
Gas Flowmeter | 3-30LPM LZQ-7 Oxygen Air Gas Flowmeter (Only Need 15 LPM Max, Avoid SHLLJ Brand - Marked Wrong) | 3-30LPM LZQ-7 Oxygen Air Gas Flowmeter (Only Need 15 LPM Max, Avoid SHLLJ Brand - Marked Wrong)
Tubing | High Density Polyethylene (HDPE) Tubing, 1/4" ID, 3/8" OD (10 Feet Per Machine Required) | High Density Polyethylene (HDPE) Tubing, 6mm ID, 10mm OD (3 meters Per Machine Required)
Frame | Complete Assembly of the Frame | Complete Assembly of the Frame
Pressure Regulator | Low Pressure Regulator 3 to 30PSI | Low Pressure Regulator 3 Mpa to 30 Mpa 6.35mm FNPT Ports
Elbow Push-in Connect Fittings | 3/8"Push to Connect to 3/8"Push to Connect - 90 Elbow | 10mm Push to Connect to 10mm Push to Connect -90 Elbow

Unit

meter

Unit

Unit

Piece

Connect the
lower portion
of tube of the
flow
meter(outflo
w) into the
Pressure
regulator
(Lower
portion -
output side)

169

Page 186 of 245 | Version 1.0

# Bubbler and Air Filter Connection

Page 187 of 245 | Version 1.0

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

Scissors/
Cutter
Name | Description | Metric Conversion
Unit of
Measure
Humidifier Water Bottle | Humidifier Water Bottle | Humidifier Water Bottle

Pieces

Cut off and
shorten the
tube inside
the Bubbler
around 1"
from the end

170

Page 188 of 245 | Version 1.0

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

Wire
Cutter
Pliers
Name | Description | Metric Conversion
Unit of
Measure
Humidifier Water Bottle | Humidifier Water Bottle | Humidifier Water Bottle

Pieces

Trim and cut
off the tip
side cover of
the bubbler,
to expose
the nipple of
the bubbler

171

Page 189 of 245 | Version 1.0

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

Cut a 4th 12"
or 300mm
Tubing

172

Page 190 of 245 | Version 1.0

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

Hand
Heat
Torch
Name | Description | Metric Conversion | Unit of Measure
Tubing | High Density Polyethylene (HDPE) Tubing, 1/4" ID, 3/8" OD (10 Feet Per Machine Required) | High Density Polyethylene (HDPE) Tubing, 6mm ID, 10mm OD (3 meters Per Machine Required) | meter

Heat the all
ends of the
4th 300mm
Tubing to
shrink the
opening

173

Page 191 of 245 | Version 1.0

https://www.
dropbox.com
/sh/ny5zjc07
flfr7w5/AABn
1HDv42Nn4l
SACj989yU3
a/Video?dl=
0&preview=
OxiKit+Final
+Assembly+
Tutorial+3+o
f+4.MP4&su
bfolder_nav_
tracking=1
Name | Description | Metric Conversion
Unit of
Measure
Tubing | High Density Polyethylene (HDPE) Tubing, 1/4" ID, 3/8" OD (10 Feet Per Machine Required) | High Density Polyethylene (HDPE) Tubing, 6mm ID, 10mm OD (3 meters Per Machine Required)
Humidifier Water Bottle | Humidifier Water Bottle | Humidifier Water Bottle

meter

Pieces

Insert the 4th
300mm
Tubing into
the nipple of
the bubbler

174

Page 192 of 245 | Version 1.0

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

Cut 5" of
Nichrome
Wire

175

Page 193 of 245 | Version 1.0

https://www.
dropbox.com
/sh/ny5zjc07
flfr7w5/AABn
1HDv42Nn4l
SACj989yU3
a/Video?dl=
0&preview=
OxiKit+Final
+Assembly+
Tutorial+3+o
f+4.MP4&su
bfolder_nav_
tracking=1
Name | Description | Metric Conversion
Unit of
Measure
Tubing | High Density Polyethylene (HDPE) Tubing, 1/4" ID, 3/8" OD (10 Feet Per Machine Required) | High Density Polyethylene (HDPE) Tubing, 6mm ID, 10mm OD (3 meters Per Machine Required)
Humidifier Water Bottle | Humidifier Water Bottle | Humidifier Water Bottle

meter

Pieces

Secure the
connection
by Wrapping
and twisting
the Nichrome
wire into the
connected
tube into the
nipple of the
Bubbler

176

Page 194 of 245 | Version 1.0

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

Cut the
excess wire 177

Page 195 of 245 | Version 1.0

https://www.
dropbox.com
/sh/ny5zjc07
flfr7w5/AABn
1HDv42Nn4l
SACj989yU3
a/Video?dl=
0&preview=
OxiKit+Final
+Assembly+
Tutorial+3+o
f+4.MP4&su
bfolder_nav_
tracking=1
Name | Description | Metric Conversion
Unit of
Measure
Frame | Complete Assembly of the Frame | Complete Assembly of the Frame
Humidifier Water Bottle | Humidifier Water Bottle | Humidifier Water Bottle

Unit

Pieces

Place the
bubbler into
Hole 3.
Please
refer to
Fig 4.0
for the
Hole
assignem
nt

178

Page 196 of 245 | Version 1.0

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

Scissors/
Cutter
Name | Description | Metric Conversion
Unit of
Measure
Tubing | High Density Polyethylene (HDPE) Tubing, 1/4" ID, 3/8" OD (10 Feet Per Machine Required) | High Density Polyethylene (HDPE) Tubing, 6mm ID, 10mm OD (3 meters Per Machine Required)
Humidifier Water Bottle | Humidifier Water Bottle | Humidifier Water Bottle
Flowmeter | Oxygen Air Gas Flowmeter (Only Need 15 LPM Max, Avoid SHLLJ Brand - Marked Wrong) | Oxygen Air Gas Flowmeter (Only Need 15 LPM Max, Avoid SHLLJ Brand - Marked Wrong)

meter

Pieces

Gas | 3-30LPM LZQ-7 | 3-30LPM LZQ-7 | Unit

Cut excess
tube from the
upper portion
of the flow
meter and
the tubing
from the
bubbler.
Ensure the
tube from
bubbler and
end of the
Flow meter
will connect.

179

Page 197 of 245 | Version 1.0

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

meter

Pieces

Heat the
other end of
the tube from
the bubbler

180

Page 198 of 245 | Version 1.0

https://www.
dropbox.com
/sh/ny5zjc07
flfr7w5/AABn
1HDv42Nn4l
SACj989yU3
a/Video?dl=
0&preview=
OxiKit+Final
+Assembly+
Tutorial+3+o
f+4.MP4&su
bfolder_nav_
tracking=1
Name | Description | Metric Conversion
Unit of
Measure
Tubing | High Density Polyethylene (HDPE) Tubing, 1/4" ID, 3/8" OD (10 Feet Per Machine Required) | High Density Polyethylene (HDPE) Tubing, 6mm ID, 10mm OD (3 meters Per Machine Required)
Humidifier Water Bottle | Humidifier Water Bottle | Humidifier Water Bottle
Sanitary Air Filter | Sanitary Air Filter (Sold in 4 Pack) | Sanitary Air Filter (Sold in 4 Pack)

meter

Pieces

Piece
Connect the
tube from
bubbler to
the lower
portion of the
filter

181

Page 199 of 245 | Version 1.0

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

Hand
Heat
Torch
Name | Description | Metric Conversion
Unit of
Measure
Tubing | High Density Polyethylene (HDPE) Tubing, 1/4" ID, 3/8" OD (10 Feet Per Machine Required) | High Density Polyethylene (HDPE) Tubing, 6mm ID, 10mm OD (3 meters Per Machine Required)
Flowmeter | Oxygen Air Gas Flowmeter (Only Need 15 LPM Max, Avoid SHLLJ Brand - Marked Wrong) | Oxygen Air Gas Flowmeter (Only Need 15 LPM Max, Avoid SHLLJ Brand - Marked Wrong)

meter

Gas | 3-30LPM LZQ-7 | 3-30LPM LZQ-7 | Unit

Heat the
other end of
the tube from
the upper
portion of the
flow meter

182

Page 200 of 245 | Version 1.0

https://www.
dropbox.com
/sh/ny5zjc07
flfr7w5/AABn
1HDv42Nn4l
SACj989yU3
a/Video?dl=
0&preview=
OxiKit+Final
+Assembly+
Tutorial+3+o
f+4.MP4&su
bfolder_nav_
tracking=1
Name | Description | Metric Conversion
Unit of
Measure
Tubing | High Density Polyethylene (HDPE) Tubing, 1/4" ID, 3/8" OD (10 Feet Per Machine Required) | High Density Polyethylene (HDPE) Tubing, 6mm ID, 10mm OD (3 meters Per Machine Required)
Sanitary Air Filter | Sanitary Air Filter (Sold in 4 Pack) | Sanitary Air Filter (Sold in 4 Pack)
Flowmeter | Oxygen Air Gas Flowmeter (Only Need 15 LPM Max, Avoid SHLLJ Brand - Marked Wrong) | Oxygen Air Gas Flowmeter (Only Need 15 LPM Max, Avoid SHLLJ Brand - Marked Wrong)

meter

Piece

Gas | 3-30LPM LZQ-7 | 3-30LPM LZQ-7 | Unit

Connect the
tube from
upper
(inflow)
portion of the
flow meter to
the upper
portion of the
filter

183

Page 201 of 245 | Version 1.0

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

Cut 5" of
stainless
steel wire

184

Page 202 of 245 | Version 1.0

https://www.
dropbox.com
/sh/ny5zjc07
flfr7w5/AABn
1HDv42Nn4l
SACj989yU3
a/Video?dl=
0&preview=
OxiKit+Final
+Assembly+
Tutorial+3+o
f+4.MP4&su
bfolder_nav_
tracking=1
Name | Description | Metric Conversion | Unit of Measure
Tubing | High Density Polyethylene (HDPE) Tubing, 1/4" ID, 3/8" OD (10 Feet Per Machine Required) | High Density Polyethylene (HDPE) Tubing, 6mm ID, 10mm OD (3 meters Per Machine Required)
Sanitary Air Filter | Sanitary Air Filter (Sold in 4 Pack) | Sanitary Air Filter (Sold in 4 Pack)

meter

Piece

Secure the
connection
by Wrapping
and twisting
the Nichrome
wire into the
Air Filter
(upper
portion)

185

Page 203 of 245 | Version 1.0

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

Cut the
excess wire 186

Page 204 of 245 | Version 1.0

https://www.
dropbox.com
/sh/ny5zjc07
flfr7w5/AABn
1HDv42Nn4l
SACj989yU3
a/Video?dl=
0&preview=
OxiKit+Final
+Assembly+
Tutorial+3+o
f+4.MP4&su
bfolder_nav_
tracking=1
Name | Description | Metric Conversion | Unit of Measure
Tubing | High Density Polyethylene (HDPE) Tubing, 1/4" ID, 3/8" OD (10 Feet Per Machine Required) | High Density Polyethylene (HDPE) Tubing, 6mm ID, 10mm OD (3 meters Per Machine Required)
Sanitary Air Filter | Sanitary Air Filter (Sold in 4 Pack) | Sanitary Air Filter (Sold in 4 Pack)

meter

Piece

Secure the
connection
by Wrapping
and twisting
the Nichrome
wire into the
Air Filter
(lower
portion)

187

Page 205 of 245 | Version 1.0

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

Cut the
excess wire 188

Page 206 of 245 | Version 1.0

# 3 way Solenoid Valve / Pressure Relief / High Pressure Regulator Connection

Page 207 of 245 | Version 1.0
Name | Description | Metric Conversion | Unit of Measure
3/8" Male Straight Push-in Connect Fittings | 3/8" Male NPT to 3/8"Push to Connect -Strait | 10mm Male NPT to 10mm Push to Connect - Strait
Solenoid Valve | Way Solenoid Valve, 110 V AC | 2 Way Solenoid Valve, 110/220 VAC 50/60Hz

Piece

3- way | 3/8" NPT 3- | 10mm FNPT 3 Port | Unit

Connect
Straight
Fittings on
the top of the

### 3 way

Solenoid
Valves

189

Page 208 of 245 | Version 1.0
Name | Description | Metric Conversion | Unit of Measure
Tubing | High Density Polyethylene (HDPE) Tubing, 1/4" ID, 3/8" OD (10 Feet Per Machine Required) | High Density Polyethylene (HDPE) Tubing, 6mm ID, 10mm OD (3 meters Per Machine Required) | meter

Cut 1" or
30mm of
Tubing

190

Page 209 of 245 | Version 1.0
Name | Description | Metric Conversion | Unit of Measure
3- way Solenoid Valve | 3/8" NPT 3-Way Solenoid Valve, 110 V AC | 10mm FNPT 3 Port 2 Way Solenoid Valve, 110/220 VAC 50/60Hz
3/8" Male Straight Push-in Connect Fittings | 3/8" Male NPT to 3/8"Push to Connect - Strait | 10mm Male NPT to 10mm Push to Connect - Strait
Tubing | High Density Polyethylene (HDPE) Tubing, 1/4" ID, 3/8" OD (10 Feet Per Machine Required) | High Density Polyethylene (HDPE) Tubing, 6mm ID, 10mm OD (3 meters Per Machine Required)

Unit

Piece

Connect 1" | meter
or 30 mm
Tubing on
the top of the
Solenoid
Valve with
Straight
Fittings

191

Page 210 of 245 | Version 1.0
Name | Description | Metric Conversion | Unit of Measure
3- way Solenoid Valve | 3/8" NPT 3-Way Solenoid Valve, 110 V AC | 10mm FNPT 3 Port 2 Way Solenoid Valve, 110/220 VAC 50/60Hz
3/8" Male Straight Push-in Connect Fittings | 3/8" Male NPT to 3/8"Push to Connect - Strait | 10mm Male NPT to 10mm Push to Connect - Strait
Tubing | High Density Polyethylene (HDPE) Tubing, 1/4" ID, 3/8" OD (10 Feet Per Machine Required) | High Density Polyethylene (HDPE) Tubing, 6mm ID, 10mm OD (3 meters Per Machine Required)
Sieve Canister Assembly | Complete and Finished Sieve Assembly | Complete and Finished Sieve Assembly

Unit

Piece

meter

Lot

Connect the
other end of
the 1" or
30mm into
the bottom
part of the
Sieve
Cannister
Tanks

192

Page 211 of 245 | Version 1.0
Name | Description | Metric Conversion | Unit of Measure
3/8" Male Elbow Push to Connect Fittings | 3/8" Male NPT to 3/8"Push to Connect - 90 Elbow | 10mm Male NPT to 10mmPush to Connect - 90 Deg Elbow
Solenoid Valve | Way Solenoid Valve, 110 V AC | 2 Way Solenoid Valve, 110/220 VAC 50/60Hz

Piece

3- way | 3/8" NPT 3- | 10mm FNPT 3 Port | Unit

Connect
Elbow
Fittings on
the 2 bottom
connections
of the 3 way
Solenoide
Valve

193

Page 212 of 245 | Version 1.0
Name | Description | Metric Conversion | Unit of Measure
Tubing | High Density Polyethylene (HDPE) Tubing, 1/4" ID, 3/8" OD (10 Feet Per Machine Required) | High Density Polyethylene (HDPE) Tubing, 6mm ID, 10mm OD (3 meters Per Machine Required) | meter

Cut 2nd 1" or
30mm of
Tubing

194

Page 213 of 245 | Version 1.0
Name | Description | Metric Conversion | Unit of Measure
Tubing | High Density Polyethylene (HDPE) Tubing, 1/4" ID, 3/8" OD (10 Feet Per Machine Required) | High Density Polyethylene (HDPE) Tubing, 6mm ID, 10mm OD (3 meters Per Machine Required)
3/8" Male Elbow Push to Connect Fittings | 3/8" Male NPT to 3/8"Push to Connect - 90 Elbow | 10mm Male NPT to 10mmPush to Connect - 90 Deg Elbow
3- way Solenoid Valve | 3/8" NPT 3-Way Solenoid Valve, 110 V AC | 10mm FNPT 3 Port 2 Way Solenoid Valve, 110/220 VAC 50/60Hz

meter

Piece

Unit

Connect the
2nd 1" or 30
mm Tubing
on one of the
Elbow
Fittings of
the Solenoid
Valve

195

Page 214 of 245 | Version 1.0
Name | Description | Metric Conversion | Unit of Measure
Tubing | High Density Polyethylene (HDPE) Tubing, 1/4" ID, 3/8" OD (10 Feet Per Machine Required) | High Density Polyethylene (HDPE) Tubing, 6mm ID, 10mm OD (3 meters Per Machine Required)
Y Push to connect fittings | 3/8"Push to Connect to 3/8"Push to Connect to 3/8"Push to Connect - Y | 10mm Push to Connect to 10mm Push to Connect - Y

meter

Piece

Connect the
other end of
the 2nd 1" or
30mm
Tubing into a
Y Fitting

196

Page 215 of 245 | Version 1.0
Name | Description | Metric Conversion | Unit of Measure
3- way Solenoid Valve | 3/8" NPT 3-Way Solenoid Valve, 110 V AC | 10mm FNPT 3 Port 2 Way Solenoid Valve, 110/220 VAC 50/60Hz | Unit

3/8" Male
Straight
Push-in
Connect
Fittings

3/8" Male NPT to
3/8"Push to
Connect - Strait

10mm Male NPT to
10mm Push to
Connect - Strait

Piece

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

High Density
Polyethylene
(HDPE) Tubing,
6mm ID, 10mm OD
(3 meters Per
Machine Required)

meter

3/8" Male
Elbow
Push to
Connect
Fittings

3/8" Male NPT to
3/8"Push to
Connect - 90
Elbow

10mm Male NPT to
10mmPush to
Connect - 90 Deg
Elbow

Piece

Sieve
Canister
Assembly

Complete and
Finished Sieve
Assembly

Complete and
Finished Sieve
Assembly

Lot

Y Push to
connect
fittings

3/8"Push to
Connect to
3/8"Push to
Connect to
3/8"Push to
Connect - Y

10mm Push to
Connect to 10mm
Push to Connect -
Y

Piece

Do The same
for the 2nd 3
way solenoid
Valve

197

Page 216 of 245 | Version 1.0
Name | Description | Metric Conversion | Unit of Measure
Tubing | High Density Polyethylene (HDPE) Tubing, 1/4" ID, 3/8" OD (10 Feet Per Machine Required) | High Density Polyethylene (HDPE) Tubing, 6mm ID, 10mm OD (3 meters Per Machine Required) | meter

Cut 6" or
150mm of
tubing

198

Page 217 of 245 | Version 1.0
Name | Description | Metric Conversion | Unit of Measure
Tubing | High Density Polyethylene (HDPE) Tubing, 1/4" ID, 3/8" OD (10 Feet Per Machine Required) | High Density Polyethylene (HDPE) Tubing, 6mm ID, 10mm OD (3 meters Per Machine Required)
3- way Solenoid Valve | 3/8" NPT 3-Way Solenoid Valve, 110 V AC | 10mm FNPT 3 Port 2 Way Solenoid Valve, 110/220 VAC 50/60Hz

meter

Unit

Connect the
150mm
Tubing into
the remaining
open Elbow
Fittings on
the 3 way
solenoid
Valve

199

Page 218 of 245 | Version 1.0
Name | Description | Metric Conversion | Unit of Measure
Tubing | High Density Polyethylene (HDPE) Tubing, 1/4" ID, 3/8" OD (10 Feet Per Machine Required) | High Density Polyethylene (HDPE) Tubing, 6mm ID, 10mm OD (3 meters Per Machine Required)
Y Push to connect fittings | 3/8"Push to Connect to 3/8"Push to Connect to 3/8"Push to Connect - Y | 10mm Push to Connect to 10mm Push to Connect - Y

meter

Piece

Connect the
other end of
the 150mm
Tubing into a
Y Push to
Connect
Fitting

200

Page 219 of 245 | Version 1.0
Name | Description | Metric Conversion | Unit of Measure
Tubing | High Density Polyethylene (HDPE) Tubing, 1/4" ID, 3/8" OD (10 Feet Per Machine Required) | High Density Polyethylene (HDPE) Tubing, 6mm ID, 10mm OD (3 meters Per Machine Required)
3- way Solenoid Valve | 3/8" NPT 3-Way Solenoid Valve, 110 V AC | 10mm FNPT 3 Port 2 Way Solenoid Valve, 110/220 VAC 50/60Hz
Y Push to connect fittings | 3/8"Push to Connect to 3/8"Push to Connect to 3/8"Push to Connect - Y | 10mm Push to Connect to 10mm Push to Connect -Y

meter

Unit

Piece
Do The same
for the 2nd 3
way solenoid
Valve

201

Page 220 of 245 | Version 1.0
Name | Description | Metric Conversion | Unit of Measure
Tubing | High Density Polyethylene (HDPE) Tubing, 1/4" ID, 3/8" OD (10 Feet Per Machine Required) | High Density Polyethylene (HDPE) Tubing, 6mm ID, 10mm OD (3 meters Per Machine Required)
Copper Tubing | 3/8" OD Copper Tubing (Need around 20') | 10mm OD Copper Tubing (Need around 6m)
Straight Push to connect fittings | 3/8” mm Push to Connect to 3/8” Push to Connect -Straight | 10mm Push to Connect to 10mm Push to Connect -Straight

meter

Inch

Piece

Place Fittings
on the top
end of the
Copper Coil

202

Page 221 of 245 | Version 1.0
Name | Description | Metric Conversion | Unit of Measure
Tubing | High Density Polyethylene (HDPE) Tubing, 1/4" ID, 3/8" OD (10 Feet Per Machine Required) | High Density Polyethylene (HDPE) Tubing, 6mm ID, 10mm OD (3 meters Per Machine Required) | meter

Cut 12" or
300mm
Tubing

203

Process | Material | Tools | Youtube Link
Name | Description | Metric Conversion | Unit of
Measure
Tubing | High Density Polyethylene (HDPE) Tubing, 1/4" ID, 3/8" OD (10 Feet Per Machine Required) | High Density Polyethylene (HDPE) Tubing, 6mm ID, 10mm OD (3 meters Per Machine Required)
Copper Tubing | 3/8" OD Copper Tubing (Need around 20') | 10mm OD Copper Tubing (Need around 6m)

meter

Inch

Connect the
12" or
300mm
tubing into
the top of the
Copper Coil

Process | Material | Tools | Youtube Link
Name | Description | Metric Conversion | Unit of
Measure
Frame | Complete Assembly of the Frame | Complete Assembly of the Frame
Tubing | High Density Polyethylene (HDPE) Tubing, 1/4" ID, 3/8" OD (10 Feet Per Machine Required) | High Density Polyethylene (HDPE) Tubing, 6mm ID, 10mm OD (3 meters Per Machine Required)

Unit

meter

Insert the
other end of
the 12" or
300mm
Tubing into
the Hole 5 of
the Fan
Deck.

Process | Material | Tools | Youtube Link

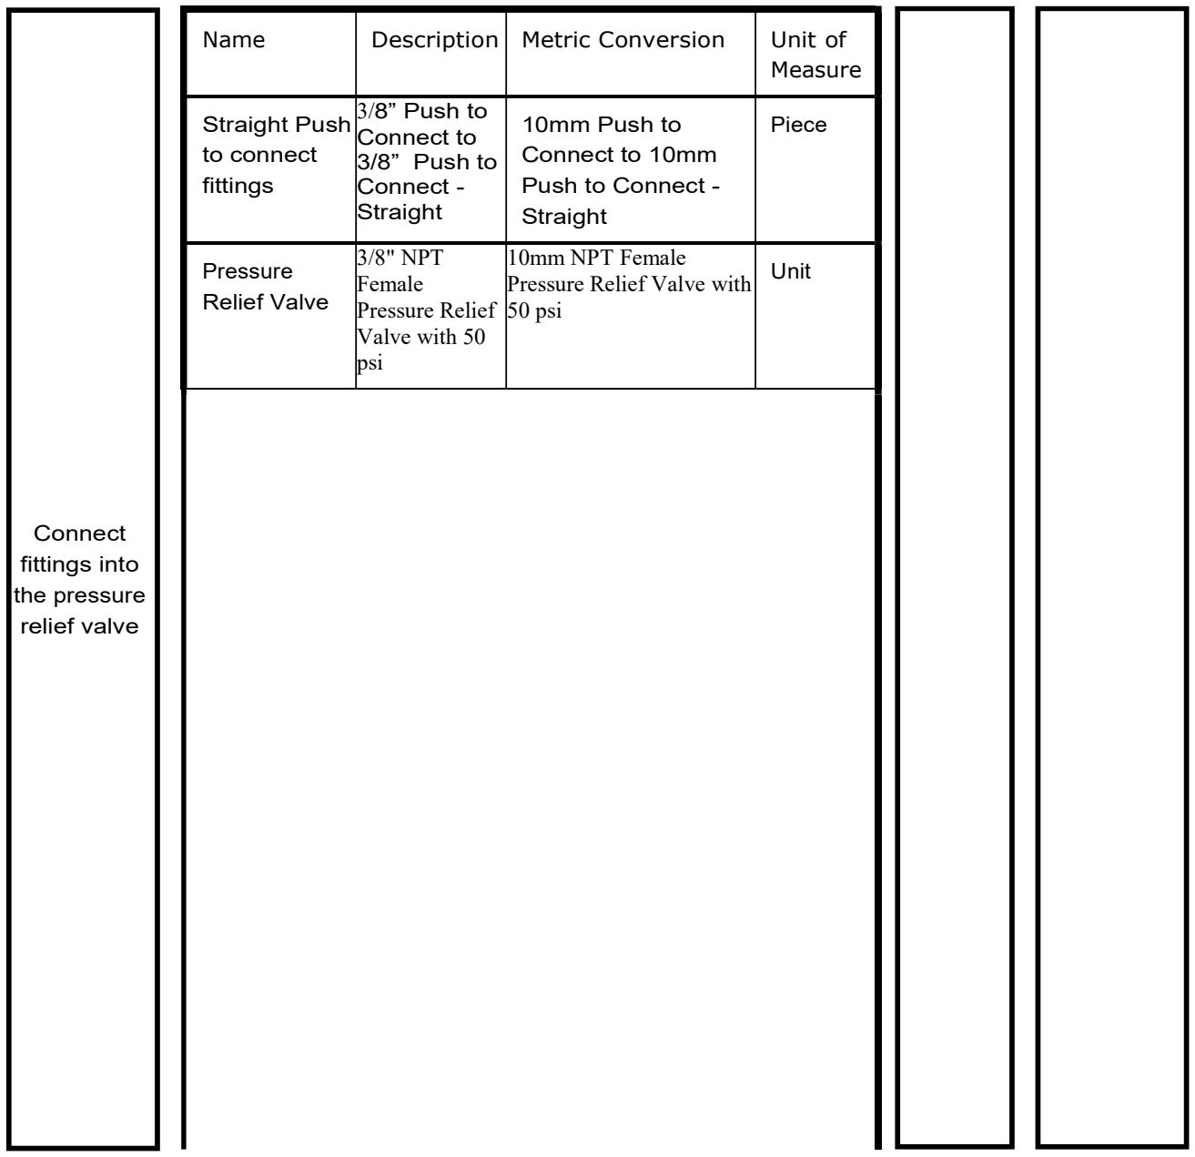
[picture p95: figure]
Connect fittings into the pressure relief valve; Name; Description; Metric Conversion; Unit of; Measure; Straight Push to connect fittings; 3/8” Push to Connect to 3/8” Push to Connect - Straight; 10mm Push to Connect to 10mm Push to Connect - Straight; Piece; Pressure Relief Valve; 3/8" NPT Female Pressure Relief Valve with 50 psi; 10mm NPT Female Pressure Relief Valve with 50 psi; Unit

Process | Material | Tools | Youtube Link

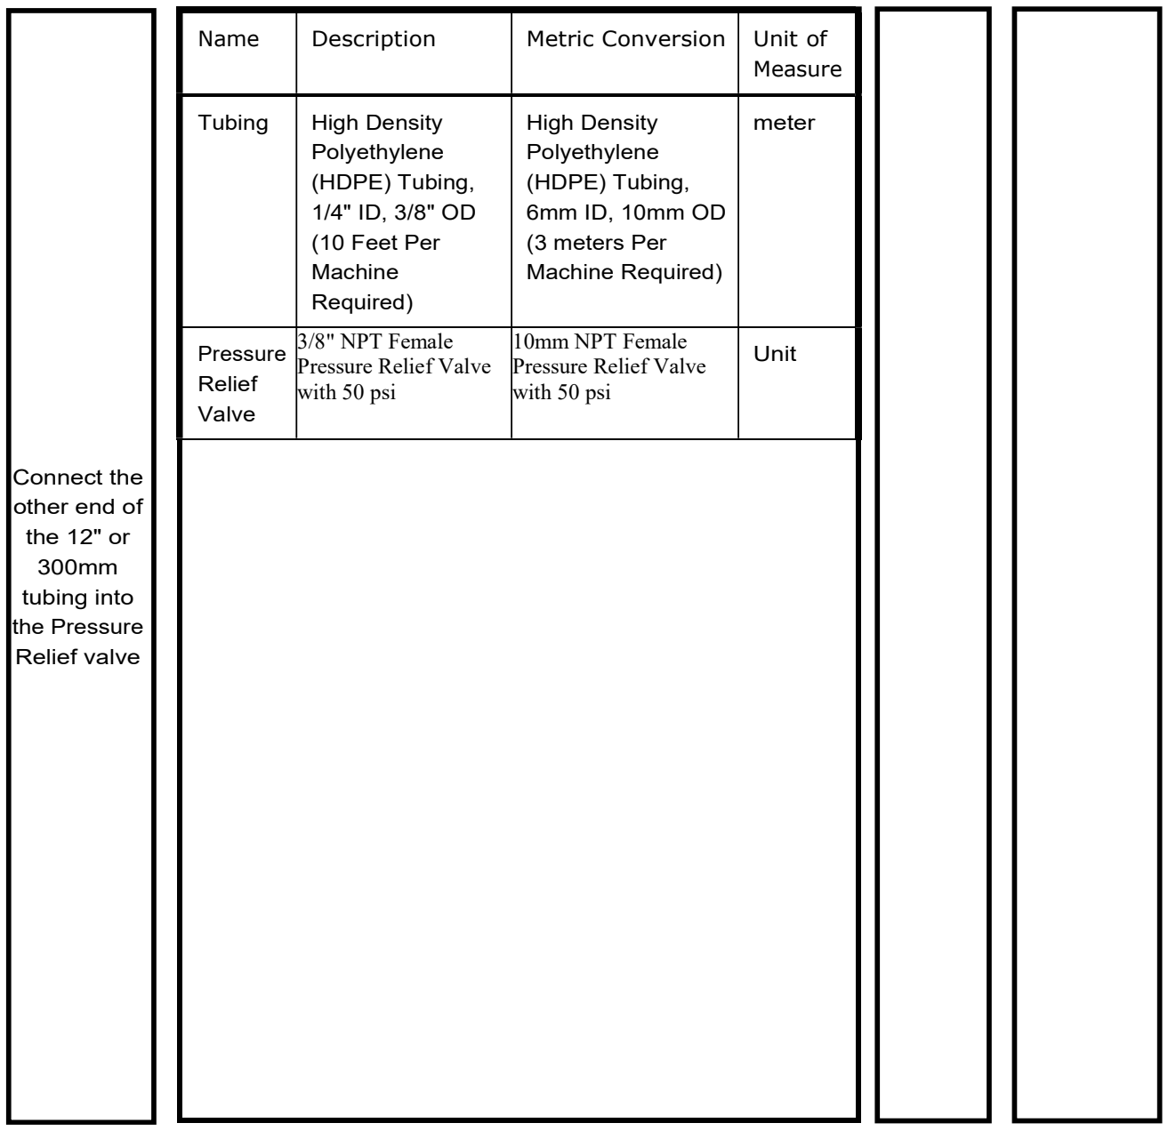
[picture p96: figure]
Connect the other end of the 12" or 300mm tubing into the Pressure Relief valve; Name; Description; Metric Conversion; Unit of; Measure; meter; Unit

Tubing | High Density Polyethylene (HDPE) Tubing, 1/4" ID, 3/8" OD (10 Feet Per Machine Required) | High Density Polyethylene (HDPE) Tubing, 6mm ID, 10mm OD (3 meters Per Machine Required)
Pressure Relief Valve | 3/8" NPT Female Pressure Relief Valve with 50 psi | 10mm NPT Female Pressure Relief Valve with 50 psi

Process | Material | Tools | Youtube Link

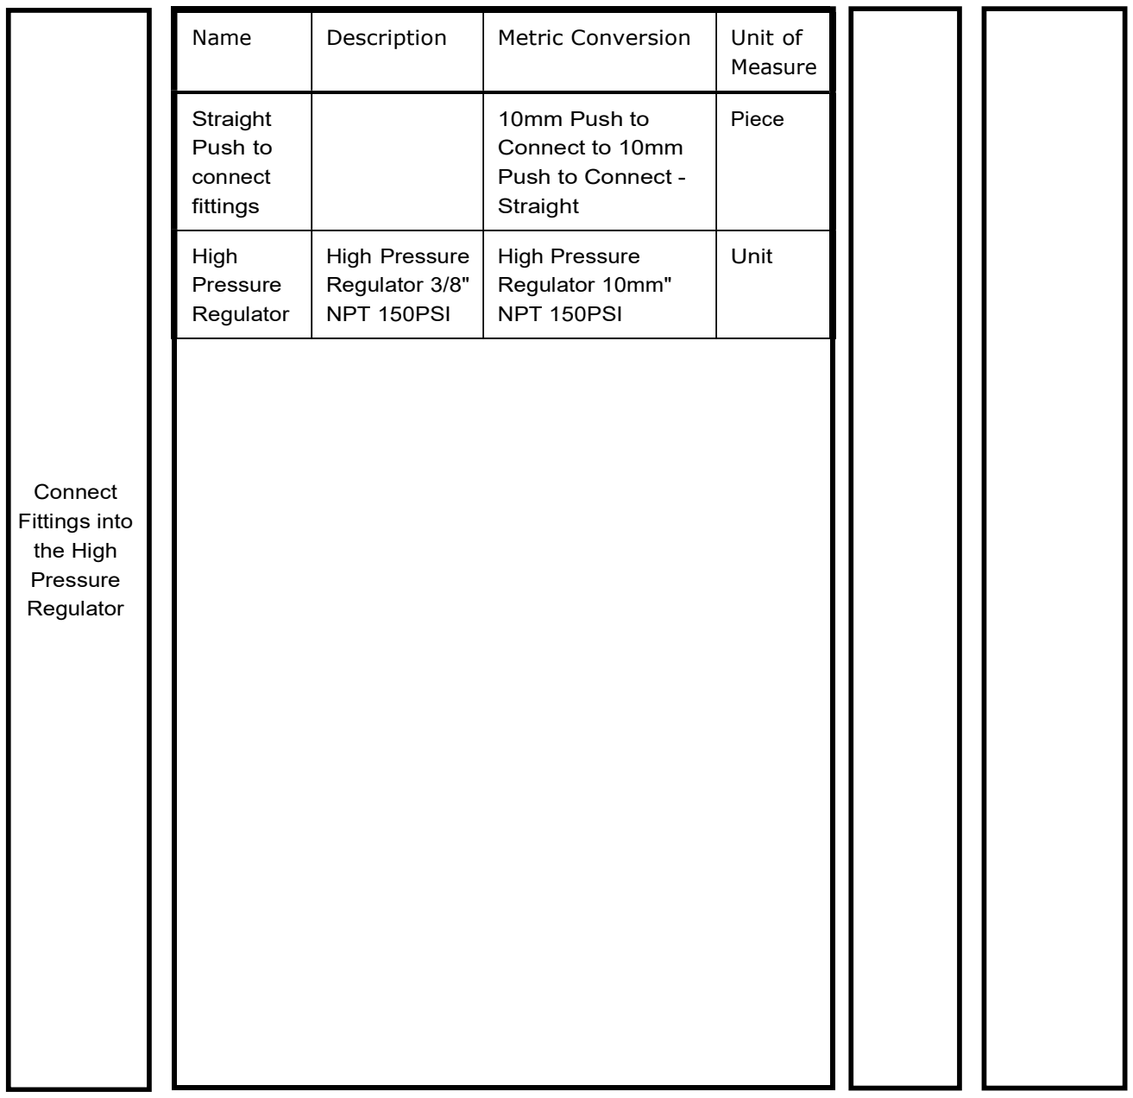
[picture p97: figure]
Connect Fittings into the High Pressure Regulator; Name; Description; Metric Conversion; Unit of; Measure; Piece; Unit

Straight Push to connect fittings | | 10mm Push to Connect to 10mm Push to Connect -Straight
High Pressure Regulator | High Pressure Regulator 3/8" NPT 150PSI | High Pressure Regulator 10mm" NPT 150PSI

Process | Material | Tools | Youtube Link

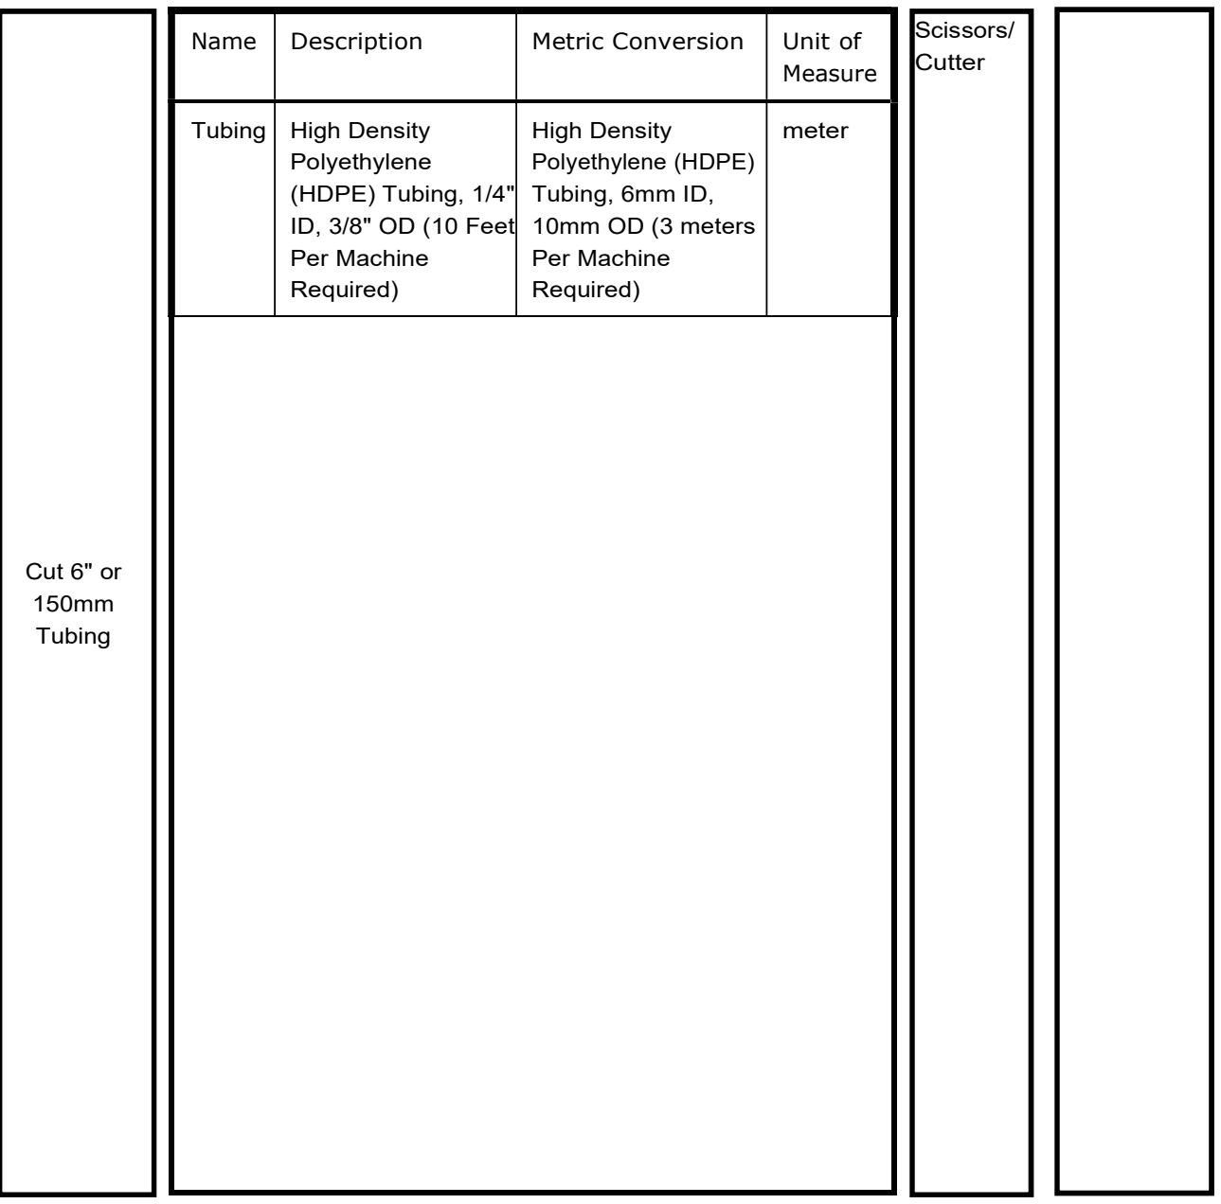
[picture p98: figure]
Cut 6" or 150mm Tubing; Name; Description; Metric Conversion; Unit of; Measure; Tubing; High Density; Polyethylene (HDPE) Tubing, 1/4" ID, 3/8" OD (10 Feet Per Machine Required); High Density Polyethylene (HDPE) Tubing, 6mm ID, 10mm OD (3 meters Per Machine Required); meter; Scissors/ Cutter

Process | Material | Tools | Youtube Link

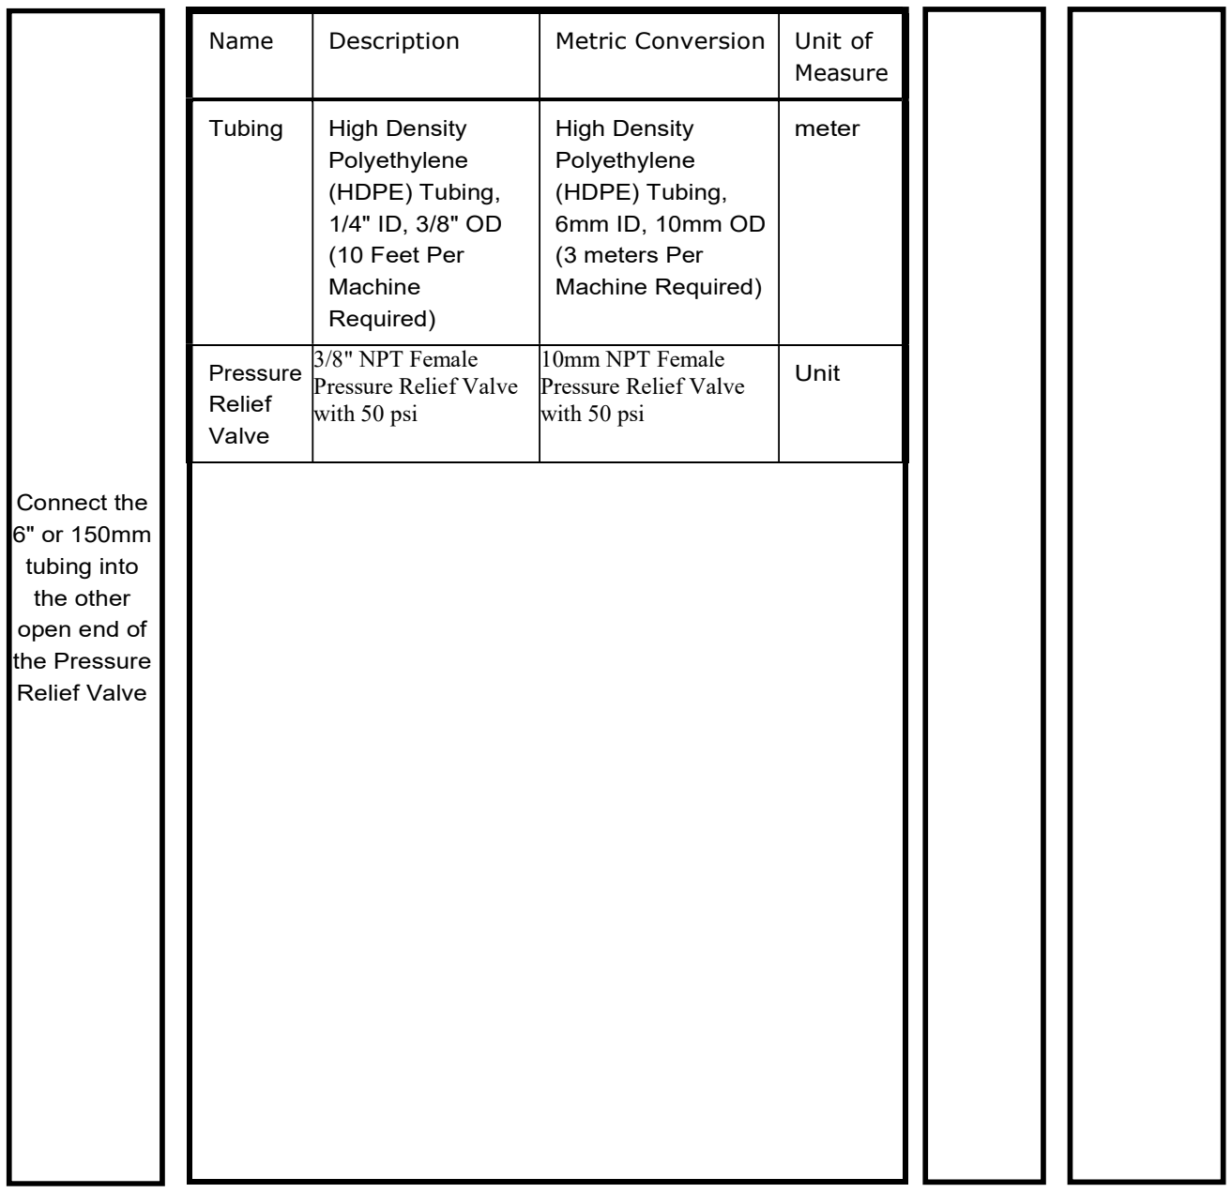
[picture p99: figure]
Connect the 6" or 150mm tubing into the other open end of the Pressure Relief Valve; Name; Description; Metric Conversion; Unit of; Measure; meter; Unit

Tubing | High Density Polyethylene (HDPE) Tubing, 1/4" ID, 3/8" OD (10 Feet Per Machine Required) | High Density Polyethylene (HDPE) Tubing, 6mm ID, 10mm OD (3 meters Per Machine Required)
Pressure Relief Valve | 3/8" NPT Female Pressure Relief Valve with 50 psi | 10mm NPT Female Pressure Relief Valve with 50 psi

Process | Material | Tools | Youtube Link

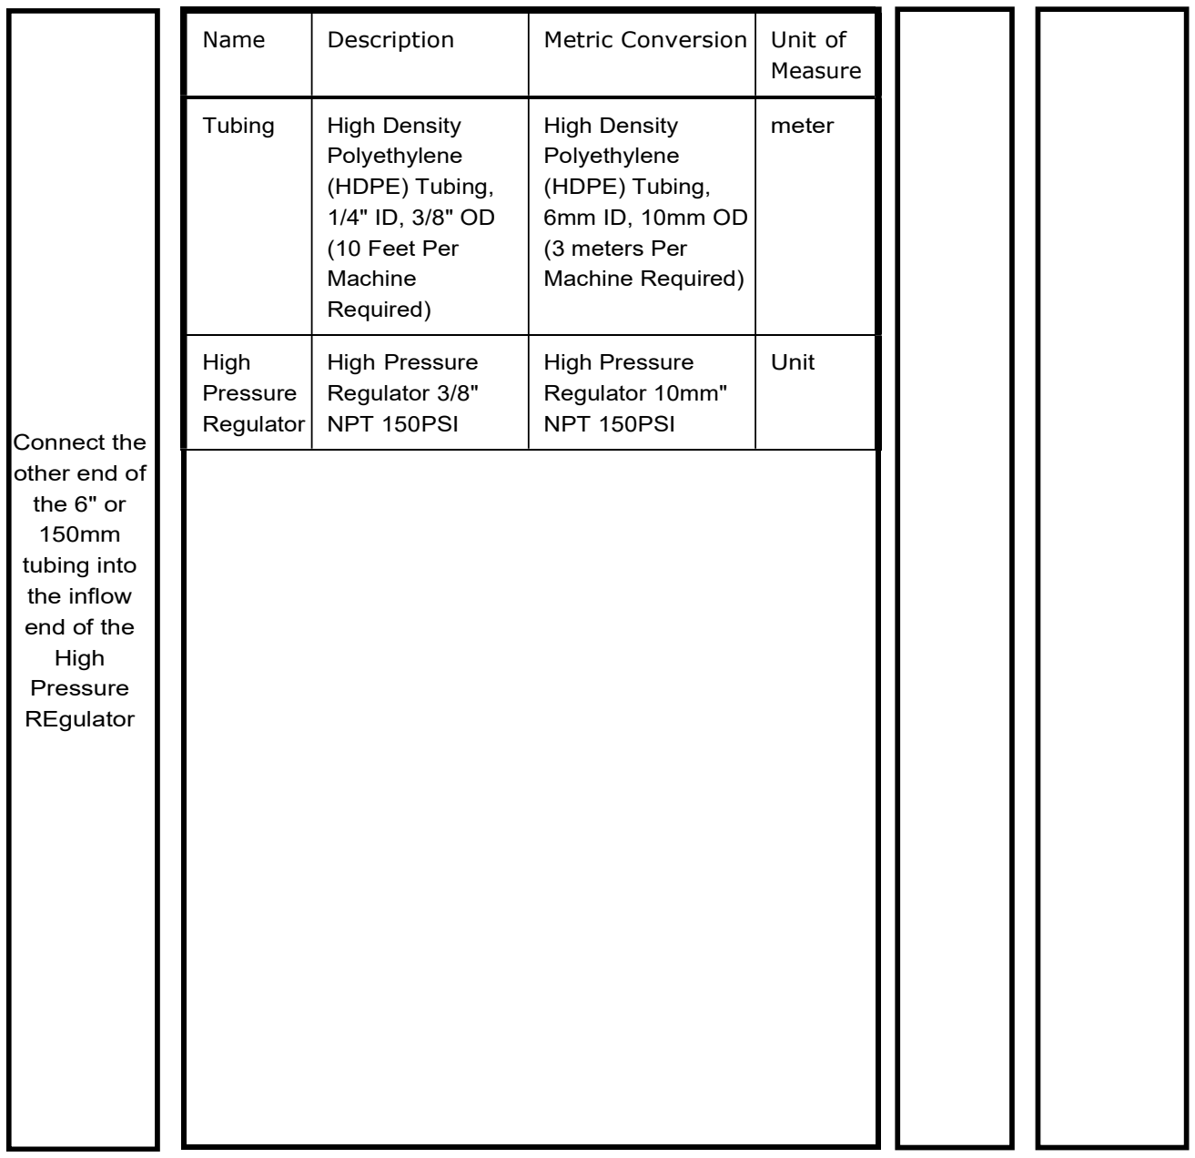
[picture p100: figure]
Connect the other end of the 6" or 150mm tubing into the inflow end of the High Pressure REgulator; Name; Description; Metric Conversion; Unit of; Measure; meter; Unit

Tubing | High Density Polyethylene (HDPE) Tubing, 1/4" ID, 3/8" OD (10 Feet Per Machine Required) | High Density Polyethylene (HDPE) Tubing, 6mm ID, 10mm OD (3 meters Per Machine Required)
High Pressure Regulator | High Pressure Regulator 3/8" NPT 150PSI | High Pressure Regulator 10mm" NPT 150PSI

Process | Material | Tools | Youtube Link

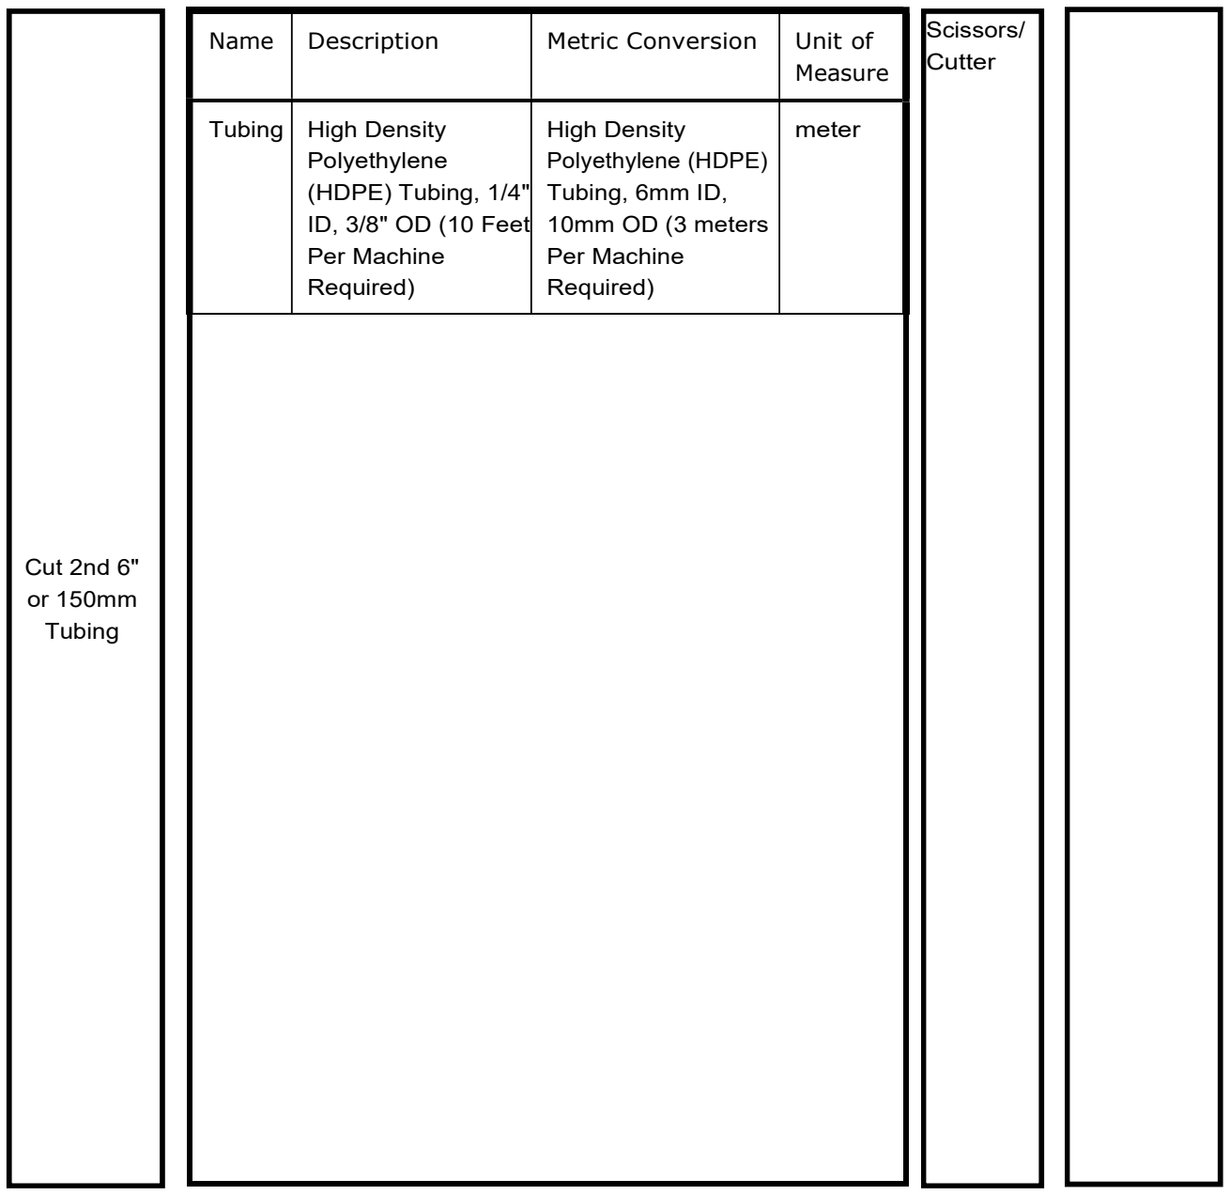
[picture p101: figure]
Cut 2nd 6" or 150mm Tubing; Name; Description; Metric Conversion; Unit of; Measure; Tubing; High Density; Polyethylene (HDPE) Tubing, 1/4" ID, 3/8" OD (10 Feet Per Machine Required); High Density Polyethylene (HDPE) Tubing, 6mm ID, 10mm OD (3 meters Per Machine Required); meter; Scissors/ Cutter

Process | Material | Tools | Youtube Link

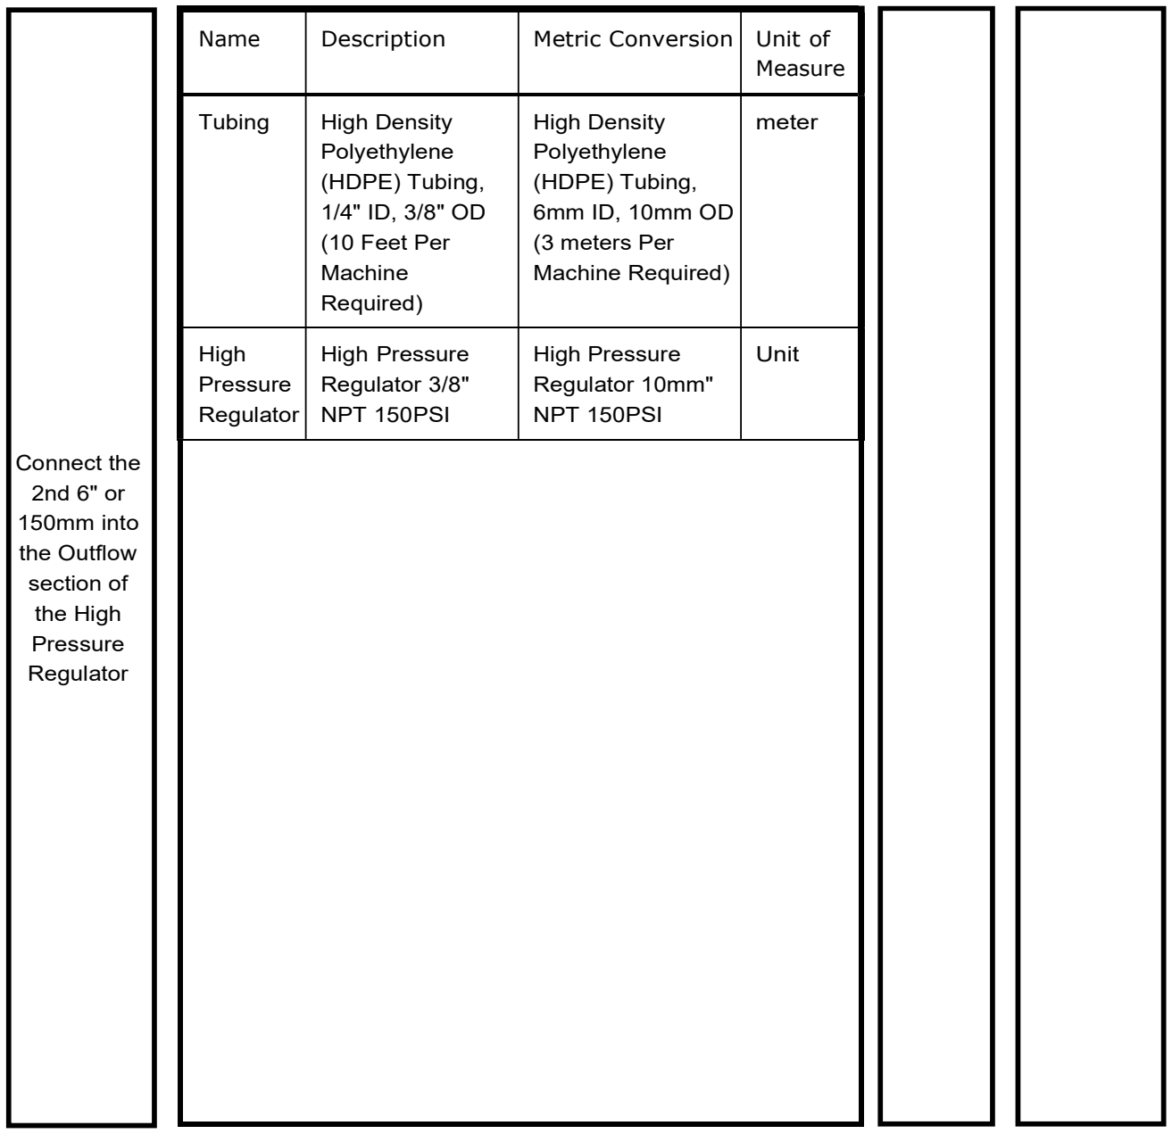
[picture p102: figure]
Connect the 2nd 6" or 150mm into the Outflow section of the High Pressure Regulator; Name; Description; Metric Conversion; Unit of; Measure; meter; Unit

Tubing | High Density Polyethylene (HDPE) Tubing, 1/4" ID, 3/8" OD (10 Feet Per Machine Required) | High Density Polyethylene (HDPE) Tubing, 6mm ID, 10mm OD (3 meters Per Machine Required)
High Pressure Regulator | High Pressure Regulator 3/8" NPT 150PSI | High Pressure Regulator 10mm" NPT 150PSI

Process | Material | Tools | Youtube Link

Connect the
other end of
the 2nd 6" or
150mm
tubing into
the Y Push to
Connect
Fitting
(connected
with the 3
way solenoid
valve)
Name | Description | Metric Conversion | Unit of Measure
Tubing | High Density Polyethylene (HDPE) Tubing, 1/4" ID, 3/8" OD (10 Feet Per Machine Required) | High Density Polyethylene (HDPE) Tubing, 6mm ID, 10mm OD (3 meters Per Machine Required)
Y Push to connect fittings | 3/8"Push to Connect to 3/8"Push to Connect to 3/8"Push to Connect - Y | 10mm Push to Connect to 10mm Push to Connect -Y
3- way Solenoid Valve | 3/8" NPT 3-Way Solenoid Valve, 110 V AC | 10mm FNPT 3 Port 2 Way Solenoid Valve, 110/220 VAC 50/60Hz
High Pressure Regulator | High Pressure Regulator 3/8" NPT 150PSI | High Pressure Regulator 10mm" NPT 150PSI

meter

Piece

Unit

Unit

Page 233 of 245 | Version 1.0

https://drive.
google.com/
drive/folders/
18duHcktmz
T1QRXVuiVt
tSuXc_h-BfB69

Drill Bit
Machine
Name | Description | Metric Conversion | Unit of Measure
4" Cable Ties | 4" Black Cable Ties (Bag of 100) | 100mm x 4mm Black Cable Ties (Bag of 100)
Screws | Screws | Screws

Bag

Secure all
dangling
wires with
tire wraps
and screws

215

Page 234 of 245 | Version 1.0

# Wheels and Handle Installation

Page 235 of 245 | Version 1.0

https://drive.
google.com/
drive/folders/
18duHcktmz
T1QRXVuiVt
tSuXc_h-BfB69

Drill Bit
Machine
Name | Description | Metric Conversion | Unit of Measure
Wheels | 2" Wheels (Sold in 4 Pack) | 50mm Wheels (Sold in 4 Pack)
Screws | Screws | Screws

Piece

Drill the
wheels into
the sides of
the Oxikit
Frame.
Beside the
Sieves

216

Page 236 of 245 | Version 1.0

https://drive.
google.com/
drive/folders/
18duHcktmz
T1QRXVuiVt
tSuXc_h-BfB69
Name | Description | Metric Conversion | Unit of Measure
Handle | Large Pull Handle (Sold in 2 Pack) | Large Pull Handle (Sold in 2 Pack) | Piece

Place the
Handle on
top of the
Oxikit Frame
or on top of
the top Cross
Piece. Ensure
Handle is
positioned on
the Center of
the frame'

217

Page 237 of 245 | Version 1.0

https://drive.
google.com/
drive/folders/
18duHcktmz
T1QRXVuiVt
tSuXc_h-BfB69

Drill Bit
Machine
Name | Description | Metric Conversion | Unit of Measure
Handle | Large Pull Handle (Sold in 2 Pack) | Large Pull Handle (Sold in 2 Pack)
Screws | Screws | Screws

Piece

Drill the
Handle into
the frame

218

Page 238 of 245 | Version 1.0

# Cable and Hooks Installation

Page 239 of 245 | Version 1.0

https://drive.
google.com/
drive/folders/
18duHcktmz
T1QRXVuiVt
tSuXc_h-BfB69
Screwdriver Name | Description | Metric Conversion | Unit of
Measure
Hooks | Cup Hooks (Sold in 72 Pack) | Cup Hooks (Sold in 72 Pack)
Frame | Complete Assembly of the Frame | Complete Assembly of the Frame

Piece

Unit

Punch and
Mark the
postion of
the hooks.
One, beside
the top
portion of
the Sieve and
the second
on the
bottom part
of the Sieve.
These are for
the wires of
the Brain and
Air
Compressor

219

Page 240 of 245 | Version 1.0

https://drive.
google.com/
drive/folders/
18duHcktmz
T1QRXVuiVt
tSuXc_h-BfB69
Name | Description | Metric Conversion | Unit of Measure
Hooks | Cup Hooks (Sold in 72 Pack) | Cup Hooks (Sold in 72 Pack)
Frame | Complete Assembly of the Frame | Complete Assembly of the Frame

Piece

Unit

Install Hooks
on the Side
of the Sieve
Canister.

220

Page 241 of 245 | Version 1.0

https://drive.
google.com/
drive/folders/
18duHcktmz
T1QRXVuiVt
tSuXc_h-BfB69
Screwdriver Name | Description | Metric Conversion | Unit of
Measure
Hooks | Cup Hooks (Sold in 72 Pack) | Cup Hooks (Sold in 72 Pack)
Frame | Complete Assembly of the Frame | Complete Assembly of the Frame

Piece

Unit

Punch and
Mark the
postion of
the hook on
the other
side of the
Oxikit Frame.
Beside the
top portion
of the Sieve.
This is for
wires of the
oxygen mask

221

Page 242 of 245 | Version 1.0

https://drive.
google.com/
drive/folders/
18duHcktmz
T1QRXVuiVt
tSuXc_h-BfB69
Name | Description | Metric Conversion
Unit of
Measure
Oxygen Mask | Oxygen Mask with Tubing | Oxygen Mask with Tubing
Humidifier Water Bottle | Humidifier Water Bottle | Humidifier Water Bottle

Piece

Pieces

Connect the
Oxygen mask
into the
Bubbler.

222

Page 243 of 245 | Version 1.0

https://drive.
google.com/
drive/folders/
18duHcktmz
T1QRXVuiVt
tSuXc_h-BfB69
Name | Description | Metric Conversion | Unit of Measure
Oxygen Mask | Oxygen Mask with Tubing | Oxygen Mask with Tubing
Hooks | Cup Hooks (Sold in 72 Pack) | Cup Hooks (Sold in 72 Pack)
Frame | Complete Assembly of the Frame | Complete Assembly of the Frame

Piece

Piece

Unit

Hang the
Oxygen Mask
into the Hook

223

Page 244 of 245 | Version 1.0

https://www.
dropbox.com
/sh/ny5zjc07f
lfr7w5/AABn
1HDv42Nn4l
SACj989yU3
a/Video?dl=0
&preview=O
xiKit+Final+A
ssembly+Tut
orial+4+of+4.
MP4&subfol
der_nav_trac
king=1
Name | Description | Metric Conversion
Unit of
Measure
Air Compressor | California Air Tools SP-9421 2.0HP Ultra Quiet and Oil-Free Air Compressor Motor | California Air Tools SP-9421 2.0HP Ultra Quiet and Oil-Free Air Compressor Motor
Hooks | Cup Hooks (Sold in 72 Pack) | Cup Hooks (Sold in 72 Pack)
Frame | Complete Assembly of the Frame | Complete Assembly of the Frame

Unit

Piece

Unit

Secure the | Power Cord | Power Cord | Power Cord | Piece
Power Cord
of the Air
Compressor

224

Page 245 of 245 | Version 1.0
