OxiKit/oxygen-concentrator-how-to-diy-open-source/Surge Tank WorkFlow.pdf

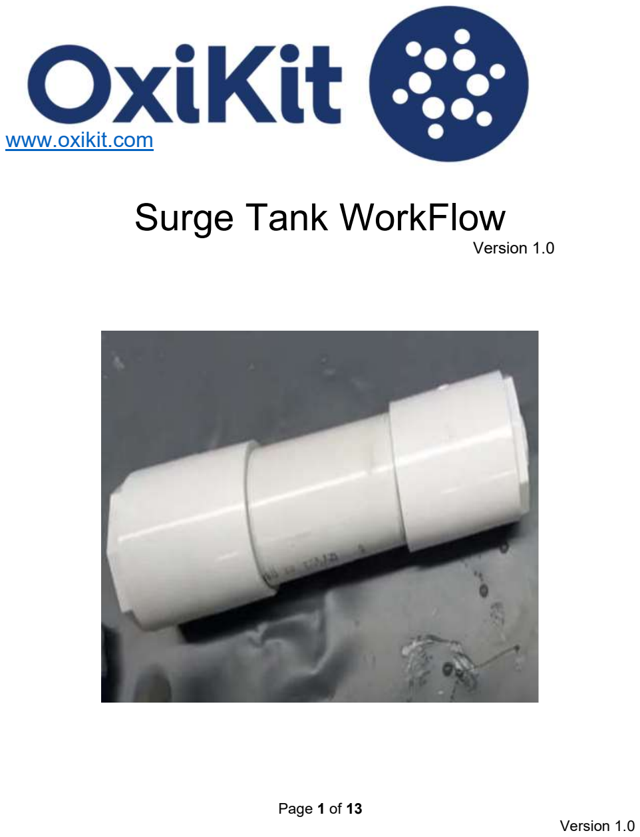
[picture p103: page 1]

### Page 1 of 13 Version 1.0

# www.oxikit.com

# Surge Tank WorkFlow

### Version 1.0

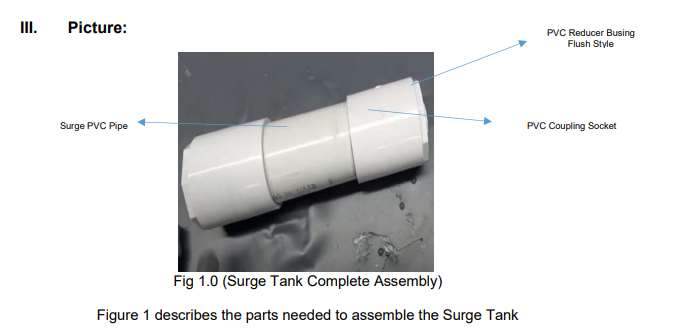
[picture p104: figure]

### Page 2 of 13

Document # | Date Effective

## OXIKIT-SG001

Supersedes Document Version #:

### OXIKIT WORKFLOW

Document Title

## Surge Tank Assembly

### Change History Log:

VERSION # | REVISION DATE | DESCRIPTION OF CHANGE
FROM | TO
1.0 | 11/27/2020 | Original Release

### I. Purpose: This Workflow is intended to serve as a guide in assembling one of the main components of the Oxikit, the Surge Tank. The tank serves as an Empty Vessel that

holds the oxygen before it is being consumed by the user.

II. Scope: This guideline applies to all individuals who wish to build the DIY Oxikit. It includes the Materials, tools and the Video Link needed in assembling the making the Drain Cover Trim and Tube

### Page 3 of 13

Document # | Date Effective

## OXIKIT-DC001

Supersedes Document Version #:

### OXIKIT WORKFLOW

Document Title

## Workflow - Drain Cover Trim and Tube

### III. Safety Operating Conditions:

- Always wear protective gloves, googles and mask.

### IV. Workflows - Please see next page for the step by step guidelines in making the Surge Tank Assembly

Step | Process | Materiel | Tools | Youtube Link

### Page 4 of 13

Deburrin
g tool
Sand
Paper

1

2

https://www.youtub
e.com/watch?v=QF
7h1LyMVdY&list=P
L4O1RQEiLpHBJ0i
1zqe-CZk1p_NTtGl76&i
ndex=8

Wash and
clean All PVC
Pipes and
Fittings
Name | Description | Metric Conversion | Unit of Measure
Surge PVC Pipe | 3" Schedule 40 PVC Pipe 9" height | 7 mm Schedule 40 (Series 1000) PVC Pipe 228 mm height
PVC Coupling Socket | 3" Sch 40 PVC Coupling - Socket | 75mm Sch 40 (Series 1000) PVC Coupling -Socket
PVC Reducer Busing Flush Style | 3" x 3/4" Sch 40 PVC Reducer Bushing Flush Style - Spig x Fipt | 75mm x 20mm Sch 40 (Series 1000) PVC Reducer Bushing Flush Style - Spig x Fipt

Piece

Piece

Piece

https://www.youtub
e.com/watch?v=QF
7h1LyMVdY&list=P
L4O1RQEiLpHBJ0i
1zqe-CZk1p_NTtGl76&in
dex=8

Smooth all
edges of the
Surge PVC
Pipe
Name | Description | Metric Conversion | Unit of Measure
Surge PVC Pipe | 3" Schedule 40 PVC Pipe 9" height | 7 mm Schedule 40 (Series 1000) PVC Pipe 228 mm height | Piece

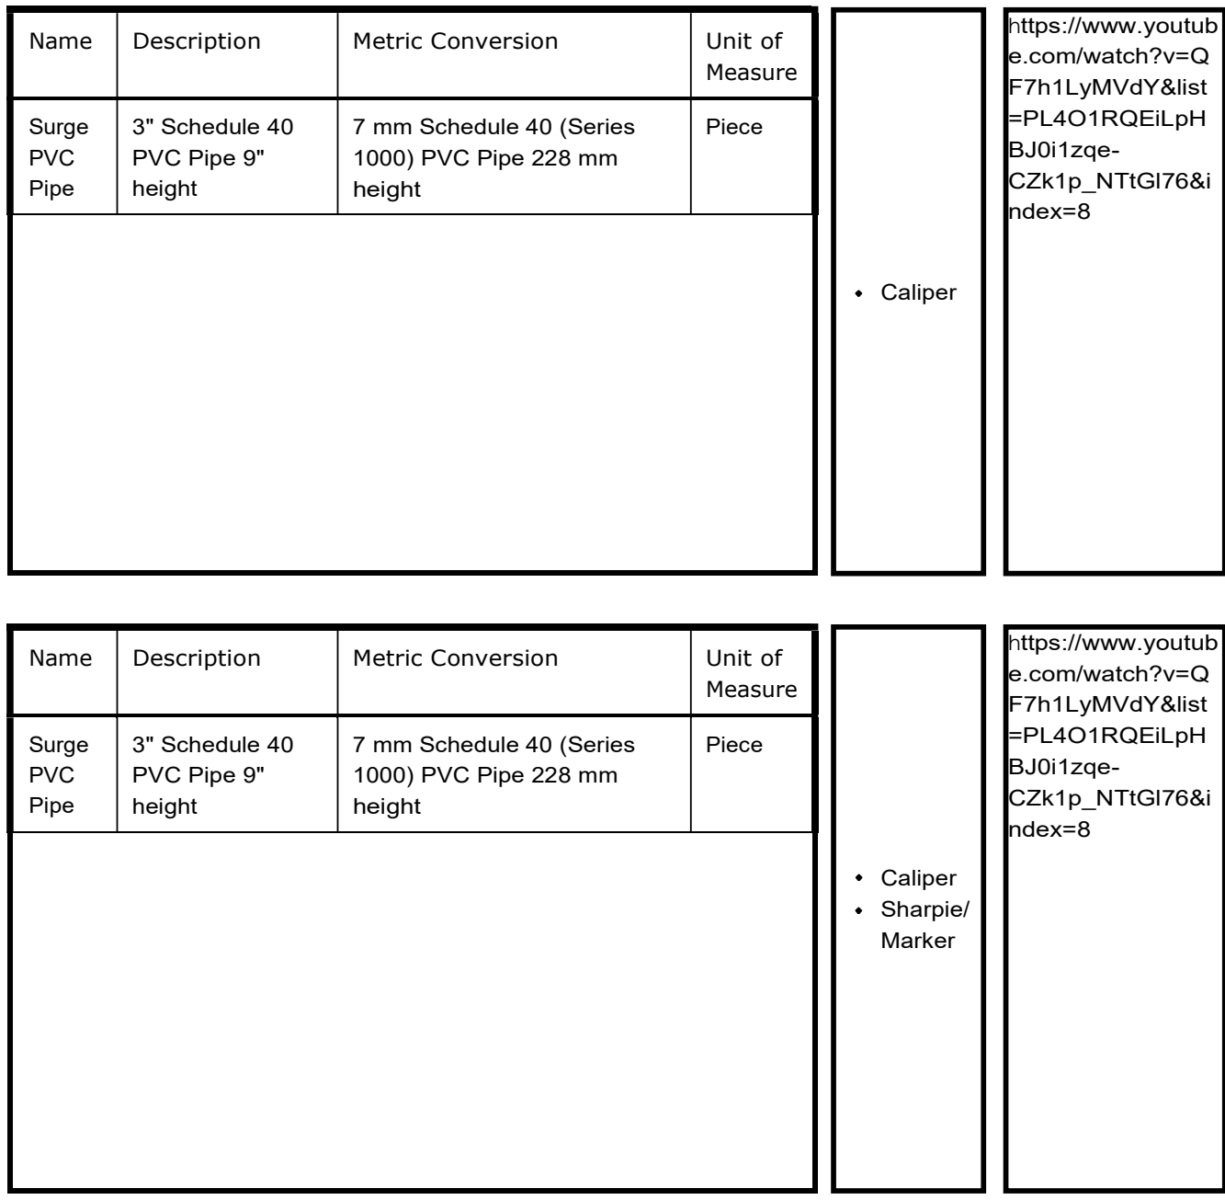
[picture p105: figure]
Caliper Sharpie/ Marker; https://www.youtub e.com/watch?v=Q F7h1LyMVdY&list =PL4O1RQEiLpH BJ0i1zqe- CZk1p_NTtGl76&i ndex=8; Caliper; Name; Description; Metric Conversion; Unit of; Measure; Surge PVC Pipe; 3" Schedule 40 PVC Pipe 9" height; 7 mm Schedule 40 (Series 1000) PVC Pipe 228 mm height; Piece

### Page 5 of 13

3

4

Measure 2"
on each side
of the Surge
PVC Pipe

Label 2" on
each side of
the Surge
PVC Pipe

### Page 6 of 13

5

6

https://www.youtub
e.com/watch?v=Q
F7h1LyMVdY&list
=PL4O1RQEiLpH
BJ0i1zqe-CZk1p_NTtGl76&i
ndex=8

Put glue on one
of the marked 2”
section of the
Surge PVC Pipe
and on the PVC
Coupling Socket.
Put a large
amount of glue
on the outside
portion of the
male end (Surge
PVC Pipe) and
less on the
inside of the
female end
(PVC
Coupling
Socket).
Name | Description | Metric Conversion | Unit of Measure
PVC Glue | Gorilla PVC Cement 8 oz. R1584C Medium Body PrimaGlue, One-Step | Gorilla PVC Cement 230ml R1584C Medium Body PrimaGlue, One-Step
Surge PVC Pipe | 3" Schedule 40 PVC Pipe 9" height | 7 mm Schedule 40 (Series 1000) PVC Pipe 228 mm height
PVC Coupling Socket | 3" Sch 40 PVC Coupling - Socket | 75mm Sch 40 (Series 1000) PVC Coupling -Socket

Ounce

Piece

Piece

https://www.youtub
e.com/watch?v=Q
F7h1LyMVdY&list
=PL4O1RQEiLpH
BJ0i1zqe-CZk1p_NTtGl76&i
Surge PVC Pipe | 3" Schedule 40 PVC Pipe 9" height | 7 mm Schedule 40 (Series 1000) PVC Pipe 228 mm height | ndex=8 Place the
PVC Coupling Socket | 3" Sch 40 PVC Coupling -Socket | 75mm Sch 40 (Series 1000) PVC Coupling - Socket

PVC Coupling
socket on top
of the Surge
PVC Pipe.
Put a little bit
of pressure
to connect
the parts.
Name | Description | Metric Conversion | Unit of Measure
| | | Piece

Piece

### Page 7 of 13

7

8

https://www.youtub
e.com/watch?v=Q
F7h1LyMVdY&list
=PL4O1RQEiLpH
BJ0i1zqe-CZk1p_NTtGl76&i
ndex=8
Wipe any
excess glue
on the PVCs
connected.
Name | Description | Metric Conversion | Unit of Measure
Surge PVC Pipe | 3" Schedule 40 PVC Pipe 9" height | 7 mm Schedule 40 (Series 1000) PVC Pipe 228 mm height
PVC Coupling Socket | 3" Sch 40 PVC Coupling -Socket | 75mm Sch 40 (Series 1000) PVC Coupling -Socket

Piece

Piece

Towel/Tissue | Towel/Tissue | Towel/Tissue | roll

https://www.youtub
e.com/watch?v=Q
F7h1LyMVdY&list
=PL4O1RQEiLpH
BJ0i1zqe-CZk1p_NTtGl76&i
ndex=8

Put glue on the
PVC Reducer
Bushing Flush
Style and the
PVC Coupling
Socket. Put a
large amount of
glue all around
the outside
portion of the
male end (PVC
Reducer
Bushing Flush
Style) and less
on the inside of
the female end
(PVC Coupling
Socket ).
Name | Description | Metric Conversion | Unit of Measure
Surge PVC Pipe | 3" Schedule 40 PVC Pipe 9" height | 7 mm Schedule 40 (Series 1000) PVC Pipe 228 mm height
PVC Coupling Socket | 3" Sch 40 PVC Coupling - Socket | 75mm Sch 40 (Series 1000) PVC Coupling -Socket
PVC Reducer Busing Flush Style | 3" x 3/4" Sch 40 PVC Reducer Bushing Flush Style - Spig x Fipt | 75mm x 20mm Sch 40 (Series 1000) PVC Reducer Bushing Flush Style - Spig x Fipt

Piece

Piece

Piece

PVC Glue Gorilla PVC Cement 8 oz R1584C Medium

Gorilla PVC Cement
230ml R1584C Medium

Ounce

### Page 8 of 13

9

10

https://www.youtub
e.com/watch?v=Q
F7h1LyMVdY&list
=PL4O1RQEiLpH
BJ0i1zqe-CZk1p_NTtGl76&i
ndex=8

Place the
PVC Reducer
Bushing
Flush Style
on top of the
PVC
Coupling
Socket. Put a
little bit of
pressure to
connect the
parts.
Name | Description | Metric Conversion | Unit of Measure
Surge PVC Pipe | 3" Schedule 40 PVC Pipe 9" height | 7 mm Schedule 40 (Series 1000) PVC Pipe 228 mm height
PVC Coupling Socket | 3" Sch 40 PVC Coupling - Socket | 75mm Sch 40 (Series 1000) PVC Coupling -Socket
PVC Reducer Busing Flush Style | 3" x 3/4" Sch 40 PVC Reducer Bushing Flush Style - Spig x Fipt | 75mm x 20mm Sch 40 (Series 1000) PVC Reducer Bushing Flush Style - Spig x Fipt

Piece

Piece

Piece

https://www.youtub
e.com/watch?v=Q
F7h1LyMVdY&list
=PL4O1RQEiLpH
BJ0i1zqe-CZk1p_NTtGl76&i
ndex=8
Wipe any
excess glue
on the PVCs
connected.
Name | Description | Metric Conversion | Unit of Measure
Surge PVC Pipe | 3" Schedule 40 PVC Pipe 9" height | 7 mm Schedule 40 (Series 1000) PVC Pipe 228 mm height
PVC Coupling Socket | 3" Sch 40 PVC Coupling - Socket | 75mm Sch 40 (Series 1000) PVC Coupling -Socket
PVC Reducer Busing Flush Style | 3" x 3/4" Sch 40 PVC Reducer Bushing Flush Style - Spig x Fipt | 75mm x 20mm Sch 40 (Series 1000) PVC Reducer Bushing Flush Style - Spig x Fipt

Piece

Piece

Piece

Towel/Tissue | Towel/Tissue | Towel/Tissue | roll

### Page 9 of 13

11

12

https://www.youtub
e.com/watch?v=Q
F7h1LyMVdY&list
=PL4O1RQEiLpH
BJ0i1zqe-CZk1p_NTtGl76&i
ndex=8

Put glue on
another piece of
PVC Reducer
Bushing Flush
Style and
another piece of
PVC Coupling
Socket. Put a
large amount of
glue all around
the outside
portion of the
Male end (PVC
Reducer
Bushing Flush
Style) and less
on the inside of
the female end
(PVC Coupling
Socket ).
Name | Description | Metric Conversion | Unit of Measure
PVC Glue | Gorilla PVC Cement 8 oz. R1584C Medium Body PrimaGlue, One-Step | Gorilla PVC Cement 230ml R1584C Medium Body PrimaGlue, One-Step
PVC Coupling Socket | 3" Sch 40 PVC Coupling - Socket | 75mm Sch 40 (Series 1000) PVC Coupling -Socket
PVC Reducer Busing Flush Style | 3" x 3/4" Sch 40 PVC Reducer Bushing Flush Style - Spig x Fipt | 75mm x 20mm Sch 40 (Series 1000) PVC Reducer Bushing Flush Style - Spig x Fipt

Ounce

Piece

Piece

https://www.youtub
e.com/watch?v=Q
F7h1LyMVdY&list
=PL4O1RQEiLpH
BJ0i1zqe-CZk1p_NTtGl76&i
ndex=8

Place the
PVC Reducer
Bushing
Flush Style
on top of the
PVC
Coupling
Socket. Put a
little bit of
pressure to
connect the
parts.
Name | Description | Metric Conversion | Unit of Measure
PVC Coupling Socket | 3" Sch 40 PVC Coupling - Socket | 75mm Sch 40 (Series 1000) PVC Coupling -Socket
PVC Reducer Busing Flush Style | 3" x 3/4" Sch 40 PVC Reducer Bushing Flush Style - Spig x Fipt | 75mm x 20mm Sch 40 (Series 1000) PVC Reducer Bushing Flush Style - Spig x Fipt

Piece

Piece

### Page 10 of 13

13

14

https://www.youtub
e.com/watch?v=Q
F7h1LyMVdY&list
=PL4O1RQEiLpH
BJ0i1zqe-CZk1p_NTtGl76&i
ndex=8
Wipe any
excess glue
on the PVCs
connected.
Name | Description | Metric Conversion | Unit of Measure
PVC Coupling Socket | 3" Sch 40 PVC Coupling - Socket | 75mm Sch 40 (Series 1000) PVC Coupling -Socket
PVC Reducer Busing Flush Style | 3" x 3/4" Sch 40 PVC Reducer Bushing Flush Style - Spig x Fipt | 75mm x 20mm Sch 40 (Series 1000) PVC Reducer Bushing Flush Style - Spig x Fipt

Piece

Piece

https://www.youtub
e.com/watch?v=Q
F7h1LyMVdY&list
=PL4O1RQEiLpH
BJ0i1zqe-CZk1p_NTtGl76&i
ndex=8

Put glue on the
open side of the
Surge PVC Pipe
and the PVC
Coupling Socket
with the PVC
Reducer Bushing
Flush Style step
11.
Put a large
amount of glue
all around the
outside portion
of the Male end
(Surge PVC
Pipe) and less
on the inside of
the female end
(PVC Coupling
Socket).
Name | Description | Metric Conversion | Unit of Measure
Surge PVC Pipe | 3" Schedule 40 PVC Pipe 9" height | 7 mm Schedule 40 (Series 1000) PVC Pipe 228 mm height
PVC Coupling Socket | 3" Sch 40 PVC Coupling - Socket | 75mm Sch 40 (Series 1000) PVC Coupling -Socket
PVC Reducer Busing Flush Style | 3" x 3/4" Sch 40 PVC Reducer Bushing Flush Style - Spig x Fipt | 75mm x 20mm Sch 40 (Series 1000) PVC Reducer Bushing Flush Style - Spig x Fipt

Piece

Piece

Piece

PVC Glue Gorilla PVC Cement 8 oz R1584C Medium

Gorilla PVC Cement
230ml R1584C Medium

Ounce

### Page 11 of 13

15

16

https://www.youtub
e.com/watch?v=Q
F7h1LyMVdY&list
=PL4O1RQEiLpH
BJ0i1zqe-CZk1p_NTtGl76&i
ndex=8

Place the PVC
Coupling
Socket with
PVC Reducer
Flush Style on
top of the
other open
end of the
Surge PVC
Pipe.
Put a little bit
of pressure
to connect
the parts.
Name | Description | Metric Conversion | Unit of Measure
Surge PVC Pipe | 3" Schedule 40 PVC Pipe 9" height | 7 mm Schedule 40 (Series 1000) PVC Pipe 228 mm height
PVC Coupling Socket | 3" Sch 40 PVC Coupling - Socket | 75mm Sch 40 (Series 1000) PVC Coupling -Socket
PVC Reducer Busing Flush Style | 3" x 3/4" Sch 40 PVC Reducer Bushing Flush Style - Spig x Fipt | 75mm x 20mm Sch 40 (Series 1000) PVC Reducer Bushing Flush Style - Spig x Fipt

Piece

Piece

Piece

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

Piece

Piece

Piece

Towel/Tissue | Towel/Tissue | Towel/Tissue | roll

### Page 12 of 13

17

18

https://www.youtub
e.com/watch?v=Q
F7h1LyMVdY&list
=PL4O1RQEiLpH
BJ0i1zqe-CZk1p_NTtGl76&i
ndex=8

Let it dry for
1-2 days.
Name | Description | Metric Conversion | Unit of Measure
Surge Tank Assembly | Complete and Finished Surge Tank Assembly | Complete and Finished Surge Tank Assembly | Lot

https://www.youtub
e.com/watch?v=Q
F7h1LyMVdY&list
=PL4O1RQEiLpH
BJ0i1zqe-CZk1p_NTtGl76&i
ndex=8 Blow out air

inside the tank
to clear out
accumulated
fumes inside
the tank
Name | Description | Metric Conversion | Unit of Measure
Surge Tank Assembly | Complete and Finished Surge Tank Assembly | Complete and Finished Surge Tank Assembly | Lot

### Page 13 of 13

19

https://www.youtub
e.com/watch?v=Q
F7h1LyMVdY&list
=PL4O1RQEiLpH
BJ0i1zqe-CZk1p_NTtGl76&i
ndex=8
Seal the
surge tank by
placing the
fittings on
each end of
the tank
Name | Description | Metric Conversion | Unit of Measure
Surge Tank Assembly | Complete and Finished Surge Tank Assembly | Complete and Finished Surge Tank Assembly
PVC Reducer Bushing (T.T) | 3/4" x 3/8" Sch 40 PVC Reducer (T.T.) Bushing - Mipt x Fipt | 20mm x 10mm Sch 40 (Series 1000) PVC Reducer (T.T.) Bushing -Mipt x Fipt
3/8" Male Straight Push-in Connect Fittings | 3/8" Male NPT to 3/8"Push to Connect - Strait | 10mm Male NPT to 10mm Push to Connect - Strait

Lot

Piece

Piece
