OxiKit/oxygen-concentrator-how-to-diy-open-source/Renderings/OxyKit v17back.png

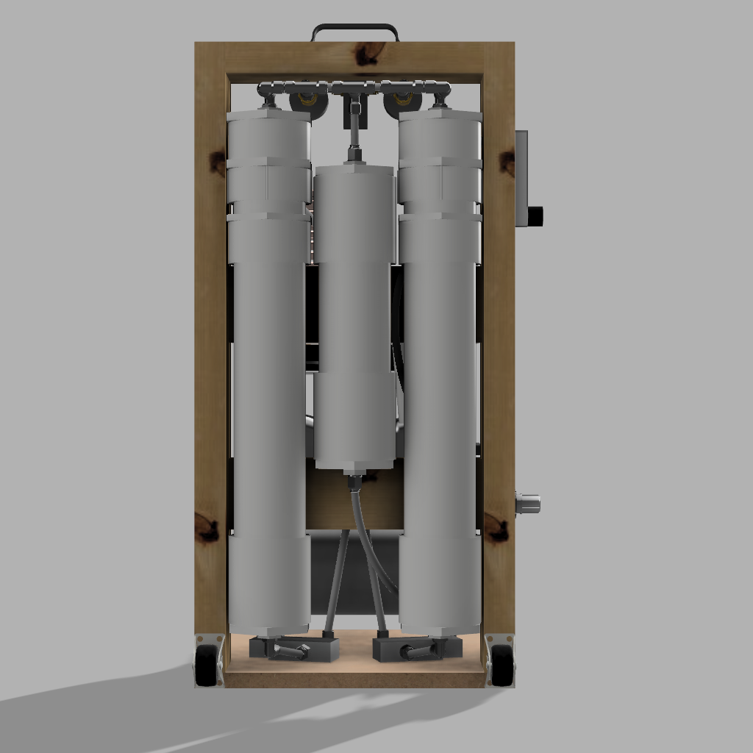
Renderings/OxyKit v17back.png
