OxiKit/oxygen-concentrator-how-to-diy-open-source/Renderings/OxyKit v17Bottom.png

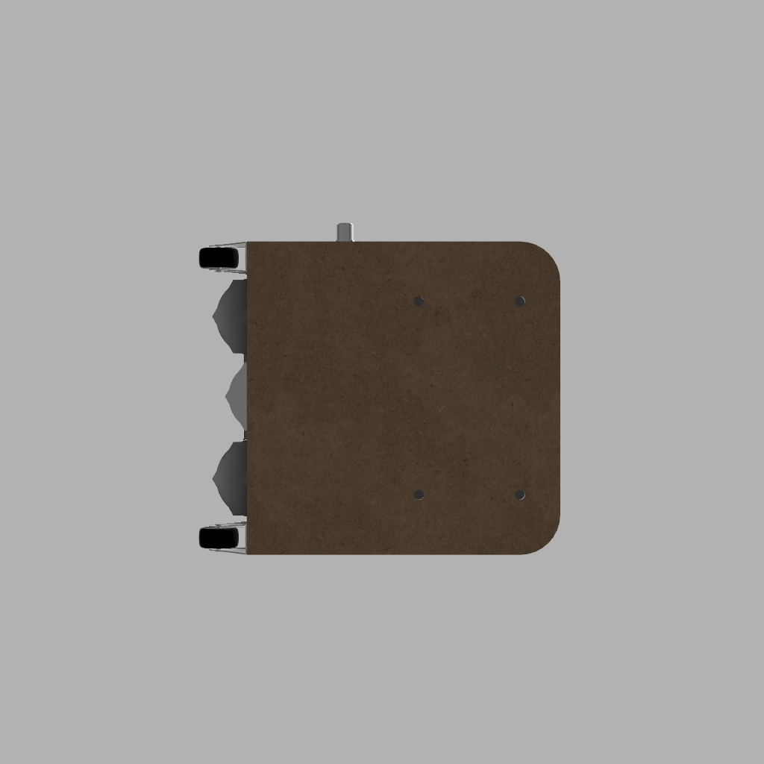
Renderings/OxyKit v17Bottom.png
