OxiKit/oxygen-concentrator-how-to-diy-open-source/Renderings/OxyKit v17Frame.png

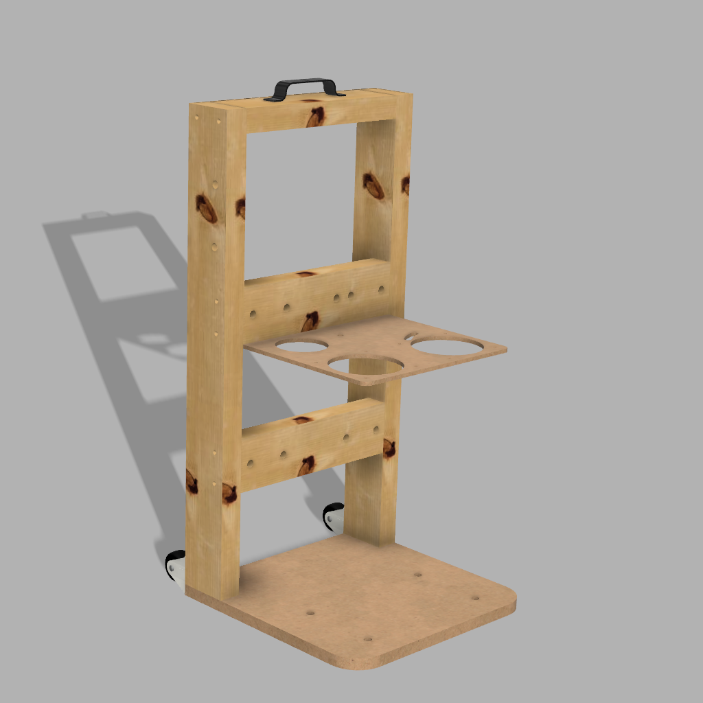
Renderings/OxyKit v17Frame.png
