OxiKit/oxygen-concentrator-how-to-diy-open-source/Renderings/OxyKit v17Front.png

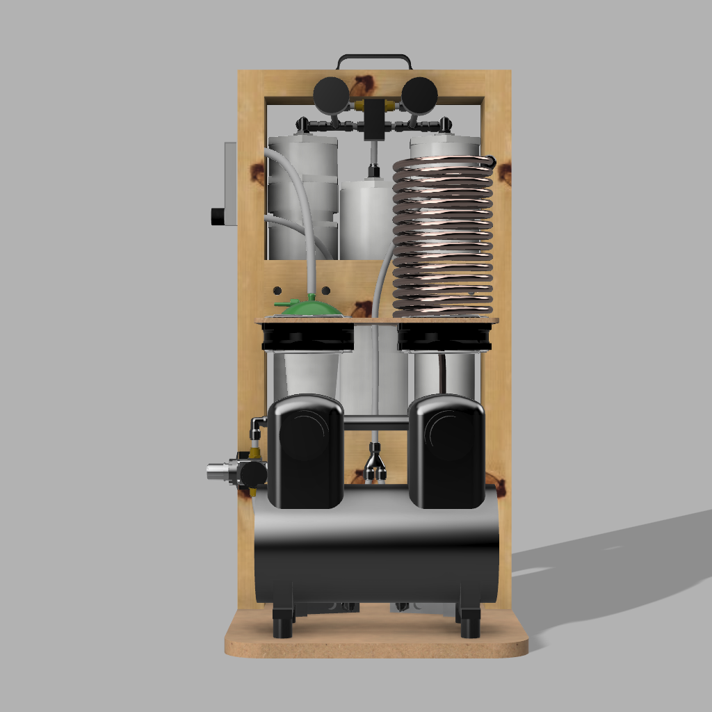
Renderings/OxyKit v17Front.png
