OxiKit/oxygen-concentrator-how-to-diy-open-source/Renderings/OxyKit v17Isometric.png

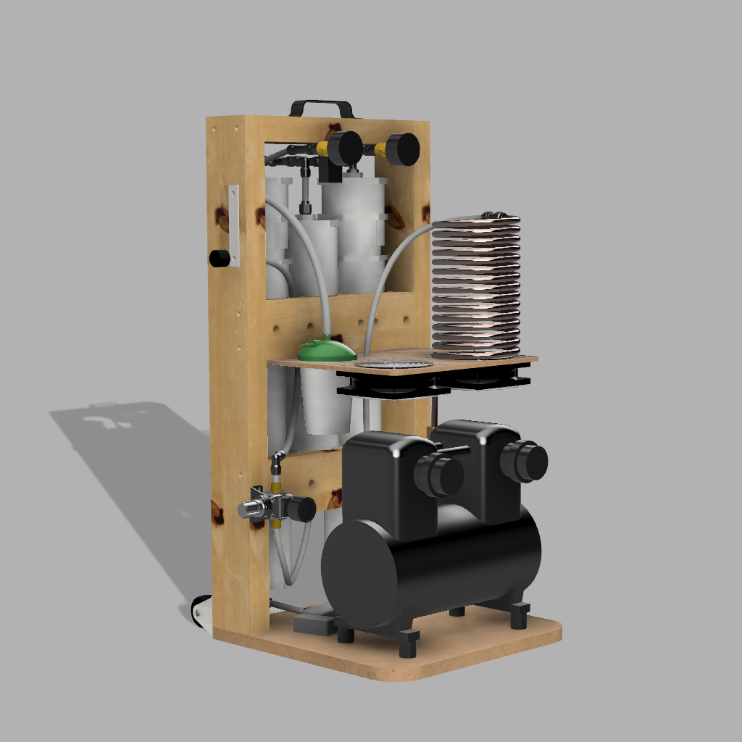
Renderings/OxyKit v17Isometric.png
