OxiKit/oxygen-concentrator-how-to-diy-open-source/Renderings/OxyKit v17SideL.png

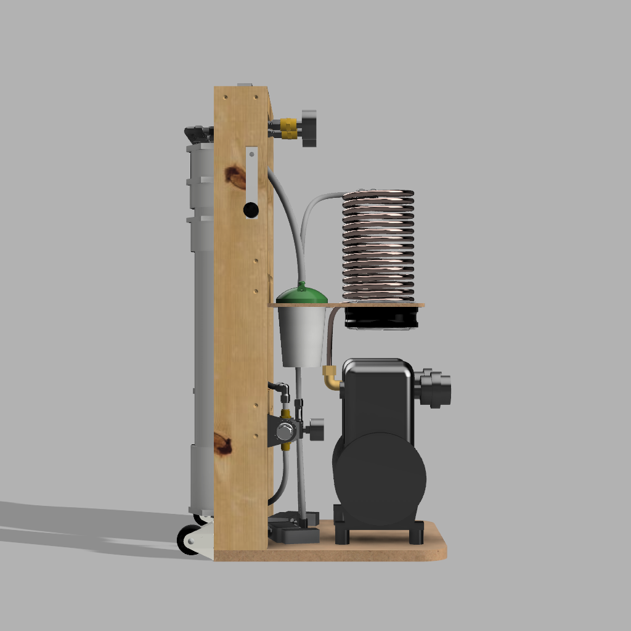
Renderings/OxyKit v17SideL.png
