OxiKit/oxygen-concentrator-how-to-diy-open-source/Renderings/OxyKit v17SideR.png

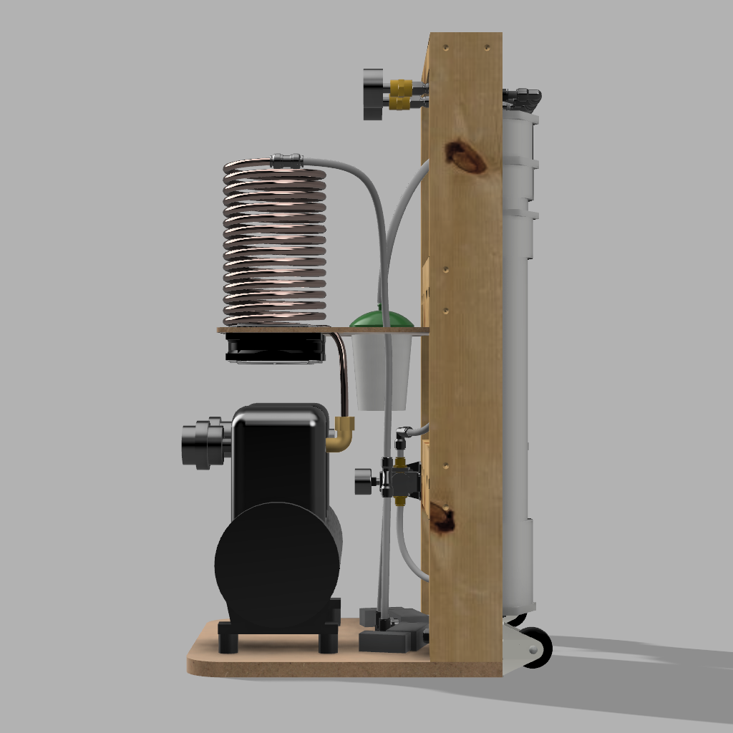
Renderings/OxyKit v17SideR.png
