OxiKit/oxygen-concentrator-how-to-diy-open-source/Renderings/OxyKit v17Top.png

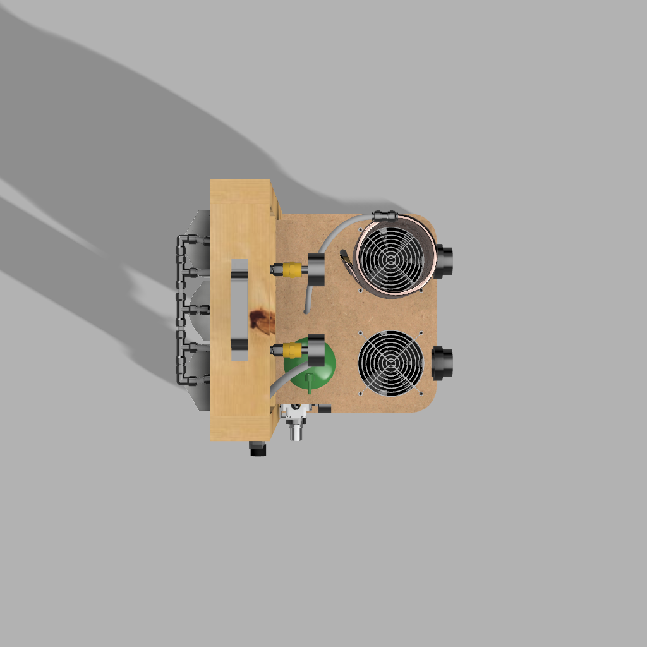
Renderings/OxyKit v17Top.png
