OxiKit/oxygen-concentrator-how-to-diy-open-source/Renderings/OxyKit v17Tubes.png

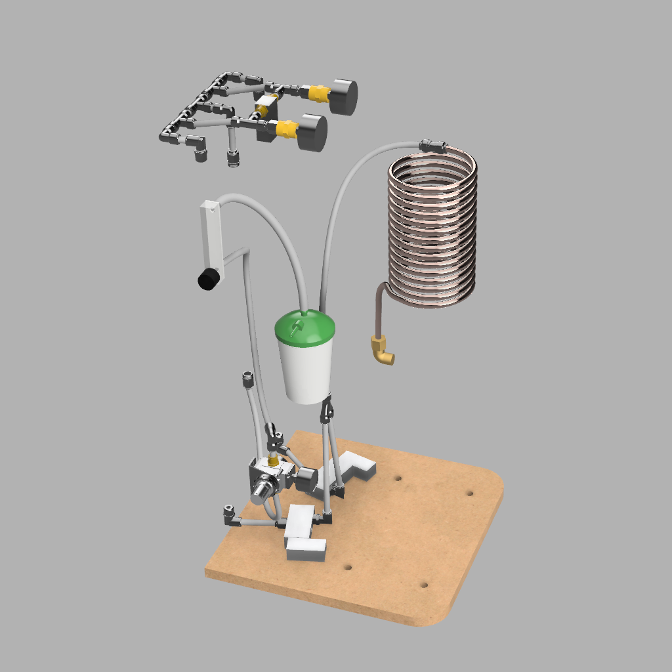
Renderings/OxyKit v17Tubes.png
