OxiKit/oxygen-concentrator-how-to-diy-open-source/Renderings/OxyKit v17TubesTop.png

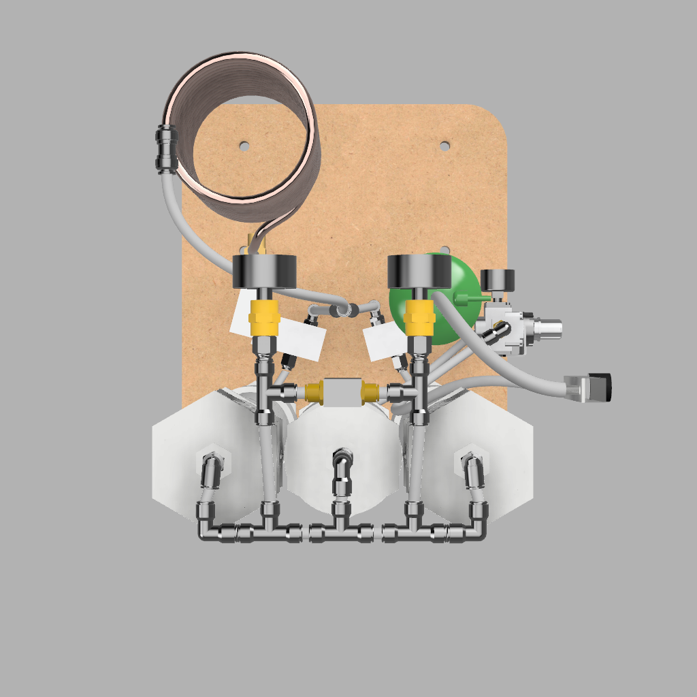
Renderings/OxyKit v17TubesTop.png
