OxiKit/oxygen-concentrator-how-to-diy-open-source/Shop Drawings/2x4 Frame Dimensions Hole Detail.jpg

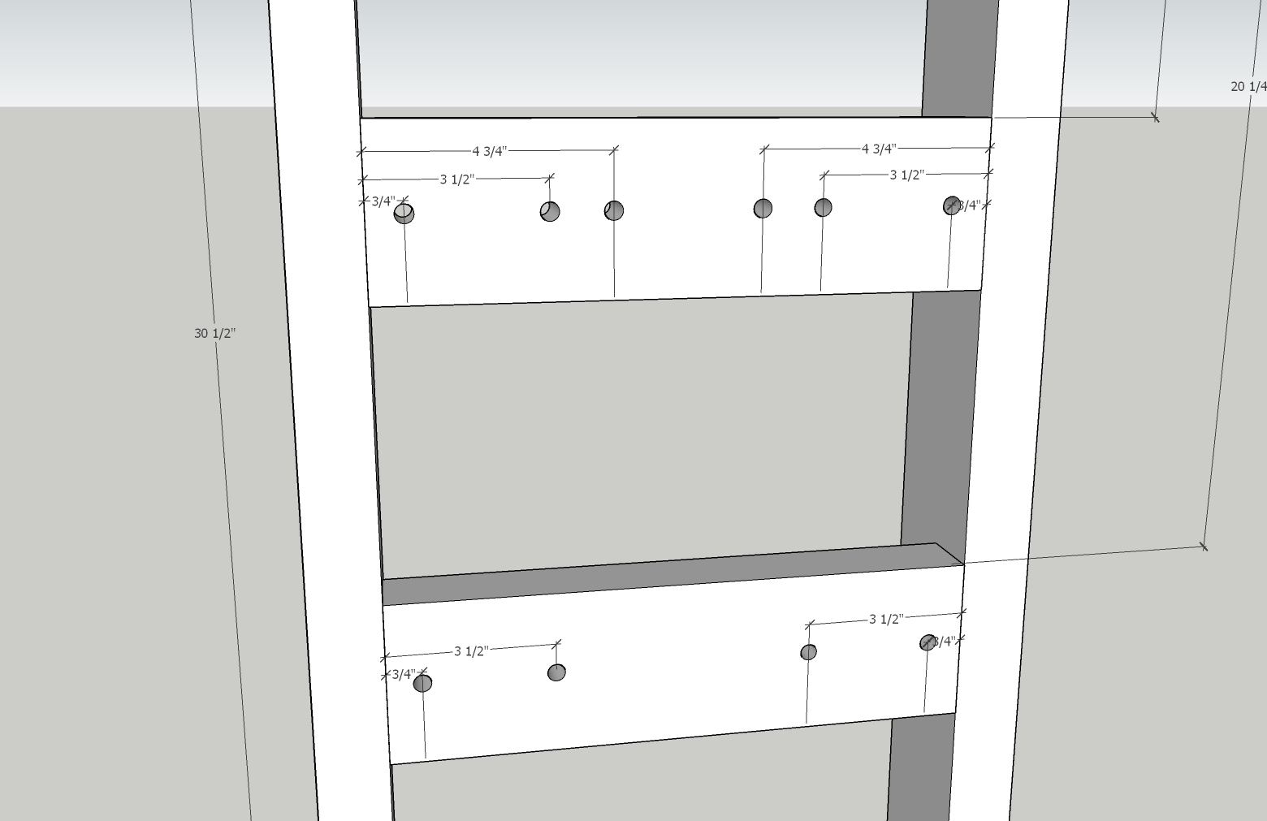
Shop Drawings/2x4 Frame Dimensions Hole Detail.jpg
