OxiKit/oxygen-concentrator-how-to-diy-open-source/Bundle_for_Oxikit_BOM.pdf

## ShieldMission Oxikit BOM

$350 OxiKit Bundle + $712.55 Other stores = $1,062.55

Description | Other Supplier Price | Qty Needed | In Oxikit Bundle | Other Supplier Total Price

VALVES & REGULATORS
3/8" NPT 3-Way Solenoid Valve, 12 V DC | | 2 | 2
Direct Acting Solenoid Valve 1/4" ports 12 V DC | | 1 | 1
High Pressure Regulator 3/8" NPT 150PSI | | 1 | 2
Low Pressure Regulator 3 to 30PSI | | 1 | 1
Pressure Gauge 1/4" NPT Back, 0-60psi (Back Mount)50mm Axial iron shell integrated pressure gaugechroming shell, brass back connection, dia. 50 mm.NPT1/4, accuracy 2.5%. | | 3 | 3
3-30LPM LZQ-7 Oxygen Air Gas Flowmeter (https://amzn.to/3bUIp8O) | $16.89 | 1 | Not in Bundle | $16.89

FITTINGS
3/8" Male NPT to 3/8"Push to Connect - Strait | | 5 | 5
3/8" Male NPT to 3/8"Push to Connect - 90 Elbow | | 6 | 14
3/8"Push to Connect to 3/8"Push to Connect to 3/8"Push to Connect - Tee | | 6 | 8
3/8"Push to Connect to 3/8"Push to Connect to 3/8"Push to Connect - Y | | 1 | 1
3/8"Push to Connect to 3/8"Push to Connect - 90 Elbow | | 3 | 3
1/4" Male NPT to 3/8" Push to Connect - 90 Elbow | | 2 | 5
1/4" Male NPT to 3/8" Push to Connect - Strait | | 4 | 5
Brass/Stainless 3/8-Inch tube PTC x 1/4-Inch Male NPT - Coupler | | 2 | 5
Brass 1/4 NPT Female to 1/4" NPT Female - Coupling (https://amzn.to/3loncY8) | $5.82 | 3 | Not in Bundle | $17.46
Brass 1/2-in NPT Male to 1/4" NPT Female - Adapter Bushing (https://amzn.to/3eQtdvj) | $3.99 | 2 | Not in Bundle | $7.98
Brass 1/4" NPT male plug hex or square head (https://amzn.to/30UUhRW) | $7.99 | 1 | Not in Bundle | $7.99
Air pressure safety relief valve 1/4" NPT male set to open at 50 psi (https://amzn.to/2OJPJvh) | $8.50 | 1 | Not in Bundle | $8.50

TUBING
High Density Polyethylene (HDPE) Tubing, 1/4" ID, 3/8" per roll OD (10 Feet Per Machine Required- White) (https://www.usplastic.com/catalog/item.aspx?itemid=27907) | $21.52 | 1 | Not in Bundle | $21.52
Clear Vinyl tube, 1/4" ID, 3/8" per roll OD (2 Feet Per Machine Required - Clear) (https://amzn.to/3rXKTcl) | $16.99 | 1 | Not in Bundle | $16.99
1.5 orifices | | 3 | 3

BRAIN COMPONENTS
Arduino Uno Board With Mounting Plate | $21.90 | 1 | Not in Bundle | $21.90
Arduino Uno Board Relay Shield 4 relays (https://amzn.to/3s3fGEw) | $9.99 | 1 | Not in Bundle | $9.99
12V 40 watt power supply | | 1 | 1 | $0.00
20 awg Electronics Wire (https://amzn.to/2OAzktb) | $14.99 | 1 | 1 | $14.99

HEAT/HUMIDITY MANAGEMENT COMPONENTS
3/8" OD Copper Tubing (Need around 20') (https://amzn.to/3bTsp78) | $22.67 | 1 | Not in Bundle | $22.67
12V DC 120mm High Speed Cooling Fan | | 5 | 5
Humidifier Water Bottle | | 1 | 1

COMPRESSOR
California Air Tools SP-9421 2.0HP Ultra Quiet and Oil-Free Air Compressor Motor (https://amzn.to/3lpNTf7) | $364.64 | 1 | Not in Bundle | $364.64

MISCELLANEOUS
Cable Ties 40 pack | | 1 | 40
2" Wheels (https://amzn.to/2NzjFd6) | $17.99 | 1 | Not in Bundle | $17.99
2x4x10 Wood (https://www.homedepot.com/p/2-in-x-4-in-x-96-in-Prime-Whitewood-Stud-058449/312528776) | $6.95 | 1 | Not in Bundle | $6.95
3/4" MDF 15.5" x 15.5" (Can also use Plywood) (https://www.homedepot.com/b/Lumber-Composites-Plywood-MDF/3-4/MDF/N-5yc1vZbtn1Z1z11dmmZ1z1a5bj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) | $36.00 | 1 | Not in Bundle | $36.00
1/4" MDF 6" x 4.5" (Can also use Plywood) (https://www.homedepot.com/p/Medium-Density-Fiberboard-Common-1-4-in-x-2-ft-x-4-ft-Actual-0-216-in-x-23-75-in-x-47-75-in-1508104/202089069) | $8.53 | 1 | Not in Bundle | $8.53
in-line HIPAA Sanitary Air Filter | | 1 | 1
Heat Shrink or Electrical Tape | | | Not in Bundle
Solder or Twist Connectors | | | Not in Bundle

SIEVE PVC PARTS
3" Schedule 40 PVC Female Adapter - Socket to FIPT (https://www.pvcfittingsonline.com/435-030-3-schedule-40-pvc-female-adapter.html) | $2.76 | 2 | Not in Bundle | $5.52
3" Schedule 40 PVC Male Adapter - MIPT to Socket (https://www.pvcfittingsonline.com/436-030-3-schedule-40-pvc-male-adapter.html) | $3.42 | 2 | Not in Bundle | $6.84
3" x 3/4" Sch 40 PVC Reducer Bushing Flush Style - Spigot to FIPT (https://www.pvcfittingsonline.com/3-x-3-4-sch-40-pvc-reducer-bushing-flush-style-spig-x-fipt-438-334.html) | $2.36 | 6 | Not in Bundle | $14.16
3/4" x 3/8" Sch 40 PVC Reducer (T.T.) Bushing - MIPT to FIPT (https://www.pvcfittingsonline.com/3-x-3-4-sch-40-pvc-reducer-bushing-flush-style-spig-x-fipt-438-334.html) | $2.36 | 6 | Not in Bundle | $14.16
3" Sch 40 PVC Coupling - Socket to Socket (https://www.pvcfittingsonline.com/429-030-3-schedule-40-pvc-coupling.html) | $2.56 | 6 | Not in Bundle | $15.36
2" x 3/4" Schedule 40 PVC Reducer Bushing - Spigot to FIPT (https://www.pvcfittingsonline.com/438-248-2-x-3-4-schedule-40-pvc-reducer-bushing-flush-style.html) | $1.36 | 2 | Not in Bundle | $2.72
PVC 3 in. Round Snap-In Floor Drain (https://www.homedepot.com/p/Oatey-PVC-3-in-Round-Snap-In-Floor-Drain-435652/100181694) | $2.72 | 4 | Not in Bundle | $10.88

SIEVE INTERNAL PARTS
2" Diameter x 3" Tall - Compression Springs - 50 lb per inch tension | | 2 | 2
304 Stainless Steel Woven 100 Mesh 0.18mm Hole Disk 75mm | | 2 | 2
304 Stainless Steel Woven 100 Mesh 0.18mm Hole Disk 71mm | | 2 | 2
Non-woven Filter Material - Vent Register Filter 4" X 12" (https://amzn.to/2NrXjKj) | $14.99 | 1 | Not in Bundle | $14.99
Gorilla PVC Cement 8 oz. R1584C Medium Body PrimaGlue, One-Step (https://amzn.to/2Nzlc2Q) | $18.11 | 1 | Not in Bundle | $18.11
Rectorseal 25551 8-Ounce No. 5 Pipe Thread Sealant (https://amzn.to/3txRlXL) | $8.82 | 1 | Not in Bundle | $8.82
