OxiKit/oxygen-concentrator-how-to-diy-open-source/Oxikit BOM and Sieve Assembly.pdf

## ShieldMission Oxikit BOM

$350 OxiKit Bundle + $712.55 Other stores = $1,062.55

Description | Other Supplier Price | Qty Needed | In Oxikit Bundle | Other Supplier Total Price

VALVES & REGULATORS
3/8" NPT 3-Way Solenoid Valve, 12 V DC | | 2 | 2
Direct Acting Solenoid Valve 1/4" ports 12 V DC | | 1 | 1
High Pressure Regulator 3/8" NPT 150PSI | | 1 | 2
Low Pressure Regulator 3 to 30PSI | | 1 | 1
Pressure Gauge 1/4" NPT Back, 0-60psi (Back Mount)50mm Axial iron shell integrated pressure gaugechroming shell, brass back connection, dia. 50 mm.NPT1/4, accuracy 2.5%. | | 3 | 3
3-30LPM LZQ-7 Oxygen Air Gas Flowmeter (https://amzn.to/3bUIp8O) | $16.89 | 1 | Not in Bundle | $16.89

FITTINGS
3/8" Male NPT to 3/8"Push to Connect - Strait | | 5 | 5
3/8" Male NPT to 3/8"Push to Connect - 90 Elbow | | 6 | 14
3/8"Push to Connect to 3/8"Push to Connect to 3/8"Push to Connect - Tee | | 6 | 8
3/8"Push to Connect to 3/8"Push to Connect to 3/8"Push to Connect - Y | | 1 | 1
3/8"Push to Connect to 3/8"Push to Connect - 90 Elbow | | 3 | 3
1/4" Male NPT to 3/8" Push to Connect - 90 Elbow | | 2 | 5
1/4" Male NPT to 3/8" Push to Connect - Strait | | 4 | 5
Brass/Stainless 3/8-Inch tube PTC x 1/4-Inch Male NPT - Coupler | | 2 | 5
Brass 1/4 NPT Female to 1/4" NPT Female - Coupling (https://amzn.to/3loncY8) | $5.82 | 3 | Not in Bundle | $17.46
Brass 1/2-in NPT Male to 1/4" NPT Female - Adapter Bushing (https://amzn.to/3eQtdvj) | $3.99 | 2 | Not in Bundle | $7.98
Brass 1/4" NPT male plug hex or square head (https://amzn.to/30UUhRW) | $7.99 | 1 | Not in Bundle | $7.99
Air pressure safety relief valve 1/4" NPT male set to open at 50 psi (https://amzn.to/2OJPJvh) | $8.50 | 1 | Not in Bundle | $8.50

TUBING
High Density Polyethylene (HDPE) Tubing, 1/4" ID, 3/8" per roll OD (10 Feet Per Machine Required- White) (https://www.usplastic.com/catalog/item.aspx?itemid=27907) | $21.52 | 1 | Not in Bundle | $21.52
Clear Vinyl tube, 1/4" ID, 3/8" per roll OD (2 Feet Per Machine Required - Clear) (https://amzn.to/3rXKTcl) | $16.99 | 1 | Not in Bundle | $16.99
1.5 orifices | | 3 | 3

BRAIN COMPONENTS
Arduino Uno Board With Mounting Plate | $21.90 | 1 | Not in Bundle | $21.90
Arduino Uno Board Relay Shield 4 relays (https://amzn.to/3s3fGEw) | $9.99 | 1 | Not in Bundle | $9.99
12V 40 watt power supply | | 1 | 1 | $0.00
20 awg Electronics Wire (https://amzn.to/2OAzktb) | $14.99 | 1 | 1 | $14.99

HEAT/HUMIDITY MANAGEMENT COMPONENTS
3/8" OD Copper Tubing (Need around 20') (https://amzn.to/3bTsp78) | $22.67 | 1 | Not in Bundle | $22.67
12V DC 120mm High Speed Cooling Fan | | 5 | 5
Humidifier Water Bottle | | 1 | 1

COMPRESSOR
California Air Tools SP-9421 2.0HP Ultra Quiet and Oil-Free Air Compressor Motor (https://amzn.to/3lpNTf7) | $364.64 | 1 | Not in Bundle | $364.64

MISCELLANEOUS
Cable Ties 40 pack | | 1 | 40
2" Wheels (https://amzn.to/2NzjFd6) | $17.99 | 1 | Not in Bundle | $17.99
2x4x10 Wood (https://www.homedepot.com/p/2-in-x-4-in-x-96-in-Prime-Whitewood-Stud-058449/312528776) | $6.95 | 1 | Not in Bundle | $6.95
3/4" MDF 15.5" x 15.5" (Can also use Plywood) (https://www.homedepot.com/b/Lumber-Composites-Plywood-MDF/3-4/MDF/N-5yc1vZbtn1Z1z11dmmZ1z1a5bj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) | $36.00 | 1 | Not in Bundle | $36.00
1/4" MDF 6" x 4.5" (Can also use Plywood) (https://www.homedepot.com/p/Medium-Density-Fiberboard-Common-1-4-in-x-2-ft-x-4-ft-Actual-0-216-in-x-23-75-in-x-47-75-in-1508104/202089069) | $8.53 | 1 | Not in Bundle | $8.53
in-line HIPAA Sanitary Air Filter | | 1 | 1
Heat Shrink or Electrical Tape | | | Not in Bundle
Solder or Twist Connectors | | | Not in Bundle

SIEVE PVC PARTS
3" Schedule 40 PVC Female Adapter - Socket to FIPT (https://www.pvcfittingsonline.com/435-030-3-schedule-40-pvc-female-adapter.html) | $2.76 | 2 | Not in Bundle | $5.52
3" Schedule 40 PVC Male Adapter - MIPT to Socket (https://www.pvcfittingsonline.com/436-030-3-schedule-40-pvc-male-adapter.html) | $3.42 | 2 | Not in Bundle | $6.84
3" x 3/4" Sch 40 PVC Reducer Bushing Flush Style - Spigot to FIPT (https://www.pvcfittingsonline.com/3-x-3-4-sch-40-pvc-reducer-bushing-flush-style-spig-x-fipt-438-334.html) | $2.36 | 6 | Not in Bundle | $14.16
3/4" x 3/8" Sch 40 PVC Reducer (T.T.) Bushing - MIPT to FIPT (https://www.pvcfittingsonline.com/3-x-3-4-sch-40-pvc-reducer-bushing-flush-style-spig-x-fipt-438-334.html) | $2.36 | 6 | Not in Bundle | $14.16
3" Sch 40 PVC Coupling - Socket to Socket (https://www.pvcfittingsonline.com/429-030-3-schedule-40-pvc-coupling.html) | $2.56 | 6 | Not in Bundle | $15.36
2" x 3/4" Schedule 40 PVC Reducer Bushing - Spigot to FIPT (https://www.pvcfittingsonline.com/438-248-2-x-3-4-schedule-40-pvc-reducer-bushing-flush-style.html) | $1.36 | 2 | Not in Bundle | $2.72
PVC 3 in. Round Snap-In Floor Drain (https://www.homedepot.com/p/Oatey-PVC-3-in-Round-Snap-In-Floor-Drain-435652/100181694) | $2.72 | 4 | Not in Bundle | $10.88

SIEVE INTERNAL PARTS
2" Diameter x 3" Tall - Compression Springs - 50 lb per inch tension | | 2 | 2
304 Stainless Steel Woven 100 Mesh 0.18mm Hole Disk 75mm | | 2 | 2
304 Stainless Steel Woven 100 Mesh 0.18mm Hole Disk 71mm | | 2 | 2
Non-woven Filter Material - Vent Register Filter 4" X 12" (https://amzn.to/2NrXjKj) | $14.99 | 1 | Not in Bundle | $14.99
Gorilla PVC Cement 8 oz. R1584C Medium Body PrimaGlue, One-Step (https://amzn.to/2Nzlc2Q) | $18.11 | 1 | Not in Bundle | $18.11
Rectorseal 25551 8-Ounce No. 5 Pipe Thread Sealant (https://amzn.to/3txRlXL) | $8.82 | 1 | Not in Bundle | $8.82

# Oxygen Concentrator Sieve Assembly - with Labels

# (Important: PVC parts should be schedule 40, not DWV)

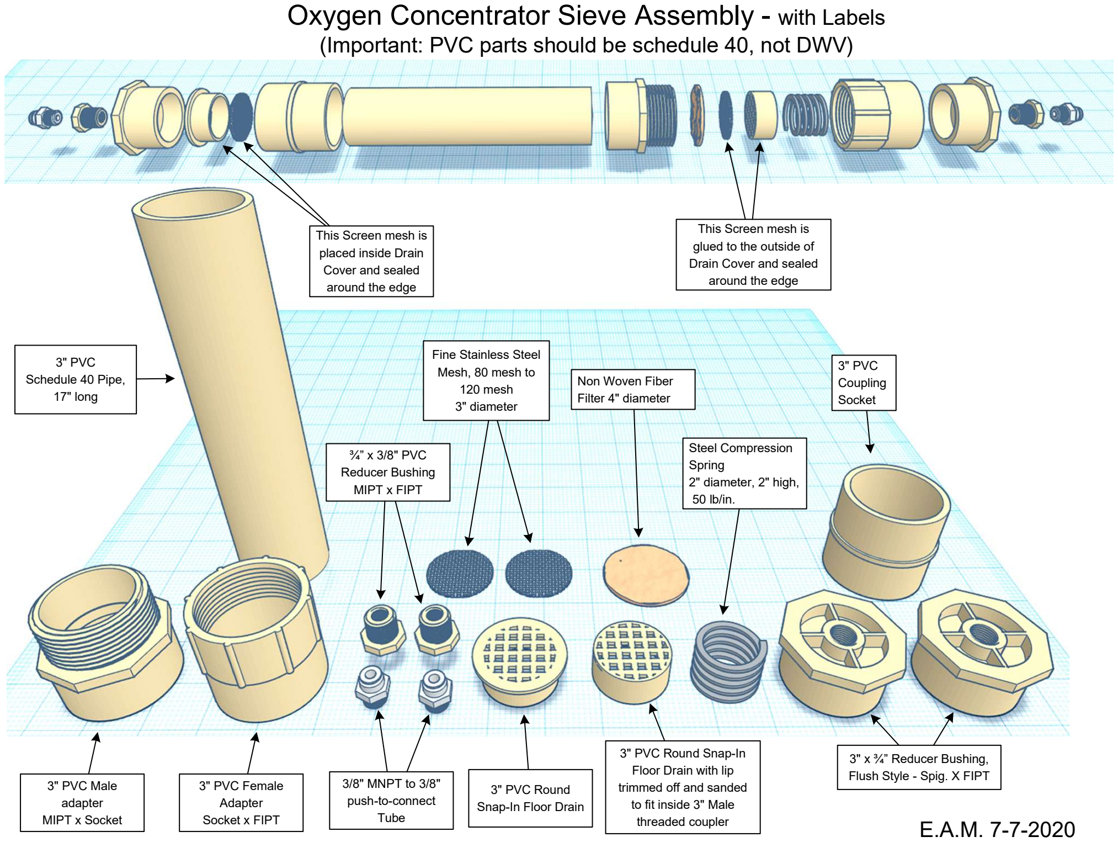
[picture p121: page 2]

# E.A.M. 7-7-2020

### Fine Stainless Steel Mesh, 80 mesh to 120 mesh 3" diameter

### Non Woven Fiber Filter 4" diameter

### Steel Compression Spring

2" diameter, 2" high,
50 lb/in.

### 3" PVC Coupling Socket

### 3" PVC

Schedule 40 Pipe,

### 17" long

### 3" PVC Male adapter MIPT x Socket

### 3" PVC Female Adapter Socket x FIPT

### 3/8" MNPT to 3/8" push-to-connect Tube

### 3" PVC Round Snap-In Floor Drain

### 3" PVC Round Snap-In Floor Drain with lip trimmed off and sanded to fit inside 3" Male threaded coupler

3" x ¾” Reducer Bushing,

### Flush Style - Spig. X FIPT

### This Screen mesh is placed inside Drain Cover and sealed around the edge

### This Screen mesh is glued to the outside of Drain Cover and sealed around the edge

### ¾” x 3/8" PVC Reducer Bushing MIPT x FIPT

FLOW CHART | PROCESS | MATERIAL | MISCELLANEOUS TOOLS/MATERIALS
| Start | - | -

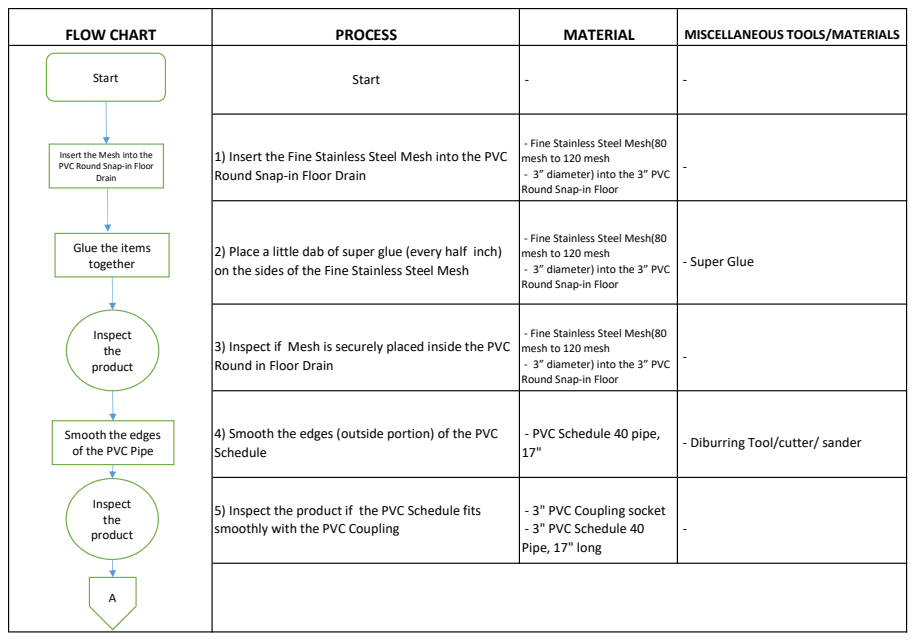
[picture p122: page 3]
Start; Drain; Inspect the product

1) Insert the Fine Stainless Steel Mesh into the PVC Round Snap-in Floor Drain | - Fine Stainless Steel Mesh(80 mesh to 120 mesh - 3” diameter) into the 3” PVC Round Snap-in Floor | -

Insert the Mesh into the
PVC Round Snap-in Floor

2) Place a little dab of super glue (every half inch) on the sides of the Fine Stainless Steel Mesh | - Fine Stainless Steel Mesh(80 mesh to 120 mesh - 3” diameter) into the 3” PVC Round Snap-in Floor | - Super Glue

Glue the items
together

3) Inspect if Mesh is securely placed inside the PVC Round in Floor Drain | - Fine Stainless Steel Mesh(80 mesh to 120 mesh - 3” diameter) into the 3” PVC Round Snap-in Floor | -

Smooth the edges
of the PVC Pipe

4) Smooth the edges (outside portion) of the PVC Schedule | 17" | - Diburring Tool/cutter/ sander - PVC Schedule 40 pipe,

5) Inspect the product if the PVC Schedule fits smoothly with the PVC Coupling | - 3" PVC Coupling socket - 3" PVC Schedule 40 Pipe, 17" long | -

FLOW CHART | PROCESS | MATERIAL | MISCELLANEOUS TOOLS/MATERIALS
6) Put glue on the PVC Coupling socket and the PVC Schedule. Put a large amount of glue on the outside of the Male end around 2" (PVC Schedule) and less on the inside of the female end (PVC Coupling Socket). | - 3" PVC Coupling socket into the - 3" PVC Schedule 40 Pipe, 17" long | - Super Glue

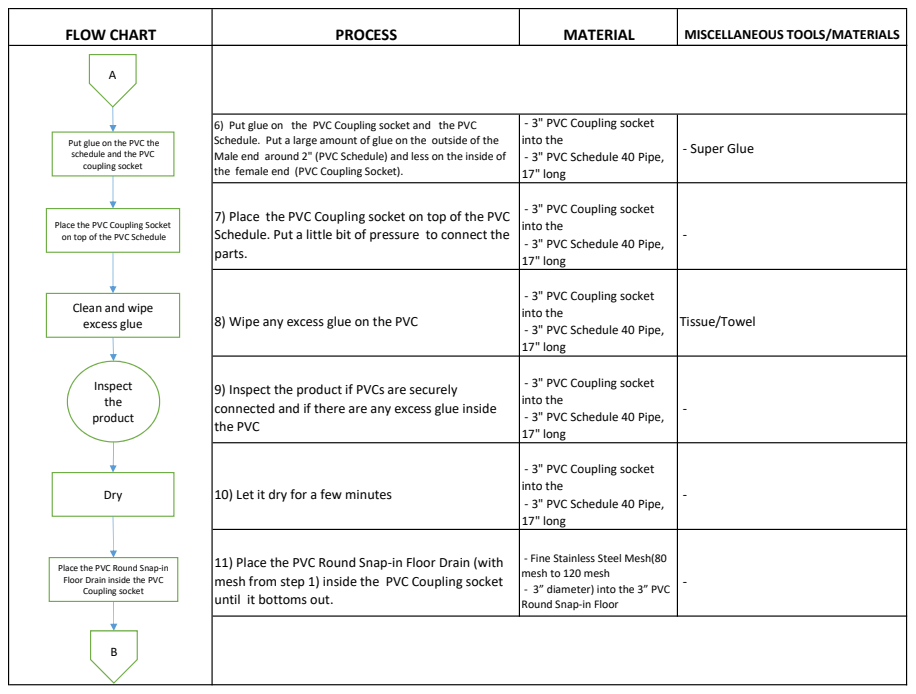
[picture p123: page 4]
Inspect the product; Dry

Put glue on the PVC the
schedule and the PVC
coupling socket

7) Place the PVC Coupling socket on top of the PVC Schedule. Put a little bit of pressure to connect the parts. | - 3" PVC Coupling socket into the - 3" PVC Schedule 40 Pipe, 17" long | -

Place the PVC Coupling Socket
on top of the PVC Schedule

8) Wipe any excess glue on the PVC | - 3" PVC Coupling socket into the - 3" PVC Schedule 40 Pipe, 17" long | Tissue/Towel

Clean and wipe
excess glue

9) Inspect the product if PVCs are securely connected and if there are any excess glue inside the PVC | - 3" PVC Coupling socket into the - 3" PVC Schedule 40 Pipe, 17" long | -

10) Let it dry for a few minutes | - 3" PVC Coupling socket into the - 3" PVC Schedule 40 Pipe, 17" long | -

11) Place the PVC Round Snap-in Floor Drain (with mesh from step 1) inside the PVC Coupling socket until it bottoms out. | - Fine Stainless Steel Mesh(80 mesh to 120 mesh - 3” diameter) into the 3” PVC Round Snap-in Floor | -

Place the PVC Round Snap-in
Floor Drain inside the PVC
Coupling socket

FLOW CHART | PROCESS | MATERIAL | MISCELLANEOUS TOOLS/MATERIALS
12) Put glue on the Reducer Busing, and the PVC Coupling socket (with the PVC round Snap in Floor - mesh inside). Put a large amount of glue on the outside portion of the Male end (Reducer Bushing) and less on the inside of the female end (PVC Coupling Socket). | - 3"x3/4" PVC ReducerBusing, Flush Style-Spig. X FIPT - 3" PVC Coupling socket | - Super Glue

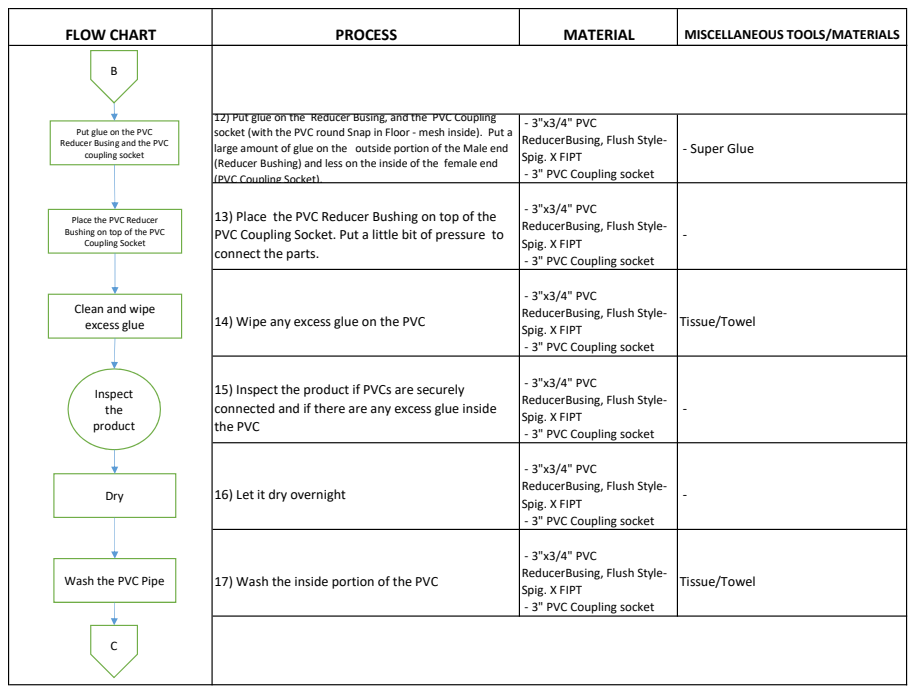
[picture p124: page 5]
Inspect the product; Dry

Put glue on the PVC
Reducer Busing and the PVC
coupling socket

13) Place the PVC Reducer Bushing on top of the PVC Coupling Socket. Put a little bit of pressure to connect the parts. | - 3"x3/4" PVC ReducerBusing, Flush Style-Spig. X FIPT - 3" PVC Coupling socket | -

Place the PVC Reducer
Bushing on top of the PVC
Coupling Socket

14) Wipe any excess glue on the PVC | - 3"x3/4" PVC ReducerBusing, Flush Style-Spig. X FIPT - 3" PVC Coupling socket | Tissue/Towel

Clean and wipe
excess glue

15) Inspect the product if PVCs are securely connected and if there are any excess glue inside the PVC | - 3"x3/4" PVC ReducerBusing, Flush Style-Spig. X FIPT - 3" PVC Coupling socket | -

16) Let it dry overnight | - 3"x3/4" PVC ReducerBusing, Flush Style-Spig. X FIPT - 3" PVC Coupling socket | -

17) Wash the inside portion of the PVC | - 3"x3/4" PVC ReducerBusing, Flush Style-Spig. X FIPT - 3" PVC Coupling socket | Tissue/Towel

Wash the PVC Pipe

FLOW CHART | PROCESS | MATERIAL | MISCELLANEOUS TOOLS/MATERIALS
18) Let it dry for a few minutes | - 3"x3/4" PVC ReducerBusing, Flush Style-Spig. X FIPT - 3" PVC Coupling socket | - Dry

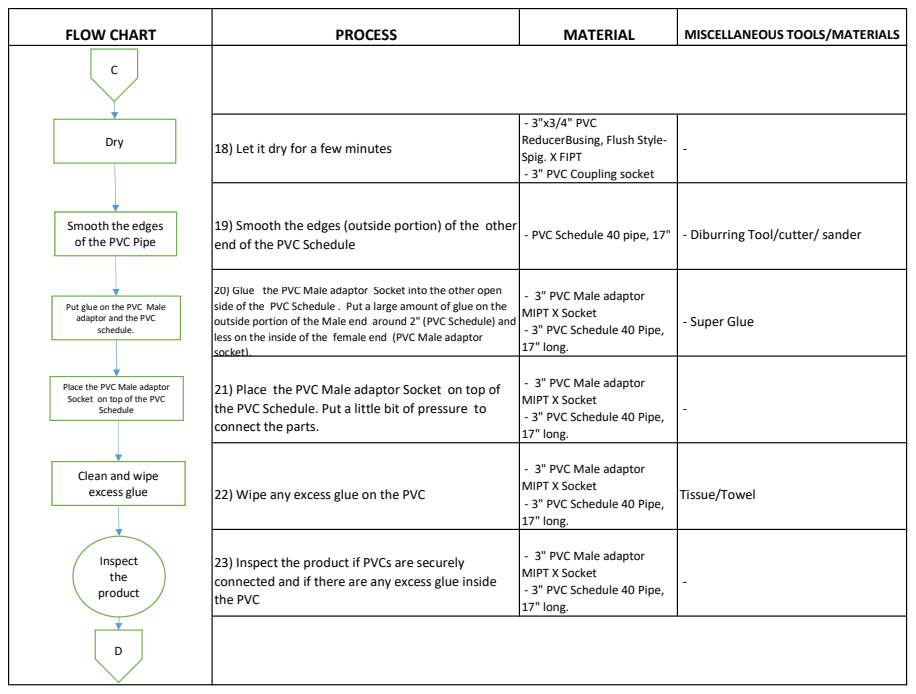
[picture p125: page 6]
Inspect the product

Smooth the edges
of the PVC Pipe

19) Smooth the edges (outside portion) of the other end of the PVC Schedule | - PVC Schedule 40 pipe, 17" | - Diburring Tool/cutter/ sander

20) Glue the PVC Male adaptor Socket into the other open side of the PVC Schedule . Put a large amount of glue on the outside portion of the Male end around 2" (PVC Schedule) and less on the inside of the female end (PVC Male adaptor socket). | - 3" PVC Male adaptor MIPT X Socket - 3" PVC Schedule 40 Pipe, 17" long. | - Super Glue

Put glue on the PVC Male
adaptor and the PVC
schedule.

Place the PVC Male adaptor
Socket on top of the PVC
Schedule

21) Place the PVC Male adaptor Socket on top of the PVC Schedule. Put a little bit of pressure to connect the parts. | - 3" PVC Male adaptor MIPT X Socket - 3" PVC Schedule 40 Pipe, 17" long. | -

22) Wipe any excess glue on the PVC | - 3" PVC Male adaptor MIPT X Socket - 3" PVC Schedule 40 Pipe, 17" long. | Tissue/Towel

Clean and wipe
excess glue

23) Inspect the product if PVCs are securely connected and if there are any excess glue inside the PVC | - 3" PVC Male adaptor MIPT X Socket - 3" PVC Schedule 40 Pipe, 17" long. | -

FLOW CHART | PROCESS | MATERIAL | MISCELLANEOUS TOOLS/MATERIALS
24) Let it dry overnight | - 3" PVC Male adaptor MIPT X Socket - 3" PVC Schedule 40 Pipe, 17" long. | -

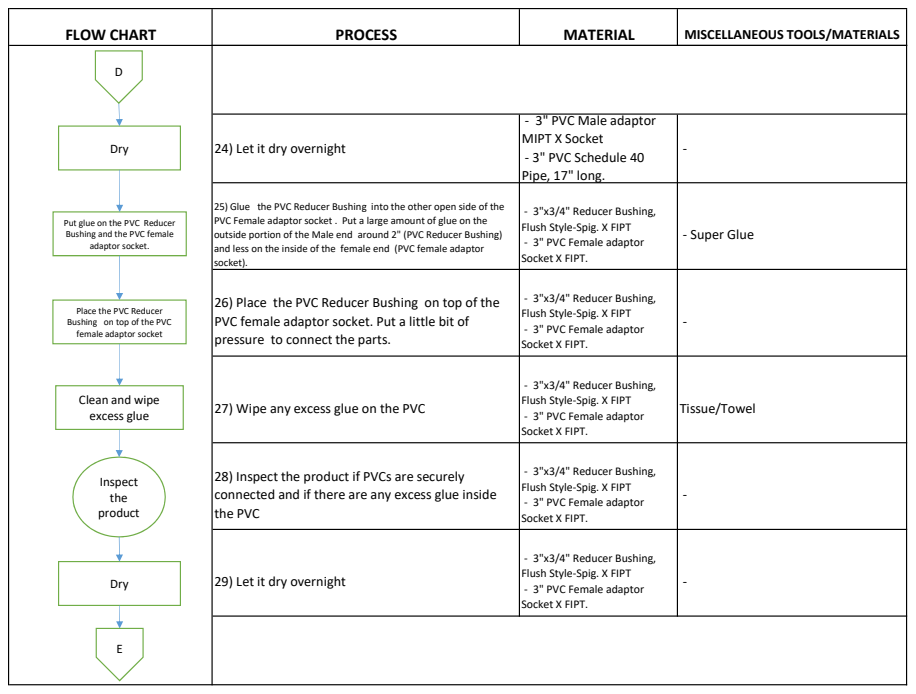
[picture p126: page 7]
Dry; Inspect the product

25) Glue the PVC Reducer Bushing into the other open side of the PVC Female adaptor socket . Put a large amount of glue on the outside portion of the Male end around 2" (PVC Reducer Bushing) and less on the inside of the female end (PVC female adaptor socket). | - 3"x3/4" Reducer Bushing, Flush Style-Spig. X FIPT - 3" PVC Female adaptor Socket X FIPT. | - Super Glue

Put glue on the PVC Reducer
Bushing and the PVC female
adaptor socket.

26) Place the PVC Reducer Bushing on top of the PVC female adaptor socket. Put a little bit of pressure to connect the parts. | - 3"x3/4" Reducer Bushing, Flush Style-Spig. X FIPT - 3" PVC Female adaptor Socket X FIPT. | -

Place the PVC Reducer
Bushing on top of the PVC
female adaptor socket

27) Wipe any excess glue on the PVC | - 3"x3/4" Reducer Bushing, Flush Style-Spig. X FIPT - 3" PVC Female adaptor Socket X FIPT. | Tissue/Towel

Clean and wipe
excess glue

28) Inspect the product if PVCs are securely connected and if there are any excess glue inside the PVC | - 3"x3/4" Reducer Bushing, Flush Style-Spig. X FIPT - 3" PVC Female adaptor Socket X FIPT. | -

29) Let it dry overnight | - 3"x3/4" Reducer Bushing, Flush Style-Spig. X FIPT - 3" PVC Female adaptor Socket X FIPT. | -

FLOW CHART | PROCESS | MATERIAL | MISCELLANEOUS TOOLS/MATERIALS
30) Place a considerable amount of Zeolite inside the PVC Pipe, approximately 26mm from the top of the PVC Male adaptor. Please see computation sheet for the computation of the height of the Zeolite. | - Zeolite - PVC Assembly from step 1 to 29 | -Funnel -Caliper
31)Ensure to vibrate the bottom side and a little on the top of the PVC assembly | - Zeolite - PVC Assembly | - air hammer with 50 PSI
32) Place the Non Woven Fiber Filter on top of the Zeolite | - Non Woven Fiber Filter 4" Diamter - Zeolite - PVC Assembly | -
33) Place the PVC round snap in floor Drain (with mesh outside) on top of the non woven Fiber Filter. | - 3" PVC round snap in floor Drain with Lip trimmed - Non Woven Fiber Filter 4" D - Zeolite - PVC Assembly | -
34) Push the PVC round snap in floor Drain to compress the Zeolite | - 3" PVC round snap in floor Drain with Lip trimmed - Non Woven Fiber Filter 4" D - Zeolite - PVC Assembly | -
35) Place the spring on top of the PVC round snap in floor Drain | - 3" PVC round snap in floor Drain with Lip trimmed and sanded with mesh - Spring | -

## Place Zeolite inside the PVC assembly

## Vibrate the Zeolite

## Place the Fiber Filter on top of the Zeolite

### Place PVC round snap in floor Drain on top of the Fiber Filter

## Push the PVC to compress the Zeolite

### Place the spring on top of the PVC round snap

E

F

FLOW CHART | PROCESS | MATERIAL | MISCELLANEOUS TOOLS/MATERIALS
| - 14 1/2 mm PVC Round Snap

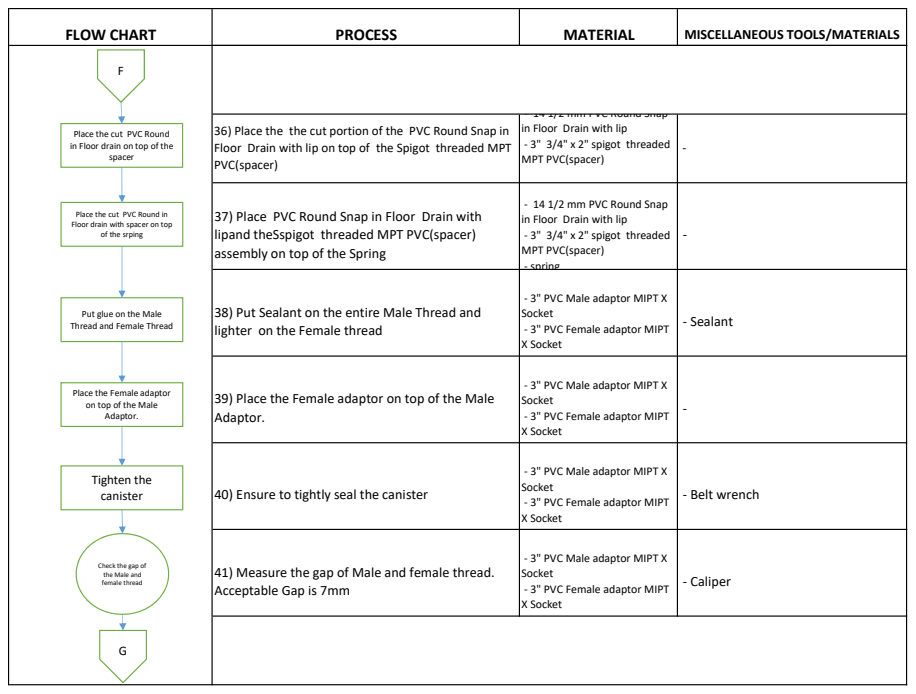
[picture p127: page 9]
Tighten the

36) Place the the cut portion of the PVC Round Snap in Floor Drain with lip on top of the Spigot threaded MPT PVC(spacer) | in Floor Drain with lip - 3" 3/4" x 2" spigot threaded MPT PVC(spacer) | -

Place the cut PVC Round
in Floor drain on top of the spacer Place the cut PVC Round in Floor drain with spacer on top

37) Place PVC Round Snap in Floor Drain with lipand theSspigot threaded MPT PVC(spacer) assembly on top of the Spring | - 14 1/2 mm PVC Round Snap in Floor Drain with lip - 3" 3/4" x 2" spigot threaded MPT PVC(spacer) - spring | -

of the srping

38) Put Sealant on the entire Male Thread and lighter on the Female thread | - 3" PVC Male adaptor MIPT X Socket - 3" PVC Female adaptor MIPT X Socket | - Sealant

Put glue on the Male
Thread and Female Thread

39) Place the Female adaptor on top of the Male Adaptor. | - 3" PVC Male adaptor MIPT X Socket - 3" PVC Female adaptor MIPT X Socket | -

Place the Female adaptor
on top of the Male
Adaptor.
canister Check the gap of the Male and female thread

40) Ensure to tightly seal the canister | - 3" PVC Male adaptor MIPT X Socket - 3" PVC Female adaptor MIPT X Socket | - Belt wrench

41) Measure the gap of Male and female thread. Acceptable Gap is 7mm | - 3" PVC Male adaptor MIPT X Socket - 3" PVC Female adaptor MIPT X Socket | - Caliper

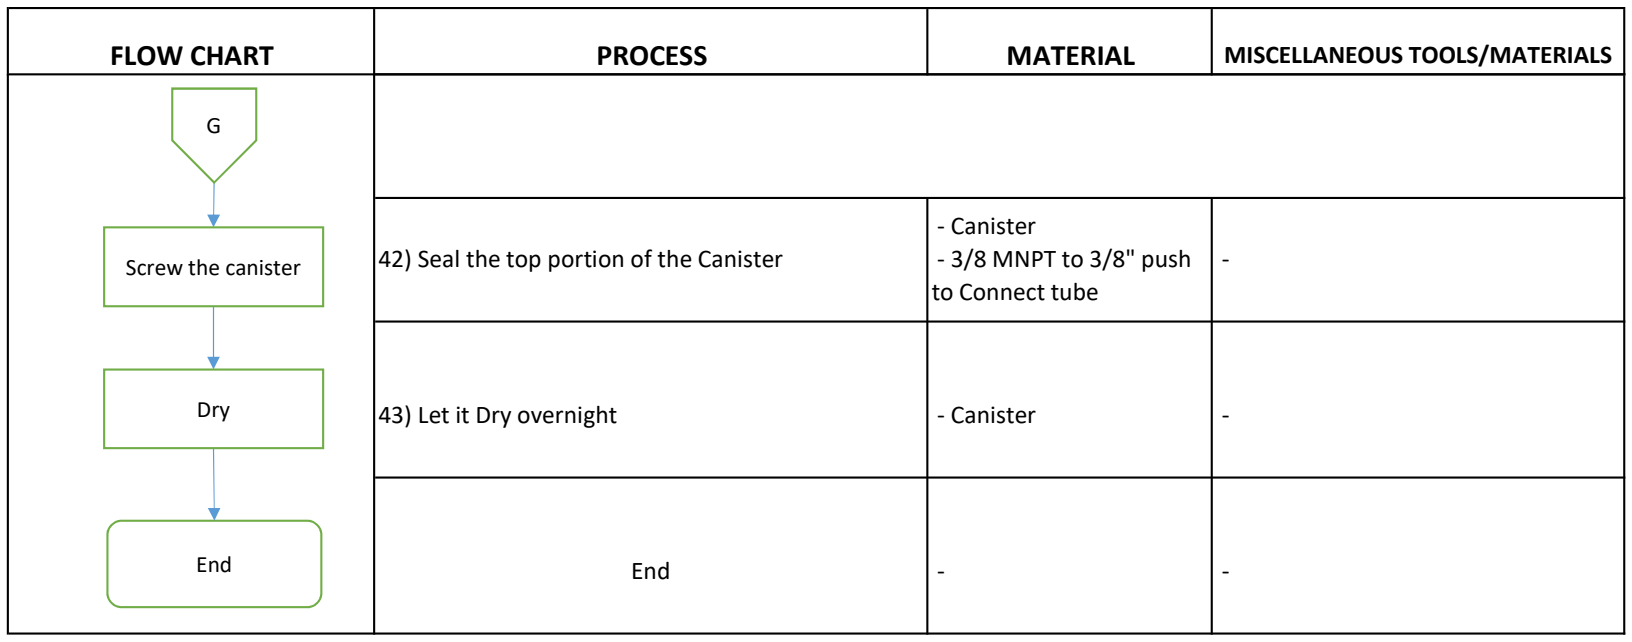
[picture p128: figure]
End; 43) Let it Dry overnight; - Canister; Screw the canister; Dry

FLOW CHART | PROCESS | MATERIAL | MISCELLANEOUS TOOLS/MATERIALS
42) Seal the top portion of the Canister | - Canister - 3/8 MNPT to 3/8" push to Connect tube | -
