OxiKit/oxygen-concentrator-how-to-diy-open-source/(list of files, cad)

Other CAD files:
Shop Drawings/2x4 Frame Sketchup File.skp
