OxiKit/oxygen-concentrator-how-to-diy-open-source/Brain Wiring WorkFlow.pdf

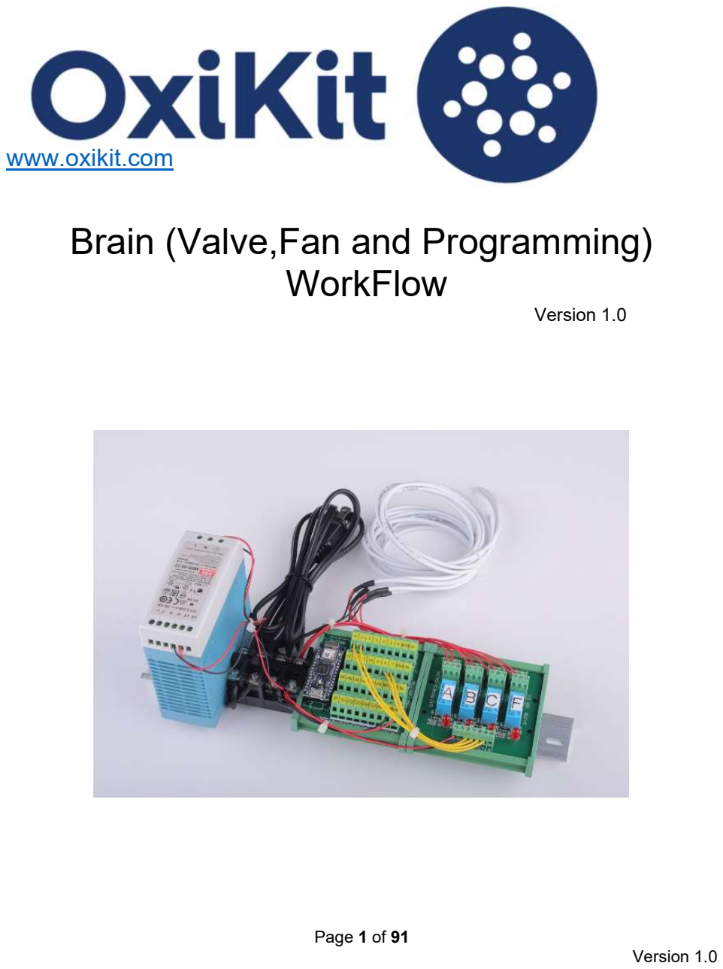
[picture p129: page 1]

### Page 1 of 91 Version 1.0

# www.oxikit.com

# Brain (Valve,Fan and Programming) WorkFlow

### Version 1.0

## OXIKIT-BR001

### OXIKIT WORKFLOW

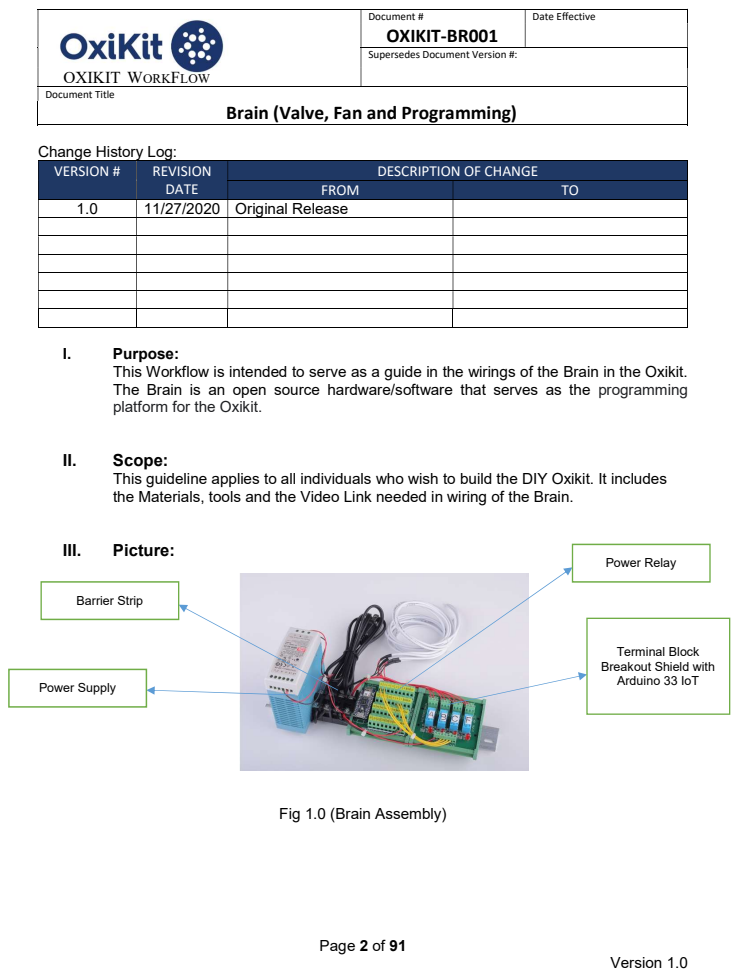
[picture p130: page 2]
Page 2 of 91; Document #; Date Effective; Document Title; Scope:; III.; Picture:; Power Relay; Barrier Strip; Power Supply

Supersedes Document Version #:

Brain (Valve, Fan and Programming)

Change History Log:

VERSION # | REVISION DATE | DESCRIPTION OF CHANGE

FROM | TO

1.0 | 11/27/2020 | Original Release

I. Purpose:
This Workflow is intended to serve as a guide in the wirings of the Brain in the Oxikit.
The Brain is an open source hardware/software that serves as the programming
platform for the Oxikit.

This guideline applies to all individuals who wish to build the DIY Oxikit. It includes
the Materials, tools and the Video Link needed in wiring of the Brain.

Terminal Block
Breakout Shield with
Arduino 33 IoT

Fig 1.0 (Brain Assembly)

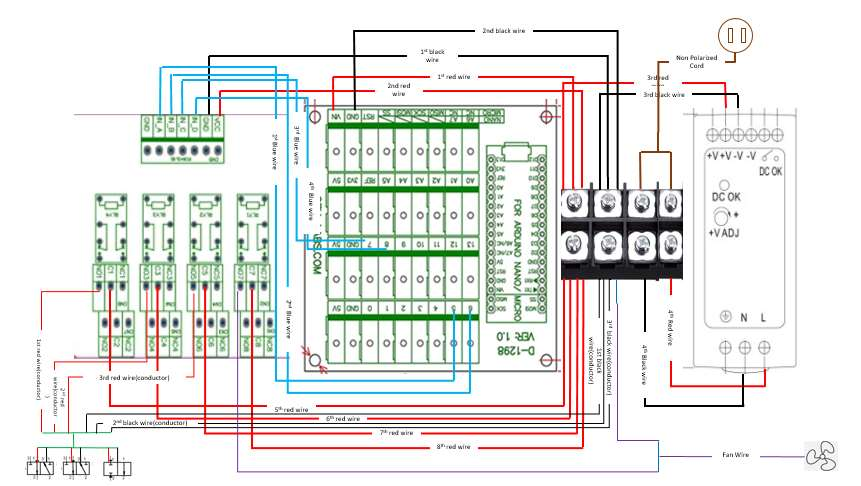
[picture p131: figure]

### Page 3 of 91

Document # | Date Effective

## OXIKIT-BR001

Supersedes Document Version #:

### OXIKIT WORKFLOW

Document Title

## Brain (Valve, Fan and Programming)

### Fig 2.0 Brain Wiring Diagram

### IV. Safety Operating Conditions: - Always wear protective gloves

### V. Workflows - Please see next page for the step by step guidelines in wiring the Brain

| Assembly.

Steps | Process | Material | Tools

### Page 4 of 91

# Brain Assembly

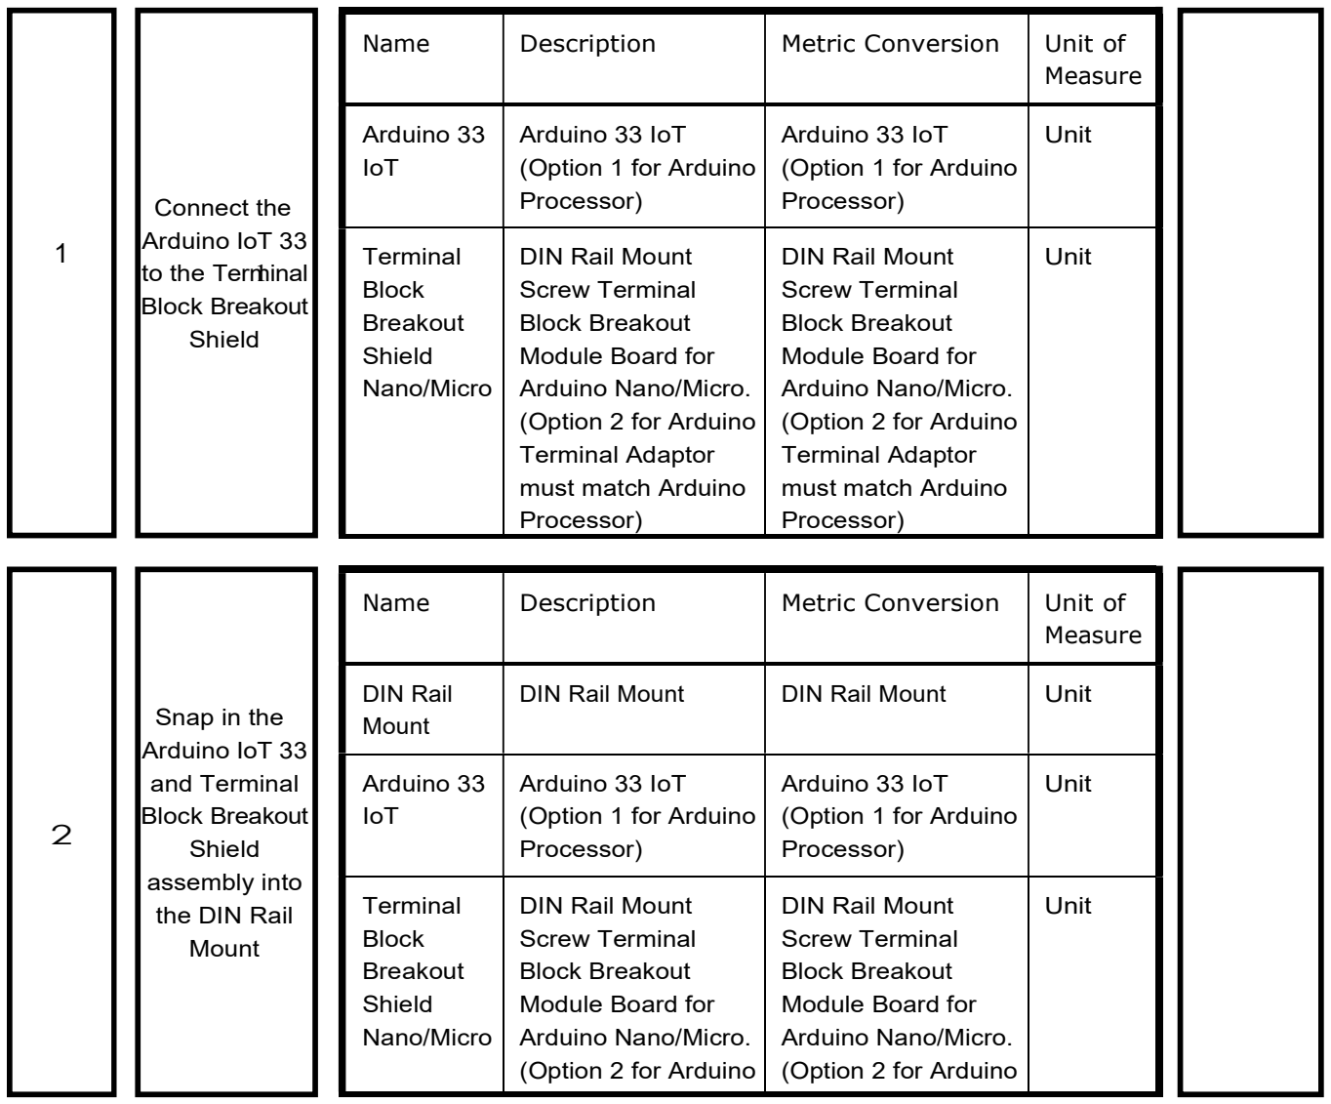
[picture p132: figure]
Connect the Arduino IoT 33 to the Terminal Block Breakout Shield; Name; Description; Metric Conversion; Unit of; Measure; Arduino 33 IoT; Arduino 33 IoT (Option 1 for Arduino Processor); Unit; Terminal Block Breakout Shield Nano/Micro; DIN Rail Mount Screw Terminal Block Breakout Module Board for Arduino Nano/Micro. (Option 2 for Arduino Terminal Adaptor must match Arduino Processor); Snap in the Arduino IoT 33 and Terminal Block Breakout Shield assembly into the DIN Rail Mount; DIN Rail Mount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

### Page 5 of 91

### Page 6 of 91

3

4

Snap in the
Power Relay
Interface
Board into the
DIN Rail Mount
Name | Description | Metric Conversion | Unit of Measure

DIN Rail Mount

Power Supply 12V | Power Supply 12V 3.33 Amp 40W - MDR-40-12 AC to DC DIN-Rail (Option 2 for Power supply) | Power Supply 12V 3.33 Amp 40W - MDR-40-12 AC to DC DIN-Rail (Option 2 for Power supply)
DIN Rail Mount | DIN Rail Mount | Unit

Unit

Snap in the
Barrier Strip
into the DIN
Rail Mount
Name | Description | Metric Conversion | Unit of Measure
Bracket Holder Carrier Clips/Barrier Strip | PCB DIN Rail Mounting Adapter Circuit Board Mounting Bracket Holder, Carrier Clips, for 35mm, 15mm DIN Rail (Green) | PCB DIN Rail Mounting Adapter Circuit Board Mounting Bracket Holder, Carrier Clips, for 35mm, 15mm DIN Rail (Green)

DIN Rail Mount

Unit

DIN Rail Mount | DIN Rail Mount | Unit

### Page 7 of 91

5

6

Snap in the
power supply
into the DIN
Rail Mount
Name | Description | Metric Conversion | Unit of Measure

DIN Rail Mount

Power Supply 12V | Power Supply 12V 3.33 Amp 40W - MDR-40-12 AC to DC DIN-Rail (Option 2 for Power supply) | Power Supply 12V 3.33 Amp 40W - MDR-40-12 AC to DC DIN-Rail (Option 2 for Power supply)
DIN Rail Mount | DIN Rail Mount | Unit

Unit

Screwdriver

Unscrew the
output
terminals of
the Terminal
Block Breakout
Shield, and the
screws in the
Power Relay
Interface
Board
Name | Description | Metric Conversion | Unit of Measure
Power Relay Interface 12V | DIN Rail Mount 4 DPDT Signal Relay Interface Module, DC 12V (Option 2 for Power Relay, must match with Power supply volts) | DIN Rail Mount 4 DPDT Signal Relay Interface Module, DC 12V (Option 2 for Power Relay, must match with Power supply volts)
Terminal Block Breakout Shield Nano/Micro | DIN Rail Mount Screw Terminal Block Breakout Module Board for Arduino Nano/Micro. | DIN Rail Mount Screw Terminal Block Breakout Module Board for Arduino Nano/Micro.

Unit

Unit

### Page 8 of 91

7

8

Wire
Stripper

Strip the tip of
a Red Wire
Name | Description | Metric Conversion | Unit of Measure
Electrical Stranded Wire | 22AWG Stranded Wire (Multiple Colors) | 22AWG Stranded Wire (Multiple Colors) | Meter

Connect the
Red Wire into
the 12 Volt
position in the
Terminal Block
Breakout
shield with
labelled VIN
See Fig 2.0
Name | Description | Metric Conversion | Unit of Measure
Electrical Stranded Wire | 22AWG Stranded Wire (Multiple Colors) | 22AWG Stranded Wire (Multiple Colors)
Terminal Block Breakout Shield Nano/Micro | DIN Rail Mount Screw Terminal Block Breakout Module Board for Arduino Nano/Micro. (Option 2 for Arduino Terminal Adaptor must match Arduino Processor) | DIN Rail Mount Screw Terminal Block Breakout Module Board for Arduino Nano/Micro. (Option 2 for Arduino Terminal Adaptor must match Arduino Processor)

Meter

Unit

### Page 9 of 91

9

10

Screwdriver

Tighten the
screw to put
the Red Wire in
place
Name | Description | Metric Conversion | Unit of Measure
Terminal Block Breakout Shield Nano/Micro | DIN Rail Mount Screw Terminal Block Breakout Module Board for Arduino Nano/Micro. (Option 2 for Arduino Terminal Adaptor must match Arduino Processor) | DIN Rail Mount Screw Terminal Block Breakout Module Board for Arduino Nano/Micro. (Option 2 for Arduino Terminal Adaptor must match Arduino Processor)
Electrical Stranded Wire | 22AWG Stranded Wire (Multiple Colors) | 22AWG Stranded Wire (Multiple Colors)

Unit

Meter

Wire Cutter
Pliers

Cut the other
end of the Red
wire. Ensure
the length of
the Red Wire
will reach the
Barrier Strip
around 3"-4"
Name | Description | Metric Conversion | Unit of Measure
Electrical Stranded Wire | 22AWG Stranded Wire (Multiple Colors) | 22AWG Stranded Wire (Multiple Colors)
Bracket Holder Carrier Clips/Barrier Strip | PCB DIN Rail Mounting Adapter Circuit Board Mounting Bracket Holder, Carrier Clips, for 35mm, 15mm DIN Rail (Green) | PCB DIN Rail Mounting Adapter Circuit Board Mounting Bracket Holder, Carrier Clips, for 35mm, 15mm DIN Rail (Green)

Meter

Unit

### Page 10 of 91

11

12

Wire
Stripper

Strip the tip of
a 2nd Red Wire
Name | Description | Metric Conversion | Unit of Measure
Electrical Stranded Wire | 22AWG Stranded Wire (Multiple Colors) | 22AWG Stranded Wire (Multiple Colors) | Meter

Connect 2nd
Red Wire to
the VCC
terminal in the
Power Relay
Interface
Board.
Name | Description | Metric Conversion | Unit of Measure
Electrical Stranded Wire | 22AWG Stranded Wire (Multiple Colors) | 22AWG Stranded Wire (Multiple Colors)
Power Relay Interface 12V | DIN Rail Mount 4 DPDT Signal Relay Interface Module, DC 12V (Option 2 for Power Relay, must match with Power supply volts) | DIN Rail Mount 4 DPDT Signal Relay Interface Module, DC 12V (Option 2 for Power Relay, must match with Power supply volts)

Meter

Unit

### Page 11 of 91

13

14

Screwdriver

Tighten the
screw to put
the 2nd Red
Wire in place
Name | Description | Metric Conversion | Unit of Measure
Electrical Stranded Wire | 22AWG Stranded Wire (Multiple Colors) | 22AWG Stranded Wire (Multiple Colors)
Power Relay Interface 12V | DIN Rail Mount 4 DPDT Signal Relay Interface Module, DC 12V (Option 2 for Power Relay, must match with Power supply volts) | DIN Rail Mount 4 DPDT Signal Relay Interface Module, DC 12V (Option 2 for Power Relay, must match with Power supply volts)

Meter

Unit

Wire Cutter
Pliers

Cut the other
end of the Red
wire. Ensure
the length of
the Red Wire
will reach the
Barrier Strip
around 4"-5"
Name | Description | Metric Conversion | Unit of Measure
Electrical Stranded Wire | 22AWG Stranded Wire (Multiple Colors) | 22AWG Stranded Wire (Multiple Colors)
Bracket Holder Carrier Clips/Barrier Strip | PCB DIN Rail Mounting Adapter Circuit Board Mounting Bracket Holder, Carrier Clips, for 35mm, 15mm DIN Rail (Green) | PCB DIN Rail Mounting Adapter Circuit Board Mounting Bracket Holder, Carrier Clips, for 35mm, 15mm DIN Rail (Green)

Meter

Unit

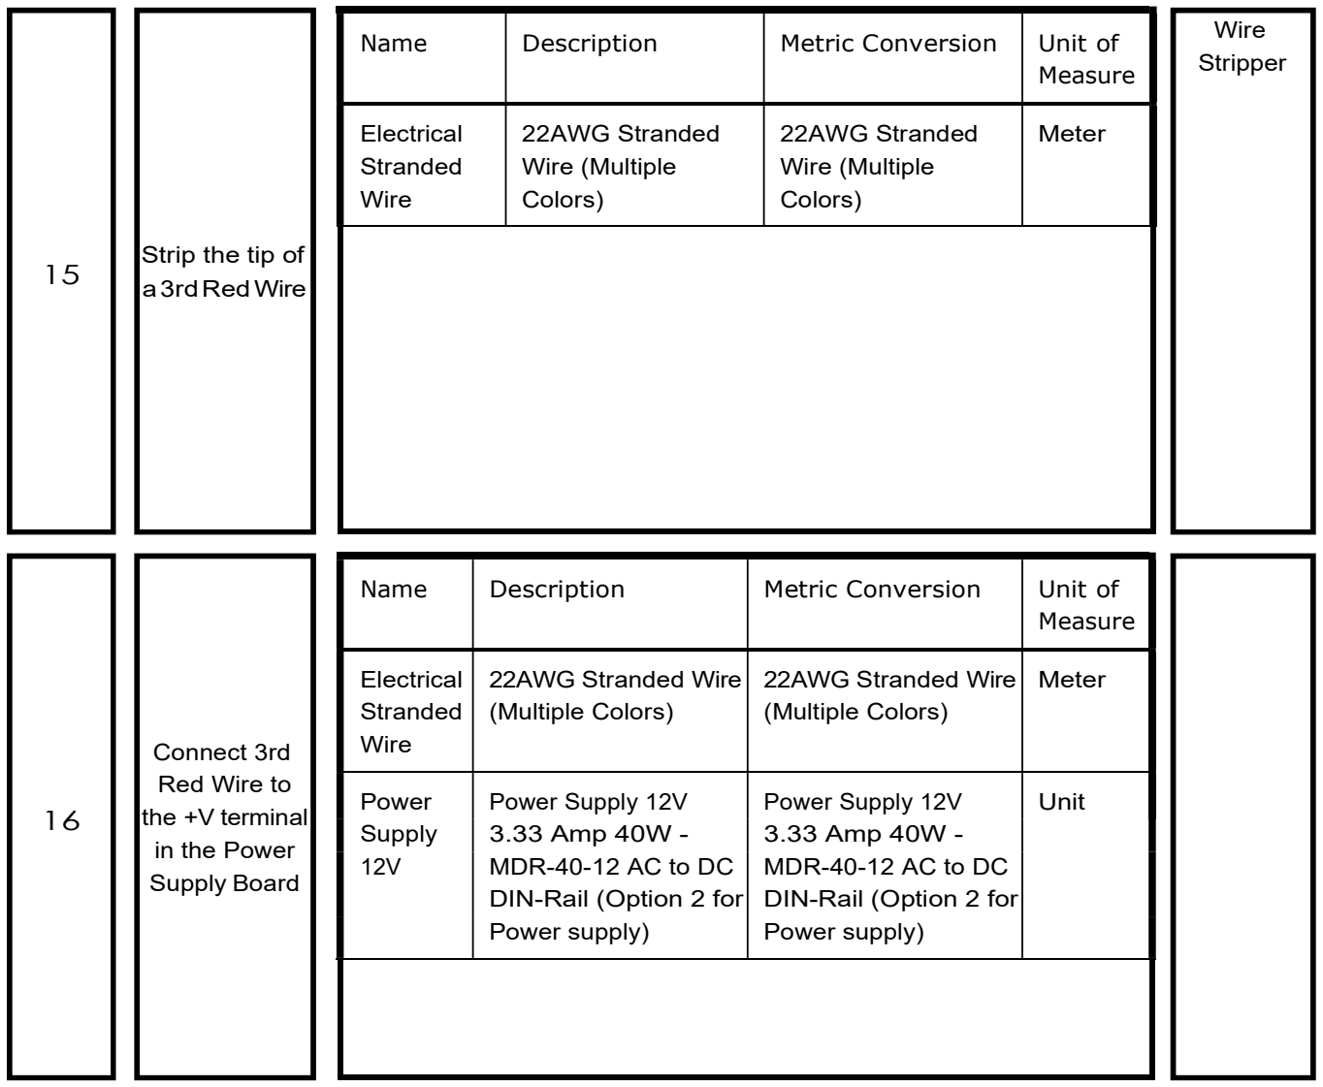
[picture p133: figure]
Wire Stripper; Strip the tip of a 3rd Red Wire; Name; Description; Metric Conversion; Unit of; Measure; Electrical Stranded Wire; 22AWG Stranded Wire (Multiple Colors); Meter; Connect 3rd Red Wire to the +V terminal in the Power Supply Board; Power; Power Supply 12V; Unit

### Page 12 of 91

Supply 12V | 3.33 Amp 40W -MDR-40-12 AC to DC DIN-Rail (Option 2 for Power supply) | 3.33 Amp 40W -MDR-40-12 AC to DC DIN-Rail (Option 2 for Power supply)

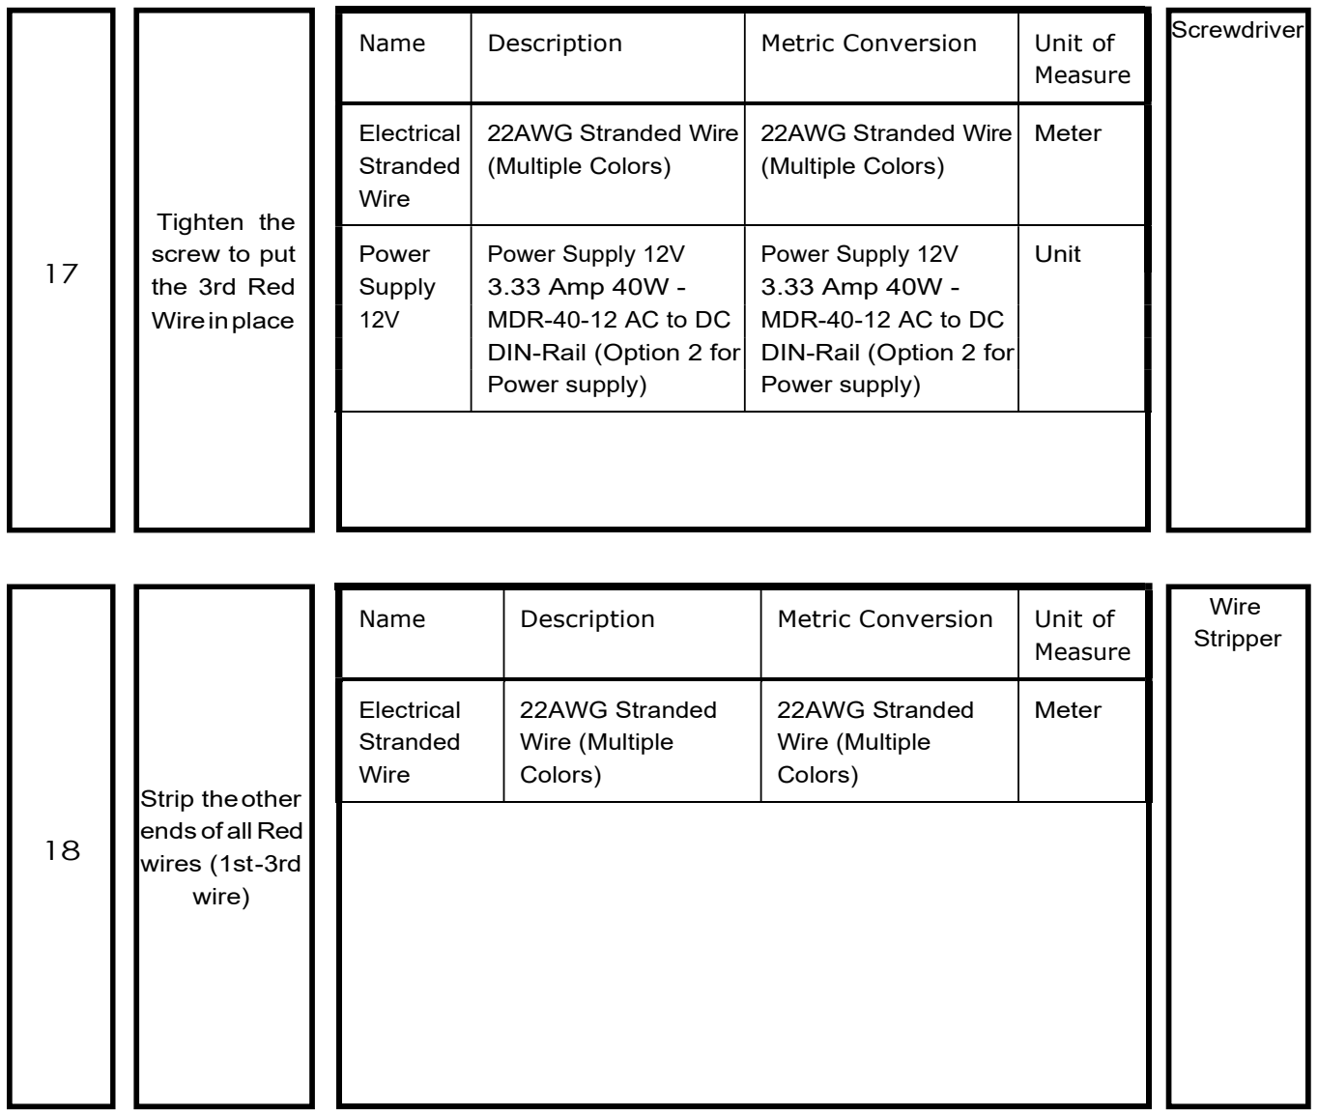
[picture p134: figure]
Screwdriver; Tighten the screw to put the 3rd Red Wire in place; Name; Description; Metric Conversion; Unit of; Measure; Electrical Stranded Wire; 22AWG Stranded Wire (Multiple Colors); Meter; Power; Power Supply 12V; Unit; Wire Stripper; Strip the other ends of all Red wires (1st -3rd wire)

### Page 13 of 91

Supply 12V | 3.33 Amp 40W -MDR-40-12 AC to DC DIN-Rail (Option 2 for Power supply) | 3.33 Amp 40W -MDR-40-12 AC to DC DIN-Rail (Option 2 for Power supply)

### Page 14 of 91

19

20

Connect all
Red wires (1st-3rd wire) to
the positive
side of the 1st
upper terminal
of the Barrier
Strip
Name | Description | Metric Conversion | Unit of Measure
Electrical Stranded Wire | 22AWG Stranded Wire (Multiple Colors) | 22AWG Stranded Wire (Multiple Colors)
Bracket Holder Carrier Clips/Barrier Strip | PCB DIN Rail Mounting Adapter Circuit Board Mounting Bracket Holder, Carrier Clips, for 35mm, 15mm DIN Rail (Green) | PCB DIN Rail Mounting Adapter Circuit Board Mounting Bracket Holder, Carrier Clips, for 35mm, 15mm DIN Rail (Green)

Meter

Unit

Screwdriver

Tighten the
screws to put
all Red wires
(1st-3rd wire)
in place
Name | Description | Metric Conversion | Unit of Measure
Electrical Stranded Wire | 22AWG Stranded Wire (Multiple Colors) | 22AWG Stranded Wire (Multiple Colors)
Bracket Holder Carrier Clips/Barrier Strip | PCB DIN Rail Mounting Adapter Circuit Board Mounting Bracket Holder, Carrier Clips, for 35mm, 15mm DIN Rail (Green) | PCB DIN Rail Mounting Adapter Circuit Board Mounting Bracket Holder, Carrier Clips, for 35mm, 15mm DIN Rail (Green)

Meter

Unit

### Page 15 of 91

21

22

Wire
Stripper

Strip the tip of
a Black Wire
Name | Description | Metric Conversion | Unit of Measure
Electrical Stranded Wire | 22AWG Stranded Wire (Multiple Colors) | 22AWG Stranded Wire (Multiple Colors) | Meter

Connect the
Black Wire into
the ground
section of the
Power Relay
Interface
Board. next to
the VCC
Terminal or
marked as
GND
Name | Description | Metric Conversion | Unit of Measure
Electrical Stranded Wire | 22AWG Stranded Wire (Multiple Colors) | 22AWG Stranded Wire (Multiple Colors)
Power Relay Interface 12V | DIN Rail Mount 4 DPDT Signal Relay Interface Module, DC 12V (Option 2 for Power Relay, must match with Power supply volts) | DIN Rail Mount 4 DPDT Signal Relay Interface Module, DC 12V (Option 2 for Power Relay, must match with Power supply volts)

Meter

Unit

### Page 16 of 91

23

24

Screwdriver

Tighten the
screw to put
the Black Wire
in place
Name | Description | Metric Conversion | Unit of Measure
Electrical Stranded Wire | 22AWG Stranded Wire (Multiple Colors) | 22AWG Stranded Wire (Multiple Colors)
Power Relay Interface 12V | DIN Rail Mount 4 DPDT Signal Relay Interface Module, DC 12V (Option 2 for Power Relay, must match with Power supply volts) | DIN Rail Mount 4 DPDT Signal Relay Interface Module, DC 12V (Option 2 for Power Relay, must match with Power supply volts)

Meter

Unit

Wire Cutter
Pliers

Cut the other
end of the
Black Wire.
Ensure the
length of the
wire will reach
the Barrier
Strip around
4"-5"
Name | Description | Metric Conversion | Unit of Measure
Electrical Stranded Wire | 22AWG Stranded Wire (Multiple Colors) | 22AWG Stranded Wire (Multiple Colors)
Bracket Holder Carrier Clips/Barrier Strip | PCB DIN Rail Mounting Adapter Circuit Board Mounting Bracket Holder, Carrier Clips, for 35mm, 15mm DIN Rail (Green) | PCB DIN Rail Mounting Adapter Circuit Board Mounting Bracket Holder, Carrier Clips, for 35mm, 15mm DIN Rail (Green)

Meter

Unit

### Page 17 of 91

25

26

Wire
Stripper

Strip the tip of
a 2nd Black
Wire
Name | Description | Metric Conversion | Unit of Measure
Electrical Stranded Wire | 22AWG Stranded Wire (Multiple Colors) | 22AWG Stranded Wire (Multiple Colors) | Meter

Connect the
2nd Black Wire
into the
ground section
in the Terminal
Block Breakout
Shield labelled
GND
Name | Description | Metric Conversion | Unit of Measure
Electrical Stranded Wire | 22AWG Stranded Wire (Multiple Colors) | 22AWG Stranded Wire (Multiple Colors)
Terminal Block Breakout Shield Nano/Micro | DIN Rail Mount Screw Terminal Block Breakout Module Board for Arduino Nano/Micro. (Option 2 for Arduino Terminal Adaptor must match Arduino Processor) | DIN Rail Mount Screw Terminal Block Breakout Module Board for Arduino Nano/Micro. (Option 2 for Arduino Terminal Adaptor must match Arduino Processor)

Meter

Unit

### Page 18 of 91

27

28

Screwdriver

Tighten the
screw to put
the 2nd Black
Wire in place
Name | Description | Metric Conversion | Unit of Measure
Electrical Stranded Wire | 22AWG Stranded Wire (Multiple Colors) | 22AWG Stranded Wire (Multiple Colors)
Terminal Block Breakout Shield Nano/Micro | DIN Rail Mount Screw Terminal Block Breakout Module Board for Arduino Nano/Micro. (Option 2 for Arduino Terminal Adaptor must match Arduino Processor) | DIN Rail Mount Screw Terminal Block Breakout Module Board for Arduino Nano/Micro. (Option 2 for Arduino Terminal Adaptor must match Arduino Processor)

Meter

Unit

Wire
Stripper

Strip the tip of
a 3rd Black
Wire
Name | Description | Metric Conversion | Unit of Measure
Electrical Stranded Wire | 22AWG Stranded Wire (Multiple Colors) | 22AWG Stranded Wire (Multiple Colors) | Meter

### Page 19 of 91

29

30

Connect 3rd
Red Black to
the -V terminal
in the Power
Supply Board
Name | Description | Metric Conversion | Unit of Measure
Electrical Stranded Wire | 22AWG Stranded Wire (Multiple Colors) | 22AWG Stranded Wire (Multiple Colors)
Supply 12V | 3.33 Amp 40W -MDR-40-12 AC to DC DIN-Rail (Option 2 for Power supply) | 3.33 Amp 40W -MDR-40-12 AC to DC DIN-Rail (Option 2 for Power supply)

Meter

Power | Power Supply 12V | Power Supply 12V | Unit

Screwdriver

Tighten the
screw to put
the 3rd Red
Wire in place
Name | Description | Metric Conversion | Unit of Measure
Electrical Stranded Wire | 22AWG Stranded Wire (Multiple Colors) | 22AWG Stranded Wire (Multiple Colors)
Supply 12V | 3.33 Amp 40W -MDR-40-12 AC to DC DIN-Rail (Option 2 for Power supply) | 3.33 Amp 40W -MDR-40-12 AC to DC DIN-Rail (Option 2 for Power supply)

Meter

Power | Power Supply 12V | Power Supply 12V | Unit

### Page 20 of 91

31

32

Strip the other
ends of all
Black wires
(1st -3rd wire)
Name | Description | Metric Conversion | Unit of Measure
Electrical Stranded Wire | 22AWG Stranded Wire (Multiple Colors) | 22AWG Stranded Wire (Multiple Colors) | Meter

Connect all
Black wires
(1st-3rd wire)
to the negative
side of the 2nd
upper Terminal
of the Barrier
Strip
Name | Description | Metric Conversion | Unit of Measure
Electrical Stranded Wire | 22AWG Stranded Wire (Multiple Colors) | 22AWG Stranded Wire (Multiple Colors)
Bracket Holder Carrier Clips/Barrier Strip | PCB DIN Rail Mounting Adapter Circuit Board Mounting Bracket Holder, Carrier Clips, for 35mm, 15mm DIN Rail (Green) | PCB DIN Rail Mounting Adapter Circuit Board Mounting Bracket Holder, Carrier Clips, for 35mm, 15mm DIN Rail (Green)

Meter

Unit

### Page 21 of 91

33

34

Screwdriver

Tighten the
screws to put
all Black wires
(1st-3rd wire)
in place
Name | Description | Metric Conversion | Unit of Measure
Electrical Stranded Wire | 22AWG Stranded Wire (Multiple Colors) | 22AWG Stranded Wire (Multiple Colors)
Bracket Holder Carrier Clips/Barrier Strip | PCB DIN Rail Mounting Adapter Circuit Board Mounting Bracket Holder, Carrier Clips, for 35mm, 15mm DIN Rail (Green) | PCB DIN Rail Mounting Adapter Circuit Board Mounting Bracket Holder, Carrier Clips, for 35mm, 15mm DIN Rail (Green)

Meter

Unit

Wire
Stripper

Strip the tip of
a Yellow
Wire(blue in
Fig 2.)
Name | Description | Metric Conversion | Unit of Measure
Electrical Stranded Wire | 22AWG Stranded Wire (Multiple Colors) | 22AWG Stranded Wire (Multiple Colors) | Meter

### Page 22 of 91

35

36

Connect the
Yellow Wire
(blue in Fig
2.)into the
Terminal 5
labelled 5 in
the Terminal
Block Breakout
Shield
Name | Description | Metric Conversion | Unit of Measure
Electrical Stranded Wire | 22AWG Stranded Wire (Multiple Colors) | 22AWG Stranded Wire (Multiple Colors)
Terminal Block Breakout Shield Nano/Micro | DIN Rail Mount Screw Terminal Block Breakout Module Board for Arduino Nano/Micro. (Option 2 for Arduino Terminal Adaptor must match Arduino Processor) | DIN Rail Mount Screw Terminal Block Breakout Module Board for Arduino Nano/Micro. (Option 2 for Arduino Terminal Adaptor must match Arduino Processor)

Meter

Unit

Screwdriver

Tighten the
screw to put in
place the
Yellow
Wire(blue in
Fig 2.)
Name | Description | Metric Conversion | Unit of Measure
Electrical Stranded Wire | 22AWG Stranded Wire (Multiple Colors) | 22AWG Stranded Wire (Multiple Colors) | Meter

### Page 23 of 91

37

38

Wire Cutter
Pliers

Cut the other
end of the
Yellow
Wire(blue in
Fig 2.).
Ensure the
length of the
wire will reach
the Power
Relay Interface
Board Terminal
A around 4"-5"
Name | Description | Metric Conversion | Unit of Measure
Electrical Stranded Wire | 22AWG Stranded Wire (Multiple Colors) | 22AWG Stranded Wire (Multiple Colors)
Power Relay Interface 12V | DIN Rail Mount 4 DPDT Signal Relay Interface Module, DC 12V (Option 2 for Power Relay, must match with Power supply volts) | DIN Rail Mount 4 DPDT Signal Relay Interface Module, DC 12V (Option 2 for Power Relay, must match with Power supply volts)

Meter

Unit

Wire
Stripper

Strip the tip of
the other end
of the Yellow
Wire(blue in
Fig 2.)
Name | Description | Metric Conversion | Unit of Measure
Electrical Stranded Wire | 22AWG Stranded Wire (Multiple Colors) | 22AWG Stranded Wire (Multiple Colors) | Meter

### Page 24 of 91

39

40

Connect the
other end of
the Yellow
Wire (blue in
Fig 2.) into
the Power
Relay
Interface
Board Terminal
A
Name | Description | Metric Conversion | Unit of Measure
Electrical Stranded Wire | 22AWG Stranded Wire (Multiple Colors) | 22AWG Stranded Wire (Multiple Colors)
Power Relay Interface 12V | DIN Rail Mount 4 DPDT Signal Relay Interface Module, DC 12V (Option 2 for Power Relay, must match with Power supply volts) | DIN Rail Mount 4 DPDT Signal Relay Interface Module, DC 12V (Option 2 for Power Relay, must match with Power supply volts)

Meter

Unit

Screwdriver

Tighten the
screw to put
other end of
the yellow wire
(blue in Fig
2.)in place
Name | Description | Metric Conversion | Unit of Measure
Electrical Stranded Wire | 22AWG Stranded Wire (Multiple Colors) | 22AWG Stranded Wire (Multiple Colors)
Power Relay Interface 12V | DIN Rail Mount 4 DPDT Signal Relay Interface Module, DC 12V (Option 2 for Power Relay, must match with Power supply volts) | DIN Rail Mount 4 DPDT Signal Relay Interface Module, DC 12V (Option 2 for Power Relay, must match with Power supply volts)

Meter

Unit

### Page 25 of 91

41

42

Wire
Stripper

Strip the tip of
the 2nd
Yellow
Wire(blue in
Fig 2.)
Name | Description | Metric Conversion | Unit of Measure
Electrical Stranded Wire | 22AWG Stranded Wire (Multiple Colors) | 22AWG Stranded Wire (Multiple Colors) | Meter

Connect the
2nd Yellow
Wire(blue in
Fig 2.) into
the Terminal
6
(labelled 6) of
the Terminal
Block Breakout
Shield
Name | Description | Metric Conversion | Unit of Measure
Electrical Stranded Wire | 22AWG Stranded Wire (Multiple Colors) | 22AWG Stranded Wire (Multiple Colors)
Terminal Block Breakout Shield Nano/Micro | DIN Rail Mount Screw Terminal Block Breakout Module Board for Arduino Nano/Micro. (Option 2 for Arduino Terminal Adaptor must match Arduino Processor) | DIN Rail Mount Screw Terminal Block Breakout Module Board for Arduino Nano/Micro. (Option 2 for Arduino Terminal Adaptor must match Arduino Processor)

Meter

Unit

### Page 26 of 91

43

44

Screwdriver

Tighten the
screw to put
2nd Yellow
Wire(blue in
Fig 2.) in
place.
Name | Description | Metric Conversion | Unit of Measure
Electrical Stranded Wire | 22AWG Stranded Wire (Multiple Colors) | 22AWG Stranded Wire (Multiple Colors)
Terminal Block Breakout Shield Nano/Micro | DIN Rail Mount Screw Terminal Block Breakout Module Board for Arduino Nano/Micro. (Option 2 for Arduino Terminal Adaptor must match Arduino Processor) | DIN Rail Mount Screw Terminal Block Breakout Module Board for Arduino Nano/Micro. (Option 2 for Arduino Terminal Adaptor must match Arduino Processor)

Meter

Unit

Wire Cutter
Pliers

Cut the other
end of the 2nd
Yellow
Wire(blue in
Fig 2.).
Ensure the
length of the
wire will reach
the Power
Relay Interface
Board Terminal
B around 4"-5"
Name | Description | Metric Conversion | Unit of Measure
Electrical Stranded Wire | 22AWG Stranded Wire (Multiple Colors) | 22AWG Stranded Wire (Multiple Colors)
Power Relay Interface 12V | DIN Rail Mount 4 DPDT Signal Relay Interface Module, DC 12V (Option 2 for Power Relay, must match with Power supply volts) | DIN Rail Mount 4 DPDT Signal Relay Interface Module, DC 12V (Option 2 for Power Relay, must match with Power supply volts)

Meter

Unit

### Page 27 of 91

45

46

Wire
Stripper

Strip the tip of
the other end
of the 2nd
yellow
wire(blue in
Fig 2.)
Name | Description | Metric Conversion | Unit of Measure
Electrical Stranded Wire | 22AWG Stranded Wire (Multiple Colors) | 22AWG Stranded Wire (Multiple Colors) | Meter

Connect the
other end of
the 2nd yellow
wire (blue in
Fig 2.) into
the Power
Relay
Interface
Board
Terminal B
Name | Description | Metric Conversion | Unit of Measure
Electrical Stranded Wire | 22AWG Stranded Wire (Multiple Colors) | 22AWG Stranded Wire (Multiple Colors)
Power Relay Interface 12V | DIN Rail Mount 4 DPDT Signal Relay Interface Module, DC 12V (Option 2 for Power Relay, must match with Power supply volts) | DIN Rail Mount 4 DPDT Signal Relay Interface Module, DC 12V (Option 2 for Power Relay, must match with Power supply volts)

Meter

Unit

### Page 28 of 91

47

48

Screwdriver

Tighten the
screw to put
the other end
of the 2nd
yellow
wire(blue in
Fig 2.) in
place
Name | Description | Metric Conversion | Unit of Measure
Electrical Stranded Wire | 22AWG Stranded Wire (Multiple Colors) | 22AWG Stranded Wire (Multiple Colors)
Power Relay Interface 12V | DIN Rail Mount 4 DPDT Signal Relay Interface Module, DC 12V (Option 2 for Power Relay, must match with Power supply volts) | DIN Rail Mount 4 DPDT Signal Relay Interface Module, DC 12V (Option 2 for Power Relay, must match with Power supply volts)

Meter

Unit

Wire
Stripper

Strip the tip of
the 3rd yellow
wire(blue in
Fig 2.)
Name | Description | Metric Conversion | Unit of Measure
Electrical Stranded Wire | 22AWG Stranded Wire (Multiple Colors) | 22AWG Stranded Wire (Multiple Colors) | Meter

### Page 29 of 91

49

50

Connect the
3rd Yellow
Wire (blue in
Fig 2.) into
the Terminal
7
(labelled 7) of
the Terminal
Block Breakout
Shield
Name | Description | Metric Conversion | Unit of Measure
Electrical Stranded Wire | 22AWG Stranded Wire (Multiple Colors) | 22AWG Stranded Wire (Multiple Colors)
Terminal Block Breakout Shield Nano/Micro | DIN Rail Mount Screw Terminal Block Breakout Module Board for Arduino Nano/Micro. (Option 2 for Arduino Terminal Adaptor must match Arduino Processor) | DIN Rail Mount Screw Terminal Block Breakout Module Board for Arduino Nano/Micro. (Option 2 for Arduino Terminal Adaptor must match Arduino Processor)

Meter

Unit

Screwdriver

Tighten the
screw to put
3rd Yellow
Wire (blue in
Fig 2.)in
place
Name | Description | Metric Conversion | Unit of Measure
Electrical Stranded Wire | 22AWG Stranded Wire (Multiple Colors) | 22AWG Stranded Wire (Multiple Colors) | Meter

### Page 30 of 91

51

52

Wire Cutter
Pliers

Cut the other
end of the 3rd
Yellow
Wire(blue in
Fig 2.).
Ensure the
length of the
wire will reach
the Power
Relay Interface
Board Terminal
C around 3"-4"
Name | Description | Metric Conversion | Unit of Measure
Electrical Stranded Wire | 22AWG Stranded Wire (Multiple Colors) | 22AWG Stranded Wire (Multiple Colors)
Power Relay Interface 12V | DIN Rail Mount 4 DPDT Signal Relay Interface Module, DC 12V (Option 2 for Power Relay, must match with Power supply volts) | DIN Rail Mount 4 DPDT Signal Relay Interface Module, DC 12V (Option 2 for Power Relay, must match with Power supply volts)

Meter

Unit

Wire
Stripper

Strip the tip of
the other end
of the 3rd
Yellow
Wire(blue in
Fig 2.)
Name | Description | Metric Conversion | Unit of Measure
Electrical Stranded Wire | 22AWG Stranded Wire (Multiple Colors) | 22AWG Stranded Wire (Multiple Colors) | Meter

### Page 31 of 91

53

54

Connect the
other end of
the 3rd Yellow
Wire (blue in
Fig 2.) into
the Power
Relay
Interface
Terminal C.
Name | Description | Metric Conversion | Unit of Measure
Electrical Stranded Wire | 22AWG Stranded Wire (Multiple Colors) | 22AWG Stranded Wire (Multiple Colors)
Power Relay Interface 12V | DIN Rail Mount 4 DPDT Signal Relay Interface Module, DC 12V (Option 2 for Power Relay, must match with Power supply volts) | DIN Rail Mount 4 DPDT Signal Relay Interface Module, DC 12V (Option 2 for Power Relay, must match with Power supply volts)

Meter

Unit

Screwdriver

Tighten the
screw to put
other end of
the 3rd Yellow
Wire(blue in
Fig 2.) in
place.
Name | Description | Metric Conversion | Unit of Measure
Electrical Stranded Wire | 22AWG Stranded Wire (Multiple Colors) | 22AWG Stranded Wire (Multiple Colors)
Power Relay Interface 12V | DIN Rail Mount 4 DPDT Signal Relay Interface Module, DC 12V (Option 2 for Power Relay, must match with Power supply volts) | DIN Rail Mount 4 DPDT Signal Relay Interface Module, DC 12V (Option 2 for Power Relay, must match with Power supply volts)

Meter

Unit

### Page 32 of 91

55

56

Wire
Stripper

Strip the tip of
the 4th Yellow
Wire(blue in
Fig 2.)
Name | Description | Metric Conversion | Unit of Measure
Electrical Stranded Wire | 22AWG Stranded Wire (Multiple Colors) | 22AWG Stranded Wire (Multiple Colors) | Meter

Connect
another 4th
Yellow Wire
(blue in Fig
2.)into the
Terminal
8(labelled 8) of
the Terminal
Block Breakout
Shield
Name | Description | Metric Conversion | Unit of Measure
Electrical Stranded Wire | 22AWG Stranded Wire (Multiple Colors) | 22AWG Stranded Wire (Multiple Colors)
Terminal Block Breakout Shield Nano/Micro | DIN Rail Mount Screw Terminal Block Breakout Module Board for Arduino Nano/Micro. (Option 2 for Arduino Terminal Adaptor must match Arduino Processor) | DIN Rail Mount Screw Terminal Block Breakout Module Board for Arduino Nano/Micro. (Option 2 for Arduino Terminal Adaptor must match Arduino Processor)

Meter

Unit

### Page 33 of 91

57

58

Screwdriver

Tighten the
screw to put
4th Yellow
Wire in
place(blue in
Fig 2.)
Name | Description | Metric Conversion | Unit of Measure
Electrical Stranded Wire | 22AWG Stranded Wire (Multiple Colors) | 22AWG Stranded Wire (Multiple Colors)
Terminal Block Breakout Shield Nano/Micro | DIN Rail Mount Screw Terminal Block Breakout Module Board for Arduino Nano/Micro. (Option 2 for Arduino Terminal Adaptor must match Arduino Processor) | DIN Rail Mount Screw Terminal Block Breakout Module Board for Arduino Nano/Micro. (Option 2 for Arduino Terminal Adaptor must match Arduino Processor)

Meter

Unit

Wire Cutter
Pliers

Cut the other
end of the 4th
Yellow
Wire(blue in
Fig 2.).
Ensure the
length of the
wire will reach
the Power
Relay Interface
Board Terminal
D around 3"-4"
Name | Description | Metric Conversion | Unit of Measure
Electrical Stranded Wire | 22AWG Stranded Wire (Multiple Colors) | 22AWG Stranded Wire (Multiple Colors)
Power Relay Interface 12V | DIN Rail Mount 4 DPDT Signal Relay Interface Module, DC 12V (Option 2 for Power Relay, must match with Power supply volts) | DIN Rail Mount 4 DPDT Signal Relay Interface Module, DC 12V (Option 2 for Power Relay, must match with Power supply volts)

Meter

Unit

### Page 34 of 91

59

60

Wire
Stripper

Strip the tip of
the other end
of the 4th
(blue in Fig
2.)Yellow
Wire
Name | Description | Metric Conversion | Unit of Measure
Electrical Stranded Wire | 22AWG Stranded Wire (Multiple Colors) | 22AWG Stranded Wire (Multiple Colors) | Meter

Connect the
other end of
the 4th Yellow
Wire(blue in
Fig 2.) into
the Power
Relay
Interface
Board Terminal
D
Name | Description | Metric Conversion | Unit of Measure
Electrical Stranded Wire | 22AWG Stranded Wire (Multiple Colors) | 22AWG Stranded Wire (Multiple Colors)
Power Relay Interface 12V | DIN Rail Mount 4 DPDT Signal Relay Interface Module, DC 12V (Option 2 for Power Relay, must match with Power supply volts) | DIN Rail Mount 4 DPDT Signal Relay Interface Module, DC 12V (Option 2 for Power Relay, must match with Power supply volts)

Meter

Unit

### Page 35 of 91

61

62

Screwdriver

Tighten the
screw to put
the other end
of the 4th
Yellow Wire
(blue in Fig
2.)in place
Name | Description | Metric Conversion | Unit of Measure
Electrical Stranded Wire | 22AWG Stranded Wire (Multiple Colors) | 22AWG Stranded Wire (Multiple Colors)
Power Relay Interface 12V | DIN Rail Mount 4 DPDT Signal Relay Interface Module, DC 12V (Option 2 for Power Relay, must match with Power supply volts) | DIN Rail Mount 4 DPDT Signal Relay Interface Module, DC 12V (Option 2 for Power Relay, must match with Power supply volts)

Meter

Unit

Wire
Stripper

Strip the tip a
4th Black wire
Name | Description | Metric Conversion | Unit of Measure
Electrical Stranded Wire | 22AWG Stranded Wire (Multiple Colors) | 22AWG Stranded Wire (Multiple Colors) | Meter

### Page 36 of 91

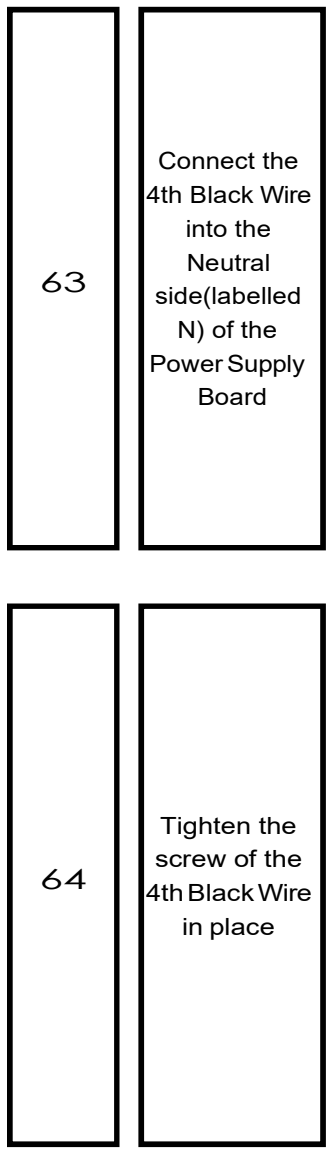
[picture p135: figure]
Connect the 4th Black Wire into the Neutral side(labelled N) of the Power Supply Board; Tighten the screw of the 4th Black Wire in place

Screwdriver

Name | Description | Metric Conversion | Unit of Measure
Electrical Stranded Wire | 22AWG Stranded Wire (Multiple Colors) | 22AWG Stranded Wire (Multiple Colors) | Meter
Power | Power Supply 12V 3.33 Amp 40W - MDR-40-12 AC to DC DIN-Rail (Option 2 for Power supply)

Power Supply 12V

### 3.33 Amp 40W - MDR-

40-12 AC to DC DIN-Rail (Option 2 for
Power supply)

Unit
Supply
12V
Name | Description | Metric Conversion | Unit of Measure
Electrical Stranded Wire | 22AWG Stranded Wire (Multiple Colors) | 22AWG Stranded Wire (Multiple Colors) | Meter

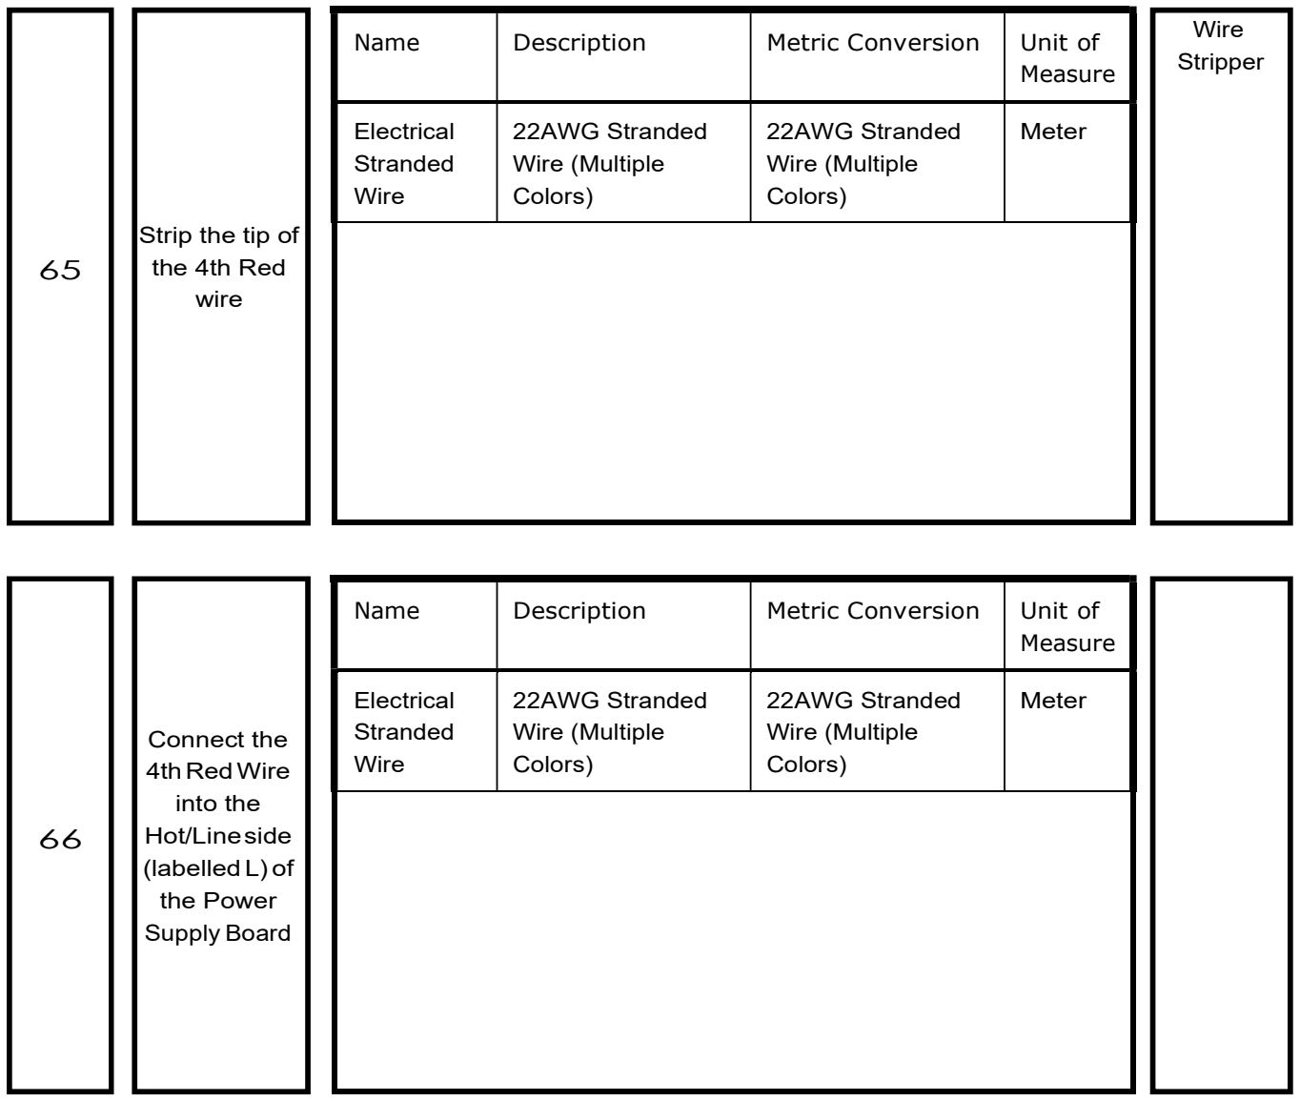
[picture p136: figure]
Wire Stripper; Strip the tip of the 4th Red wire; Name; Description; Metric Conversion; Unit of; Measure; Electrical Stranded Wire; 22AWG Stranded Wire (Multiple Colors); Meter; Connect the 4th Red Wire into the Hot/Line side (labelled L) of the Power Supply Board

### Page 37 of 91

### Page 38 of 91

67

68

Screwdriver

Tighten the
screw of the
4th Red Wire
in place
Name | Description | Metric Conversion | Unit of Measure
Electrical Stranded Wire | 22AWG Stranded Wire (Multiple Colors) | 22AWG Stranded Wire (Multiple Colors) | Meter

Wire Cutter
Pliers

Collect and
Cut the 4th
Black and Red
Wire. Ensure
the height of
the wires will
reach the
Barrier Strip
around 3"-4"
Name | Description | Metric Conversion | Unit of Measure
Bracket Holder Carrier Clips/Barrier Strip | PCB DIN Rail Mounting Adapter Circuit Board Mounting Bracket Holder, Carrier Clips, for 35mm, 15mm DIN Rail (Green) | PCB DIN Rail Mounting Adapter Circuit Board Mounting Bracket Holder, Carrier Clips, for 35mm, 15mm DIN Rail (Green)
Electrical Stranded Wire | 22AWG Stranded Wire (Multiple Colors) | 22AWG Stranded Wire (Multiple Colors)

Unit

Meter

### Page 39 of 91

69

70

Wire
Stripper

Strip the Tips
of the other
ends of the
4th Black and
Red wires

Connect the
other end of
the 4th Red
Wire to the 4th
lower Terminal
of the Barrier
Strip
Name | Description | Metric Conversion | Unit of Measure
Bracket Holder Carrier Clips/Barrier Strip | PCB DIN Rail Mounting Adapter Circuit Board Mounting Bracket Holder, Carrier Clips, for 35mm, 15mm DIN Rail (Green) | PCB DIN Rail Mounting Adapter Circuit Board Mounting Bracket Holder, Carrier Clips, for 35mm, 15mm DIN Rail (Green)
Electrical Stranded Wire | 22AWG Stranded Wire (Multiple Colors) | 22AWG Stranded Wire (Multiple Colors)

Unit

Meter

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

### Page 40 of 91

71

72

Connect the
other end of
the 4th Black
Wire to the 3rd
lower Terminal
of the Barrier
Strip
Name | Description | Metric Conversion | Unit of Measure
Bracket Holder Carrier Clips/Barrier Strip | PCB DIN Rail Mounting Adapter Circuit Board Mounting Bracket Holder, Carrier Clips, for 35mm, 15mm DIN Rail (Green) | PCB DIN Rail Mounting Adapter Circuit Board Mounting Bracket Holder, Carrier Clips, for 35mm, 15mm DIN Rail (Green)
Electrical Stranded Wire | 22AWG Stranded Wire (Multiple Colors) | 22AWG Stranded Wire (Multiple Colors)

Unit

Meter

Wire
Stripper

Strip the tip
of the 5th Red
wire
Name | Description | Metric Conversion | Unit of Measure
Electrical Stranded Wire | 22AWG Stranded Wire (Multiple Colors) | 22AWG Stranded Wire (Multiple Colors) | Meter

### Page 41 of 91

73

74

Connect a 5th
Red wire into
the power
input using the
1st common
terminal of the
Power Relay
Interface
Board. This
connection is
for the valves
Name | Description | Metric Conversion | Unit of Measure
Electrical Stranded Wire | 22AWG Stranded Wire (Multiple Colors) | 22AWG Stranded Wire (Multiple Colors)
Power Relay Interface 12V | DIN Rail Mount 4 DPDT Signal Relay Interface Module, DC 12V (Option 2 for Power Relay, must match with Power supply volts) | DIN Rail Mount 4 DPDT Signal Relay Interface Module, DC 12V (Option 2 for Power Relay, must match with Power supply volts)

Meter

Unit

Screwdriver

Tighten the
screw of the
5th red wire in
place
Name | Description | Metric Conversion | Unit of Measure
Electrical Stranded Wire | 22AWG Stranded Wire (Multiple Colors) | 22AWG Stranded Wire (Multiple Colors)
Power Relay Interface 12V | DIN Rail Mount 4 DPDT Signal Relay Interface Module, DC 12V (Option 2 for Power Relay, must match with Power supply volts) | DIN Rail Mount 4 DPDT Signal Relay Interface Module, DC 12V (Option 2 for Power Relay, must match with Power supply volts)

Meter

Unit

### Page 42 of 91

75

76

Wire Cutter
Pliers

Cut the other
end of the 5th
Red Wire.
Ensure the
length of the
wire will reach
the Barrier
Strip around
4"-5"
Name | Description | Metric Conversion | Unit of Measure
Bracket Holder Carrier Clips/Barrier Strip | PCB DIN Rail Mounting Adapter Circuit Board Mounting Bracket Holder, Carrier Clips, for 35mm, 15mm DIN Rail (Green) | PCB DIN Rail Mounting Adapter Circuit Board Mounting Bracket Holder, Carrier Clips, for 35mm, 15mm DIN Rail (Green)
Electrical Stranded Wire | 22AWG Stranded Wire (Multiple Colors) | 22AWG Stranded Wire (Multiple Colors)

Unit

Meter

Wire
Stripper

Strip the tip of
the 6th Red
wire
Name | Description | Metric Conversion | Unit of Measure
Electrical Stranded Wire | 22AWG Stranded Wire (Multiple Colors) | 22AWG Stranded Wire (Multiple Colors) | Meter

### Page 43 of 91

77

78

Connect a 6th
Red wire into
the power
input using the
2nd common
terminal of the
Power Relay
Interface
Board. This
connection is
for the valves
Name | Description | Metric Conversion | Unit of Measure
Electrical Stranded Wire | 22AWG Stranded Wire (Multiple Colors) | 22AWG Stranded Wire (Multiple Colors)
Power Relay Interface 12V | DIN Rail Mount 4 DPDT Signal Relay Interface Module, DC 12V (Option 2 for Power Relay, must match with Power supply volts) | DIN Rail Mount 4 DPDT Signal Relay Interface Module, DC 12V (Option 2 for Power Relay, must match with Power supply volts)

Meter

Unit

Screwdriver

Tighten the
screw of the
6th red wire in
place
Name | Description | Metric Conversion | Unit of Measure
Electrical Stranded Wire | 22AWG Stranded Wire (Multiple Colors) | 22AWG Stranded Wire (Multiple Colors)
Power Relay Interface 12V | DIN Rail Mount 4 DPDT Signal Relay Interface Module, DC 12V (Option 2 for Power Relay, must match with Power supply volts) | DIN Rail Mount 4 DPDT Signal Relay Interface Module, DC 12V (Option 2 for Power Relay, must match with Power supply volts)

Meter

Unit

### Page 44 of 91

79

80

Wire Cutter
Pliers

Cut the other
end of the 6th
Red Wire.
Ensure the
length of the
wire will reach
the Barrier
Strip around
4"-5"
Name | Description | Metric Conversion | Unit of Measure
Bracket Holder Carrier Clips/Barrier Strip | PCB DIN Rail Mounting Adapter Circuit Board Mounting Bracket Holder, Carrier Clips, for 35mm, 15mm DIN Rail (Green) | PCB DIN Rail Mounting Adapter Circuit Board Mounting Bracket Holder, Carrier Clips, for 35mm, 15mm DIN Rail (Green)
Electrical Stranded Wire | 22AWG Stranded Wire (Multiple Colors) | 22AWG Stranded Wire (Multiple Colors)

Unit

Meter

Wire
Stripper

Strip the tip of
the 7th Red
wire
Name | Description | Metric Conversion | Unit of Measure
Electrical Stranded Wire | 22AWG Stranded Wire (Multiple Colors) | 22AWG Stranded Wire (Multiple Colors) | Meter

### Page 45 of 91

81

82

Connect a 7th
Red wire into
the power
input using the
3rd common
terminal of the
Power Relay
Interface
Board. This
connection is
for the valves
Name | Description | Metric Conversion | Unit of Measure
Electrical Stranded Wire | 22AWG Stranded Wire (Multiple Colors) | 22AWG Stranded Wire (Multiple Colors)
Power Relay Interface 12V | DIN Rail Mount 4 DPDT Signal Relay Interface Module, DC 12V (Option 2 for Power Relay, must match with Power supply volts) | DIN Rail Mount 4 DPDT Signal Relay Interface Module, DC 12V (Option 2 for Power Relay, must match with Power supply volts)

Meter

Unit

Screwdriver

Tighten the
screw of the
7th red wire in
place
Name | Description | Metric Conversion | Unit of Measure
Electrical Stranded Wire | 22AWG Stranded Wire (Multiple Colors) | 22AWG Stranded Wire (Multiple Colors)
Power Relay Interface 12V | DIN Rail Mount 4 DPDT Signal Relay Interface Module, DC 12V (Option 2 for Power Relay, must match with Power supply volts) | DIN Rail Mount 4 DPDT Signal Relay Interface Module, DC 12V (Option 2 for Power Relay, must match with Power supply volts)

Meter

Unit

### Page 46 of 91

83

84

Cut the other
end of the 7th
Red Wire.
Ensure the
length of the
wire will reach
the Barrier
Strip around
4"-5"
Name | Description | Metric Conversion | Unit of Measure
Bracket Holder Carrier Clips/Barrier Strip | PCB DIN Rail Mounting Adapter Circuit Board Mounting Bracket Holder, Carrier Clips, for 35mm, 15mm DIN Rail (Green) | PCB DIN Rail Mounting Adapter Circuit Board Mounting Bracket Holder, Carrier Clips, for 35mm, 15mm DIN Rail (Green)
Electrical Stranded Wire | 22AWG Stranded Wire (Multiple Colors) | 22AWG Stranded Wire (Multiple Colors)

Unit

Meter

Wire
Stripper

Strip the tip of
the 8th Red
wire
Name | Description | Metric Conversion | Unit of Measure
Electrical Stranded Wire | 22AWG Stranded Wire (Multiple Colors) | 22AWG Stranded Wire (Multiple Colors) | Meter

### Page 47 of 91

85

86

Connect a 8th
Red Wire into
the power
input using the
4th common
terminal of the
Power Relay
Interface
Board. This
connection is
for the fan
Name | Description | Metric Conversion | Unit of Measure
Electrical Stranded Wire | 22AWG Stranded Wire (Multiple Colors) | 22AWG Stranded Wire (Multiple Colors)
Power Relay Interface 12V | DIN Rail Mount 4 DPDT Signal Relay Interface Module, DC 12V (Option 2 for Power Relay, must match with Power supply volts) | DIN Rail Mount 4 DPDT Signal Relay Interface Module, DC 12V (Option 2 for Power Relay, must match with Power supply volts)

Meter

Unit

Screwdriver

Tighten the
screw of the
8th red wire in
place
Name | Description | Metric Conversion | Unit of Measure
Electrical Stranded Wire | 22AWG Stranded Wire (Multiple Colors) | 22AWG Stranded Wire (Multiple Colors)
Power Relay Interface 12V | DIN Rail Mount 4 DPDT Signal Relay Interface Module, DC 12V (Option 2 for Power Relay, must match with Power supply volts) | DIN Rail Mount 4 DPDT Signal Relay Interface Module, DC 12V (Option 2 for Power Relay, must match with Power supply volts)

Meter

Unit

### Page 48 of 91

87

88

Wire Cutter
Pliers

Cut the other
end of the 8th
Red Wire.
Ensure the
length of the
wire will reach
the Barrier
Strip around
4"-5"
Name | Description | Metric Conversion | Unit of Measure
Bracket Holder Carrier Clips/Barrier Strip | PCB DIN Rail Mounting Adapter Circuit Board Mounting Bracket Holder, Carrier Clips, for 35mm, 15mm DIN Rail (Green) | PCB DIN Rail Mounting Adapter Circuit Board Mounting Bracket Holder, Carrier Clips, for 35mm, 15mm DIN Rail (Green)
Electrical Stranded Wire | 22AWG Stranded Wire (Multiple Colors) | 22AWG Stranded Wire (Multiple Colors)

Unit

Meter

Wire
Stripper

Strip the other
ends of the
5th-8th Red
Wires.
Name | Description | Metric Conversion | Unit of Measure
Electrical Stranded Wire | 22AWG Stranded Wire (Multiple Colors) | 22AWG Stranded Wire (Multiple Colors) | Meter

### Page 49 of 91

89

90

Connect all
Red Wires(5th
-8th) from the
Power Relay
Interface
Board to the
1st lower
terminal of the
Barrier Strip
Name | Description | Metric Conversion | Unit of Measure
Electrical Stranded Wire | 22AWG Stranded Wire (Multiple Colors) | 22AWG Stranded Wire (Multiple Colors)
Bracket Holder Carrier Clips/Barrier Strip | PCB DIN Rail Mounting Adapter Circuit Board Mounting Bracket Holder, Carrier Clips, for 35mm, 15mm DIN Rail (Green) | PCB DIN Rail Mounting Adapter Circuit Board Mounting Bracket Holder, Carrier Clips, for 35mm, 15mm DIN Rail (Green)

Meter

Unit

Screwdriver

Tighten the
screw of all
Red Wires in
place
Name | Description | Metric Conversion | Unit of Measure
Bracket Holder Carrier Clips/Barrier Strip | PCB DIN Rail Mounting Adapter Circuit Board Mounting Bracket Holder, Carrier Clips, for 35mm, 15mm DIN Rail (Green) | PCB DIN Rail Mounting Adapter Circuit Board Mounting Bracket Holder, Carrier Clips, for 35mm, 15mm DIN Rail (Green)
Electrical Stranded Wire | 22AWG Stranded Wire (Multiple Colors) | 22AWG Stranded Wire (Multiple Colors)

Unit

Meter

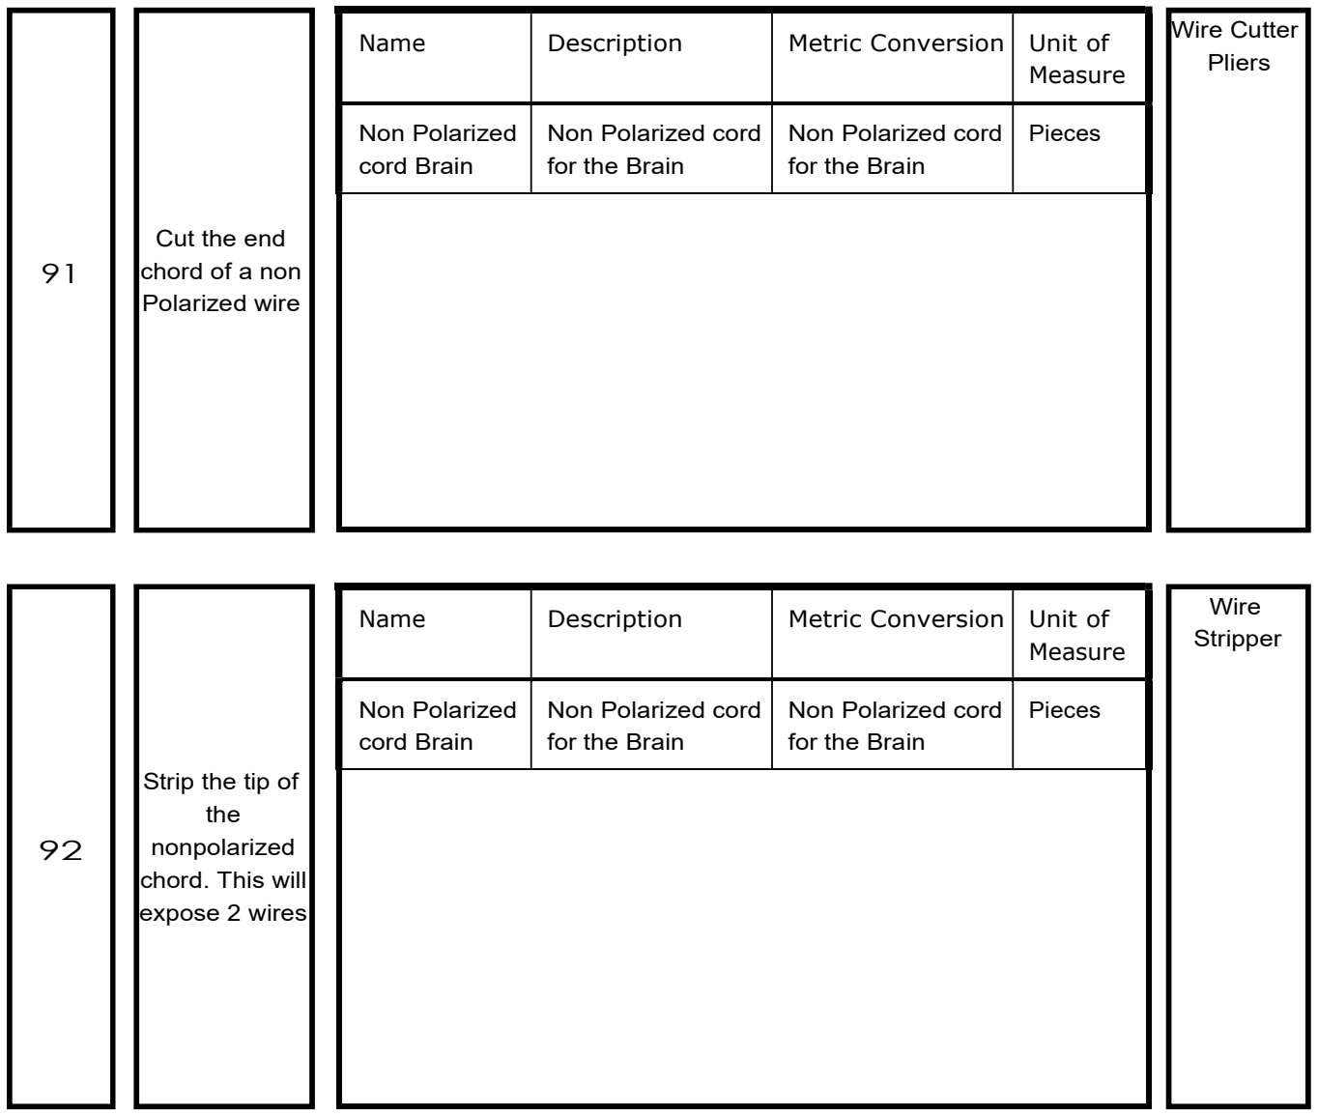
[picture p137: figure]
Wire Cutter Pliers; Cut the end chord of a non Polarized wire; Name; Description; Metric Conversion; Unit of; Measure; Non Polarized cord Brain; Non Polarized cord for the Brain; Pieces; Wire Stripper; Strip the tip of the nonpolarized chord. This will expose 2 wires

### Page 50 of 91

### Page 51 of 91

93

94

Connect one
of the non
polarized wire
into the 3rd
upper Terminal
of the Barrier
Strip
Name | Description | Metric Conversion | Unit of Measure
Bracket Holder Carrier Clips/Barrier Strip | PCB DIN Rail Mounting Adapter Circuit Board Mounting Bracket Holder, Carrier Clips, for 35mm, 15mm DIN Rail (Green) | PCB DIN Rail Mounting Adapter Circuit Board Mounting Bracket Holder, Carrier Clips, for 35mm, 15mm DIN Rail (Green)
Non Polarized cord Brain | Non Polarized cord for the Brain | Non Polarized cord for the Brain

Unit

Pieces

Screwdriver

Tighten the
screw of the
nonpolarized
chord in place
Name | Description | Metric Conversion | Unit of Measure
Bracket Holder Carrier Clips/Barrier Strip | PCB DIN Rail Mounting Adapter Circuit Board Mounting Bracket Holder, Carrier Clips, for 35mm, 15mm DIN Rail (Green) | PCB DIN Rail Mounting Adapter Circuit Board Mounting Bracket Holder, Carrier Clips, for 35mm, 15mm DIN Rail (Green)
Non Polarized cord Brain | Non Polarized cord for the Brain | Non Polarized cord for the Brain

Unit

Pieces

### Page 52 of 91

95

96

Connect the
2nd wire of the
non polarized
chord into the
2nd Terminal
of the 4th
upper Terminal
of the Bracket
Holder Carrier
Clips
Name | Description | Metric Conversion | Unit of Measure
Bracket Holder Carrier Clips/Barrier Strip | PCB DIN Rail Mounting Adapter Circuit Board Mounting Bracket Holder, Carrier Clips, for 35mm, 15mm DIN Rail (Green) | PCB DIN Rail Mounting Adapter Circuit Board Mounting Bracket Holder, Carrier Clips, for 35mm, 15mm DIN Rail (Green)
Non Polarized cord Brain | Non Polarized cord for the Brain | Non Polarized cord for the Brain

Unit

Pieces

Tire wrap all
wires in place
Name | Description | Metric Conversion | Unit of Measure
4" Cable Ties | 4" Black Cable Ties (Bag of 100) | 100mm x 4mm Black Cable Ties (Bag of 100) | Bag

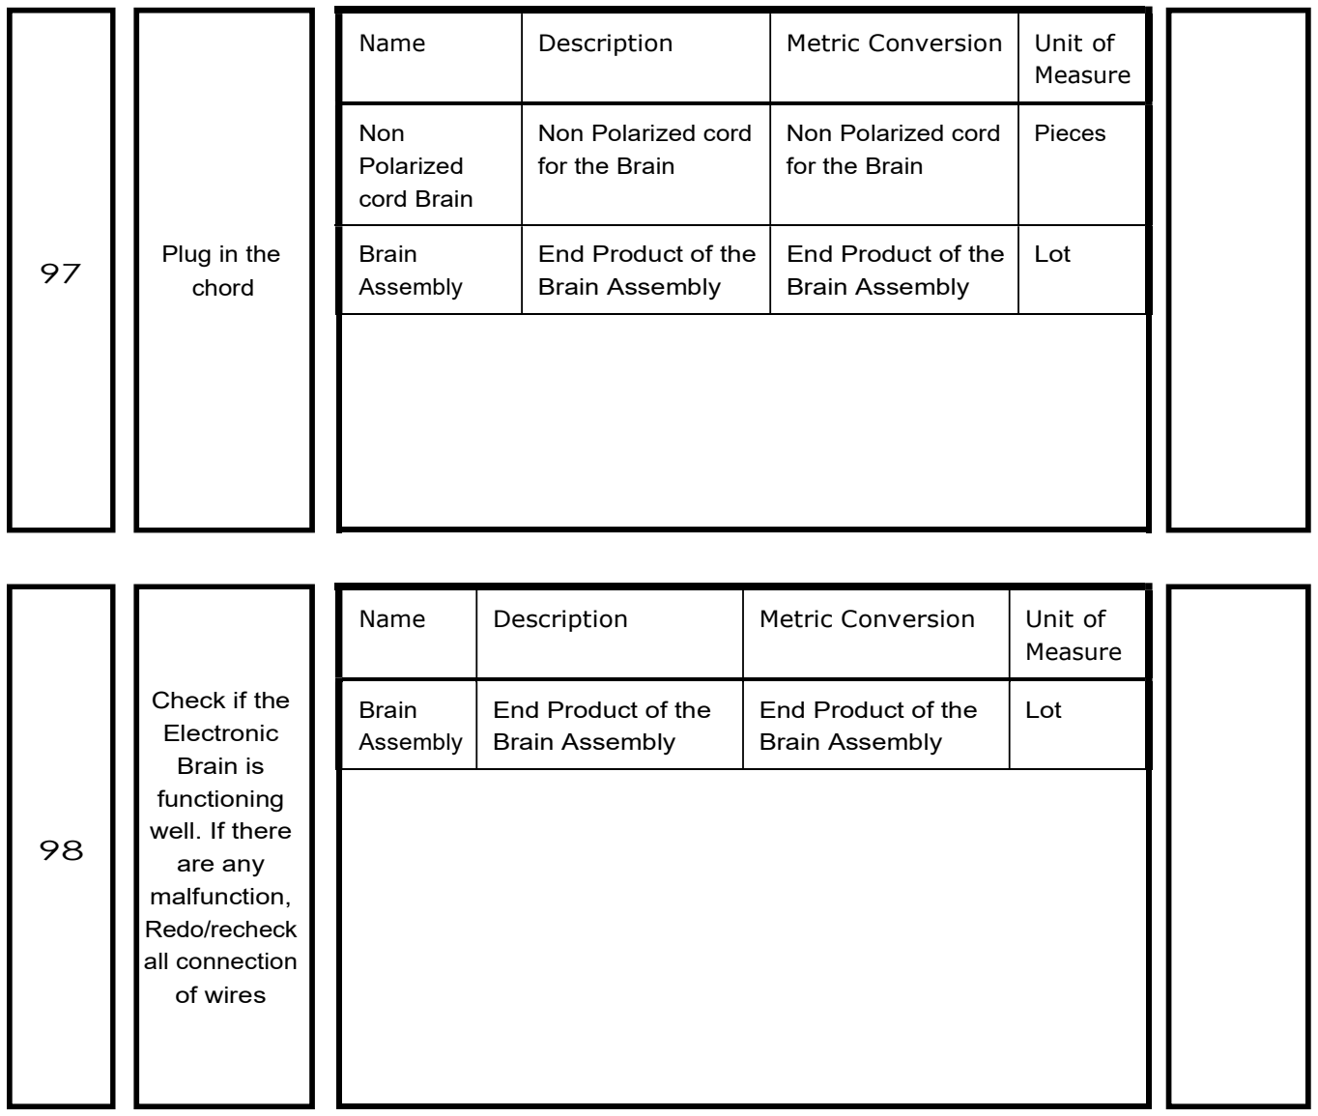
[picture p138: figure]
Plug in the chord; Name; Description; Metric Conversion; Unit of; Measure; Pieces; Lot; Check if the Electronic Brain is functioning well. If there are any malfunction, Redo/recheck all connection of wires; Brain Assembly; End Product of the Brain Assembly

### Page 53 of 91

Non Polarized cord Brain | Non Polarized cord for the Brain | Non Polarized cord for the Brain
Brain Assembly | End Product of the Brain Assembly | End Product of the Brain Assembly

### Page 54 of 91

### Page 55 of 91

99

Name | Description | Metric Conversion | Unit of Measure
DIN Connectors | 3- way and 2 -way Solenoid Valve DIN Connectors | 3- way and 2 - way Solenoid Valve DIN Connectors
3- way Solenoid Valve | 3/8" NPT 3-Way Solenoid Valve, 110 V AC | 10mm FNPT 3 Port 2 Way Solenoid Valve, 110/220 VAC 50/60Hz
2- way Solenoid Valve | 2/2 Direct Acting Solenoid Valve 1/4" ports 110V AC | Direct Acting Solenoid Valve 10mm ports 110/220VAC 50/60Hz

Unit

Unit

Unit

Unscrew all
the DIN
Connectors
from the 3
units of
Solenoid valve

Screwdriver

### Page 56 of 91

100

Name | Description | Metric Conversion | Unit of Measure
2- way Solenoid Valve | 2/2 Direct Acting Solenoid Valve 1/4" ports 110V AC | Direct Acting Solenoid Valve 10mm ports 110/220VAC 50/60Hz | Unit

DIN
Connectors

3- way and 2 - way
Solenoid Valve DIN
Connectors

3- way and 2 - way
Solenoid Valve DIN
Connectors

Unit

DIN
Connectors
Screw
Terminal

3- way and 2 - way
Solenoid Valve DIN
Connectors Screw
Terminal

3- way and 2 - way
Solenoid Valve DIN
Connectors Screw
Terminal

Unit

3- way
Solenoid
Valve

3/8" NPT 3-Way
Solenoid Valve, 110
V AC

10mm FNPT 3 Port 2
Way Solenoid Valve,
110/220 VAC
50/60Hz

Unit

Remove all
Screw
Terminal from
the 3 units DIN
Connectors

Screwdriver

### Page 57 of 91

101

102

Wire
Stripper

Strip
Conductor
wire. This will
expose the red
and black
wires
Name | Description | Metric Conversion
Unit of
Measure
Conductor wire | Conductor wire
Conductor wire | meter

Connect the
red wire into
the right side
of the DIN
Connector
Screw
Terminal
Name | Description | Metric Conversion | Unit of Measure
DIN Connectors Screw Terminal | 3- way and 2 - way Solenoid Valve DIN Connectors Screw Terminal | 3- way and 2 - way Solenoid Valve DIN Connectors Screw Terminal

Conductor wire

Unit

Conductor wire | Conductor wire | meter

### Page 58 of 91

104

Connect the
black wire into
the left side of
the DIN
Connector
Screw
Terminal
Name | Description | Metric Conversion | Unit of Measure
DIN Connectors Screw Terminal | 3- way and 2 - way Solenoid Valve DIN Connectors Screw Terminal | 3- way and 2 - way Solenoid Valve DIN Connectors Screw Terminal

Conductor wire

Unit

Conductor wire | Conductor wire | meter

103

Name | Description | Metric Conversion
Unit of
Measure
Conductor wire | Conductor wire
Conductor wire | meter
Tighten the
screw on the
Red Wire in
place

Screwdriver

### Page 59 of 91

105

106

Screwdriver

Tighten the
screw on the
Black Wire in
place
Name | Description | Metric Conversion | Unit of Measure
DIN Connectors Screw Terminal | 3- way and 2 - way Solenoid Valve DIN Connectors Screw Terminal | 3- way and 2 - way Solenoid Valve DIN Connectors Screw Terminal

Conductor wire

Unit

Conductor wire | Conductor wire | meter

Stretch the
wires into the
PIN
Name | Description | Metric Conversion | Unit of Measure
DIN Connectors Screw Terminal | 3- way and 2 - way Solenoid Valve DIN Connectors Screw Terminal | 3- way and 2 - way Solenoid Valve DIN Connectors Screw Terminal

Conductor wire

Unit

Conductor wire | Conductor wire | meter

### Page 60 of 91

107

108

Strip the other
end of the
conductor wire
into the DIN
connector
Name | Description | Metric Conversion | Unit of Measure
DIN Connectors | 3- way and 2 - way Solenoid Valve DIN Connectors | 3- way and 2 - way Solenoid Valve DIN Connectors

Conductor wire

Unit

Conductor wire | Conductor wire | meter

Do the same
for the other 2
DIN Connector
Screw
Terminals
Name | Description | Metric Conversion | Unit of Measure
DIN Connectors | 3- way and 2 - way Solenoid Valve DIN Connectors | 3- way and 2 - way Solenoid Valve DIN Connectors

Conductor wire

Unit

Conductor wire | Conductor wire | meter

### Page 61 of 91

109

110

Attach all DIN
Connector
Screw
Terminal Back
into their DIN
Connectors
Name | Description | Metric Conversion | Unit of Measure
DIN Connectors | 3- way and 2 - way Solenoid Valve DIN Connectors | 3- way and 2 - way Solenoid Valve DIN Connectors
DIN Connectors Screw Terminal | 3- way and 2 - way Solenoid Valve DIN Connectors Screw Terminal | 3- way and 2 - way Solenoid Valve DIN Connectors Screw Terminal

Conductor wire

Unit

Unit

Conductor wire | Conductor wire | meter

Attach all DIN
Connector
back into their
respective
Solenoid
Valves
Name | Description | Metric Conversion | Unit of Measure
DIN Connectors | 3- way and 2 -way Solenoid Valve DIN Connectors | 3- way and 2 - way Solenoid Valve DIN Connectors
3- way Solenoid Valve | 3/8" NPT 3-Way Solenoid Valve, 110 V AC | 10mm FNPT 3 Port 2 Way Solenoid Valve, 110/220 VAC 50/60Hz

Conductor wire

Unit

Unit

Conductor wire | Conductor wire | meter

### Page 62 of 91

111

112

Wire
Stripper

Strip the other
end of the 3
conductor
wires around
4"
Name | Description | Metric Conversion
Unit of
Measure
Conductor wire | Conductor wire
Conductor wire | meter

Gather all the
black wires of
the conductor
wires
Name | Description | Metric Conversion
Unit of
Measure
Conductor wire | Conductor wire
Conductor wire | meter

### Page 63 of 91

113

114

Connect all
black wires
from the
conductor wire
into the 2nd
lower Terminal
of the Barrier
Strip. This is
for the supply
voltage of the
Power Relay
Interface
Board
Name | Description | Metric Conversion | Unit of Measure
Bracket Holder Carrier Clips/Barrier Strip | PCB DIN Rail Mounting Adapter Circuit Board Mounting Bracket Holder, Carrier Clips, for 35mm, 15mm DIN Rail (Green) | PCB DIN Rail Mounting Adapter Circuit Board Mounting Bracket Holder, Carrier Clips, for 35mm, 15mm DIN Rail (Green)

Conductor wire

Unit

Conductor wire | Conductor wire | meter

Screwdriver

Tighten the
screw of the
Black Wires
from the
conductor wire
in Place
Name | Description | Metric Conversion | Unit of Measure
Bracket Holder Carrier Clips/Barrier Strip | PCB DIN Rail Mounting Adapter Circuit Board Mounting Bracket Holder, Carrier Clips, for 35mm, 15mm DIN Rail (Green) | PCB DIN Rail Mounting Adapter Circuit Board Mounting Bracket Holder, Carrier Clips, for 35mm, 15mm DIN Rail (Green)

Conductor wire

Unit

Conductor wire | Conductor wire | meter

### Page 64 of 91

115

116

Gather all the
red wires from
the conductor
wires
Name | Description | Metric Conversion
Unit of
Measure
Conductor wire | Conductor wire
Conductor wire | meter

Connect the
1st red wire
from the
Conductor
Wire into the
1st Normally
Open section
of the Power
Relay Interface
Board
Name | Description | Metric Conversion | Unit of Measure

Conductor wire

Power Relay Interface 12V | DIN Rail Mount 4 DPDT Signal Relay Interface Module, DC 12V (Option 2 for Power Relay, must match with Power supply volts) | DIN Rail Mount 4 DPDT Signal Relay Interface Module, DC 12V (Option 2 for Power Relay, must match with Power supply volts)
Conductor wire | Conductor wire | meter
| | Unit

### Page 65 of 91

117

118

Screwdriver

Tighten the
screw of the
1st Red Wire
from the
conductor in
Place
Name | Description | Metric Conversion | Unit of Measure

Conductor wire

Power Relay Interface 12V | DIN Rail Mount 4 DPDT Signal Relay Interface Module, DC 12V (Option 2 for Power Relay, must match with Power supply volts) | DIN Rail Mount 4 DPDT Signal Relay Interface Module, DC 12V (Option 2 for Power Relay, must match with Power supply volts)
Conductor wire | Conductor wire | meter
| | Unit

Connect the
2nd red wire
from the
Conductor
Wire into the
2nd Normally
Open section
of the Power
Relay Interface
Board
Name | Description | Metric Conversion | Unit of Measure

Conductor wire

Power Relay Interface 12V | DIN Rail Mount 4 DPDT Signal Relay Interface Module, DC 12V (Option 2 for Power Relay, must match with Power supply volts) | DIN Rail Mount 4 DPDT Signal Relay Interface Module, DC 12V (Option 2 for Power Relay, must match with Power supply volts)
Conductor wire | Conductor wire | meter
| | Unit

### Page 66 of 91

119

120

Screwdriver

Tighten the
screw of the
2nd Red Wire
from the
conductor in
Place
Name | Description | Metric Conversion | Unit of Measure

Conductor wire

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

Connect the
3rd red wire
from the
Conductor
Wire into the
3rdNormally
Open section
of the Power
Relay Interface
Board
Name | Description | Metric Conversion | Unit of Measure

Conductor wire

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

### Page 67 of 91

121

122

Screwdriver

Tighten the
screw of the
3rd Red Wire
from the
conductor in
Place
Name | Description | Metric Conversion | Unit of Measure

Conductor wire

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

Plug in the
Electronic
Brain
Assembly with
the Solenoid
Valves.
Name | Description | Metric Conversion | Unit of Measure
3- way Solenoid Valve | 3/8" NPT 3-Way Solenoid Valve, 110 V AC | 10mm FNPT 3 Port 2 Way Solenoid Valve, 110/220 VAC 50/60Hz
2- way Solenoid Valve | 2/2 Direct Acting Solenoid Valve 1/4" ports 110V AC | Direct Acting Solenoid Valve 10mm ports 110/220VAC 50/60Hz
Brain Assembly | End Product of the Brain Assembly | End Product of the Brain Assembly

Unit

Unit

Lot

### Page 68 of 91

123

Check if the
Electronic
Brain
Assembly is
functioning well
with the
solenoid
valves. Ensure
all
corresponding
lights in the
Power Relay
Interface Board
connected to
the solenoid
valves are
blinking. If
there are any
malfunction,
redo/recheck
all connections
Name | Description | Metric Conversion | Unit of Measure
3- way Solenoid Valve | 3/8" NPT 3-Way Solenoid Valve, 110 V AC | 10mm FNPT 3 Port 2 Way Solenoid Valve, 110/220 VAC 50/60Hz
2- way Solenoid Valve | 2/2 Direct Acting Solenoid Valve 1/4" ports 110V AC | Direct Acting Solenoid Valve 10mm ports 110/220VAC 50/60Hz
Brain Assembly | End Product of the Brain Assembly | End Product of the Brain Assembly

Unit

Unit

Lot

### Page 69 of 91

### Page 70 of 91

124

125

Connect the
cord of the fan
into the fan's
molded
connector
Name | Description | Metric Conversion | Unit of Measure
Cooling Fan | 120V AC 120mm High Speed Cooling Fan | 220/120V AC 120mm High Speed Cooling Fan
Non Polarized cord Fan | Non Polarized cord of the cooling Fan | Non Polarized cord of the cooling Fan

Pieces

Pieces

Scissors/Cutter

Cut the 2 -
prong end of
the cord
Name | Description | Metric Conversion | Unit of Measure
Non Polarized cord Fan | Non Polarized cord of the cooling Fan | Non Polarized cord of the cooling Fan | Pieces

### Page 71 of 91

126

127

Wire
Stripper

Strip the cord
until 2 wires
are exposed
Name | Description | Metric Conversion | Unit of Measure
Non Polarized cord Fan | Non Polarized cord of the cooling Fan | Non Polarized cord of the cooling Fan | Pieces

Connect one
wire of the
Non Polarized
Cord into the
2nd lower
Terminal of the
Barrier Strip
Name | Description | Metric Conversion | Unit of Measure
Non Polarized cord Fan | Non Polarized cord of the cooling Fan | Non Polarized cord of the cooling Fan
Bracket Holder Carrier Clips/Barrier Strip | PCB DIN Rail Mounting Adapter Circuit Board Mounting Bracket Holder, Carrier Clips, for 35mm, 15mm DIN Rail (Green) | PCB DIN Rail Mounting Adapter Circuit Board Mounting Bracket Holder, Carrier Clips, for 35mm, 15mm DIN Rail (Green)

Pieces

Unit

Cooling Fan | 120V AC 120mm | 220/120V AC | Pieces

### Page 72 of 91

128

Name | Description | Metric Conversion | Unit of Measure
Bracket Holder Carrier Clips/Barrier Strip | PCB DIN Rail Mounting Adapter Circuit Board Mounting Bracket Holder, Carrier Clips, for 35mm, 15mm DIN Rail (Green) | PCB DIN Rail Mounting Adapter Circuit Board Mounting Bracket Holder, Carrier Clips, for 35mm, 15mm DIN Rail (Green)
Cooling Fan | 120V AC 120mm High Speed Cooling Fan | 220/120V AC 120mm High Speed Cooling Fan
Non Polarized cord Fan | Non Polarized cord of the cooling Fan | Non Polarized cord of the cooling Fan

Unit

Pieces

Pieces

Tighten the
screw of the
non polarized
wire

Screwdriver

### Page 73 of 91

129

Connect the
2nd wire of the
Non Polarized
cord into the
normally open
4th terminal in
the Power
Relay Interface
Board
Name | Description | Metric Conversion | Unit of Measure
Non Polarized cord Fan | Non Polarized cord of the cooling Fan | Non Polarized cord of the cooling Fan | Pieces

Cooling
Fan

120V AC 120mm High
Speed Cooling Fan

220/120V AC 120mm
High Speed Cooling
Fan

Pieces

Power
Relay
Interface
12V

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

Unit

### Page 74 of 91

130

Name | Description | Metric Conversion | Unit of Measure
Non Polarized cord Fan | Non Polarized cord of the cooling Fan | Non Polarized cord of the cooling Fan
Cooling Fan | 120V AC 120mm High Speed Cooling Fan | 220/120V AC 120mm High Speed Cooling Fan
Power Relay Interface 5V | DIN Rail Mount 4 Relay Interface Module, DC 5V Version (Option 1 for Power Relay, must match with Power supply volts) | DIN Rail Mount 4 Relay Interface Module, DC 5V Version (Option 1 for Power Relay, must match with Power supply volts)

Pieces

Pieces

Unit

Tighten the
screw of the
non polarized
wire

Screwdriver

### Page 75 of 91

131

Name | Description | Metric Conversion | Unit of Measure
Brain Assembly | End Product of the Brain Assembly | End Product of the Brain Assembly
Cooling Fan | 120V AC 120mm High Speed Cooling Fan | 220/120V AC 120mm High Speed Cooling Fan
3- way Solenoid Valve | 3/8" NPT 3-Way Solenoid Valve, 110 V AC | 10mm FNPT 3 Port 2 Way Solenoid Valve, 110/220 VAC 50/60Hz
2- way Solenoid Valve | 2/2 Direct Acting Solenoid Valve 1/4" ports 110V AC | Direct Acting Solenoid Valve 10mm ports 110/220VAC 50/60Hz

Lot

Pieces

Unit

Unit

Plug in the
Electronic
Brain
Assembly with
the valve and
fan.

### Page 76 of 91

132

Name | Description | Metric Conversion | Unit of Measure
Brain Assembly | End Product of the Brain Assembly | End Product of the Brain Assembly
Cooling Fan | 120V AC 120mm High Speed Cooling Fan | 220/120V AC 120mm High Speed Cooling Fan
3- way Solenoid Valve | 3/8" NPT 3-Way Solenoid Valve, 110 V AC | 10mm FNPT 3 Port 2 Way Solenoid Valve, 110/220 VAC 50/60Hz
2- way Solenoid Valve | 2/2 Direct Acting Solenoid Valve 1/4" ports 110V AC | Direct Acting Solenoid Valve 10mm ports 110/220VAC 50/60Hz

Lot

Pieces

Unit

Unit

Check if fan is
functioning
well. Ensure all
corresponding
lights in the
Power Relay
Interface
Board
connected to
the fan is
blinking. If
there are any
malfunction,
Redo/recheck
all connection
of wires

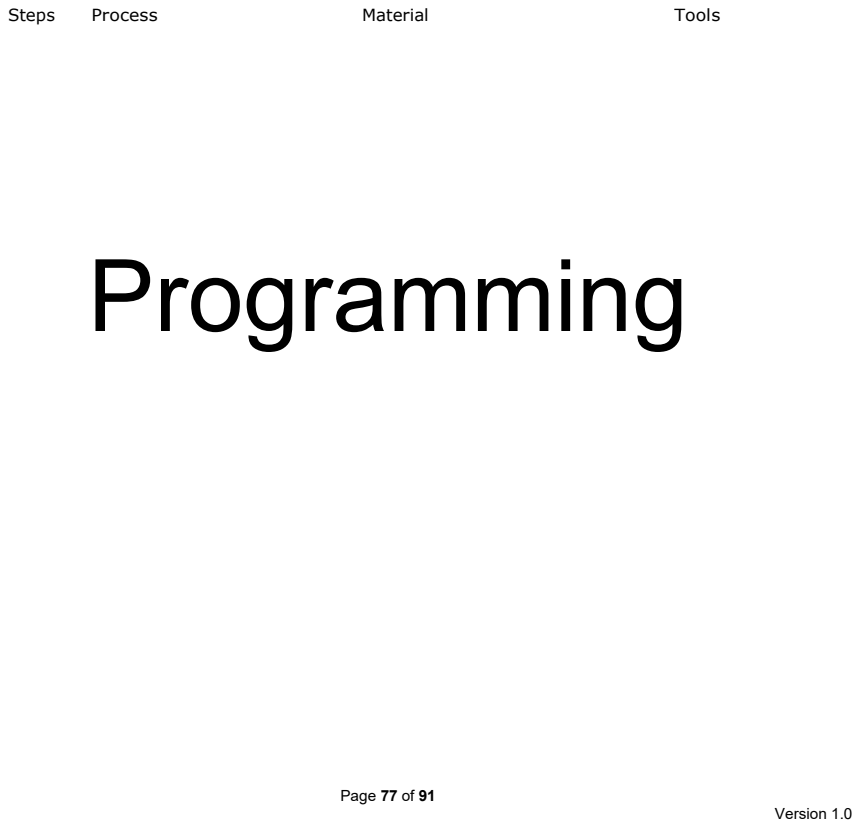
[picture p139: page 77]
Page 77 of 91

### Page 78 of 91

133

134

Remove
Arduino IoT 33
from the
Terminal Block
Breakout
Shield
Name | Description | Metric Conversion | Unit of Measure
Arduino 33 IoT | Arduino 33 IoT (Option 1 for Arduino Processor) | Arduino 33 IoT (Option 1 for Arduino Processor)
Terminal Block Breakout Shield Nano/Micro | DIN Rail Mount Screw Terminal Block Breakout Module Board for Arduino Nano/Micro. (Option 2 for Arduino Terminal Adaptor must match Arduino Processor) | DIN Rail Mount Screw Terminal Block Breakout Module Board for Arduino Nano/Micro. (Option 2 for Arduino Terminal Adaptor must match Arduino Processor)

Unit

Unit

USB Cable
for Nano

Connect
Arduino IoT33
into the
computer
Name | Description | Metric Conversion | Unit of Measure
Computer | Computer | Computer
Arduino 33 IoT | Arduino 33 IoT (Option 1 for Arduino Processor) | Arduino 33 IoT (Option 1 for Arduino Processor)

Unit

### Page 79 of 91

135

136

USB Cable
for Nano

Go to
Arduino.cc to
download the
software
Name | Description | Metric Conversion | Unit of Measure
Computer | Computer | Computer
Arduino 33 IoT | Arduino 33 IoT (Option 1 for Arduino Processor) | Arduino 33 IoT (Option 1 for Arduino Processor)
Unit

USB Cable
for Nano

Click Software
Tab
Name | Description | Metric Conversion | Unit of Measure
Computer | Computer | Computer
Arduino 33 IoT | Arduino 33 IoT (Option 1 for Arduino Processor) | Arduino 33 IoT (Option 1 for Arduino Processor)

Unit

### Page 80 of 91

137

138

USB Cable
for Nano

Click
Download.
Name | Description | Metric Conversion | Unit of Measure
Computer | Computer | Computer
Arduino 33 IoT | Arduino 33 IoT (Option 1 for Arduino Processor) | Arduino 33 IoT (Option 1 for Arduino Processor)
Unit

USB Cable
for Nano

Click the
Arduino
software that
is applicable to
your OS
Name | Description | Metric Conversion | Unit of Measure
Computer | Computer | Computer
Arduino 33 IoT | Arduino 33 IoT (Option 1 for Arduino Processor) | Arduino 33 IoT (Option 1 for Arduino Processor)

Unit

### Page 81 of 91

139

140

USB Cable
for Nano

Click Just
Download
Name | Description | Metric Conversion | Unit of Measure
Computer | Computer | Computer
Arduino 33 IoT | Arduino 33 IoT (Option 1 for Arduino Processor) | Arduino 33 IoT (Option 1 for Arduino Processor)
Unit

USB Cable
for Nano

Click the
downloaded
Software
Name | Description | Metric Conversion | Unit of Measure
Computer | Computer | Computer
Arduino 33 IoT | Arduino 33 IoT (Option 1 for Arduino Processor) | Arduino 33 IoT (Option 1 for Arduino Processor)

Unit

### Page 82 of 91

141

142

USB Cable
for Nano

Start the
Installation and
click Run
Name | Description | Metric Conversion | Unit of Measure
Computer | Computer | Computer
Arduino 33 IoT | Arduino 33 IoT (Option 1 for Arduino Processor) | Arduino 33 IoT (Option 1 for Arduino Processor)
Unit

USB Cable
for Nano

Agree to the
Terms and
Conditions
Name | Description | Metric Conversion | Unit of Measure
Computer | Computer | Computer
Arduino 33 IoT | Arduino 33 IoT (Option 1 for Arduino Processor) | Arduino 33 IoT (Option 1 for Arduino Processor)

Unit

### Page 83 of 91

143

144

USB Cable
for Nano

Install the
Software
Name | Description | Metric Conversion | Unit of Measure
Computer | Computer | Computer
Arduino 33 IoT | Arduino 33 IoT (Option 1 for Arduino Processor) | Arduino 33 IoT (Option 1 for Arduino Processor)
Unit

USB Cable
for Nano

Obtain the
Arduino code
from Oxikit
team
Name | Description | Metric Conversion | Unit of Measure
Computer | Computer | Computer
Arduino 33 IoT | Arduino 33 IoT (Option 1 for Arduino Processor) | Arduino 33 IoT (Option 1 for Arduino Processor)

Unit

### Page 84 of 91

145

146

USB Cable
for Nano

Click the
Arduino code
Name | Description | Metric Conversion | Unit of Measure
Computer | Computer | Computer
Arduino 33 IoT | Arduino 33 IoT (Option 1 for Arduino Processor) | Arduino 33 IoT (Option 1 for Arduino Processor)
Unit

USB Cable
for Nano

Go to File Tab

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

Unit

### Page 85 of 91

147

148

USB Cable
for Nano

Click Examples

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

USB Cable
for Nano

Click 0.1 Basics

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

Unit

### Page 86 of 91

149

150

USB Cable
for Nano

Click Blink

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

USB Cable
for Nano

Go to the Tools
Tab
Name | Description | Metric Conversion | Unit of Measure
Computer | Computer | Computer
Arduino 33 IoT | Arduino 33 IoT (Option 1 for Arduino Processor) | Arduino 33 IoT (Option 1 for Arduino Processor)

Unit

### Page 87 of 91

151

152

USB Cable
for Nano

Click the
Board:
"Arduino NANO

### 33 IoT"

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

USB Cable
for Nano

Click Arduino
NANO 33 IoT
Name | Description | Metric Conversion | Unit of Measure
Computer | Computer | Computer
Arduino 33 IoT | Arduino 33 IoT (Option 1 for Arduino Processor) | Arduino 33 IoT (Option 1 for Arduino Processor)

Unit

### Page 88 of 91

153

154

USB Cable
for Nano

Go back to the
Tools Tab
Name | Description | Metric Conversion | Unit of Measure
Computer | Computer | Computer
Arduino 33 IoT | Arduino 33 IoT (Option 1 for Arduino Processor) | Arduino 33 IoT (Option 1 for Arduino Processor)
Unit

USB Cable
for Nano

Click Port:
"COM2
(Arduino
NANO 33 IoT)"
Name | Description | Metric Conversion | Unit of Measure
Computer | Computer | Computer
Arduino 33 IoT | Arduino 33 IoT (Option 1 for Arduino Processor) | Arduino 33 IoT (Option 1 for Arduino Processor)

Unit

### Page 89 of 91

155

156

USB Cable
for Nano

Click COM2
(Arduino
NANO 33 IoT)
Name | Description | Metric Conversion | Unit of Measure
Computer | Computer | Computer
Arduino 33 IoT | Arduino 33 IoT (Option 1 for Arduino Processor) | Arduino 33 IoT (Option 1 for Arduino Processor)
Unit

USB Cable
for Nano

Go Back to the
Main Screen
Name | Description | Metric Conversion | Unit of Measure
Computer | Computer | Computer
Arduino 33 IoT | Arduino 33 IoT (Option 1 for Arduino Processor) | Arduino 33 IoT (Option 1 for Arduino Processor)

Unit

### Page 90 of 91

157

158

USB Cable
for Nano

Click Program.
(Arrow facing
to the right,
located in the
upper left
section of the
screen)
Name | Description | Metric Conversion | Unit of Measure
Computer | Computer | Computer
Arduino 33 IoT | Arduino 33 IoT (Option 1 for Arduino Processor) | Arduino 33 IoT (Option 1 for Arduino Processor)

Unit

USB Cable
for Nano

A prompt
message will
appear "Done
uploading." in
the status bar.
Name | Description | Metric Conversion | Unit of Measure
Computer | Computer | Computer
Arduino 33 IoT | Arduino 33 IoT (Option 1 for Arduino Processor) | Arduino 33 IoT (Option 1 for Arduino Processor)

Unit

### Page 91 of 91

159

160

USB Cable
for Nano

Unplug the
Arduino IoT 33
Name | Description | Metric Conversion | Unit of Measure
Computer | Computer | Computer
Arduino 33 IoT | Arduino 33 IoT (Option 1 for Arduino Processor) | Arduino 33 IoT (Option 1 for Arduino Processor)

Unit

USB Cable
for Nano

Hook the
Arduino IoT 33
into the
Terminal Block
Breakout
Shield
Name | Description | Metric Conversion | Unit of Measure
Computer | Computer | Computer
Arduino 33 IoT | Arduino 33 IoT (Option 1 for Arduino Processor) | Arduino 33 IoT (Option 1 for Arduino Processor)

Unit
