OxiKit/oxygen-concentrator-how-to-diy-open-source/Sieve Canister Assembly - WorkFlow.pdf

www.oxikit.com
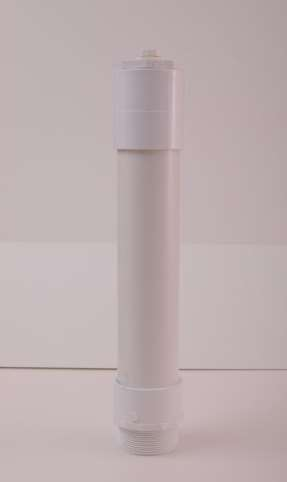
[picture p140: figure]

## Page 1 of 39 Version 1.0

# Sieve Canister WorkFlow

## Version 1.0

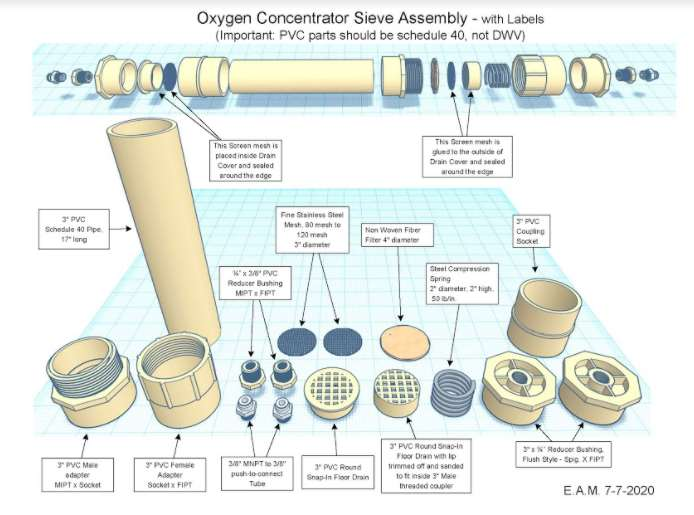
[picture p141: figure]

## Page 2 of 39

Document # | Date Effective

# OXIKIT-SC001

### Supersedes Document Version #:

## OXIKIT WORKFLOW

### Document Title

# Sieve Canister Assembly

## Change History Log:

VERSION # | REVISION DATE | DESCRIPTION OF CHANGE
FROM | TO
1.0 | 11/27/2020 | Original Release

## I. Purpose: This Workflow is intended to serve as a guide in assembling one of the main components of the Oxikit, the Sieve Canister Tank. The tank serves as Vessel that contains Zeolite and converts air from the air compressor into a concentrated oxygen

and releases Nitrogen into the air.

II. | Scope: This guideline applies to all individuals who wish to build the DIY Oxikit. It includes the Materials, tools and the Video Link needed in assembling the Sieve Assembly..
III. | Picture:

## Page 3 of 39

## Fig 1.0 (Sieve Canister Assembly)

Document # | Date Effective

# OXIKIT-SC001

### Supersedes Document Version #:

## OXIKIT WORKFLOW

### Document Title

# Sieve Canister Assembly

## Figure 1 describes the parts needed to assemble the Sieve Canister Assembly

## IV. Safety Operating Conditions: - Always wear protective gloves, googles and mask. Please refer to MSDS for

proper handling of Zeolite.

## V. Workflows - Please see next page for the step by step guidelines in making the Sieve

Canister Assembly.

Step | Process | Materiel | Tools | Youtube Link

1

Insert the Stainless Steel Woven Wire (same size with

the ID of Drain Cover)) into the PVC Drain Cover. Using another

PVC Fitting that
loosely fits inside
the Drain Cover,
slowly push the Stainless Steel Woven Wire

inside the PVC Drain Cover. Slowly push the Stainless Steel Woven Wire

inside the PVC

Name | Description | Metric Conversion | Unit of Measure
Stainless Steel Woven Wire | 304 Stainless Steel Woven Wire 80 Mesh 0.18mm Hole | 304 Stainless Steel Woven Wire 80 Mesh 0.18mm Hole
PVC Drain Cover | PVC 3 in. Round Snap-In Floor Drain | PVC 75mm Round Snap-In Floor Drain

Piece

Piece

## https://www.y outube.com/ watch?v=2U 1sdMwJ1gE &list=PL4O1 RQEiLpHBJ0 i1zqe-CZk1p_NTtG l76&index=2

2

### Place a little dab of Super Glue (every half inch) on the edges of the Stainless Steel Woven Wire

Name | Description | Metric Conversion | Unit of Measure
Stainless Steel Woven Wire | 304 Stainless Steel Woven Wire 80 Mesh 0.18mm Hole | 304 Stainless Steel Woven Wire 80 Mesh 0.18mm Hole
PVC Drain Cover | PVC 3 in. Round Snap-In Floor Drain | PVC 75mm Round Snap-In Floor Drain

Piece

Piece

Super Glue | Super Glue | Super Glue | piece

## https://www.y outube.com/ watch?v=2U 1sdMwJ1gE &list=PL4O1 RQEiLpHBJ0 i1zqe-CZk1p_NTtG l76&index=2

Step | Process | Material | Tools Youtube link

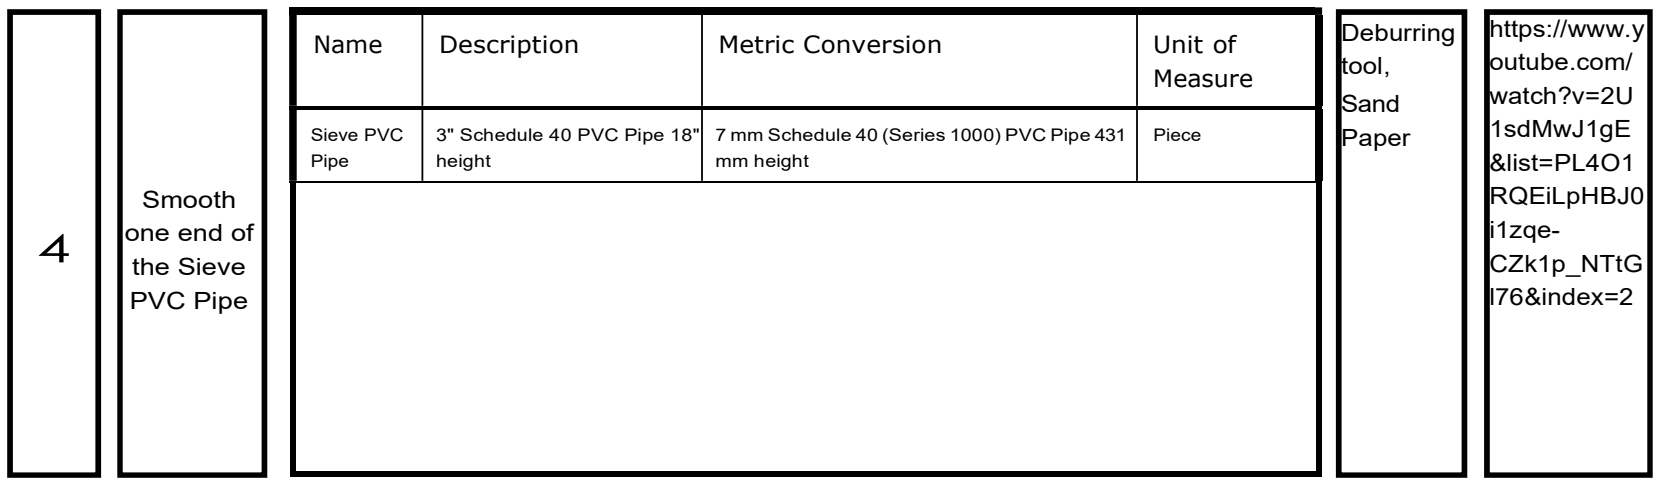
[picture p142: figure]
Smooth one end of the Sieve PVC Pipe; Measure; Sieve PVC Pipe; 3" Schedule 40 PVC Pipe 18" height; mm height; Piece; Deburring tool, Sand Paper; https://www.y outube.com/ watch?v=2U 1sdMwJ1gE &list=PL4O1 RQEiLpHBJ0 i1zqe- CZk1p_NTtG l76&index=2

## Page 5 of 39

3

## Let it dry for a few minutes

Name | Description | Metric Conversion | Unit of Measure

PVC Drain Cover
- Trimmed with
Wire | 3" Round Snap-In Floor Drain - Trimmed with Stainless Steel Woven Wire | PVC 75mm Round Snap-In Floor Drain - -Trimmed with Stainless Steel Woven Wire | Piece

## https://www.y outube.com/ watch?v=2U 1sdMwJ1gE &list=PL4O1 RQEiLpHBJ0 i1zqe-CZk1p_NTtG l76&index=2

Name | Description | Metric Conversion | Unit of

### 7 mm Schedule 40 (Series 1000) PVC Pipe 431

Step | Process | Material | Tools Youtube link

## Page 6 of 39

5

## Put glue on the PVC Coupling socket and the Sieve

PVC Pipe.

## Put a large amount of glue on the outside portion of the Male

end,

## around

50mm

## (Sieve PVC Pipe) and less on the inside of the female end (PVC Coupling

Socket).

Name | Description | Metric Conversion | Unit of Measure
PVC Coupling Socket | 3" Sch 40 PVC Coupling - Socket | 75mm Sch 40 (Series 1000) PVC Coupling - Socket
Sieve PVC Pipe | 3" Schedule 40 PVC Pipe 18" height | 7 mm Schedule 40 (Series 1000) PVC Pipe 431 mm height
PVC Glue | Gorilla PVC Cement 8 oz. R1584C Medium Body PrimaGlue, One-Step | Gorilla PVC Cement 230ml R1584C Medium Body PrimaGlue, One-Step

Piece

Piece

Ounce

## https://www .youtube.co m/watch?v= 2U1sdMwJ 1gE&list=P L4O1RQEiL pHBJ0i1zqe -CZk1p_NTt

## Gl76&index

=2

Step | Process | Material | Tools Youtube link

## Page 7 of 39

6

## Place the PVC Coupling socket on top of the

PVC Pipe.

## Put a little bit of pressure to connect

the parts.

Name | Description | Metric Conversion | Unit of Measure
PVC Coupling Socket | 3" Sch 40 PVC Coupling -Socket | 75mm Sch 40 (Series 1000) PVC Coupling -Socket
Sieve PVC Pipe | 3" Schedule 40 PVC Pipe 18" height | 7 mm Schedule 40 (Series 1000) PVC Pipe 431 mm height

Piece

Piece

## https://www.y outube.com/ watch?v=2U 1sdMwJ1gE &list=PL4O1 RQEiLpHBJ0 i1zqe-CZk1p_NTtG l76&index=2

7

## Wipe any excess glue on the PVCs connected

Name | Description | Metric Conversion | Unit of Measure
PVC Coupling Socket | 3" Sch 40 PVC Coupling -Socket | 75mm Sch 40 (Series 1000) PVC Coupling -Socket
Sieve PVC Pipe | 3" Schedule 40 PVC Pipe 18" height | 7 mm Schedule 40 (Series 1000) PVC Pipe 431 mm height

Piece

Piece

## https://www.y outube.com/ watch?v=2U 1sdMwJ1gE &list=PL4O1 RQEiLpHBJ0 i1zqe-CZk1p_NTtG l76&index=2

Step | Process | Material | Tools Youtube link

## Page 8 of 39

8

## Let it dry for a few minutes

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

Piece

Piece

## https://www.y outube.com/ watch?v=2U 1sdMwJ1gE &list=PL4O1 RQEiLpHBJ0 i1zqe-CZk1p_NTtG l76&index=2

9

Inspect if the
PVC Drain
Cover will fit
inside the
PVC
Coupling
Socket. If
not, smooth
the edges of
the lip of the
Drain Cover
Name | Description | Metric Conversion | Unit of Measure
Stainless Steel Woven Wire | 304 Stainless Steel Woven Wire 80 Mesh 0.18mm Hole | 304 Stainless Steel Woven Wire 80 Mesh 0.18mm Hole
PVC Drain Cover | PVC 3 in. Round Snap-In Floor Drain | PVC 75mm Round Snap-In Floor Drain
PVC Coupling Socket | 3" Sch 40 PVC Coupling - Socket | 75mm Sch 40 (Series 1000) PVC Coupling - Socket

Piece

Piece

Piece

## https://www.y outube.com/ watch?v=2U 1sdMwJ1gE &list=PL4O1 RQEiLpHBJ0 i1zqe-CZk1p_NTtG l76&index=2

Step | Process | Material | Tools Youtube link

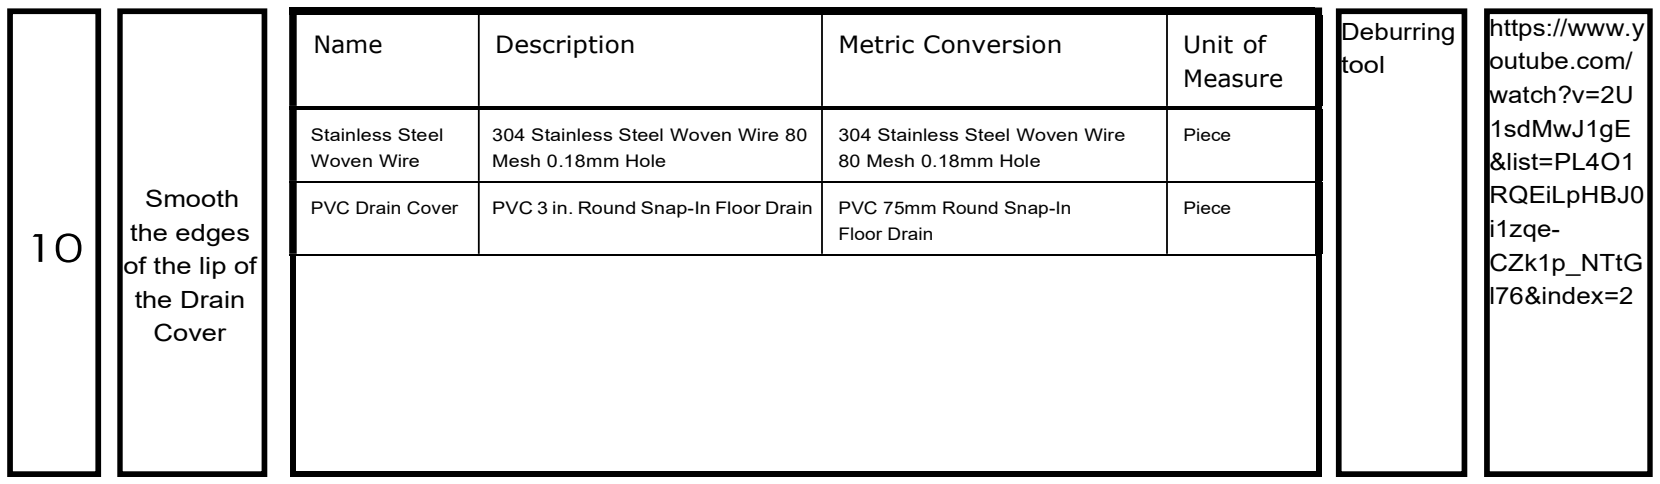
[picture p143: figure]
Smooth the edges of the lip of the Drain Cover; Measure; Piece; Deburring tool; https://www.y outube.com/ watch?v=2U 1sdMwJ1gE &list=PL4O1 RQEiLpHBJ0 i1zqe- CZk1p_NTtG l76&index=2

## Page 9 of 39

Name | Description | Metric Conversion | Unit of
Stainless Steel Woven Wire | 304 Stainless Steel Woven Wire 80 Mesh 0.18mm Hole | 304 Stainless Steel Woven Wire 80 Mesh 0.18mm Hole
PVC Drain Cover | PVC 3 in. Round Snap-In Floor Drain | PVC 75mm Round Snap-In Floor Drain

11

### Place the PVC Drain Cover with the Stainless Steel Woven Wire inside the PVC Coupling Socket until it bottoms

out.

Name | Description | Metric Conversion | Unit of Measure
Stainless Steel Woven Wire | 304 Stainless Steel Woven Wire 80 Mesh 0.18mm Hole | 304 Stainless Steel Woven Wire 80 Mesh 0.18mm Hole
PVC Drain Cover | PVC 3 in. Round Snap-In Floor Drain
PVC Coupling Socket | 3" Sch 40 PVC Coupling - Socket | 75mm Sch 40 (Series 1000) PVC Coupling - Socket
Sieve PVC Pipe | 3" Schedule 40 PVC Pipe 18" height | 7 mm Schedule 40 (Series 1000) PVC Pipe 431 mm height

Piece

PVC 75mm Round Snap-In Floor Drain Piece

Piece

Piece

## https://www.y outube.com/ watch?v=2U 1sdMwJ1gE &list=PL4O1 RQEiLpHBJ0 i1zqe-CZk1p_NTtG l76&index=2

Step | Process | Material | Tools Youtube link

## Page 10 of 39

12

## Put glue on the PVC Reducer Busing

Flush Style,

## and the PVC Coupling Socket (with the PVC Drain Cover inside). Put a large amount of glue on the outside portion of the Male end (PVC Reducer Busing Flush Style) and less on the inside of the female end (PVC Coupling

Socket).

Name | Description | Metric Conversion | Unit of Measure
Stainless Steel Woven Wire | 304 Stainless Steel Woven Wire 80 Mesh 0.18mm Hole | 304 Stainless Steel Woven Wire 80 Mesh 0.18mm Hole
PVC Drain Cover | PVC 3 in. Round Snap-In Floor Drain
PVC Coupling Socket | 3" Sch 40 PVC Coupling - Socket | 75mm Sch 40 (Series 1000) PVC Coupling - Socket
Sieve PVC Pipe | 3" Schedule 40 PVC Pipe 18" height | 7 mm Schedule 40 (Series 1000) PVC Pipe 431 mm height
PVC Reducer Busing Flush Style | 3" x 3/4" Sch 40 PVC Reducer Bushing Flush Style - Spig x Fipt | 75mm x 20mm Sch 40 (Series 1000) PVC Reducer Bushing Flush Style - Spig x Fipt
PVC Glue | Gorilla PVC Cement 8 oz. R1584C Medium Body PrimaGlue, One-Step | Gorilla PVC Cement 230ml R1584C Medium Body PrimaGlue, One-Step

Piece

PVC 75mm Round Snap-In Floor Drain Piece

Piece

Piece

Piece

Ounce

## https://www .youtube.co m/watch?v =2U1sdMw J1gE&list= PL4O1RQE iLpHBJ0i1z

qe-

## CZk1p_NTt Gl76&index

=2

Step | Process | Material | Tools Youtube link

## Page 11 of 39

13

## Place the PVC Reducer Bushing Flush Style on top of the PVC Coupling

Socket.

## Put a little bit of pressure to connect

the parts.

Name | Description | Metric Conversion | Unit of Measure
Stainless Steel Woven Wire | 304 Stainless Steel Woven Wire 80 Mesh 0.18mm Hole | 304 Stainless Steel Woven Wire 80 Mesh 0.18mm Hole
PVC Drain Cover | PVC 3 in. Round Snap-In Floor Drain
PVC Coupling Socket | 3" Sch 40 PVC Coupling -Socket | 75mm Sch 40 (Series 1000) PVC Coupling - Socket
Sieve PVC Pipe | 3" Schedule 40 PVC Pipe 18" height | 7 mm Schedule 40 (Series 1000) PVC Pipe 431 mm height
PVC Reducer Busing Flush Style | 3" x 3/4" Sch 40 PVC Reducer Bushing Flush Style - Spig x Fipt | 75mm x 20mm Sch 40 (Series 1000) PVC Reducer Bushing Flush Style - Spig x Fipt

Piece

PVC 75mm Round Snap-In Floor Drain | Piece

Piece

Piece

Piece

## https://www .youtube.co m/watch?v =2U1sdMw J1gE&list= PL4O1RQ EiLpHBJ0i 1zqe-CZk1p_NTt Gl76&index

=2

Step | Process | Material | Tools Youtube link

## Page 12 of 39

14

## Wipe any excess glue on the PVC

Name | Description | Metric Conversion | Unit of Measure
Stainless Steel Woven Wire | 304 Stainless Steel Woven Wire 80 Mesh 0.18mm Hole | 304 Stainless Steel Woven Wire 80 Mesh 0.18mm Hole
PVC Drain Cover | PVC 3 in. Round Snap-In Floor Drain
PVC Coupling Socket | 3" Sch 40 PVC Coupling -Socket | 75mm Sch 40 (Series 1000) PVC Coupling - Socket
Sieve PVC Pipe | 3" Schedule 40 PVC Pipe 18" height | 7 mm Schedule 40 (Series 1000) PVC Pipe 431 mm height
PVC Reducer Busing Flush Style | 3" x 3/4" Sch 40 PVC Reducer Bushing Flush Style - Spig x Fipt | 75mm x 20mm Sch 40 (Series 1000) PVC Reducer Bushing Flush Style - Spig x Fipt

Piece

PVC 75mm Round Snap-In Floor Drain | Piece

Piece

Piece

Piece

Towel/Tissue | Towel/Tissue | Towel/Tissue | roll

## https://ww w.youtub e.com/wa tch?v=2U 1sdMwJ1 gE&list=P L4O1RQ EiLpHBJ0 i1zqe-CZk1p_N TtGl76&in dex=2

Step | Process | Material | Tools Youtube link

## Page 13 of 39

### 15 Let it dry

overnight

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

Piece

PVC 75mm Round Snap-In Floor Drain | Piece

Piece

Piece

Piece

## https://ww w.youtub e.com/wa tch?v=2U 1sdMwJ1 gE&list=P L4O1RQ EiLpHBJ0 i1zqe-CZk1p_N TtGl76&in dex=2

Step Process | Material | Tools Youtube link

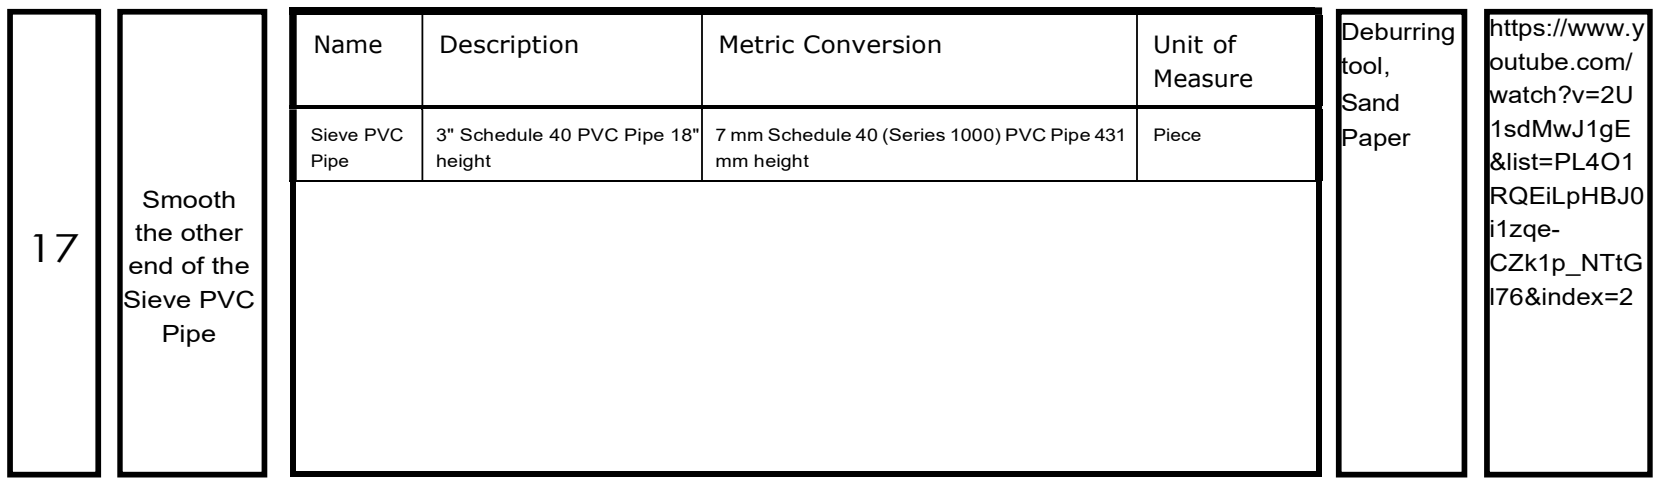
[picture p144: figure]
Smooth the other end of the Sieve PVC Pipe; Measure; Sieve PVC Pipe; 3" Schedule 40 PVC Pipe 18" height; mm height; Piece; Deburring tool, Sand Paper; https://www.y outube.com/ watch?v=2U 1sdMwJ1gE &list=PL4O1 RQEiLpHBJ0 i1zqe- CZk1p_NTtG l76&index=2

## Page 14 of 39

16

## Wash the inside portion of the PVC and let it

dry.

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

Piece

PVC 75mm Round Snap-In Floor Drain | Piece

Piece

Piece PVC Reducer Busing Flush Style

3" x 3/4" Sch 40 PVC Reducer Bushing Flush Style - Spig x Fipt

75mm x 20mm Sch 40 (Series 1000) PVC Reducer Bushing Flush Style - Spig xFipt

Piece

## https://www.y outube.com/ watch?v=2U 1sdMwJ1gE &list=PL4O1 RQEiLpHBJ0 i1zqe-CZk1p_NTtG l76&index=2

Name | Description | Metric Conversion | Unit of

### 7 mm Schedule 40 (Series 1000) PVC Pipe 431

Step Process | Material | Tools Youtube link

## Page 15 of 39

18

### Put glue on the PVC Male adapter Socket and the Sieve PVC Pipe

(open side).

### Put a large amount of glue on the outside portion of the Male end around

50mm

### (Sieve PVC Pipe) and less on the inside of the female end (PVC Male adapter socket). the female end (PVC Male adapter

socket).

Name | Description | Metric Conversion | Unit of Measure
Stainless Steel Woven Wire | 304 Stainless Steel Woven Wire 80 Mesh 0.18mm Hole | 304 Stainless Steel Woven Wire 80 Mesh 0.18mm Hole
PVC Drain Cover | PVC 3 in. Round Snap-In Floor Drain
PVC Coupling Socket | 3" Sch 40 PVC Coupling - Socket | 75mm Sch 40 (Series 1000) PVC Coupling - Socket
Sieve PVC Pipe | 3" Schedule 40 PVC Pipe 18" height | 7 mm Schedule 40 (Series 1000) PVC Pipe 431 mm height
PVC Reducer Busing Flush Style | 3" x 3/4" Sch 40 PVC Reducer Bushing Flush Style - Spig x Fipt | 75mm x 20mm Sch 40 (Series 1000) PVC Reducer Bushing Flush Style - Spig x Fipt
PVC Male Adapter Socket | 3" Schedule 40 PVC Male Adapter - MIPT x Socket | 75mm Schedule 40 PVC Male Adapter - MIPT x Socket
PVC Glue | Gorilla PVC Cement 8 oz. R1584C Medium Body PrimaGlue, One-Step | Gorilla PVC Cement 230ml R1584C Medium Body PrimaGlue, One-Step

Piece

PVC 75mm Round Snap-In Floor Drain Piece

Piece

Piece

Piece

Piece

Ounce

## https://ww w.youtub e.com/wa tch?v=2U 1sdMwJ1 gE&list=P L4O1RQ EiLpHBJ0 i1zqe-CZk1p_N TtGl76&in dex=2

Step Process | Material | Tools Youtube link

## Page 16 of 39

19

## Place the PVC Male Adapter Socket on top of the Sieve

PVC Pipe.

## Put a little bit of pressure to connect

the parts.

Name | Description | Metric Conversion | Unit of Measure
Stainless Steel Woven Wire | 304 Stainless Steel Woven Wire 80 Mesh 0.18mm Hole | 304 Stainless Steel Woven Wire 80 Mesh 0.18mm Hole
PVC Drain Cover | PVC 3 in. Round Snap-In Floor Drain
PVC Coupling Socket | 3" Sch 40 PVC Coupling -Socket | 75mm Sch 40 (Series 1000) PVC Coupling - Socket
Sieve PVC Pipe | 3" Schedule 40 PVC Pipe 18" height | 7 mm Schedule 40 (Series 1000) PVC Pipe 431 mm height
PVC Reducer Busing Flush Style | 3" x 3/4" Sch 40 PVC Reducer Bushing Flush Style - Spig x Fipt | 75mm x 20mm Sch 40 (Series 1000) PVC Reducer Bushing Flush Style - Spig x Fipt
PVC Male Adapter Socket | 3" Schedule 40 PVC Male Adapter - MIPT x Socket | 75mm Schedule 40 PVC Male Adapter - MIPT x Socket

Piece

PVC 75mm Round Snap-In Floor Drain | Piece

Piece

Piece

Piece

Piece

## https://ww

w.youtube.

## com/watch ?v=2U1sd MwJ1gE&l ist=PL4O1 RQEiLpHB J0i1zqe-CZk1p_NT tGl76&ind

ex=2

Step Process | Material | Tools Youtube link

## Page 17 of 39

20

## Wipe any excess glue on the PVC

Name | Description | Metric Conversion | Unit of Measure
Stainless Steel Woven Wire | 304 Stainless Steel Woven Wire 80 Mesh 0.18mm Hole | 304 Stainless Steel Woven Wire 80 Mesh 0.18mm Hole
PVC Drain Cover | PVC 3 in. Round Snap-In Floor Drain
PVC Coupling Socket | 3" Sch 40 PVC Coupling -Socket | 75mm Sch 40 (Series 1000) PVC Coupling - Socket
Sieve PVC Pipe | 3" Schedule 40 PVC Pipe 18" height | 7 mm Schedule 40 (Series 1000) PVC Pipe 431 mm height
PVC Reducer Busing Flush Style | 3" x 3/4" Sch 40 PVC Reducer Bushing Flush Style - Spig x Fipt | 75mm x 20mm Sch 40 (Series 1000) PVC Reducer Bushing Flush Style - Spig x Fipt
PVC Male Adapter Socket | 3" Schedule 40 PVC Male Adapter - MIPT x Socket | 75mm Schedule 40 PVC Male Adapter - MIPT x Socket

Piece

PVC 75mm Round Snap-In Floor Drain | Piece

Piece

Piece

Piece

Piece

Towel/Tissue | Towel/Tissue | Towel/Tissue | roll

## https://www .youtube.co m/watch?v =2U1sdMw J1gE&list= PL4O1RQ EiLpHBJ0i 1zqe-CZk1p_NTt Gl76&index

=2

Step Process | Material | Tools Youtube link

## Page 18 of 39

### 21 Let it dry

overnight

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

Piece

PVC 75mm Round Snap-In Floor Drain | Piece

Piece

Piece

Piece

Piece

## https://www .youtube.co m/watch?v =2U1sdMw J1gE&list= PL4O1RQ EiLpHBJ0i 1zqe-CZk1p_NTt Gl76&index

=2

Step Process | Material | Tools Youtube link

## Page 19 of 39

22

Put glue on
another piece
of PVC
Reducer
Bushing Flush
Style and the
PVC Female
Adapter
Socket. Put a
large amount
of glue on the
outside portion
of the Male
end around
50mm (PVC
Reducer
Bushing Flush
Style) and less
on the inside
of the female
end (PVC
Female
Adapter
Socket).
inside of the
female end
(PVC
Female
Adapter
Socket).
Name | Description | Metric Conversion | Unit of Measure
PVC Reducer Busing Flush Style | 3" x 3/4" Sch 40 PVC Reducer Bushing Flush Style - Spig x Fipt | 75mm x 20mm Sch 40 (Series 1000) PVC Reducer Bushing Flush Style - Spig x Fipt
PVC Female Adapter Socket | 3" Schedule 40 PVC Female Adapter - Socket x FIPT | 75mm Schedule 40 (Series 1000) PVC Female Adapter - Socket x FIPT
PVC Glue | Gorilla PVC Cement 8 oz. R1584C Medium Body PrimaGlue, One-Step | Gorilla PVC Cement 230ml R1584C Medium Body PrimaGlue, One-Step

Piece

Piece

Ounce

## https://ww

w.youtube.

## com/watch ?v=2U1sd MwJ1gE&li st=PL4O1 RQEiLpHB J0i1zqe-CZk1p_NT tGl76&inde

x=2

Step Process | Material | Tools Youtube link

## Page 20 of 39

23

### Place the PVC Reducer Bushing Flush Style on top of the PVC Female Adapter Socket. Put a little bit of pressure to connect the

parts.

Name | Description | Metric Conversion | Unit of Measure
PVC Reducer Busing Flush Style | 3" x 3/4" Sch 40 PVC Reducer Bushing Flush Style - Spig x Fipt | 75mm x 20mm Sch 40 (Series 1000) PVC Reducer Bushing Flush Style - Spig x Fipt
PVC Female Adapter Socket | 3" Schedule 40 PVC Female Adapter - Socket x FIPT | 75mm Schedule 40 (Series 1000) PVC Female Adapter - Socket x FIPT

Piece

Piece

## https://www.y outube.com/ watch?v=2U 1sdMwJ1gE &list=PL4O1 RQEiLpHBJ0 i1zqe-CZk1p_NTtG l76&index=2

24

Let it dry
overnight
Name | Description | Metric Conversion | Unit of Measure
PVC Reducer Busing Flush Style | 3" x 3/4" Sch 40 PVC Reducer Bushing Flush Style - Spig x Fipt | 75mm x 20mm Sch 40 (Series 1000) PVC Reducer Bushing Flush Style - Spig x Fipt
PVC Female Adapter Socket | 3" Schedule 40 PVC Female Adapter - Socket x FIPT | 75mm Schedule 40 (Series 1000) PVC Female Adapter - Socket x FIPT

Piece

Piece

## https://www.y outube.com/ watch?v=2U 1sdMwJ1gE &list=PL4O1 RQEiLpHBJ0 i1zqe-CZk1p_NTtG l76&index=2

Step Process | Material | Tools Youtube link

## Page 21 of 39

25

## Assemble the top portion of the Sieve to identify the Distance of the PVC Drain Cover and the PVC Female

Adapter.

## Place the Drain cover Tube inside the PVC Female Adapter Socket

Name | Description | Metric Conversion | Unit of Measure
PVC Female Adapter Socket | 3" Schedule 40 PVC Female Adapter - Socket x FIPT | 75mm Schedule 40 (Series 1000) PVC Female Adapter - Socket x FIPT | Piece
Drain Cover Tube | 0.6"long PVC Round Snap in Floor Drain | 14 1/2 mm long PVC Round Snap in Floor Drain | Piece

## https://ww w.youtube .com/watc h?v=kibjk u2GYq0&l ist=PL4O 1RQEiLp HBJ0i1zq

e-

## CZk1p_N TtGl76&in dex=3

Step Process | Material | Tools Youtube link

## Page 22 of 39

26

## Place the PVC Drain Cover -Trimmed on top of the Drain Cover Tube

Name | Description | Metric Conversion | Unit of Measure
PVC Female Adapter Socket | 3" Schedule 40 PVC Female Adapter - Socket x FIPT | 75mm Schedule 40 (Series 1000) PVC Female Adapter - Socket x FIPT
Drain Cover Tube | 0.6"long PVC Round Snap in Floor Drain | 14 1/2 mm long PVC Round Snap in Floor Drain
PVC Drain Cover - Trimmed with Wire | 3" Round Snap-In Floor Drain - Trimmed with Stainless Steel Woven Wire | PVC 75mm Round Snap-In Floor Drain --Trimmed with Stainless Steel Woven Wire

Piece

Piece

Piece

## https://ww w.youtube .com/watc h?v=kibjk u2GYq0&l ist=PL4O 1RQEiLp HBJ0i1zq

e-

## CZk1p_N TtGl76&in dex=3

Step Process | Material | Tools Youtube link

## Page 23 of 39

27

Compute for
the level of
the Zeolite. a)
Measure the
gap between
from the top
of the PVC
Drain Cover
Trimmed from
step 26 vs the
top portion of
the PVC
Female
Adapter
Socket is
7mm; b)
estimate gap
of the PVC
Female
Adapter vs
Male Adapter
is 5mm; c)
add a and b
a(7)+b(5)=
12mm; d)
Measure the
threaded
portion of the
PVC Male
Adapter
(38mm); e).
d(38)- c(12) =
26mm
Name | Description | Metric Conversion | Unit of Measure
PVC Drain Cover - Trimmed with Wire | 3" Round Snap-In Floor Drain -Trimmed with Stainless Steel Woven Wire | PVC 75mm Round Snap-In Floor Drain --Trimmed with Stainless Steel Woven Wire
PVC Male Adapter Socket | 3" Schedule 40 PVC Male Adapter - MIPT x Socket | 75mm Schedule 40 PVC Male Adapter - MIPT x Socket
PVC Female Adapter Socket | 3" Schedule 40 PVC Female Adapter - Socket x FIPT | 75mm Schedule 40 (Series 1000) PVC Female Adapter - Socket x FIPT

Piece

Piece

Piece

Caliper https://w ww.youtu be.com/ watch?v =kibjku2 GYq0&lis t=PL4O1 RQEiLp HBJ0i1z qe- CZk1p_ NTtGl76 &index=3

Step Process | Material | Tools Youtube link

## Page 24 of 39

28

## Measure

26mm

## from the top of the PVC Male Adaptor Socket for the Zeolite Height

Name | Description | Metric Conversion | Unit of Measure
PVC Coupling Socket | 3" Sch 40 PVC Coupling -Socket | 75mm Sch 40 (Series 1000) PVC Coupling - Socket
Sieve PVC Pipe | 3" Schedule 40 PVC Pipe 18" height | 7 mm Schedule 40 (Series 1000) PVC Pipe 431 mm height
PVC Reducer Busing Flush Style | 3" x 3/4" Sch 40 PVC Reducer Bushing Flush Style - Spig x Fipt | 75mm x 20mm Sch 40 (Series 1000) PVC Reducer Bushing Flush Style - Spig x Fipt
PVC Male Adapter Socket | 3" Schedule 40 PVC Male Adapter - MIPT x Socket | 75mm Schedule 40 PVC Male Adapter - MIPT x Socket
Stainless Steel Woven Wire | 304 Stainless Steel Woven Wire 80 Mesh 0.18mm Hole | 304 Stainless Steel Woven Wire 80 Mesh 0.18mm Hole
PVC Drain Cover | PVC 3 in. Round Snap-In Floor Drain

Piece

Piece

Piece

Piece

Piece

PVC 75mm Round Snap-In Floor Drain | Piece
Caliper | https://w ww.youtu be.com/ watch?v =kibjku2 GYq0&lis t=PL4O1 RQEiLp HBJ0i1z qe- CZk1p_ NTtGl76 &index=3

Step Process | Material | Tools Youtube link

## Page 25 of 39

29

## Label the

26mm

## on the PVC Male Adapter Socket

Name | Description | Metric Conversion | Unit of Measure
PVC Coupling Socket | 3" Sch 40 PVC Coupling -Socket | 75mm Sch 40 (Series 1000) PVC Coupling - Socket
Sieve PVC Pipe | 3" Schedule 40 PVC Pipe 18" height | 7 mm Schedule 40 (Series 1000) PVC Pipe 431 mm height
PVC Reducer Busing Flush Style | 3" x 3/4" Sch 40 PVC Reducer Bushing Flush Style - Spig x Fipt | 75mm x 20mm Sch 40 (Series 1000) PVC Reducer Bushing Flush Style - Spig x Fipt
PVC Male Adapter Socket | 3" Schedule 40 PVC Male Adapter - MIPT x Socket | 75mm Schedule 40 PVC Male Adapter - MIPT x Socket
PVC Drain Cover | PVC 3 in. Round Snap-In Floor Drain
Stainless Steel Woven Wire | 304 Stainless Steel Woven Wire 80 Mesh 0.18mm Hole | 304 Stainless Steel Woven Wire 80 Mesh 0.18mm Hole

Piece

Piece

Piece

Piece

PVC 75mm Round Snap-In Floor Drain | Piece

Piece

Caliper https://w ww.youtu be.com/ watch?v =kibjku2 GYq0&lis t=PL4O1 RQEiLp HBJ0i1z qe- CZk1p_ NTtGl76 &index=3

Step Process | Material | Tools Youtube link

## Page 26 of 39

30

## Remove the PVC Drain Cover -Trimmed and the PVC Drain Cover Tube from the Female Adapter Socket from Step 25 and

26

Name | Description | Metric Conversion | Unit of Measure
PVC Female Adapter Socket | 3" Schedule 40 PVC Female Adapter - Socket x FIPT | 75mm Schedule 40 (Series 1000) PVC Female Adapter - Socket x FIPT
PVC Drain Cover - Trimmed with Wire | 3" Round Snap-In Floor Drain -Trimmed with Stainless Steel Woven Wire | PVC 75mm Round Snap-In Floor Drain --Trimmed with Stainless Steel Woven Wire
Drain Cover Tube | 0.6"long PVC Round Snap in Floor Drain | 14 1/2 mm long PVC Round Snap in Floor Drain

Piece

Piece

Piece

## https://w ww.youtu be.com/ watch?v =kibjku2 GYq0&lis t=PL4O1 RQEiLp HBJ0i1z

qe-

## CZk1p_ NTtGl76 &index=3

Step Process | Material | Tools Youtube link

## Page 27 of 39

31

## Place the Zeolite inside the Sieve PVC Pipe until it reaches the 26mm level

Name | Description | Metric Conversion | Unit of Measure
PVC Coupling Socket | 3" Sch 40 PVC Coupling -Socket | 75mm Sch 40 (Series 1000) PVC Coupling - Socket
Sieve PVC Pipe | 3" Schedule 40 PVC Pipe 18" height | 7 mm Schedule 40 (Series 1000) PVC Pipe 431 mm height
PVC Reducer Busing Flush Style | 3" x 3/4" Sch 40 PVC Reducer Bushing Flush Style - Spig x Fipt | 75mm x 20mm Sch 40 (Series 1000) PVC Reducer Bushing Flush Style - Spig x Fipt
PVC Male Adapter Socket | 3" Schedule 40 PVC Male Adapter - MIPT x Socket | 75mm Schedule 40 PVC Male Adapter - MIPT x Socket
Zeolite | Zeolite | Zeolite
Stainless Steel Woven Wire | 304 Stainless Steel Woven Wire 80 Mesh 0.18mm Hole | 304 Stainless Steel Woven Wire 80 Mesh 0.18mm Hole
PVC Drain Cover | PVC 3 in. Round Snap-In Floor Drain

Piece

Piece

Piece

Piece

Piece

PVC 75mm Round Snap-In Floor Drain | Piece

Funnel,
Caliper,

## Cup for the Zeolite

## https://w ww.youtu be.com/ watch?v =kibjku2 GYq0&lis t=PL4O1 RQEiLp HBJ0i1z

qe-

## CZk1p_ NTtGl76 &index=3

Step Process | Material | Tools Youtube link

## Page 28 of 39

32

### Vibrate the bottom and top side of the PVC Pipe and add appropriat e amount of Zeolite until it reach the

26mm

### level

Name | Description | Metric Conversion | Unit of Measure
PVC Coupling Socket | 3" Sch 40 PVC Coupling -Socket | 75mm Sch 40 (Series 1000) PVC Coupling - Socket
Sieve PVC Pipe | 3" Schedule 40 PVC Pipe 18" height | 7 mm Schedule 40 (Series 1000) PVC Pipe 431 mm height
PVC Reducer Busing Flush Style | 3" x 3/4" Sch 40 PVC Reducer Bushing Flush Style - Spig x Fipt | 75mm x 20mm Sch 40 (Series 1000) PVC Reducer Bushing Flush Style - Spig x Fipt
PVC Male Adapter Socket | 3" Schedule 40 PVC Male Adapter - MIPT x Socket | 75mm Schedule 40 PVC Male Adapter - MIPT x Socket
Zeolite | Zeolite | Zeolite
Stainless Steel Woven Wire | 304 Stainless Steel Woven Wire 80 Mesh 0.18mm Hole | 304 Stainless Steel Woven Wire 80 Mesh 0.18mm Hole
PVC Drain Cover | PVC 3 in. Round Snap-In Floor Drain

Piece

Piece

Piece

Piece

Piece

PVC 75mm Round Snap-In Floor Drain | Piece

## Air Hammer

## https://w ww.youtu be.com/ watch?v =kibjku2 GYq0&lis t=PL4O1 RQEiLp HBJ0i1z

qe-

## CZk1p_ NTtGl76 &index=3

Step Process | Material | Tools Youtube link

## Page 29 of 39

33

## Place the Non Woven Fiber Filter on top of the Zeolite

Name | Description | Metric Conversion | Unit of Measure
PVC Coupling Socket | 3" Sch 40 PVC Coupling -Socket | 75mm Sch 40 (Series 1000) PVC Coupling - Socket
Sieve PVC Pipe | 3" Schedule 40 PVC Pipe 18" height | 7 mm Schedule 40 (Series 1000) PVC Pipe 431 mm height
PVC Reducer Busing Flush Style | 3" x 3/4" Sch 40 PVC Reducer Bushing Flush Style - Spig x Fipt | 75mm x 20mm Sch 40 (Series 1000) PVC Reducer Bushing Flush Style - Spig x Fipt
PVC Male Adapter Socket | 3" Schedule 40 PVC Male Adapter - MIPT x Socket | 75mm Schedule 40 PVC Male Adapter - MIPT x Socket
Zeolite | Zeolite | Zeolite
Non Woven Fiber Filter | 4" Diameter Non Woven Fiber Filter
PVC Drain Cover | PVC 3 in. Round Snap-In Floor Drain
Stainless Steel Woven Wire | 304 Stainless Steel Woven Wire 80 Mesh 0.18mm Hole | 304 Stainless Steel Woven Wire 80 Mesh 0.18mm Hole

Piece

Piece

Piece

Piece

101 mm Diameter Non Woven Fiber Filter | Piece
PVC 75mm Round Snap-In Floor Drain | Piece

Piece

## https://w ww.youtu be.com/ watch?v =kibjku2 GYq0&lis t=PL4O1 RQEiLp HBJ0i1z

qe-

## CZk1p_ NTtGl76 &index=3

Step Process | Material | Tools Youtube link

## Page 30 of 39

34

## Place the PVC Drain Cover -Trimmed (inverted position) on top of the Non woven Fiber

Filter.

Name | Description | Metric Conversion | Unit of Measure
PVC Coupling Socket | 3" Sch 40 PVC Coupling - Socket | 75mm Sch 40 (Series 1000) PVC Coupling - Socket
Sieve PVC Pipe | 3" Schedule 40 PVC Pipe 18" height | 7 mm Schedule 40 (Series 1000) PVC Pipe 431 mm height
PVC Reducer Busing Flush Style | 3" x 3/4" Sch 40 PVC Reducer Bushing Flush Style - Spig x Fipt | 75mm x 20mm Sch 40 (Series 1000) PVC Reducer Bushing Flush Style -Spig x Fipt
PVC Male Adapter Socket | 3" Schedule 40 PVC Male Adapter - MIPT x Socket | 75mm Schedule 40 PVC Male Adapter - MIPT x Socket
Zeolite | Zeolite | Zeolite
Non Woven Fiber Filter | 4" Diameter Non Woven Fiber Filter
PVC Drain Cover - Trimmed with Wire | 3" Round Snap-In Floor Drain -Trimmed with Stainless Steel Woven Wire | PVC 75mm Round Snap-In Floor Drain --Trimmed with Stainless Steel Woven Wire
Stainless Steel Woven Wire | 304 Stainless Steel Woven Wire 80 Mesh 0.18mm Hole | 304 Stainless Steel Woven Wire 80 Mesh 0.18mm Hole
PVC Drain Cover | PVC 3 in. Round Snap-In Floor Drain

Piece

Piece

Piece

Piece

101 mm Diameter Non Woven Fiber Filter Piece

Piece

Piece

PVC 75mm Round Snap-In Floor Drain Piece

## https://w ww.youtu be.com/ watch?v =kibjku2 GYq0&lis t=PL4O1 RQEiLp HBJ0i1z

qe-

## CZk1p_ NTtGl76 &index=3

Step Process | Material | Tools Youtube link

## Page 31 of 39

35

## Push the PVC Drain Cover -Trimmed

to

## compress the

Zeolite.

Name | Description | Metric Conversion | Unit of Measure
PVC Coupling Socket | 3" Sch 40 PVC Coupling - Socket | 75mm Sch 40 (Series 1000) PVC Coupling - Socket
Sieve PVC Pipe | 3" Schedule 40 PVC Pipe 18" height | 7 mm Schedule 40 (Series 1000) PVC Pipe 431 mm height
PVC Reducer Busing Flush Style | 3" x 3/4" Sch 40 PVC Reducer Bushing Flush Style - Spig x Fipt | 75mm x 20mm Sch 40 (Series 1000) PVC Reducer Bushing Flush Style -Spig x Fipt
PVC Male Adapter Socket | 3" Schedule 40 PVC Male Adapter - MIPT x Socket | 75mm Schedule 40 PVC Male Adapter - MIPT x Socket
Zeolite | Zeolite | Zeolite
Non Woven Fiber Filter | 4" Diameter Non Woven Fiber Filter
PVC Drain Cover - Trimmed with Wire | 3" Round Snap-In Floor Drain -Trimmed with Stainless Steel Woven Wire | PVC 75mm Round Snap-In Floor Drain --Trimmed with Stainless Steel Woven Wire
PVC Drain Cover | PVC 3 in. Round Snap-In Floor Drain
Stainless Steel Woven Wire | 304 Stainless Steel Woven Wire 80 Mesh 0.18mm Hole | 304 Stainless Steel Woven Wire 80 Mesh 0.18mm Hole

Piece

Piece

Piece

Piece

101 mm Diameter Non Woven Fiber Filter Piece

Piece

PVC 75mm Round Snap-In Floor Drain Piece

Piece

## https://w ww.youtu be.com/ watch?v =kibjku2 GYq0&lis t=PL4O1 RQEiLp HBJ0i1z

qe-

## CZk1p_ NTtGl76 &index=3

Step Process | Material | Tools Youtube link

## Page 32 of 39

36

## Place the spring on top of the PVC Drain Cover -Trimmed

Name | Description | Metric Conversion | Unit of Measure
PVC Coupling Socket | 3" Sch 40 PVC Coupling - Socket | 75mm Sch 40 (Series 1000) PVC Coupling - Socket
Sieve PVC Pipe | 3" Schedule 40 PVC Pipe 18" height | 7 mm Schedule 40 (Series 1000) PVC Pipe 431 mm height
PVC Reducer Busing Flush Style | 3" x 3/4" Sch 40 PVC Reducer Bushing Flush Style - Spig x Fipt | 75mm x 20mm Sch 40 (Series 1000) PVC Reducer Bushing Flush Style -Spig x Fipt
PVC Male Adapter Socket | 3" Schedule 40 PVC Male Adapter - MIPT x Socket | 75mm Schedule 40 PVC Male Adapter - MIPT x Socket
Zeolite | Zeolite | Zeolite
Non Woven Fiber Filter | 4" Diameter Non Woven Fiber Filter
Spring | 2" Diameter x 3" Tall - Springs C200-M10-S17 | 50mm Diameter x 75mm Tall -Springs C200-M10-S17
PVC Drain Cover - Trimmed with Wire | 3" Round Snap-In Floor Drain -Trimmed with Stainless Steel Woven Wire | PVC 75mm Round Snap-In Floor Drain --Trimmed with Stainless Steel Woven Wire
PVC Drain Cover | PVC 3 in. Round Snap-In Floor Drain
Stainless Steel Woven Wire | 304 Stainless Steel Woven Wire 80 Mesh 0.18mm Hole | 304 Stainless Steel Woven Wire 80 Mesh 0.18mm Hole

Piece

Piece

Piece

Piece

101 mm Diameter Non Woven Fiber Filter Piece

Piece

Piece

PVC 75mm Round Snap-In Floor Drain Piece

Piece

## https://w ww.youtu be.com/ watch?v =kibjku2 GYq0&lis t=PL4O1 RQEiLp HBJ0i1z

qe-

## CZk1p_ NTtGl76 &index=3

Step Process | Material | Tools Youtube link

## Page 33 of 39

37

## Insert the PVC Spacer into the Drain Cover

Tube.

## Ensure Drain Cover Tube covers the lip side of the PVC Spacer

Name | Description | Metric Conversion | Unit of Measure
PVC Spacer | 3/4" x 2" spigot threaded MPT PVC(spacer) | 20mm x 45mm Spigot Threaded MPT PVC (Spacer)
Drain Cover Tube | 0.6"long PVC Round Snap in Floor Drain | 14 1/2 mm long PVC Round Snap in Floor Drain

Piece

Piece

## https://w ww.youtu be.com/ watch?v =kibjku2 GYq0&lis t=PL4O1 RQEiLp HBJ0i1z

qe-

## CZk1p_ NTtGl76 &index=3

Step Process | Material | Tools Youtube link

## Page 34 of 39

38

## Place the PVC Spacer with the Drain Cover Tube on top of the Spring

Name | Description | Metric Conversion | Unit of Measure
PVC Coupling Socket | 3" Sch 40 PVC Coupling - Socket | 75mm Sch 40 (Series 1000) PVC Coupling - Socket
Sieve PVC Pipe | 3" Schedule 40 PVC Pipe 18" height | 7 mm Schedule 40 (Series 1000) PVC Pipe 431 mm height
PVC Reducer Busing Flush Style | 3" x 3/4" Sch 40 PVC Reducer Bushing Flush Style - Spig x Fipt | 75mm x 20mm Sch 40 (Series 1000) PVC Reducer Bushing Flush Style -Spig x Fipt
PVC Male Adapter Socket | 3" Schedule 40 PVC Male Adapter - MIPT x Socket | 75mm Schedule 40 PVC Male Adapter - MIPT x Socket
Zeolite | Zeolite | Zeolite
Non Woven Fiber Filter | 4" Diameter Non Woven Fiber Filter
Spring | 2" Diameter x 3" Tall - Springs C200-M10-S17 | 50mm Diameter x 75mm Tall -Springs C200-M10-S17
PVC Drain Cover - Trimmed with Wire | 3" Round Snap-In Floor Drain -Trimmed with Stainless Steel Woven Wire | PVC 75mm Round Snap-In Floor Drain --Trimmed with Stainless Steel Woven Wire
PVC Spacer | 3/4" x 2" spigot threaded MPT PVC(spacer) | 20mm x 45mm Spigot Threaded MPT PVC (Spacer)
Drain Cover Tube | 0.6"long PVC Round Snap in Floor Drain | 14 1/2 mm long PVC Round Snap in Floor Drain
PVC Drain Cover | PVC 3 in. Round Snap-In Floor Drain
Stainless Steel Woven Wire | 304 Stainless Steel Woven Wire 80 Mesh 0.18mm Hole | 304 Stainless Steel Woven Wire 80 Mesh 0.18mm Hole

Piece

Piece

Piece

Piece

101 mm Diameter Non Woven Fiber Filter Piece

Piece

Piece

Piece

Piece

PVC 75mm Round Snap-In Floor Drain Piece

Piece

## https://w ww.youtu be.com/ watch?v =kibjku2 GYq0&lis t=PL4O1 RQEiLp HBJ0i1z

qe-

## CZk1p_ NTtGl76 &index=3

Step Process | Material | Tools Youtube link

## Page 35 of 39

39

Name | Description | Metric Conversion | Unit of Measure
PVC Coupling Socket | 3" Sch 40 PVC Coupling - Socket | 75mm Sch 40 (Series 1000) PVC Coupling - Socket | Piece
Sieve PVC Pipe | 3" Schedule 40 PVC Pipe 18" height

### 7 mm Schedule 40 (Series 1000)

PVC Pipe 431 mm height

Piece

PVC Reducer
Busing Flush
Style

3" x 3/4" Sch 40 PVC Reducer Bushing Flush Style - Spig x Fipt

75mm x 20mm Sch 40 (Series 1000) PVC Reducer Bushing Flush Style -Spig x Fipt

Piece

PVC Male
Adapter Socket

3" Schedule 40 PVC Male Adapter
- MIPT x Socket

75mm Schedule 40 PVC Male Adapter
- MIPT x Socket

Piece

Zeolite | Zeolite | Zeolite
Non Woven Fiber Filter | 4" Diameter Non Woven Fiber Filter
101 mm Diameter Non Woven Fiber Filter | Piece
Spring | 2" Diameter x 3" Tall - Springs C200-M10-S17

50mm Diameter x 75mm Tall -
Springs C200-M10-S17

Piece

PVC Drain Cover
- Trimmed with
Wire

3" Round Snap-In Floor Drain -Trimmed with Stainless Steel Woven Wire

PVC 75mm Round Snap-In Floor Drain --Trimmed with Stainless Steel
Woven Wire

Piece

PVC Spacer | 3/4" x 2" spigot threaded MPT PVC(spacer)

20mm x 45mm Spigot Threaded MPT PVC (Spacer)

Piece

Drain Cover Tube 0.6"long PVC Round Snap in Floor Drain

14 1/2 mm long PVC Round Snap in Floor Drain

Piece

PVC Female
Adapter Socket

3" Schedule 40 PVC Female
Adapter - Socket x FIPT

75mm Schedule 40 (Series 1000) PVC Female Adapter - Socket x FIPT

Piece

PVC Pipe Sealant | No. 5 Pipe Thread Sealant Sealant | No. 5 Pipe Thread Sealant Sealant | ml
PVC Drain Cover | PVC 3 in. Round Snap-In Floor Drain | PVC 75mm Round Snap-In Floor Drain | Piece

## Put PVC Glue on the PVC Male Adaptor Socket and on the PVC Female Adaptor Socket with the PVC Reducer Bushing Flush Style

https://www.

## youtube.com /watch?v=ki bjku2GYq0& list=PL4O1R QEiLpHBJ0i 1zqe-CZk1p_NTt Gl76&index=

3

Step Process | Material | Tools Youtube link

## Page 36 of 39

40

## Place the PVC Female Adaptor Socket with the PVC Reducer Flush Style on top of the PVC Male Adaptor

Socket.

Name | Description | Metric Conversion | Unit of Measure
PVC Drain Cover | PVC 3 in. Round Snap-In Floor Drain | PVC 75mm Round Snap-In Floor Drain | Piece

PVC Coupling
Socket

3" Sch 40 PVC Coupling - Socket 75mm Sch 40 (Series 1000) PVC Coupling - Socket

Piece

Sieve PVC Pipe 3" Schedule 40 PVC Pipe 18" height

### 7 mm Schedule 40 (Series 1000)

PVC Pipe 431 mm height

Piece

PVC Reducer
Busing Flush
Style

3" x 3/4" Sch 40 PVC Reducer Bushing Flush Style - Spig x Fipt

75mm x 20mm Sch 40 (Series 1000) PVC Reducer Bushing Flush Style -Spig x Fipt

Piece

PVC Male
Adapter Socket

3" Schedule 40 PVC Male Adapter
- MIPT x Socket

75mm Schedule 40 PVC Male Adapter
- MIPT x Socket

Piece

Zeolite | Zeolite | Zeolite
Non Woven Fiber Filter | 4" Diameter Non Woven Fiber Filter
101 mm Diameter Non Woven Fiber Filter | Piece
Spring | 2" Diameter x 3" Tall - Springs C200-M10-S17

50mm Diameter x 75mm Tall -
Springs C200-M10-S17

Piece

PVC Drain Cover
- Trimmed with
Wire

3" Round Snap-In Floor Drain -Trimmed with Stainless Steel Woven Wire

PVC 75mm Round Snap-In Floor Drain --Trimmed with Stainless Steel
Woven Wire

Piece

PVC Spacer | 3/4" x 2" spigot threaded MPT PVC(spacer)

20mm x 45mm Spigot Threaded MPT PVC (Spacer)

Piece

Drain Cover Tube 0.6"long PVC Round Snap in Floor Drain

14 1/2 mm long PVC Round Snap in Floor Drain

Piece

PVC Female
Adapter Socket

3" Schedule 40 PVC Female
Adapter - Socket x FIPT

75mm Schedule 40 (Series 1000) PVC Female Adapter - Socket x FIPT

Piece

## https://w ww.youtu be.com/ watch?v =kibjku2 GYq0&lis t=PL4O1 RQEiLp HBJ0i1z

qe-

## CZk1p_ NTtGl76 &index=3

Step Process | Material | Tools Youtube link

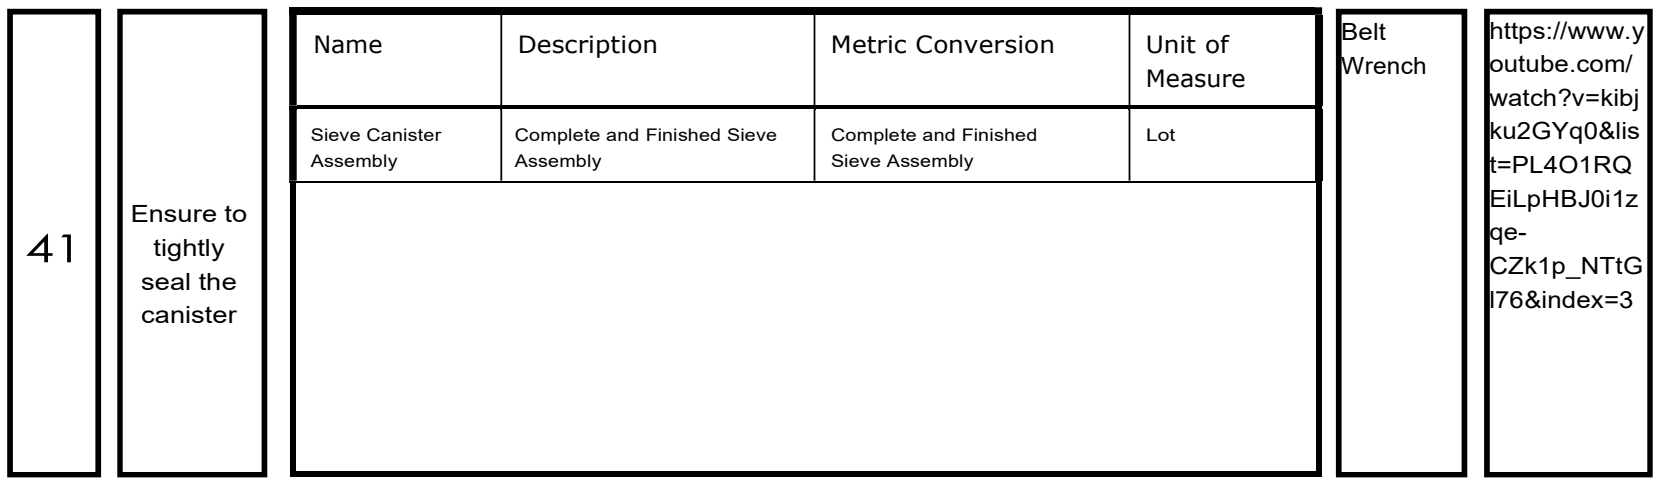
[picture p145: figure]
Ensure to tightly seal the canister; Measure; Sieve Canister Assembly; Complete and Finished Sieve Assembly; Lot; Belt Wrench; https://www.y outube.com/ watch?v=kibj ku2GYq0&lis t=PL4O1RQ EiLpHBJ0i1z qe- CZk1p_NTtG l76&index=3
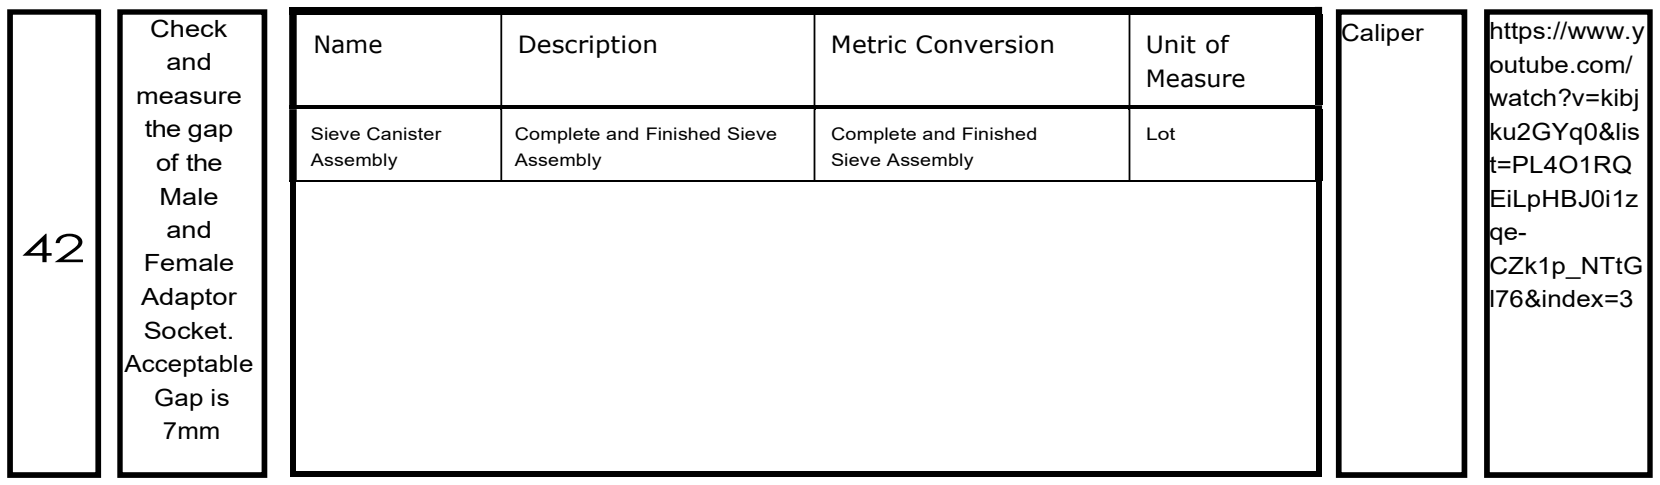
[picture p146: figure]
Check and measure the gap of the Male and Female Adaptor Socket. Acceptable Gap is 7mm; Measure; Sieve Canister Assembly; Complete and Finished Sieve Assembly; Lot; Caliper; https://www.y; outube.com/ watch?v=kibj ku2GYq0&lis t=PL4O1RQ EiLpHBJ0i1z qe- CZk1p_NTtG l76&index=3

## Page 37 of 39

Name | Description | Metric Conversion | Unit of
Name | Description | Metric Conversion | Unit of

Step Process | Material | Tools Youtube link

## Page 38 of 39

43

## Seal the Sieve Canister Tank by placing fittings on each end of the tank

Name | Description | Metric Conversion | Unit of Measure
Sieve Canister Assembly | Complete and Finished Sieve Assembly
PVC Reducer Bushing (T.T) | 3/4" x 3/8" Sch 40 PVC Reducer (T.T.) Bushing - Mipt x Fipt | 20mm x 10mm Sch 40 (Series 1000) PVC Reducer (T.T.) Bushing - Mipt x Fipt
3/8" Male Straight Push-in Connect Fittings | 3/8" Male NPT to 3/8"Push to Connect - Strait | 10mm Male NPT to 10mm Push to Connect - Strait
Complete and Finished Sieve Assembly | Lot

Piece

Piece

## https://www.y outube.com/ watch?v=kibj ku2GYq0&lis t=PL4O1RQ EiLpHBJ0i1z

qe-

## CZk1p_NTtG l76&index=3

### 44 Let it Dry

overnight

Name | Description | Metric Conversion | Unit of Measure
Sieve Canister Assembly | Complete and Finished Sieve Assembly | Complete and Finished Sieve Assembly | Lot

## https://www.y outube.com/ watch?v=kibj ku2GYq0&lis t=PL4O1RQ EiLpHBJ0i1z

qe-

## CZk1p_NTtG l76&index=3

Step | Process | Material | Tools | Youtube Link
