OxiKit/oxygen-concentrator-how-to-diy-open-source/OxiKit DIY Oxygen Concentrator 15 LPM High Flow Design and Schematics.pdf

# Oxygen Concentrator Circuit Diagram Ver. 4A

# (3 port / 2 way valves and Orifices)

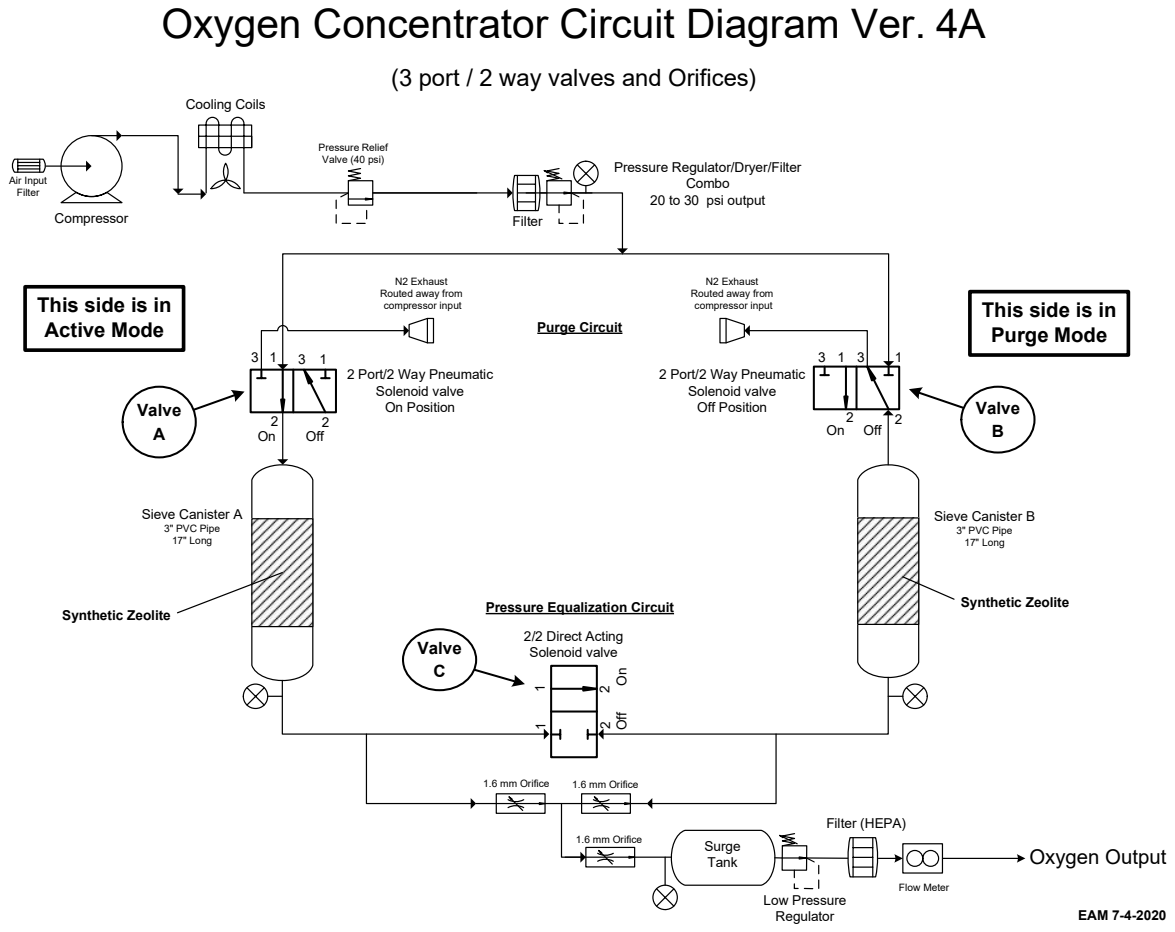
[picture p147: page 1]
Sieve Canister A 3" PVC Pipe 17" Long; Sieve Canister B 3" PVC Pipe 17" Long; Off; Compressor; Cooling Coils; Filter; Surge Tank; Low Pressure Regulator; Filter (HEPA); EAM 7-4-2020; 2/2 Direct Acting Solenoid valve; Purge Circuit; Air Input Filter; Oxygen Output; 1.6 mm Orifice; Flow Meter; Valve A; Valve B; Valve C; 1.6 mm Orifice ¹; 2 Off On; Pressure Relief Valve (40 psi); Synthetic Zeolite

Pressure Regulator/Dryer/Filter

Combo
20 to 30 psi output

N2 Exhaust
Routed away from
compressor input

This side is in
Active Mode

Purge Mode

2 Port/2 Way Pneumatic
Solenoid valve
On Position

Off Position

Pressure Equalization Circuit
