OxiKit/oxygen-concentrator-how-to-diy-open-source/o2analyser_sjk_assembly.pdf

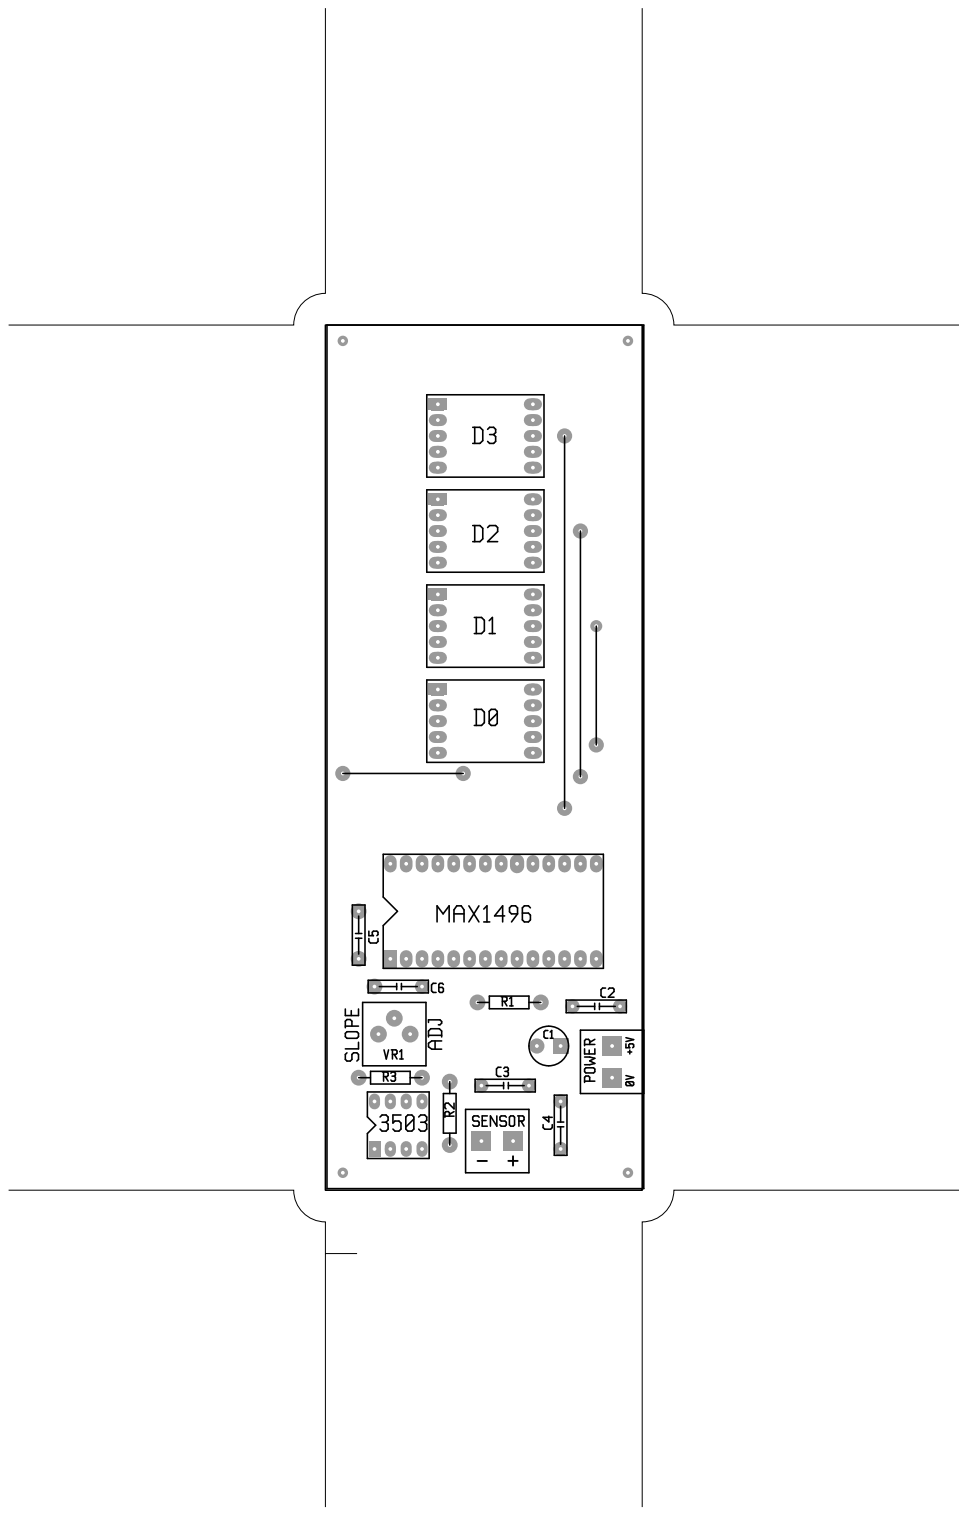
[picture p148: page 1]
