OxiKit/oxygen-concentrator-how-to-diy-open-source/o2analyser_sjk_pcb.pdf

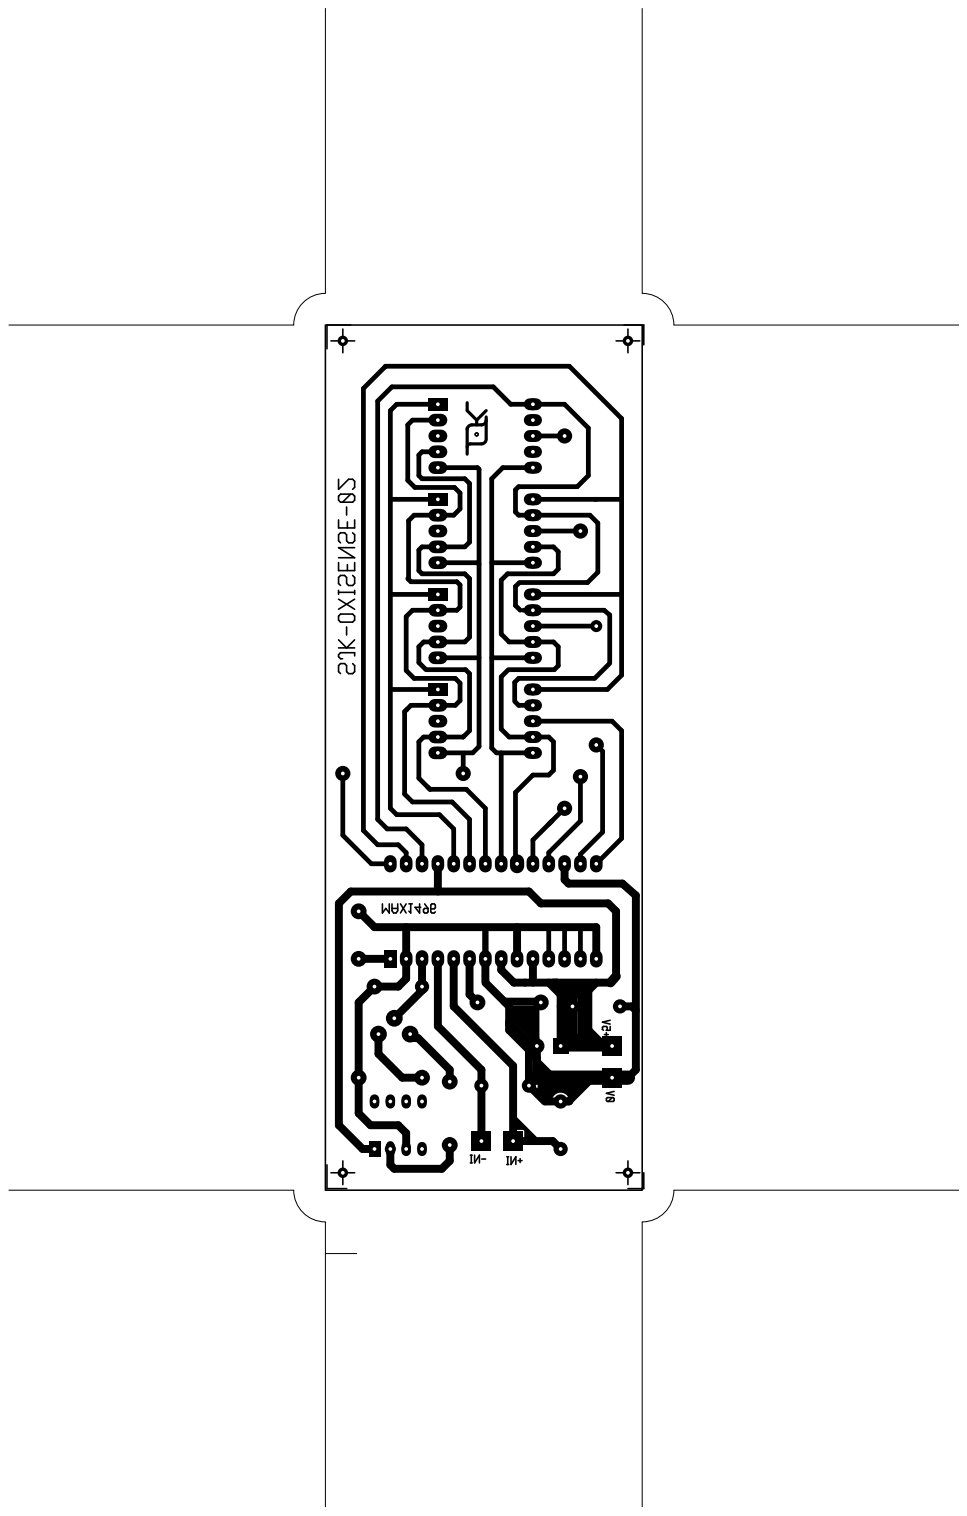
[picture p149: page 1]
